designmaster0928/VESC_MotorController/REFER/Basic/bldc-hardware-master/README.md

VESC – Open Source ESC
=============

This the Hardware for my open source custom ESC.

## Schematic top level
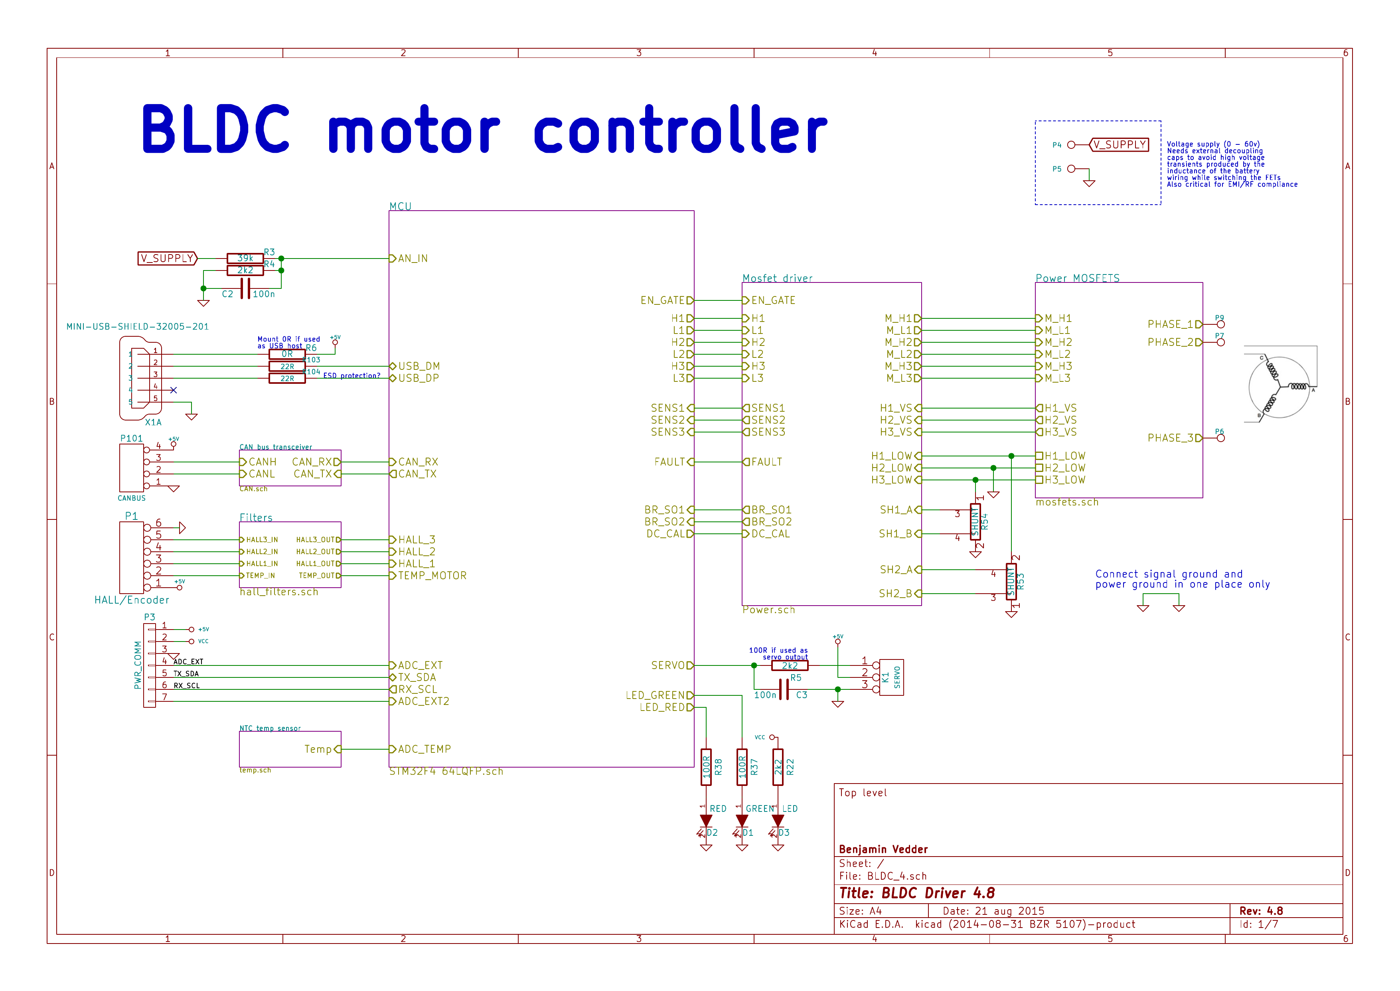
[picture p1: REFER/Basic/bldc-hardware-master/design/PNGs/Schematic-1.png]


## Layout -made with KiCad!-


## 3D views
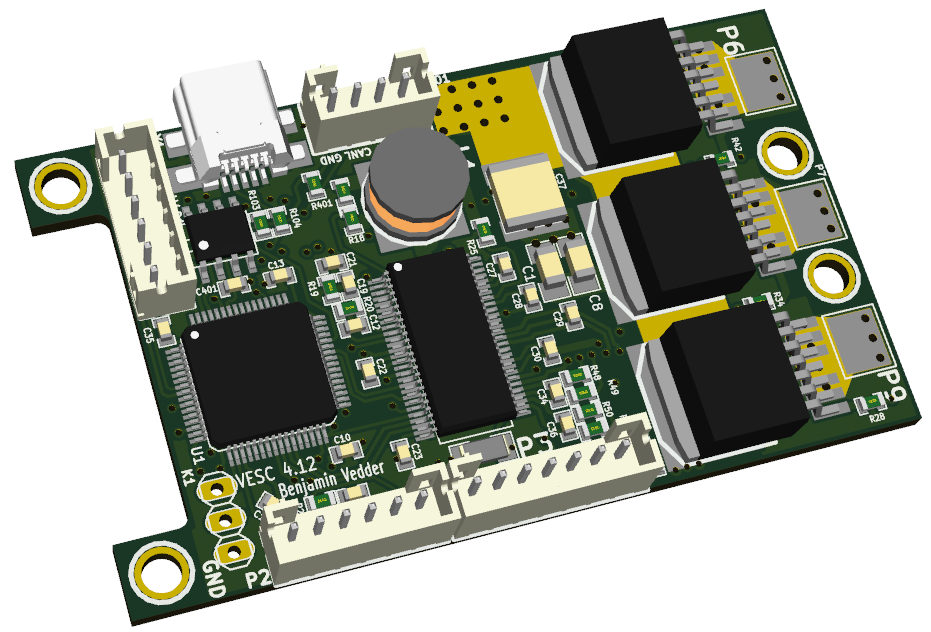
[picture p3: REFER/Basic/bldc-hardware-master/design/PNGs/3D_front.png]

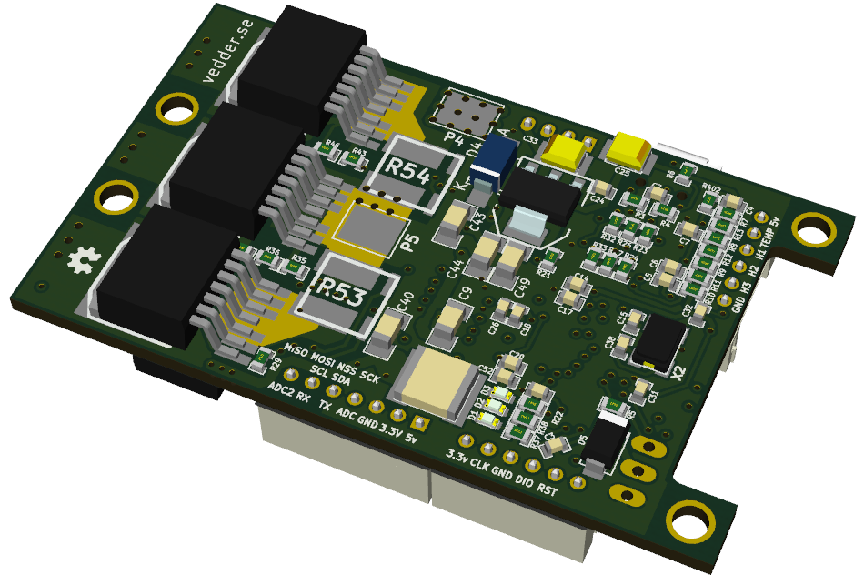
[picture p4: REFER/Basic/bldc-hardware-master/design/PNGs/3D_back.png]


Update: The BOM is no longer available on google docs, it is included in the design folder as an .ods file.

Have a look at this post for a tutorial on how to get started:
http://vedder.se/2015/01/vesc-open-source-esc/

VESC Hardware is licensed under the Creative Commons Attribution-ShareAlike 4.0 International License. To view a copy of this license, visit http://creativecommons.org/licenses/by-sa/4.0/.
