designmaster0928/VESC_MotorController/VESC_MotorController/Project Outputs for VESC_MotorController/VariantReport.html

Altium customize

# Variant Report

Date: | | 8/11/2023
Time: | | 6:37:25 AM
Elapsed Time: | | 00:00:01

## Variations

Physical | Document | Parameter Name | Original Value | External Regulator Board | Onboard Regulators
B1 | PowerBoard.SchDoc | | Fitted | Fitted | Fitted
| | Comment | NTCS0402E3103GL1T | NTCS0402E3103GL1T | NTCS0402E3103GL1T
| | Component Kind | Standard | Standard | Standard
| | Description | NTC Thermistors 10Kohms 2% AEC-Q200 | NTC Thermistors 10Kohms 2% AEC-Q200 | NTC Thermistors 10Kohms 2% AEC-Q200
| | Footprint | THRMC1005X65N | THRMC1005X65N | THRMC1005X65N
| | Ibis Model
| | Library Name | VESC_MotorController.SCHLIB | VESC_MotorController.SCHLIB | VESC_MotorController.SCHLIB
| | Library Reference | NTCS0402E3103GL1T | NTCS0402E3103GL1T | NTCS0402E3103GL1T
| | Manufacturer | Vishay | Vishay | Vishay
| | Manufacturer Part Number | NTCS0402E3103GL1T | NTCS0402E3103GL1T | NTCS0402E3103GL1T
| | PCB3D
| | Pin Info
| | Price | 0.47 | 0.47 | 0.47
| | Signal Integrity
| | Simulation
| | Supplier | Mouser | Mouser | Mouser
| | Supplier Part Number | 594-NTCS402E3103GL1T | 594-NTCS402E3103GL1T | 594-NTCS402E3103GL1T
| | Value | NTCS0402E3103GL1T | NTCS0402E3103GL1T | NTCS0402E3103GL1T
B2 | PowerBoard.SchDoc | | Fitted | Fitted | Fitted
| | Comment | NTCS0402E3103GL1T | NTCS0402E3103GL1T | NTCS0402E3103GL1T
| | Component Kind | Standard | Standard | Standard
| | Description | NTC Thermistors 10Kohms 2% AEC-Q200 | NTC Thermistors 10Kohms 2% AEC-Q200 | NTC Thermistors 10Kohms 2% AEC-Q200
| | Footprint | THRMC1005X65N | THRMC1005X65N | THRMC1005X65N
| | Ibis Model
| | Library Name | VESC_MotorController.SCHLIB | VESC_MotorController.SCHLIB | VESC_MotorController.SCHLIB
| | Library Reference | NTCS0402E3103GL1T | NTCS0402E3103GL1T | NTCS0402E3103GL1T
| | Manufacturer | Vishay | Vishay | Vishay
| | Manufacturer Part Number | NTCS0402E3103GL1T | NTCS0402E3103GL1T | NTCS0402E3103GL1T
| | PCB3D
| | Pin Info
| | Price | 0.47 | 0.47 | 0.47
| | Signal Integrity
| | Simulation
| | Supplier | Mouser | Mouser | Mouser
| | Supplier Part Number | 594-NTCS402E3103GL1T | 594-NTCS402E3103GL1T | 594-NTCS402E3103GL1T
| | Value | NTCS0402E3103GL1T | NTCS0402E3103GL1T | NTCS0402E3103GL1T
B3 | PowerBoard.SchDoc | | Fitted | Fitted | Fitted
| | Comment | NTCS0402E3103GL1T | NTCS0402E3103GL1T | NTCS0402E3103GL1T
| | Component Kind | Standard | Standard | Standard
| | Description | NTC Thermistors 10Kohms 2% AEC-Q200 | NTC Thermistors 10Kohms 2% AEC-Q200 | NTC Thermistors 10Kohms 2% AEC-Q200
| | Footprint | THRMC1005X65N | THRMC1005X65N | THRMC1005X65N
| | Ibis Model
| | Library Name | VESC_MotorController.SCHLIB | VESC_MotorController.SCHLIB | VESC_MotorController.SCHLIB
| | Library Reference | NTCS0402E3103GL1T | NTCS0402E3103GL1T | NTCS0402E3103GL1T
| | Manufacturer | Vishay | Vishay | Vishay
| | Manufacturer Part Number | NTCS0402E3103GL1T | NTCS0402E3103GL1T | NTCS0402E3103GL1T
| | PCB3D
| | Pin Info
| | Price | 0.47 | 0.47 | 0.47
| | Signal Integrity
| | Simulation
| | Supplier | Mouser | Mouser | Mouser
| | Supplier Part Number | 594-NTCS402E3103GL1T | 594-NTCS402E3103GL1T | 594-NTCS402E3103GL1T
| | Value | NTCS0402E3103GL1T | NTCS0402E3103GL1T | NTCS0402E3103GL1T
C1 | PowerBoard.SchDoc | | Fitted | Fitted | Fitted
| | Comment | 100nF | 100nF | 100nF
| | Component Kind | Standard | Standard | Standard
| | Description | 100nF ± 10% 50V | 100nF ± 10% 50V | 100nF ± 10% 50V
| | Footprint | C0402 | C0402 | C0402
| | Ibis Model
| | Library Name | VESC_MotorController.SCHLIB | VESC_MotorController.SCHLIB | VESC_MotorController.SCHLIB
| | Library Reference | 100nF ± 10% 50V | 100nF ± 10% 50V | 100nF ± 10% 50V
| | Manufacturer | Yageo | Yageo | Yageo
| | Manufacturer Part Number | CS0603KRX7R9BB104 | CS0603KRX7R9BB104 | CS0603KRX7R9BB104
| | PCB3D
| | Pin Info
| | Price | 0.1 | 0.1 | 0.1
| | Signal Integrity
| | Simulation
| | Supplier | mouser | mouser | mouser
| | Supplier Part Number | 603-CS0603KRX79BB104 | 603-CS0603KRX79BB104 | 603-CS0603KRX79BB104
| | Value | 100nF | 100nF | 100nF
C2 | PowerBoard.SchDoc | | Fitted | Fitted | Fitted
| | Comment | 4.7uF | 4.7uF | 4.7uF
| | Component Kind | Standard | Standard | Standard
| | Description | 4.7uF ± 10% 50V | 4.7uF ± 10% 50V | 4.7uF ± 10% 50V
| | Footprint | C0603 | C0603 | C0603
| | Ibis Model
| | Library Name | VESC_MotorController.SCHLIB | VESC_MotorController.SCHLIB | VESC_MotorController.SCHLIB
| | Library Reference | 4.7uF ± 10% 50V | 4.7uF ± 10% 50V | 4.7uF ± 10% 50V
| | Manufacturer | Yageo | Yageo | Yageo
| | Manufacturer Part Number | GRM188R61H225ME11J | GRM188R61H225ME11J | GRM188R61H225ME11J
| | PCB3D
| | Pin Info
| | Price | 0.3 | 0.3 | 0.3
| | Signal Integrity
| | Simulation
| | Supplier | mouser | mouser | mouser
| | Supplier Part Number | 81-GRM188R61H225ME1J | 81-GRM188R61H225ME1J | 81-GRM188R61H225ME1J
| | Value | 4.7uF | 4.7uF | 4.7uF
C3 | PowerBoard.SchDoc | | Fitted | Fitted | Fitted
| | Comment | 2.2uF 200V | 2.2uF 200V | 2.2uF 200V
| | Component Kind | Standard | Standard | Standard
| | Description | Multilayer Ceramic Capacitors MLCC - SMD/SMT 200V 2.2uF X7R 2225 10% | Multilayer Ceramic Capacitors MLCC - SMD/SMT 200V 2.2uF X7R 2225 10% | Multilayer Ceramic Capacitors MLCC - SMD/SMT 200V 2.2uF X7R 2225 10%
| | Footprint | CAPC5764X279N | CAPC5764X279N | CAPC5764X279N
| | Ibis Model
| | Library Name | VESC_MotorController.SCHLIB | VESC_MotorController.SCHLIB | VESC_MotorController.SCHLIB
| | Library Reference | 2.2uF ± 10% 200V | 2.2uF ± 10% 200V | 2.2uF ± 10% 200V
| | Manufacturer | Kyocera avx | Kyocera avx | Kyocera avx
| | Manufacturer Part Number | 22252C225KAT2A | 22252C225KAT2A | 22252C225KAT2A
| | PCB3D
| | Pin Info
| | Price | 2.4 | 2.4 | 2.4
| | Signal Integrity
| | Simulation
| | Supplier | mouser | mouser | mouser
| | Supplier Part Number | 581-22252C225KAT2A | 581-22252C225KAT2A | 581-22252C225KAT2A
| | Value | 2.2uF 200V | 2.2uF 200V | 2.2uF 200V
C4 | PowerBoard.SchDoc | | Fitted | Fitted | Fitted
| | Comment | 2.2uF 200V | 2.2uF 200V | 2.2uF 200V
| | Component Kind | Standard | Standard | Standard
| | Description | Multilayer Ceramic Capacitors MLCC - SMD/SMT 200V 2.2uF X7R 2225 10% | Multilayer Ceramic Capacitors MLCC - SMD/SMT 200V 2.2uF X7R 2225 10% | Multilayer Ceramic Capacitors MLCC - SMD/SMT 200V 2.2uF X7R 2225 10%
| | Footprint | CAPC5764X279N | CAPC5764X279N | CAPC5764X279N
| | Ibis Model
| | Library Name | VESC_MotorController.SCHLIB | VESC_MotorController.SCHLIB | VESC_MotorController.SCHLIB
| | Library Reference | 2.2uF ± 10% 200V | 2.2uF ± 10% 200V | 2.2uF ± 10% 200V
| | Manufacturer | Kyocera avx | Kyocera avx | Kyocera avx
| | Manufacturer Part Number | 22252C225KAT2A | 22252C225KAT2A | 22252C225KAT2A
| | PCB3D
| | Pin Info
| | Price | 2.4 | 2.4 | 2.4
| | Signal Integrity
| | Simulation
| | Supplier | mouser | mouser | mouser
| | Supplier Part Number | 581-22252C225KAT2A | 581-22252C225KAT2A | 581-22252C225KAT2A
| | Value | 2.2uF 200V | 2.2uF 200V | 2.2uF 200V
C5 | PowerBoard.SchDoc | | Fitted | Fitted | Fitted
| | Comment | 2.2uF 200V | 2.2uF 200V | 2.2uF 200V
| | Component Kind | Standard | Standard | Standard
| | Description | Multilayer Ceramic Capacitors MLCC - SMD/SMT 200V 2.2uF X7R 2225 10% | Multilayer Ceramic Capacitors MLCC - SMD/SMT 200V 2.2uF X7R 2225 10% | Multilayer Ceramic Capacitors MLCC - SMD/SMT 200V 2.2uF X7R 2225 10%
| | Footprint | CAPC5764X279N | CAPC5764X279N | CAPC5764X279N
| | Ibis Model
| | Library Name | VESC_MotorController.SCHLIB | VESC_MotorController.SCHLIB | VESC_MotorController.SCHLIB
| | Library Reference | 2.2uF ± 10% 200V | 2.2uF ± 10% 200V | 2.2uF ± 10% 200V
| | Manufacturer | Kyocera avx | Kyocera avx | Kyocera avx
| | Manufacturer Part Number | 22252C225KAT2A | 22252C225KAT2A | 22252C225KAT2A
| | PCB3D
| | Pin Info
| | Price | 2.4 | 2.4 | 2.4
| | Signal Integrity
| | Simulation
| | Supplier | mouser | mouser | mouser
| | Supplier Part Number | 581-22252C225KAT2A | 581-22252C225KAT2A | 581-22252C225KAT2A
| | Value | 2.2uF 200V | 2.2uF 200V | 2.2uF 200V
C6 | PowerBoard.SchDoc | | Fitted | Fitted | Fitted
| | Comment | 100nF | 100nF | 100nF
| | Component Kind | Standard | Standard | Standard
| | Description | 100nF ± 10% 50V | 100nF ± 10% 50V | 100nF ± 10% 50V
| | Footprint | C0402 | C0402 | C0402
| | Ibis Model
| | Library Name | VESC_MotorController.SCHLIB | VESC_MotorController.SCHLIB | VESC_MotorController.SCHLIB
| | Library Reference | 100nF ± 10% 50V | 100nF ± 10% 50V | 100nF ± 10% 50V
| | Manufacturer | Yageo | Yageo | Yageo
| | Manufacturer Part Number | CS0603KRX7R9BB104 | CS0603KRX7R9BB104 | CS0603KRX7R9BB104
| | PCB3D
| | Pin Info
| | Price | 0.1 | 0.1 | 0.1
| | Signal Integrity
| | Simulation
| | Supplier | mouser | mouser | mouser
| | Supplier Part Number | 603-CS0603KRX79BB104 | 603-CS0603KRX79BB104 | 603-CS0603KRX79BB104
| | Value | 100nF | 100nF | 100nF
C7 | PowerBoard.SchDoc | | Fitted | Fitted | Fitted
| | Comment | 100nF | 100nF | 100nF
| | Component Kind | Standard | Standard | Standard
| | Description | 100nF ± 10% 50V | 100nF ± 10% 50V | 100nF ± 10% 50V
| | Footprint | C0402 | C0402 | C0402
| | Ibis Model
| | Library Name | VESC_MotorController.SCHLIB | VESC_MotorController.SCHLIB | VESC_MotorController.SCHLIB
| | Library Reference | 100nF ± 10% 50V | 100nF ± 10% 50V | 100nF ± 10% 50V
| | Manufacturer | Yageo | Yageo | Yageo
| | Manufacturer Part Number | CS0603KRX7R9BB104 | CS0603KRX7R9BB104 | CS0603KRX7R9BB104
| | PCB3D
| | Pin Info
| | Price | 0.1 | 0.1 | 0.1
| | Signal Integrity
| | Simulation
| | Supplier | mouser | mouser | mouser
| | Supplier Part Number | 603-CS0603KRX79BB104 | 603-CS0603KRX79BB104 | 603-CS0603KRX79BB104
| | Value | 100nF | 100nF | 100nF
C8 | PowerBoard.SchDoc | | Fitted | Fitted | Fitted
| | Comment | 100nF | 100nF | 100nF
| | Component Kind | Standard | Standard | Standard
| | Description | 100nF ± 10% 50V | 100nF ± 10% 50V | 100nF ± 10% 50V
| | Footprint | C0402 | C0402 | C0402
| | Ibis Model
| | Library Name | VESC_MotorController.SCHLIB | VESC_MotorController.SCHLIB | VESC_MotorController.SCHLIB
| | Library Reference | 100nF ± 10% 50V | 100nF ± 10% 50V | 100nF ± 10% 50V
| | Manufacturer | Yageo | Yageo | Yageo
| | Manufacturer Part Number | CS0603KRX7R9BB104 | CS0603KRX7R9BB104 | CS0603KRX7R9BB104
| | PCB3D
| | Pin Info
| | Price | 0.1 | 0.1 | 0.1
| | Signal Integrity
| | Simulation
| | Supplier | mouser | mouser | mouser
| | Supplier Part Number | 603-CS0603KRX79BB104 | 603-CS0603KRX79BB104 | 603-CS0603KRX79BB104
| | Value | 100nF | 100nF | 100nF
C9 | PowerBoard.SchDoc | | Fitted | Fitted | Fitted
| | Comment | 2.2uF 200V | 2.2uF 200V | 2.2uF 200V
| | Component Kind | Standard | Standard | Standard
| | Description | Multilayer Ceramic Capacitors MLCC - SMD/SMT 200V 2.2uF X7R 2225 10% | Multilayer Ceramic Capacitors MLCC - SMD/SMT 200V 2.2uF X7R 2225 10% | Multilayer Ceramic Capacitors MLCC - SMD/SMT 200V 2.2uF X7R 2225 10%
| | Footprint | CAPC5764X279N | CAPC5764X279N | CAPC5764X279N
| | Ibis Model
| | Library Name | VESC_MotorController.SCHLIB | VESC_MotorController.SCHLIB | VESC_MotorController.SCHLIB
| | Library Reference | 2.2uF ± 10% 200V | 2.2uF ± 10% 200V | 2.2uF ± 10% 200V
| | Manufacturer | Kyocera avx | Kyocera avx | Kyocera avx
| | Manufacturer Part Number | 22252C225KAT2A | 22252C225KAT2A | 22252C225KAT2A
| | PCB3D
| | Pin Info
| | Price | 2.4 | 2.4 | 2.4
| | Signal Integrity
| | Simulation
| | Supplier | mouser | mouser | mouser
| | Supplier Part Number | 581-22252C225KAT2A | 581-22252C225KAT2A | 581-22252C225KAT2A
| | Value | 2.2uF 200V | 2.2uF 200V | 2.2uF 200V
C10 | PowerBoard.SchDoc | | Fitted | Fitted | Fitted
| | Comment | 2.2uF 200V | 2.2uF 200V | 2.2uF 200V
| | Component Kind | Standard | Standard | Standard
| | Description | Multilayer Ceramic Capacitors MLCC - SMD/SMT 200V 2.2uF X7R 2225 10% | Multilayer Ceramic Capacitors MLCC - SMD/SMT 200V 2.2uF X7R 2225 10% | Multilayer Ceramic Capacitors MLCC - SMD/SMT 200V 2.2uF X7R 2225 10%
| | Footprint | CAPC5764X279N | CAPC5764X279N | CAPC5764X279N
| | Ibis Model
| | Library Name | VESC_MotorController.SCHLIB | VESC_MotorController.SCHLIB | VESC_MotorController.SCHLIB
| | Library Reference | 2.2uF ± 10% 200V | 2.2uF ± 10% 200V | 2.2uF ± 10% 200V
| | Manufacturer | Kyocera avx | Kyocera avx | Kyocera avx
| | Manufacturer Part Number | 22252C225KAT2A | 22252C225KAT2A | 22252C225KAT2A
| | PCB3D
| | Pin Info
| | Price | 2.4 | 2.4 | 2.4
| | Signal Integrity
| | Simulation
| | Supplier | mouser | mouser | mouser
| | Supplier Part Number | 581-22252C225KAT2A | 581-22252C225KAT2A | 581-22252C225KAT2A
| | Value | 2.2uF 200V | 2.2uF 200V | 2.2uF 200V
C11 | PowerBoard.SchDoc | | Fitted | Fitted | Fitted
| | Comment | 2.2uF 200V | 2.2uF 200V | 2.2uF 200V
| | Component Kind | Standard | Standard | Standard
| | Description | Multilayer Ceramic Capacitors MLCC - SMD/SMT 200V 2.2uF X7R 2225 10% | Multilayer Ceramic Capacitors MLCC - SMD/SMT 200V 2.2uF X7R 2225 10% | Multilayer Ceramic Capacitors MLCC - SMD/SMT 200V 2.2uF X7R 2225 10%
| | Footprint | CAPC5764X279N | CAPC5764X279N | CAPC5764X279N
| | Ibis Model
| | Library Name | VESC_MotorController.SCHLIB | VESC_MotorController.SCHLIB | VESC_MotorController.SCHLIB
| | Library Reference | 2.2uF ± 10% 200V | 2.2uF ± 10% 200V | 2.2uF ± 10% 200V
| | Manufacturer | Kyocera avx | Kyocera avx | Kyocera avx
| | Manufacturer Part Number | 22252C225KAT2A | 22252C225KAT2A | 22252C225KAT2A
| | PCB3D
| | Pin Info
| | Price | 2.4 | 2.4 | 2.4
| | Signal Integrity
| | Simulation
| | Supplier | mouser | mouser | mouser
| | Supplier Part Number | 581-22252C225KAT2A | 581-22252C225KAT2A | 581-22252C225KAT2A
| | Value | 2.2uF 200V | 2.2uF 200V | 2.2uF 200V
C12 | PowerBoard.SchDoc | | Fitted | Fitted | Fitted
| | Comment | 100nF | 100nF | 100nF
| | Component Kind | Standard | Standard | Standard
| | Description | 100nF ± 10% 50V | 100nF ± 10% 50V | 100nF ± 10% 50V
| | Footprint | C0402 | C0402 | C0402
| | Ibis Model
| | Library Name | VESC_MotorController.SCHLIB | VESC_MotorController.SCHLIB | VESC_MotorController.SCHLIB
| | Library Reference | 100nF ± 10% 50V | 100nF ± 10% 50V | 100nF ± 10% 50V
| | Manufacturer | Yageo | Yageo | Yageo
| | Manufacturer Part Number | CS0603KRX7R9BB104 | CS0603KRX7R9BB104 | CS0603KRX7R9BB104
| | PCB3D
| | Pin Info
| | Price | 0.1 | 0.1 | 0.1
| | Signal Integrity
| | Simulation
| | Supplier | mouser | mouser | mouser
| | Supplier Part Number | 603-CS0603KRX79BB104 | 603-CS0603KRX79BB104 | 603-CS0603KRX79BB104
| | Value | 100nF | 100nF | 100nF
C13 | PowerBoard.SchDoc | | Fitted | Fitted | Fitted
| | Comment | 100nF | 100nF | 100nF
| | Component Kind | Standard | Standard | Standard
| | Description | 100nF ± 10% 50V | 100nF ± 10% 50V | 100nF ± 10% 50V
| | Footprint | C0402 | C0402 | C0402
| | Ibis Model
| | Library Name | VESC_MotorController.SCHLIB | VESC_MotorController.SCHLIB | VESC_MotorController.SCHLIB
| | Library Reference | 100nF ± 10% 50V | 100nF ± 10% 50V | 100nF ± 10% 50V
| | Manufacturer | Yageo | Yageo | Yageo
| | Manufacturer Part Number | CS0603KRX7R9BB104 | CS0603KRX7R9BB104 | CS0603KRX7R9BB104
| | PCB3D
| | Pin Info
| | Price | 0.1 | 0.1 | 0.1
| | Signal Integrity
| | Simulation
| | Supplier | mouser | mouser | mouser
| | Supplier Part Number | 603-CS0603KRX79BB104 | 603-CS0603KRX79BB104 | 603-CS0603KRX79BB104
| | Value | 100nF | 100nF | 100nF
C14 | PowerBoard.SchDoc | | Fitted | Fitted | Fitted
| | Comment | 2.2uF | 2.2uF | 2.2uF
| | Component Kind | Standard | Standard | Standard
| | Description | 2.2uF ± 10% 50V | 2.2uF ± 10% 50V | 2.2uF ± 10% 50V
| | Footprint | C0603 | C0603 | C0603
| | Ibis Model
| | Library Name | VESC_MotorController.SCHLIB | VESC_MotorController.SCHLIB | VESC_MotorController.SCHLIB
| | Library Reference | 2.2uF ± 10% 50V | 2.2uF ± 10% 50V | 2.2uF ± 10% 50V
| | Manufacturer | Yageo | Yageo | Yageo
| | Manufacturer Part Number | GRM188R61H225ME11J | GRM188R61H225ME11J | GRM188R61H225ME11J
| | PCB3D
| | Pin Info
| | Price | 0.3 | 0.3 | 0.3
| | Signal Integrity
| | Simulation
| | Supplier | mouser | mouser | mouser
| | Supplier Part Number | 81-GRM188R61H225ME1J | 81-GRM188R61H225ME1J | 81-GRM188R61H225ME1J
| | Value | 2.2uF | 2.2uF | 2.2uF
C15 | PowerBoard.SchDoc | | Fitted | Fitted | Fitted
| | Comment | 4.7uF | 4.7uF | 4.7uF
| | Component Kind | Standard | Standard | Standard
| | Description | 4.7uF ± 10% 50V | 4.7uF ± 10% 50V | 4.7uF ± 10% 50V
| | Footprint | C0603 | C0603 | C0603
| | Ibis Model
| | Library Name | VESC_MotorController.SCHLIB | VESC_MotorController.SCHLIB | VESC_MotorController.SCHLIB
| | Library Reference | 4.7uF ± 10% 50V | 4.7uF ± 10% 50V | 4.7uF ± 10% 50V
| | Manufacturer | Yageo | Yageo | Yageo
| | Manufacturer Part Number | GRM188R61H225ME11J | GRM188R61H225ME11J | GRM188R61H225ME11J
| | PCB3D
| | Pin Info
| | Price | 0.3 | 0.3 | 0.3
| | Signal Integrity
| | Simulation
| | Supplier | mouser | mouser | mouser
| | Supplier Part Number | 81-GRM188R61H225ME1J | 81-GRM188R61H225ME1J | 81-GRM188R61H225ME1J
| | Value | 4.7uF | 4.7uF | 4.7uF
C16 | PowerBoard.SchDoc | | Fitted | Fitted | Fitted
| | Comment | 100nF | 100nF | 100nF
| | Component Kind | Standard | Standard | Standard
| | Description | 100nF ± 10% 50V | 100nF ± 10% 50V | 100nF ± 10% 50V
| | Footprint | C0402 | C0402 | C0402
| | Ibis Model
| | Library Name | VESC_MotorController.SCHLIB | VESC_MotorController.SCHLIB | VESC_MotorController.SCHLIB
| | Library Reference | 100nF ± 10% 50V | 100nF ± 10% 50V | 100nF ± 10% 50V
| | Manufacturer | Yageo | Yageo | Yageo
| | Manufacturer Part Number | CS0603KRX7R9BB104 | CS0603KRX7R9BB104 | CS0603KRX7R9BB104
| | PCB3D
| | Pin Info
| | Price | 0.1 | 0.1 | 0.1
| | Signal Integrity
| | Simulation
| | Supplier | mouser | mouser | mouser
| | Supplier Part Number | 603-CS0603KRX79BB104 | 603-CS0603KRX79BB104 | 603-CS0603KRX79BB104
| | Value | 100nF | 100nF | 100nF
C17 | PowerBoard.SchDoc | | Fitted | Fitted | Fitted
| | Comment | 2.2uF | 2.2uF | 2.2uF
| | Component Kind | Standard | Standard | Standard
| | Description | 2.2uF ± 10% 50V | 2.2uF ± 10% 50V | 2.2uF ± 10% 50V
| | Footprint | C0603 | C0603 | C0603
| | Ibis Model
| | Library Name | VESC_MotorController.SCHLIB | VESC_MotorController.SCHLIB | VESC_MotorController.SCHLIB
| | Library Reference | 2.2uF ± 10% 50V | 2.2uF ± 10% 50V | 2.2uF ± 10% 50V
| | Manufacturer | Yageo | Yageo | Yageo
| | Manufacturer Part Number | GRM188R61H225ME11J | GRM188R61H225ME11J | GRM188R61H225ME11J
| | PCB3D
| | Pin Info
| | Price | 0.3 | 0.3 | 0.3
| | Signal Integrity
| | Simulation
| | Supplier | mouser | mouser | mouser
| | Supplier Part Number | 81-GRM188R61H225ME1J | 81-GRM188R61H225ME1J | 81-GRM188R61H225ME1J
| | Value | 2.2uF | 2.2uF | 2.2uF
C18 | PowerBoard.SchDoc | | Fitted | Fitted | Fitted
| | Comment | 2.2uF | 2.2uF | 2.2uF
| | Component Kind | Standard | Standard | Standard
| | Description | 2.2uF ± 10% 50V | 2.2uF ± 10% 50V | 2.2uF ± 10% 50V
| | Footprint | C0603 | C0603 | C0603
| | Ibis Model
| | Library Name | VESC_MotorController.SCHLIB | VESC_MotorController.SCHLIB | VESC_MotorController.SCHLIB
| | Library Reference | 2.2uF ± 10% 50V | 2.2uF ± 10% 50V | 2.2uF ± 10% 50V
| | Manufacturer | Yageo | Yageo | Yageo
| | Manufacturer Part Number | GRM188R61H225ME11J | GRM188R61H225ME11J | GRM188R61H225ME11J
| | PCB3D
| | Pin Info
| | Price | 0.3 | 0.3 | 0.3
| | Signal Integrity
| | Simulation
| | Supplier | mouser | mouser | mouser
| | Supplier Part Number | 81-GRM188R61H225ME1J | 81-GRM188R61H225ME1J | 81-GRM188R61H225ME1J
| | Value | 2.2uF | 2.2uF | 2.2uF
C19 | PowerBoard.SchDoc | | Fitted | Fitted | Fitted
| | Comment | 100nF | 100nF | 100nF
| | Component Kind | Standard | Standard | Standard
| | Description | 100nF ± 10% 50V | 100nF ± 10% 50V | 100nF ± 10% 50V
| | Footprint | C0402 | C0402 | C0402
| | Ibis Model
| | Library Name | VESC_MotorController.SCHLIB | VESC_MotorController.SCHLIB | VESC_MotorController.SCHLIB
| | Library Reference | 100nF ± 10% 50V | 100nF ± 10% 50V | 100nF ± 10% 50V
| | Manufacturer | Yageo | Yageo | Yageo
| | Manufacturer Part Number | CS0603KRX7R9BB104 | CS0603KRX7R9BB104 | CS0603KRX7R9BB104
| | PCB3D
| | Pin Info
| | Price | 0.1 | 0.1 | 0.1
| | Signal Integrity
| | Simulation
| | Supplier | mouser | mouser | mouser
| | Supplier Part Number | 603-CS0603KRX79BB104 | 603-CS0603KRX79BB104 | 603-CS0603KRX79BB104
| | Value | 100nF | 100nF | 100nF
C20 | PowerBoard.SchDoc | | Fitted | Fitted | Fitted
| | Comment | 4.7uF | 4.7uF | 4.7uF
| | Component Kind | Standard | Standard | Standard
| | Description | 4.7uF ± 10% 50V | 4.7uF ± 10% 50V | 4.7uF ± 10% 50V
| | Footprint | C0603 | C0603 | C0603
| | Ibis Model
| | Library Name | VESC_MotorController.SCHLIB | VESC_MotorController.SCHLIB | VESC_MotorController.SCHLIB
| | Library Reference | 4.7uF ± 10% 50V | 4.7uF ± 10% 50V | 4.7uF ± 10% 50V
| | Manufacturer | Yageo | Yageo | Yageo
| | Manufacturer Part Number | GRM188R61H225ME11J | GRM188R61H225ME11J | GRM188R61H225ME11J
| | PCB3D
| | Pin Info
| | Price | 0.3 | 0.3 | 0.3
| | Signal Integrity
| | Simulation
| | Supplier | mouser | mouser | mouser
| | Supplier Part Number | 81-GRM188R61H225ME1J | 81-GRM188R61H225ME1J | 81-GRM188R61H225ME1J
| | Value | 4.7uF | 4.7uF | 4.7uF
C21 | PowerBoard.SchDoc | | Fitted | Fitted | Fitted
| | Comment | 2.2uF 200V | 2.2uF 200V | 2.2uF 200V
| | Component Kind | Standard | Standard | Standard
| | Description | Multilayer Ceramic Capacitors MLCC - SMD/SMT 200V 2.2uF X7R 2225 10% | Multilayer Ceramic Capacitors MLCC - SMD/SMT 200V 2.2uF X7R 2225 10% | Multilayer Ceramic Capacitors MLCC - SMD/SMT 200V 2.2uF X7R 2225 10%
| | Footprint | CAPC5764X279N | CAPC5764X279N | CAPC5764X279N
| | Ibis Model
| | Library Name | VESC_MotorController.SCHLIB | VESC_MotorController.SCHLIB | VESC_MotorController.SCHLIB
| | Library Reference | 2.2uF ± 10% 200V | 2.2uF ± 10% 200V | 2.2uF ± 10% 200V
| | Manufacturer | Kyocera avx | Kyocera avx | Kyocera avx
| | Manufacturer Part Number | 22252C225KAT2A | 22252C225KAT2A | 22252C225KAT2A
| | PCB3D
| | Pin Info
| | Price | 2.4 | 2.4 | 2.4
| | Signal Integrity
| | Simulation
| | Supplier | mouser | mouser | mouser
| | Supplier Part Number | 581-22252C225KAT2A | 581-22252C225KAT2A | 581-22252C225KAT2A
| | Value | 2.2uF 200V | 2.2uF 200V | 2.2uF 200V
C22 | PowerBoard.SchDoc | | Fitted | Fitted | Fitted
| | Comment | 2.2uF 200V | 2.2uF 200V | 2.2uF 200V
| | Component Kind | Standard | Standard | Standard
| | Description | Multilayer Ceramic Capacitors MLCC - SMD/SMT 200V 2.2uF X7R 2225 10% | Multilayer Ceramic Capacitors MLCC - SMD/SMT 200V 2.2uF X7R 2225 10% | Multilayer Ceramic Capacitors MLCC - SMD/SMT 200V 2.2uF X7R 2225 10%
| | Footprint | CAPC5764X279N | CAPC5764X279N | CAPC5764X279N
| | Ibis Model
| | Library Name | VESC_MotorController.SCHLIB | VESC_MotorController.SCHLIB | VESC_MotorController.SCHLIB
| | Library Reference | 2.2uF ± 10% 200V | 2.2uF ± 10% 200V | 2.2uF ± 10% 200V
| | Manufacturer | Kyocera avx | Kyocera avx | Kyocera avx
| | Manufacturer Part Number | 22252C225KAT2A | 22252C225KAT2A | 22252C225KAT2A
| | PCB3D
| | Pin Info
| | Price | 2.4 | 2.4 | 2.4
| | Signal Integrity
| | Simulation
| | Supplier | mouser | mouser | mouser
| | Supplier Part Number | 581-22252C225KAT2A | 581-22252C225KAT2A | 581-22252C225KAT2A
| | Value | 2.2uF 200V | 2.2uF 200V | 2.2uF 200V
C23 | PowerBoard.SchDoc | | Fitted | Fitted | Fitted
| | Comment | 2.2uF 200V | 2.2uF 200V | 2.2uF 200V
| | Component Kind | Standard | Standard | Standard
| | Description | Multilayer Ceramic Capacitors MLCC - SMD/SMT 200V 2.2uF X7R 2225 10% | Multilayer Ceramic Capacitors MLCC - SMD/SMT 200V 2.2uF X7R 2225 10% | Multilayer Ceramic Capacitors MLCC - SMD/SMT 200V 2.2uF X7R 2225 10%
| | Footprint | CAPC5764X279N | CAPC5764X279N | CAPC5764X279N
| | Ibis Model
| | Library Name | VESC_MotorController.SCHLIB | VESC_MotorController.SCHLIB | VESC_MotorController.SCHLIB
| | Library Reference | 2.2uF ± 10% 200V | 2.2uF ± 10% 200V | 2.2uF ± 10% 200V
| | Manufacturer | Kyocera avx | Kyocera avx | Kyocera avx
| | Manufacturer Part Number | 22252C225KAT2A | 22252C225KAT2A | 22252C225KAT2A
| | PCB3D
| | Pin Info
| | Price | 2.4 | 2.4 | 2.4
| | Signal Integrity
| | Simulation
| | Supplier | mouser | mouser | mouser
| | Supplier Part Number | 581-22252C225KAT2A | 581-22252C225KAT2A | 581-22252C225KAT2A
| | Value | 2.2uF 200V | 2.2uF 200V | 2.2uF 200V
C24 | PowerBoard.SchDoc | | Fitted | Fitted | Fitted
| | Comment | 100nF | 100nF | 100nF
| | Component Kind | Standard | Standard | Standard
| | Description | 100nF ± 10% 50V | 100nF ± 10% 50V | 100nF ± 10% 50V
| | Footprint | C0402 | C0402 | C0402
| | Ibis Model
| | Library Name | VESC_MotorController.SCHLIB | VESC_MotorController.SCHLIB | VESC_MotorController.SCHLIB
| | Library Reference | 100nF ± 10% 50V | 100nF ± 10% 50V | 100nF ± 10% 50V
| | Manufacturer | Yageo | Yageo | Yageo
| | Manufacturer Part Number | CS0603KRX7R9BB104 | CS0603KRX7R9BB104 | CS0603KRX7R9BB104
| | PCB3D
| | Pin Info
| | Price | 0.1 | 0.1 | 0.1
| | Signal Integrity
| | Simulation
| | Supplier | mouser | mouser | mouser
| | Supplier Part Number | 603-CS0603KRX79BB104 | 603-CS0603KRX79BB104 | 603-CS0603KRX79BB104
| | Value | 100nF | 100nF | 100nF
C25 | PowerBoard.SchDoc | | Fitted | Fitted | Fitted
| | Comment | 100nF | 100nF | 100nF
| | Component Kind | Standard | Standard | Standard
| | Description | 100nF ± 10% 50V | 100nF ± 10% 50V | 100nF ± 10% 50V
| | Footprint | C0402 | C0402 | C0402
| | Ibis Model
| | Library Name | VESC_MotorController.SCHLIB | VESC_MotorController.SCHLIB | VESC_MotorController.SCHLIB
| | Library Reference | 100nF ± 10% 50V | 100nF ± 10% 50V | 100nF ± 10% 50V
| | Manufacturer | Yageo | Yageo | Yageo
| | Manufacturer Part Number | CS0603KRX7R9BB104 | CS0603KRX7R9BB104 | CS0603KRX7R9BB104
| | PCB3D
| | Pin Info
| | Price | 0.1 | 0.1 | 0.1
| | Signal Integrity
| | Simulation
| | Supplier | mouser | mouser | mouser
| | Supplier Part Number | 603-CS0603KRX79BB104 | 603-CS0603KRX79BB104 | 603-CS0603KRX79BB104
| | Value | 100nF | 100nF | 100nF
C26 | PowerBoard.SchDoc | | Fitted | Fitted | Fitted
| | Comment | 100nF | 100nF | 100nF
| | Component Kind | Standard | Standard | Standard
| | Description | 100nF ± 10% 50V | 100nF ± 10% 50V | 100nF ± 10% 50V
| | Footprint | C0402 | C0402 | C0402
| | Ibis Model
| | Library Name | VESC_MotorController.SCHLIB | VESC_MotorController.SCHLIB | VESC_MotorController.SCHLIB
| | Library Reference | 100nF ± 10% 50V | 100nF ± 10% 50V | 100nF ± 10% 50V
| | Manufacturer | Yageo | Yageo | Yageo
| | Manufacturer Part Number | CS0603KRX7R9BB104 | CS0603KRX7R9BB104 | CS0603KRX7R9BB104
| | PCB3D
| | Pin Info
| | Price | 0.1 | 0.1 | 0.1
| | Signal Integrity
| | Simulation
| | Supplier | mouser | mouser | mouser
| | Supplier Part Number | 603-CS0603KRX79BB104 | 603-CS0603KRX79BB104 | 603-CS0603KRX79BB104
| | Value | 100nF | 100nF | 100nF
C27 | PowerBoard.SchDoc | | Fitted | Fitted | Fitted
| | Comment | 2.2uF 200V | 2.2uF 200V | 2.2uF 200V
| | Component Kind | Standard | Standard | Standard
| | Description | Multilayer Ceramic Capacitors MLCC - SMD/SMT 200V 2.2uF X7R 2225 10% | Multilayer Ceramic Capacitors MLCC - SMD/SMT 200V 2.2uF X7R 2225 10% | Multilayer Ceramic Capacitors MLCC - SMD/SMT 200V 2.2uF X7R 2225 10%
| | Footprint | CAPC5764X279N | CAPC5764X279N | CAPC5764X279N
| | Ibis Model
| | Library Name | VESC_MotorController.SCHLIB | VESC_MotorController.SCHLIB | VESC_MotorController.SCHLIB
| | Library Reference | 2.2uF ± 10% 200V | 2.2uF ± 10% 200V | 2.2uF ± 10% 200V
| | Manufacturer | Kyocera avx | Kyocera avx | Kyocera avx
| | Manufacturer Part Number | 22252C225KAT2A | 22252C225KAT2A | 22252C225KAT2A
| | PCB3D
| | Pin Info
| | Price | 2.4 | 2.4 | 2.4
| | Signal Integrity
| | Simulation
| | Supplier | mouser | mouser | mouser
| | Supplier Part Number | 581-22252C225KAT2A | 581-22252C225KAT2A | 581-22252C225KAT2A
| | Value | 2.2uF 200V | 2.2uF 200V | 2.2uF 200V
C28 | PowerBoard.SchDoc | | Fitted | Not Fitted | Fitted
| | Comment | 2.2uF 200V | | 2.2uF 200V
| | Component Kind | Standard | | Standard
| | Description | Multilayer Ceramic Capacitors MLCC - SMD/SMT 200V 2.2uF X7R 2225 10% | | Multilayer Ceramic Capacitors MLCC - SMD/SMT 200V 2.2uF X7R 2225 10%
| | Footprint | CAPC5764X279N | | CAPC5764X279N
| | Ibis Model
| | Library Name | VESC_MotorController.SCHLIB | | VESC_MotorController.SCHLIB
| | Library Reference | 2.2uF ± 10% 200V | | 2.2uF ± 10% 200V
| | Manufacturer | Kyocera avx | | Kyocera avx
| | Manufacturer Part Number | 22252C225KAT2A | | 22252C225KAT2A
| | PCB3D
| | Pin Info
| | Price | 2.4 | | 2.4
| | Signal Integrity
| | Simulation
| | Supplier | mouser | | mouser
| | Supplier Part Number | 581-22252C225KAT2A | | 581-22252C225KAT2A
| | Value | 2.2uF 200V | | 2.2uF 200V
C29 | PowerBoard.SchDoc | | Fitted | Not Fitted | Fitted
| | Comment | 2.2uF 200V | | 2.2uF 200V
| | Component Kind | Standard | | Standard
| | Description | Multilayer Ceramic Capacitors MLCC - SMD/SMT 200V 2.2uF X7R 2225 10% | | Multilayer Ceramic Capacitors MLCC - SMD/SMT 200V 2.2uF X7R 2225 10%
| | Footprint | CAPC5764X279N | | CAPC5764X279N
| | Ibis Model
| | Library Name | VESC_MotorController.SCHLIB | | VESC_MotorController.SCHLIB
| | Library Reference | 2.2uF ± 10% 200V | | 2.2uF ± 10% 200V
| | Manufacturer | Kyocera avx | | Kyocera avx
| | Manufacturer Part Number | 22252C225KAT2A | | 22252C225KAT2A
| | PCB3D
| | Pin Info
| | Price | 2.4 | | 2.4
| | Signal Integrity
| | Simulation
| | Supplier | mouser | | mouser
| | Supplier Part Number | 581-22252C225KAT2A | | 581-22252C225KAT2A
| | Value | 2.2uF 200V | | 2.2uF 200V
C30 | PowerBoard.SchDoc | | Fitted | Not Fitted | Fitted
| | Comment | 100nF | | 100nF
| | Component Kind | Standard | | Standard
| | Description | 100nF ± 10% 50V | | 100nF ± 10% 50V
| | Footprint | C0402 | | C0402
| | Ibis Model
| | Library Name | VESC_MotorController.SCHLIB | | VESC_MotorController.SCHLIB
| | Library Reference | 100nF ± 10% 50V | | 100nF ± 10% 50V
| | Manufacturer | Yageo | | Yageo
| | Manufacturer Part Number | CS0603KRX7R9BB104 | | CS0603KRX7R9BB104
| | PCB3D
| | Pin Info
| | Price | 0.1 | | 0.1
| | Signal Integrity
| | Simulation
| | Supplier | mouser | | mouser
| | Supplier Part Number | 603-CS0603KRX79BB104 | | 603-CS0603KRX79BB104
| | Value | 100nF | | 100nF
C31 | PowerBoard.SchDoc | | Fitted | Not Fitted | Fitted
| | Comment | 2.2uF | | 2.2uF
| | Component Kind | Standard | | Standard
| | Description | 2.2uF ± 10% 50V | | 2.2uF ± 10% 50V
| | Footprint | C0603 | | C0603
| | Ibis Model
| | Library Name | VESC_MotorController.SCHLIB | | VESC_MotorController.SCHLIB
| | Library Reference | 2.2uF ± 10% 50V | | 2.2uF ± 10% 50V
| | Manufacturer | Yageo | | Yageo
| | Manufacturer Part Number | GRM188R61H225ME11J | | GRM188R61H225ME11J
| | PCB3D
| | Pin Info
| | Price | 0.3 | | 0.3
| | Signal Integrity
| | Simulation
| | Supplier | mouser | | mouser
| | Supplier Part Number | 81-GRM188R61H225ME1J | | 81-GRM188R61H225ME1J
| | Value | 2.2uF | | 2.2uF
C32 | PowerBoard.SchDoc | | Fitted | Not Fitted | Fitted
| | Comment | 100nF | | 100nF
| | Component Kind | Standard | | Standard
| | Description | 100nF ± 10% 50V | | 100nF ± 10% 50V
| | Footprint | C0402 | | C0402
| | Ibis Model
| | Library Name | VESC_MotorController.SCHLIB | | VESC_MotorController.SCHLIB
| | Library Reference | 100nF ± 10% 50V | | 100nF ± 10% 50V
| | Manufacturer | Yageo | | Yageo
| | Manufacturer Part Number | CS0603KRX7R9BB104 | | CS0603KRX7R9BB104
| | PCB3D
| | Pin Info
| | Price | 0.1 | | 0.1
| | Signal Integrity
| | Simulation
| | Supplier | mouser | | mouser
| | Supplier Part Number | 603-CS0603KRX79BB104 | | 603-CS0603KRX79BB104
| | Value | 100nF | | 100nF
C33 | PowerBoard.SchDoc | | Fitted | Not Fitted | Fitted
| | Comment | 2.2uF | | 2.2uF
| | Component Kind | Standard | | Standard
| | Description | 2.2uF ± 10% 50V | | 2.2uF ± 10% 50V
| | Footprint | C0603 | | C0603
| | Ibis Model
| | Library Name | VESC_MotorController.SCHLIB | | VESC_MotorController.SCHLIB
| | Library Reference | 2.2uF ± 10% 50V | | 2.2uF ± 10% 50V
| | Manufacturer | Yageo | | Yageo
| | Manufacturer Part Number | GRM188R61H225ME11J | | GRM188R61H225ME11J
| | PCB3D
| | Pin Info
| | Price | 0.3 | | 0.3
| | Signal Integrity
| | Simulation
| | Supplier | mouser | | mouser
| | Supplier Part Number | 81-GRM188R61H225ME1J | | 81-GRM188R61H225ME1J
| | Value | 2.2uF | | 2.2uF
C34 | PowerBoard.SchDoc | | Fitted | Not Fitted | Fitted
| | Comment | 4.7uF | | 4.7uF
| | Component Kind | Standard | | Standard
| | Description | 4.7uF ± 10% 50V | | 4.7uF ± 10% 50V
| | Footprint | C0603 | | C0603
| | Ibis Model
| | Library Name | VESC_MotorController.SCHLIB | | VESC_MotorController.SCHLIB
| | Library Reference | 4.7uF ± 10% 50V | | 4.7uF ± 10% 50V
| | Manufacturer | Yageo | | Yageo
| | Manufacturer Part Number | GRM188R61H225ME11J | | GRM188R61H225ME11J
| | PCB3D
| | Pin Info
| | Price | 0.3 | | 0.3
| | Signal Integrity
| | Simulation
| | Supplier | mouser | | mouser
| | Supplier Part Number | 81-GRM188R61H225ME1J | | 81-GRM188R61H225ME1J
| | Value | 4.7uF | | 4.7uF
C35 | PowerBoard.SchDoc | | Fitted | Not Fitted | Fitted
| | Comment | 100nF | | 100nF
| | Component Kind | Standard | | Standard
| | Description | 100nF ± 10% 50V | | 100nF ± 10% 50V
| | Footprint | C0402 | | C0402
| | Ibis Model
| | Library Name | VESC_MotorController.SCHLIB | | VESC_MotorController.SCHLIB
| | Library Reference | 100nF ± 10% 50V | | 100nF ± 10% 50V
| | Manufacturer | Yageo | | Yageo
| | Manufacturer Part Number | CS0603KRX7R9BB104 | | CS0603KRX7R9BB104
| | PCB3D
| | Pin Info
| | Price | 0.1 | | 0.1
| | Signal Integrity
| | Simulation
| | Supplier | mouser | | mouser
| | Supplier Part Number | 603-CS0603KRX79BB104 | | 603-CS0603KRX79BB104
| | Value | 100nF | | 100nF
C36 | PowerBoard.SchDoc | | Fitted | Not Fitted | Fitted
| | Comment | 2.2uF | | 2.2uF
| | Component Kind | Standard | | Standard
| | Description | 2.2uF ± 10% 50V | | 2.2uF ± 10% 50V
| | Footprint | C0603 | | C0603
| | Ibis Model
| | Library Name | VESC_MotorController.SCHLIB | | VESC_MotorController.SCHLIB
| | Library Reference | 2.2uF ± 10% 50V | | 2.2uF ± 10% 50V
| | Manufacturer | Yageo | | Yageo
| | Manufacturer Part Number | GRM188R61H225ME11J | | GRM188R61H225ME11J
| | PCB3D
| | Pin Info
| | Price | 0.3 | | 0.3
| | Signal Integrity
| | Simulation
| | Supplier | mouser | | mouser
| | Supplier Part Number | 81-GRM188R61H225ME1J | | 81-GRM188R61H225ME1J
| | Value | 2.2uF | | 2.2uF
C37 | PowerBoard.SchDoc | | Fitted | Not Fitted | Fitted
| | Comment | 470uF 160V | | 470uF 160V
| | Component Kind | Standard | | Standard
| | Description | Cornell-Dubilier 470uF 160 V dc Aluminium Electrolytic Capacitor A3, SLP Series 3000h 22 Dia. x 30mm | | Cornell-Dubilier 470uF 160 V dc Aluminium Electrolytic Capacitor A3, SLP Series 3000h 22 Dia. x 30mm
| | Footprint | CAPPRD1000W190D2250H3200 | | CAPPRD1000W190D2250H3200
| | Ibis Model
| | Library Name | VESC_MotorController.SCHLIB | | VESC_MotorController.SCHLIB
| | Library Reference | 470uF 160V | | 470uF 160V
| | Manufacturer | Cornell Dubilier | | Cornell Dubilier
| | Manufacturer Part Number | SLP471M160A3P3 | | SLP471M160A3P3
| | PCB3D
| | Pin Info
| | Price | 3.3 | | 3.3
| | Signal Integrity
| | Simulation
| | Suplier | Mouser | | Mouser
| | Supplier Part Number | 598-SLP471M160A3P3 | | 598-SLP471M160A3P3
| | Value | 470uF 160V | | 470uF 160V
C38 | PowerBoard.SchDoc | | Fitted | Not Fitted | Fitted
| | Comment | 470uF 160V | | 470uF 160V
| | Component Kind | Standard | | Standard
| | Description | Cornell-Dubilier 470uF 160 V dc Aluminium Electrolytic Capacitor A3, SLP Series 3000h 22 Dia. x 30mm | | Cornell-Dubilier 470uF 160 V dc Aluminium Electrolytic Capacitor A3, SLP Series 3000h 22 Dia. x 30mm
| | Footprint | CAPPRD1000W190D2250H3200 | | CAPPRD1000W190D2250H3200
| | Ibis Model
| | Library Name | VESC_MotorController.SCHLIB | | VESC_MotorController.SCHLIB
| | Library Reference | 470uF 160V | | 470uF 160V
| | Manufacturer | Cornell Dubilier | | Cornell Dubilier
| | Manufacturer Part Number | SLP471M160A3P3 | | SLP471M160A3P3
| | PCB3D
| | Pin Info
| | Price | 3.3 | | 3.3
| | Signal Integrity
| | Simulation
| | Suplier | Mouser | | Mouser
| | Supplier Part Number | 598-SLP471M160A3P3 | | 598-SLP471M160A3P3
| | Value | 470uF 160V | | 470uF 160V
C39 | PowerBoard.SchDoc | | Fitted | Not Fitted | Fitted
| | Comment | 100nF | | 100nF
| | Component Kind | Standard | | Standard
| | Description | 100nF ± 10% 50V | | 100nF ± 10% 50V
| | Footprint | C0402 | | C0402
| | Ibis Model
| | Library Name | VESC_MotorController.SCHLIB | | VESC_MotorController.SCHLIB
| | Library Reference | 100nF ± 10% 50V | | 100nF ± 10% 50V
| | Manufacturer | Yageo | | Yageo
| | Manufacturer Part Number | CS0603KRX7R9BB104 | | CS0603KRX7R9BB104
| | PCB3D
| | Pin Info
| | Price | 0.1 | | 0.1
| | Signal Integrity
| | Simulation
| | Supplier | mouser | | mouser
| | Supplier Part Number | 603-CS0603KRX79BB104 | | 603-CS0603KRX79BB104
| | Value | 100nF | | 100nF
C40 | PowerBoard.SchDoc | | Fitted | Not Fitted | Fitted
| | Comment | 4.7uF | | 4.7uF
| | Component Kind | Standard | | Standard
| | Description | 4.7uF ± 10% 50V | | 4.7uF ± 10% 50V
| | Footprint | C0603 | | C0603
| | Ibis Model
| | Library Name | VESC_MotorController.SCHLIB | | VESC_MotorController.SCHLIB
| | Library Reference | 4.7uF ± 10% 50V | | 4.7uF ± 10% 50V
| | Manufacturer | Yageo | | Yageo
| | Manufacturer Part Number | GRM188R61H225ME11J | | GRM188R61H225ME11J
| | PCB3D
| | Pin Info
| | Price | 0.3 | | 0.3
| | Signal Integrity
| | Simulation
| | Supplier | mouser | | mouser
| | Supplier Part Number | 81-GRM188R61H225ME1J | | 81-GRM188R61H225ME1J
| | Value | 4.7uF | | 4.7uF
C41 | PowerBoard.SchDoc | | Fitted | Not Fitted | Fitted
| | Comment | 2.2uF 200V | | 2.2uF 200V
| | Component Kind | Standard | | Standard
| | Description | Multilayer Ceramic Capacitors MLCC - SMD/SMT 200V 2.2uF X7R 2225 10% | | Multilayer Ceramic Capacitors MLCC - SMD/SMT 200V 2.2uF X7R 2225 10%
| | Footprint | CAPC5764X279N | | CAPC5764X279N
| | Ibis Model
| | Library Name | VESC_MotorController.SCHLIB | | VESC_MotorController.SCHLIB
| | Library Reference | 2.2uF ± 10% 200V | | 2.2uF ± 10% 200V
| | Manufacturer | Kyocera avx | | Kyocera avx
| | Manufacturer Part Number | 22252C225KAT2A | | 22252C225KAT2A
| | PCB3D
| | Pin Info
| | Price | 2.4 | | 2.4
| | Signal Integrity
| | Simulation
| | Supplier | mouser | | mouser
| | Supplier Part Number | 581-22252C225KAT2A | | 581-22252C225KAT2A
| | Value | 2.2uF 200V | | 2.2uF 200V
C42 | PowerBoard.SchDoc | | Fitted | Not Fitted | Fitted
| | Comment | 2.2uF 200V | | 2.2uF 200V
| | Component Kind | Standard | | Standard
| | Description | Multilayer Ceramic Capacitors MLCC - SMD/SMT 200V 2.2uF X7R 2225 10% | | Multilayer Ceramic Capacitors MLCC - SMD/SMT 200V 2.2uF X7R 2225 10%
| | Footprint | CAPC5764X279N | | CAPC5764X279N
| | Ibis Model
| | Library Name | VESC_MotorController.SCHLIB | | VESC_MotorController.SCHLIB
| | Library Reference | 2.2uF ± 10% 200V | | 2.2uF ± 10% 200V
| | Manufacturer | Kyocera avx | | Kyocera avx
| | Manufacturer Part Number | 22252C225KAT2A | | 22252C225KAT2A
| | PCB3D
| | Pin Info
| | Price | 2.4 | | 2.4
| | Signal Integrity
| | Simulation
| | Supplier | mouser | | mouser
| | Supplier Part Number | 581-22252C225KAT2A | | 581-22252C225KAT2A
| | Value | 2.2uF 200V | | 2.2uF 200V
C43 | PowerBoard.SchDoc | | Fitted | Not Fitted | Fitted
| | Comment | 2.2uF 200V | | 2.2uF 200V
| | Component Kind | Standard | | Standard
| | Description | Multilayer Ceramic Capacitors MLCC - SMD/SMT 200V 2.2uF X7R 2225 10% | | Multilayer Ceramic Capacitors MLCC - SMD/SMT 200V 2.2uF X7R 2225 10%
| | Footprint | CAPC5764X279N | | CAPC5764X279N
| | Ibis Model
| | Library Name | VESC_MotorController.SCHLIB | | VESC_MotorController.SCHLIB
| | Library Reference | 2.2uF ± 10% 200V | | 2.2uF ± 10% 200V
| | Manufacturer | Kyocera avx | | Kyocera avx
| | Manufacturer Part Number | 22252C225KAT2A | | 22252C225KAT2A
| | PCB3D
| | Pin Info
| | Price | 2.4 | | 2.4
| | Signal Integrity
| | Simulation
| | Supplier | mouser | | mouser
| | Supplier Part Number | 581-22252C225KAT2A | | 581-22252C225KAT2A
| | Value | 2.2uF 200V | | 2.2uF 200V
C44 | PowerBoard.SchDoc | | Fitted | Not Fitted | Fitted
| | Comment | 100nF | | 100nF
| | Component Kind | Standard | | Standard
| | Description | 100nF ± 10% 50V | | 100nF ± 10% 50V
| | Footprint | C0402 | | C0402
| | Ibis Model
| | Library Name | VESC_MotorController.SCHLIB | | VESC_MotorController.SCHLIB
| | Library Reference | 100nF ± 10% 50V | | 100nF ± 10% 50V
| | Manufacturer | Yageo | | Yageo
| | Manufacturer Part Number | CS0603KRX7R9BB104 | | CS0603KRX7R9BB104
| | PCB3D
| | Pin Info
| | Price | 0.1 | | 0.1
| | Signal Integrity
| | Simulation
| | Supplier | mouser | | mouser
| | Supplier Part Number | 603-CS0603KRX79BB104 | | 603-CS0603KRX79BB104
| | Value | 100nF | | 100nF
C45 | PowerBoard.SchDoc | | Fitted | Not Fitted | Fitted
| | Comment | 100nF | | 100nF
| | Component Kind | Standard | | Standard
| | Description | 100nF ± 10% 50V | | 100nF ± 10% 50V
| | Footprint | C0402 | | C0402
| | Ibis Model
| | Library Name | VESC_MotorController.SCHLIB | | VESC_MotorController.SCHLIB
| | Library Reference | 100nF ± 10% 50V | | 100nF ± 10% 50V
| | Manufacturer | Yageo | | Yageo
| | Manufacturer Part Number | CS0603KRX7R9BB104 | | CS0603KRX7R9BB104
| | PCB3D
| | Pin Info
| | Price | 0.1 | | 0.1
| | Signal Integrity
| | Simulation
| | Supplier | mouser | | mouser
| | Supplier Part Number | 603-CS0603KRX79BB104 | | 603-CS0603KRX79BB104
| | Value | 100nF | | 100nF
C46 | PowerBoard.SchDoc | | Fitted | Not Fitted | Fitted
| | Comment | 100nF | | 100nF
| | Component Kind | Standard | | Standard
| | Description | 100nF ± 10% 50V | | 100nF ± 10% 50V
| | Footprint | C0402 | | C0402
| | Ibis Model
| | Library Name | VESC_MotorController.SCHLIB | | VESC_MotorController.SCHLIB
| | Library Reference | 100nF ± 10% 50V | | 100nF ± 10% 50V
| | Manufacturer | Yageo | | Yageo
| | Manufacturer Part Number | CS0603KRX7R9BB104 | | CS0603KRX7R9BB104
| | PCB3D
| | Pin Info
| | Price | 0.1 | | 0.1
| | Signal Integrity
| | Simulation
| | Supplier | mouser | | mouser
| | Supplier Part Number | 603-CS0603KRX79BB104 | | 603-CS0603KRX79BB104
| | Value | 100nF | | 100nF
C47 | PowerBoard.SchDoc | | Fitted | Not Fitted | Fitted
| | Comment | 470uF 160V | | 470uF 160V
| | Component Kind | Standard | | Standard
| | Description | Cornell-Dubilier 470uF 160 V dc Aluminium Electrolytic Capacitor A3, SLP Series 3000h 22 Dia. x 30mm | | Cornell-Dubilier 470uF 160 V dc Aluminium Electrolytic Capacitor A3, SLP Series 3000h 22 Dia. x 30mm
| | Footprint | CAPPRD1000W190D2250H3200 | | CAPPRD1000W190D2250H3200
| | Ibis Model
| | Library Name | VESC_MotorController.SCHLIB | | VESC_MotorController.SCHLIB
| | Library Reference | 470uF 160V | | 470uF 160V
| | Manufacturer | Cornell Dubilier | | Cornell Dubilier
| | Manufacturer Part Number | SLP471M160A3P3 | | SLP471M160A3P3
| | PCB3D
| | Pin Info
| | Price | 3.3 | | 3.3
| | Signal Integrity
| | Simulation
| | Suplier | Mouser | | Mouser
| | Supplier Part Number | 598-SLP471M160A3P3 | | 598-SLP471M160A3P3
| | Value | 470uF 160V | | 470uF 160V
C48 | PowerBoard.SchDoc | | Fitted | Not Fitted | Fitted
| | Comment | 2.2uF 200V | | 2.2uF 200V
| | Component Kind | Standard | | Standard
| | Description | Multilayer Ceramic Capacitors MLCC - SMD/SMT 200V 2.2uF X7R 2225 10% | | Multilayer Ceramic Capacitors MLCC - SMD/SMT 200V 2.2uF X7R 2225 10%
| | Footprint | CAPC5764X279N | | CAPC5764X279N
| | Ibis Model
| | Library Name | VESC_MotorController.SCHLIB | | VESC_MotorController.SCHLIB
| | Library Reference | 2.2uF ± 10% 200V | | 2.2uF ± 10% 200V
| | Manufacturer | Kyocera avx | | Kyocera avx
| | Manufacturer Part Number | 22252C225KAT2A | | 22252C225KAT2A
| | PCB3D
| | Pin Info
| | Price | 2.4 | | 2.4
| | Signal Integrity
| | Simulation
| | Supplier | mouser | | mouser
| | Supplier Part Number | 581-22252C225KAT2A | | 581-22252C225KAT2A
| | Value | 2.2uF 200V | | 2.2uF 200V
C49 | PowerBoard.SchDoc | | Fitted | Not Fitted | Fitted
| | Comment | 2.2uF 200V | | 2.2uF 200V
| | Component Kind | Standard | | Standard
| | Description | Multilayer Ceramic Capacitors MLCC - SMD/SMT 200V 2.2uF X7R 2225 10% | | Multilayer Ceramic Capacitors MLCC - SMD/SMT 200V 2.2uF X7R 2225 10%
| | Footprint | CAPC5764X279N | | CAPC5764X279N
| | Ibis Model
| | Library Name | VESC_MotorController.SCHLIB | | VESC_MotorController.SCHLIB
| | Library Reference | 2.2uF ± 10% 200V | | 2.2uF ± 10% 200V
| | Manufacturer | Kyocera avx | | Kyocera avx
| | Manufacturer Part Number | 22252C225KAT2A | | 22252C225KAT2A
| | PCB3D
| | Pin Info
| | Price | 2.4 | | 2.4
| | Signal Integrity
| | Simulation
| | Supplier | mouser | | mouser
| | Supplier Part Number | 581-22252C225KAT2A | | 581-22252C225KAT2A
| | Value | 2.2uF 200V | | 2.2uF 200V
C50 | PowerBoard.SchDoc | | Fitted | Fitted | Fitted
| | Comment | 2.2uF 200V | 2.2uF 200V | 2.2uF 200V
| | Component Kind | Standard | Standard | Standard
| | Description | Multilayer Ceramic Capacitors MLCC - SMD/SMT 200V 2.2uF X7R 2225 10% | Multilayer Ceramic Capacitors MLCC - SMD/SMT 200V 2.2uF X7R 2225 10% | Multilayer Ceramic Capacitors MLCC - SMD/SMT 200V 2.2uF X7R 2225 10%
| | Footprint | CAPC5764X279N | CAPC5764X279N | CAPC5764X279N
| | Ibis Model
| | Library Name | VESC_MotorController.SCHLIB | VESC_MotorController.SCHLIB | VESC_MotorController.SCHLIB
| | Library Reference | 2.2uF ± 10% 200V | 2.2uF ± 10% 200V | 2.2uF ± 10% 200V
| | Manufacturer | Kyocera avx | Kyocera avx | Kyocera avx
| | Manufacturer Part Number | 22252C225KAT2A | 22252C225KAT2A | 22252C225KAT2A
| | PCB3D
| | Pin Info
| | Price | 2.4 | 2.4 | 2.4
| | Signal Integrity
| | Simulation
| | Supplier | mouser | mouser | mouser
| | Supplier Part Number | 581-22252C225KAT2A | 581-22252C225KAT2A | 581-22252C225KAT2A
| | Value | 2.2uF 200V | 2.2uF 200V | 2.2uF 200V
C51 | PowerBoard.SchDoc | | Fitted | Fitted | Fitted
| | Comment | 470uF 160V | 470uF 160V | 470uF 160V
| | Component Kind | Standard | Standard | Standard
| | Description | Cornell-Dubilier 470uF 160 V dc Aluminium Electrolytic Capacitor A3, SLP Series 3000h 22 Dia. x 30mm | Cornell-Dubilier 470uF 160 V dc Aluminium Electrolytic Capacitor A3, SLP Series 3000h 22 Dia. x 30mm | Cornell-Dubilier 470uF 160 V dc Aluminium Electrolytic Capacitor A3, SLP Series 3000h 22 Dia. x 30mm
| | Footprint | CAPPRD1000W190D2250H3200 | CAPPRD1000W190D2250H3200 | CAPPRD1000W190D2250H3200
| | Ibis Model
| | Library Name | VESC_MotorController.SCHLIB | VESC_MotorController.SCHLIB | VESC_MotorController.SCHLIB
| | Library Reference | 470uF 160V | 470uF 160V | 470uF 160V
| | Manufacturer | Cornell Dubilier | Cornell Dubilier | Cornell Dubilier
| | Manufacturer Part Number | SLP471M160A3P3 | SLP471M160A3P3 | SLP471M160A3P3
| | PCB3D
| | Pin Info
| | Price | 3.3 | 3.3 | 3.3
| | Signal Integrity
| | Simulation
| | Suplier | Mouser | Mouser | Mouser
| | Supplier Part Number | 598-SLP471M160A3P3 | 598-SLP471M160A3P3 | 598-SLP471M160A3P3
| | Value | 470uF 160V | 470uF 160V | 470uF 160V
C52 | PowerBoard.SchDoc | | Fitted | Fitted | Fitted
| | Comment | 470uF 160V | 470uF 160V | 470uF 160V
| | Component Kind | Standard | Standard | Standard
| | Description | Cornell-Dubilier 470uF 160 V dc Aluminium Electrolytic Capacitor A3, SLP Series 3000h 22 Dia. x 30mm | Cornell-Dubilier 470uF 160 V dc Aluminium Electrolytic Capacitor A3, SLP Series 3000h 22 Dia. x 30mm | Cornell-Dubilier 470uF 160 V dc Aluminium Electrolytic Capacitor A3, SLP Series 3000h 22 Dia. x 30mm
| | Footprint | CAPPRD1000W190D2250H3200 | CAPPRD1000W190D2250H3200 | CAPPRD1000W190D2250H3200
| | Ibis Model
| | Library Name | VESC_MotorController.SCHLIB | VESC_MotorController.SCHLIB | VESC_MotorController.SCHLIB
| | Library Reference | 470uF 160V | 470uF 160V | 470uF 160V
| | Manufacturer | Cornell Dubilier | Cornell Dubilier | Cornell Dubilier
| | Manufacturer Part Number | SLP471M160A3P3 | SLP471M160A3P3 | SLP471M160A3P3
| | PCB3D
| | Pin Info
| | Price | 3.3 | 3.3 | 3.3
| | Signal Integrity
| | Simulation
| | Suplier | Mouser | Mouser | Mouser
| | Supplier Part Number | 598-SLP471M160A3P3 | 598-SLP471M160A3P3 | 598-SLP471M160A3P3
| | Value | 470uF 160V | 470uF 160V | 470uF 160V
C53 | PowerBoard.SchDoc | | Fitted | Fitted | Fitted
| | Comment | 100nF | 100nF | 100nF
| | Component Kind | Standard | Standard | Standard
| | Description | 100nF ± 10% 50V | 100nF ± 10% 50V | 100nF ± 10% 50V
| | Footprint | C0402 | C0402 | C0402
| | Ibis Model
| | Library Name | VESC_MotorController.SCHLIB | VESC_MotorController.SCHLIB | VESC_MotorController.SCHLIB
| | Library Reference | 100nF ± 10% 50V | 100nF ± 10% 50V | 100nF ± 10% 50V
| | Manufacturer | Yageo | Yageo | Yageo
| | Manufacturer Part Number | CS0603KRX7R9BB104 | CS0603KRX7R9BB104 | CS0603KRX7R9BB104
| | PCB3D
| | Pin Info
| | Price | 0.1 | 0.1 | 0.1
| | Signal Integrity
| | Simulation
| | Supplier | mouser | mouser | mouser
| | Supplier Part Number | 603-CS0603KRX79BB104 | 603-CS0603KRX79BB104 | 603-CS0603KRX79BB104
| | Value | 100nF | 100nF | 100nF
C54 | PowerBoard.SchDoc | | Fitted | Fitted | Fitted
| | Comment | 470uF 160V | 470uF 160V | 470uF 160V
| | Component Kind | Standard | Standard | Standard
| | Description | Cornell-Dubilier 470uF 160 V dc Aluminium Electrolytic Capacitor A3, SLP Series 3000h 22 Dia. x 30mm | Cornell-Dubilier 470uF 160 V dc Aluminium Electrolytic Capacitor A3, SLP Series 3000h 22 Dia. x 30mm | Cornell-Dubilier 470uF 160 V dc Aluminium Electrolytic Capacitor A3, SLP Series 3000h 22 Dia. x 30mm
| | Footprint | CAPPRD1000W190D2250H3200 | CAPPRD1000W190D2250H3200 | CAPPRD1000W190D2250H3200
| | Ibis Model
| | Library Name | VESC_MotorController.SCHLIB | VESC_MotorController.SCHLIB | VESC_MotorController.SCHLIB
| | Library Reference | 470uF 160V | 470uF 160V | 470uF 160V
| | Manufacturer | Cornell Dubilier | Cornell Dubilier | Cornell Dubilier
| | Manufacturer Part Number | SLP471M160A3P3 | SLP471M160A3P3 | SLP471M160A3P3
| | PCB3D
| | Pin Info
| | Price | 3.3 | 3.3 | 3.3
| | Signal Integrity
| | Simulation
| | Suplier | Mouser | Mouser | Mouser
| | Supplier Part Number | 598-SLP471M160A3P3 | 598-SLP471M160A3P3 | 598-SLP471M160A3P3
| | Value | 470uF 160V | 470uF 160V | 470uF 160V
C55 | PowerBoard.SchDoc | | Fitted | Fitted | Fitted
| | Comment | 2.2uF | 2.2uF | 2.2uF
| | Component Kind | Standard | Standard | Standard
| | Description | 2.2uF ± 10% 50V | 2.2uF ± 10% 50V | 2.2uF ± 10% 50V
| | Footprint | C0603 | C0603 | C0603
| | Ibis Model
| | Library Name | VESC_MotorController.SCHLIB | VESC_MotorController.SCHLIB | VESC_MotorController.SCHLIB
| | Library Reference | 2.2uF ± 10% 50V | 2.2uF ± 10% 50V | 2.2uF ± 10% 50V
| | Manufacturer | Yageo | Yageo | Yageo
| | Manufacturer Part Number | GRM188R61H225ME11J | GRM188R61H225ME11J | GRM188R61H225ME11J
| | PCB3D
| | Pin Info
| | Price | 0.3 | 0.3 | 0.3
| | Signal Integrity
| | Simulation
| | Supplier | mouser | mouser | mouser
| | Supplier Part Number | 81-GRM188R61H225ME1J | 81-GRM188R61H225ME1J | 81-GRM188R61H225ME1J
| | Value | 2.2uF | 2.2uF | 2.2uF
C56 | PowerBoard.SchDoc | | Fitted | Fitted | Fitted
| | Comment | 100nF | 100nF | 100nF
| | Component Kind | Standard | Standard | Standard
| | Description | 100nF ± 10% 50V | 100nF ± 10% 50V | 100nF ± 10% 50V
| | Footprint | C0402 | C0402 | C0402
| | Ibis Model
| | Library Name | VESC_MotorController.SCHLIB | VESC_MotorController.SCHLIB | VESC_MotorController.SCHLIB
| | Library Reference | 100nF ± 10% 50V | 100nF ± 10% 50V | 100nF ± 10% 50V
| | Manufacturer | Yageo | Yageo | Yageo
| | Manufacturer Part Number | CS0603KRX7R9BB104 | CS0603KRX7R9BB104 | CS0603KRX7R9BB104
| | PCB3D
| | Pin Info
| | Price | 0.1 | 0.1 | 0.1
| | Signal Integrity
| | Simulation
| | Supplier | mouser | mouser | mouser
| | Supplier Part Number | 603-CS0603KRX79BB104 | 603-CS0603KRX79BB104 | 603-CS0603KRX79BB104
| | Value | 100nF | 100nF | 100nF
C57 | PowerBoard.SchDoc | | Fitted | Fitted | Fitted
| | Comment | 2.2uF | 2.2uF | 2.2uF
| | Component Kind | Standard | Standard | Standard
| | Description | 2.2uF ± 10% 50V | 2.2uF ± 10% 50V | 2.2uF ± 10% 50V
| | Footprint | C0603 | C0603 | C0603
| | Ibis Model
| | Library Name | VESC_MotorController.SCHLIB | VESC_MotorController.SCHLIB | VESC_MotorController.SCHLIB
| | Library Reference | 2.2uF ± 10% 50V | 2.2uF ± 10% 50V | 2.2uF ± 10% 50V
| | Manufacturer | Yageo | Yageo | Yageo
| | Manufacturer Part Number | GRM188R61H225ME11J | GRM188R61H225ME11J | GRM188R61H225ME11J
| | PCB3D
| | Pin Info
| | Price | 0.3 | 0.3 | 0.3
| | Signal Integrity
| | Simulation
| | Supplier | mouser | mouser | mouser
| | Supplier Part Number | 81-GRM188R61H225ME1J | 81-GRM188R61H225ME1J | 81-GRM188R61H225ME1J
| | Value | 2.2uF | 2.2uF | 2.2uF
C58 | PowerBoard.SchDoc | | Fitted | Fitted | Fitted
| | Comment | 4.7uF | 4.7uF | 4.7uF
| | Component Kind | Standard | Standard | Standard
| | Description | 4.7uF ± 10% 50V | 4.7uF ± 10% 50V | 4.7uF ± 10% 50V
| | Footprint | C0603 | C0603 | C0603
| | Ibis Model
| | Library Name | VESC_MotorController.SCHLIB | VESC_MotorController.SCHLIB | VESC_MotorController.SCHLIB
| | Library Reference | 4.7uF ± 10% 50V | 4.7uF ± 10% 50V | 4.7uF ± 10% 50V
| | Manufacturer | Yageo | Yageo | Yageo
| | Manufacturer Part Number | GRM188R61H225ME11J | GRM188R61H225ME11J | GRM188R61H225ME11J
| | PCB3D
| | Pin Info
| | Price | 0.3 | 0.3 | 0.3
| | Signal Integrity
| | Simulation
| | Supplier | mouser | mouser | mouser
| | Supplier Part Number | 81-GRM188R61H225ME1J | 81-GRM188R61H225ME1J | 81-GRM188R61H225ME1J
| | Value | 4.7uF | 4.7uF | 4.7uF
C59 | PowerBoard.SchDoc | | Fitted | Fitted | Fitted
| | Comment | 100nF | 100nF | 100nF
| | Component Kind | Standard | Standard | Standard
| | Description | 100nF ± 10% 50V | 100nF ± 10% 50V | 100nF ± 10% 50V
| | Footprint | C0402 | C0402 | C0402
| | Ibis Model
| | Library Name | VESC_MotorController.SCHLIB | VESC_MotorController.SCHLIB | VESC_MotorController.SCHLIB
| | Library Reference | 100nF ± 10% 50V | 100nF ± 10% 50V | 100nF ± 10% 50V
| | Manufacturer | Yageo | Yageo | Yageo
| | Manufacturer Part Number | CS0603KRX7R9BB104 | CS0603KRX7R9BB104 | CS0603KRX7R9BB104
| | PCB3D
| | Pin Info
| | Price | 0.1 | 0.1 | 0.1
| | Signal Integrity
| | Simulation
| | Supplier | mouser | mouser | mouser
| | Supplier Part Number | 603-CS0603KRX79BB104 | 603-CS0603KRX79BB104 | 603-CS0603KRX79BB104
| | Value | 100nF | 100nF | 100nF
C60 | PowerBoard.SchDoc | | Fitted | Fitted | Fitted
| | Comment | 2.2uF | 2.2uF | 2.2uF
| | Component Kind | Standard | Standard | Standard
| | Description | 2.2uF ± 10% 50V | 2.2uF ± 10% 50V | 2.2uF ± 10% 50V
| | Footprint | C0603 | C0603 | C0603
| | Ibis Model
| | Library Name | VESC_MotorController.SCHLIB | VESC_MotorController.SCHLIB | VESC_MotorController.SCHLIB
| | Library Reference | 2.2uF ± 10% 50V | 2.2uF ± 10% 50V | 2.2uF ± 10% 50V
| | Manufacturer | Yageo | Yageo | Yageo
| | Manufacturer Part Number | GRM188R61H225ME11J | GRM188R61H225ME11J | GRM188R61H225ME11J
| | PCB3D
| | Pin Info
| | Price | 0.3 | 0.3 | 0.3
| | Signal Integrity
| | Simulation
| | Supplier | mouser | mouser | mouser
| | Supplier Part Number | 81-GRM188R61H225ME1J | 81-GRM188R61H225ME1J | 81-GRM188R61H225ME1J
| | Value | 2.2uF | 2.2uF | 2.2uF
C61 | Controller.SchDoc | | Fitted | Fitted | Fitted
| | Comment | 2.2uF | 2.2uF | 2.2uF
| | Component Kind | Standard | Standard | Standard
| | Description | 2.2uF ± 10% 50V | 2.2uF ± 10% 50V | 2.2uF ± 10% 50V
| | Footprint | C0603 | C0603 | C0603
| | Ibis Model
| | Library Name | VESC_MotorController.SCHLIB | VESC_MotorController.SCHLIB | VESC_MotorController.SCHLIB
| | Library Reference | 2.2uF ± 10% 50V | 2.2uF ± 10% 50V | 2.2uF ± 10% 50V
| | Manufacturer | Yageo | Yageo | Yageo
| | Manufacturer Part Number | GRM188R61H225ME11J | GRM188R61H225ME11J | GRM188R61H225ME11J
| | PCB3D
| | Pin Info
| | Price | 0.3 | 0.3 | 0.3
| | Signal Integrity
| | Simulation
| | Supplier | mouser | mouser | mouser
| | Supplier Part Number | 81-GRM188R61H225ME1J | 81-GRM188R61H225ME1J | 81-GRM188R61H225ME1J
| | Value | 2.2uF | 2.2uF | 2.2uF
C62 | Controller.SchDoc | | Fitted | Fitted | Fitted
| | Comment | 2.2uF | 2.2uF | 2.2uF
| | Component Kind | Standard | Standard | Standard
| | Description | 2.2uF ± 10% 50V | 2.2uF ± 10% 50V | 2.2uF ± 10% 50V
| | Footprint | C0603 | C0603 | C0603
| | Ibis Model
| | Library Name | VESC_MotorController.SCHLIB | VESC_MotorController.SCHLIB | VESC_MotorController.SCHLIB
| | Library Reference | 2.2uF ± 10% 50V | 2.2uF ± 10% 50V | 2.2uF ± 10% 50V
| | Manufacturer | Yageo | Yageo | Yageo
| | Manufacturer Part Number | GRM188R61H225ME11J | GRM188R61H225ME11J | GRM188R61H225ME11J
| | PCB3D
| | Pin Info
| | Price | 0.3 | 0.3 | 0.3
| | Signal Integrity
| | Simulation
| | Supplier | mouser | mouser | mouser
| | Supplier Part Number | 81-GRM188R61H225ME1J | 81-GRM188R61H225ME1J | 81-GRM188R61H225ME1J
| | Value | 2.2uF | 2.2uF | 2.2uF
C63 | Controller.SchDoc | | Fitted | Fitted | Fitted
| | Comment | 100nF | 100nF | 100nF
| | Component Kind | Standard | Standard | Standard
| | Description | 100nF ± 10% 50V | 100nF ± 10% 50V | 100nF ± 10% 50V
| | Footprint | C0402 | C0402 | C0402
| | Ibis Model
| | Library Name | VESC_MotorController.SCHLIB | VESC_MotorController.SCHLIB | VESC_MotorController.SCHLIB
| | Library Reference | 100nF ± 10% 50V | 100nF ± 10% 50V | 100nF ± 10% 50V
| | Manufacturer | Yageo | Yageo | Yageo
| | Manufacturer Part Number | CS0603KRX7R9BB104 | CS0603KRX7R9BB104 | CS0603KRX7R9BB104
| | PCB3D
| | Pin Info
| | Price | 0.1 | 0.1 | 0.1
| | Signal Integrity
| | Simulation
| | Supplier | mouser | mouser | mouser
| | Supplier Part Number | 603-CS0603KRX79BB104 | 603-CS0603KRX79BB104 | 603-CS0603KRX79BB104
| | Value | 100nF | 100nF | 100nF
C64 | Controller.SchDoc | | Fitted | Fitted | Fitted
| | Comment | 100nF | 100nF | 100nF
| | Component Kind | Standard | Standard | Standard
| | Description | 100nF ± 10% 50V | 100nF ± 10% 50V | 100nF ± 10% 50V
| | Footprint | C0402 | C0402 | C0402
| | Ibis Model
| | Library Name | VESC_MotorController.SCHLIB | VESC_MotorController.SCHLIB | VESC_MotorController.SCHLIB
| | Library Reference | 100nF ± 10% 50V | 100nF ± 10% 50V | 100nF ± 10% 50V
| | Manufacturer | Yageo | Yageo | Yageo
| | Manufacturer Part Number | CS0603KRX7R9BB104 | CS0603KRX7R9BB104 | CS0603KRX7R9BB104
| | PCB3D
| | Pin Info
| | Price | 0.1 | 0.1 | 0.1
| | Signal Integrity
| | Simulation
| | Supplier | mouser | mouser | mouser
| | Supplier Part Number | 603-CS0603KRX79BB104 | 603-CS0603KRX79BB104 | 603-CS0603KRX79BB104
| | Value | 100nF | 100nF | 100nF
C65 | Controller.SchDoc | | Fitted | Fitted | Fitted
| | Comment | 100nF | 100nF | 100nF
| | Component Kind | Standard | Standard | Standard
| | Description | 100nF ± 10% 50V | 100nF ± 10% 50V | 100nF ± 10% 50V
| | Footprint | C0402 | C0402 | C0402
| | Ibis Model
| | Library Name | VESC_MotorController.SCHLIB | VESC_MotorController.SCHLIB | VESC_MotorController.SCHLIB
| | Library Reference | 100nF ± 10% 50V | 100nF ± 10% 50V | 100nF ± 10% 50V
| | Manufacturer | Yageo | Yageo | Yageo
| | Manufacturer Part Number | CS0603KRX7R9BB104 | CS0603KRX7R9BB104 | CS0603KRX7R9BB104
| | PCB3D
| | Pin Info
| | Price | 0.1 | 0.1 | 0.1
| | Signal Integrity
| | Simulation
| | Supplier | mouser | mouser | mouser
| | Supplier Part Number | 603-CS0603KRX79BB104 | 603-CS0603KRX79BB104 | 603-CS0603KRX79BB104
| | Value | 100nF | 100nF | 100nF
C66 | Controller.SchDoc | | Fitted | Fitted | Fitted
| | Comment | 100nF | 100nF | 100nF
| | Component Kind | Standard | Standard | Standard
| | Description | 100nF ± 10% 50V | 100nF ± 10% 50V | 100nF ± 10% 50V
| | Footprint | C0402 | C0402 | C0402
| | Ibis Model
| | Library Name | VESC_MotorController.SCHLIB | VESC_MotorController.SCHLIB | VESC_MotorController.SCHLIB
| | Library Reference | 100nF ± 10% 50V | 100nF ± 10% 50V | 100nF ± 10% 50V
| | Manufacturer | Yageo | Yageo | Yageo
| | Manufacturer Part Number | CS0603KRX7R9BB104 | CS0603KRX7R9BB104 | CS0603KRX7R9BB104
| | PCB3D
| | Pin Info
| | Price | 0.1 | 0.1 | 0.1
| | Signal Integrity
| | Simulation
| | Supplier | mouser | mouser | mouser
| | Supplier Part Number | 603-CS0603KRX79BB104 | 603-CS0603KRX79BB104 | 603-CS0603KRX79BB104
| | Value | 100nF | 100nF | 100nF
C67 | Controller.SchDoc | | Fitted | Fitted | Fitted
| | Comment | 10nF | 10nF | 10nF
| | Component Kind | Standard | Standard | Standard
| | Description | 10nF ± 10% 50V | 10nF ± 10% 50V | 10nF ± 10% 50V
| | Footprint | C0402 | C0402 | C0402
| | Ibis Model
| | Library Name | VESC_MotorController.SCHLIB | VESC_MotorController.SCHLIB | VESC_MotorController.SCHLIB
| | Library Reference | 10nF ± 10% 50V | 10nF ± 10% 50V | 10nF ± 10% 50V
| | Manufacturer | Yageo | Yageo | Yageo
| | Manufacturer Part Number | CS0603KRX79BB103 | CS0603KRX79BB103 | CS0603KRX79BB103
| | PCB3D
| | Pin Info
| | Price | 0.1 | 0.1 | 0.1
| | Signal Integrity
| | Simulation
| | Supplier | mouser | mouser | mouser
| | Supplier Part Number | 603-CS0603KRX79BB103 | 603-CS0603KRX79BB103 | 603-CS0603KRX79BB103
| | Value | 10nF | 10nF | 10nF
C68 | Controller.SchDoc | | Fitted | Fitted | Fitted
| | Comment | 10nF | 10nF | 10nF
| | Component Kind | Standard | Standard | Standard
| | Description | 10nF ± 10% 50V | 10nF ± 10% 50V | 10nF ± 10% 50V
| | Footprint | C0402 | C0402 | C0402
| | Ibis Model
| | Library Name | VESC_MotorController.SCHLIB | VESC_MotorController.SCHLIB | VESC_MotorController.SCHLIB
| | Library Reference | 10nF ± 10% 50V | 10nF ± 10% 50V | 10nF ± 10% 50V
| | Manufacturer | Yageo | Yageo | Yageo
| | Manufacturer Part Number | CS0603KRX79BB103 | CS0603KRX79BB103 | CS0603KRX79BB103
| | PCB3D
| | Pin Info
| | Price | 0.1 | 0.1 | 0.1
| | Signal Integrity
| | Simulation
| | Supplier | mouser | mouser | mouser
| | Supplier Part Number | 603-CS0603KRX79BB103 | 603-CS0603KRX79BB103 | 603-CS0603KRX79BB103
| | Value | 10nF | 10nF | 10nF
C69 | Controller.SchDoc | | Fitted | Fitted | Fitted
| | Comment | 10nF | 10nF | 10nF
| | Component Kind | Standard | Standard | Standard
| | Description | 10nF ± 10% 50V | 10nF ± 10% 50V | 10nF ± 10% 50V
| | Footprint | C0402 | C0402 | C0402
| | Ibis Model
| | Library Name | VESC_MotorController.SCHLIB | VESC_MotorController.SCHLIB | VESC_MotorController.SCHLIB
| | Library Reference | 10nF ± 10% 50V | 10nF ± 10% 50V | 10nF ± 10% 50V
| | Manufacturer | Yageo | Yageo | Yageo
| | Manufacturer Part Number | CS0603KRX79BB103 | CS0603KRX79BB103 | CS0603KRX79BB103
| | PCB3D
| | Pin Info
| | Price | 0.1 | 0.1 | 0.1
| | Signal Integrity
| | Simulation
| | Supplier | mouser | mouser | mouser
| | Supplier Part Number | 603-CS0603KRX79BB103 | 603-CS0603KRX79BB103 | 603-CS0603KRX79BB103
| | Value | 10nF | 10nF | 10nF
C70 | Controller.SchDoc | | Fitted | Fitted | Fitted
| | Comment | 10nF | 10nF | 10nF
| | Component Kind | Standard | Standard | Standard
| | Description | 10nF ± 10% 50V | 10nF ± 10% 50V | 10nF ± 10% 50V
| | Footprint | C0402 | C0402 | C0402
| | Ibis Model
| | Library Name | VESC_MotorController.SCHLIB | VESC_MotorController.SCHLIB | VESC_MotorController.SCHLIB
| | Library Reference | 10nF ± 10% 50V | 10nF ± 10% 50V | 10nF ± 10% 50V
| | Manufacturer | Yageo | Yageo | Yageo
| | Manufacturer Part Number | CS0603KRX79BB103 | CS0603KRX79BB103 | CS0603KRX79BB103
| | PCB3D
| | Pin Info
| | Price | 0.1 | 0.1 | 0.1
| | Signal Integrity
| | Simulation
| | Supplier | mouser | mouser | mouser
| | Supplier Part Number | 603-CS0603KRX79BB103 | 603-CS0603KRX79BB103 | 603-CS0603KRX79BB103
| | Value | 10nF | 10nF | 10nF
C71 | Controller.SchDoc | | Fitted | Fitted | Fitted
| | Comment | 2.2uF | 2.2uF | 2.2uF
| | Component Kind | Standard | Standard | Standard
| | Description | 2.2uF ± 10% 50V | 2.2uF ± 10% 50V | 2.2uF ± 10% 50V
| | Footprint | C0603 | C0603 | C0603
| | Ibis Model
| | Library Name | VESC_MotorController.SCHLIB | VESC_MotorController.SCHLIB | VESC_MotorController.SCHLIB
| | Library Reference | 2.2uF ± 10% 50V | 2.2uF ± 10% 50V | 2.2uF ± 10% 50V
| | Manufacturer | Yageo | Yageo | Yageo
| | Manufacturer Part Number | GRM188R61H225ME11J | GRM188R61H225ME11J | GRM188R61H225ME11J
| | PCB3D
| | Pin Info
| | Price | 0.3 | 0.3 | 0.3
| | Signal Integrity
| | Simulation
| | Supplier | mouser | mouser | mouser
| | Supplier Part Number | 81-GRM188R61H225ME1J | 81-GRM188R61H225ME1J | 81-GRM188R61H225ME1J
| | Value | 2.2uF | 2.2uF | 2.2uF
C72 | Controller.SchDoc | | Fitted | Fitted | Fitted
| | Comment | 2.2nF | 2.2nF | 2.2nF
| | Component Kind | Standard | Standard | Standard
| | Description | 2.2nF ± 10% 50V | 2.2nF ± 10% 50V | 2.2nF ± 10% 50V
| | Footprint | C0402 | C0402 | C0402
| | Ibis Model
| | Library Name | VESC_MotorController.SCHLIB | VESC_MotorController.SCHLIB | VESC_MotorController.SCHLIB
| | Library Reference | 2.2nF ± 10% 50V | 2.2nF ± 10% 50V | 2.2nF ± 10% 50V
| | Manufacturer | Yageo | Yageo | Yageo
| | Manufacturer Part Number | CS0603KRX79BB222 | CS0603KRX79BB222 | CS0603KRX79BB222
| | PCB3D
| | Pin Info
| | Price | 0.1 | 0.1 | 0.1
| | Signal Integrity
| | Simulation
| | Supplier | mouser | mouser | mouser
| | Supplier Part Number | 603-CS0603KRX79BB222 | 603-CS0603KRX79BB222 | 603-CS0603KRX79BB222
| | Value | 2.2nF | 2.2nF | 2.2nF
C73 | Controller.SchDoc | | Fitted | Fitted | Fitted
| | Comment | 47uF | 47uF | 47uF
| | Component Kind | Standard | Standard | Standard
| | Description | 47uF ± 10% 25V | 47uF ± 10% 25V | 47uF ± 10% 25V
| | Footprint | CAPPRD200W52D500H1250 | CAPPRD200W52D500H1250 | CAPPRD200W52D500H1250
| | Ibis Model
| | Library Name | VESC_MotorController.SCHLIB | VESC_MotorController.SCHLIB | VESC_MotorController.SCHLIB
| | Library Reference | 47uF ± 10% 25V | 47uF ± 10% 25V | 47uF ± 10% 25V
| | Manufacturer | Wurth Electronic | Wurth Electronic | Wurth Electronic
| | Manufacturer Part Number | 860040472001 | 860040472001 | 860040472001
| | PCB3D
| | Pin Info
| | Price | 0.18 | 0.18 | 0.18
| | Signal Integrity
| | Simulation
| | Supplier | mouser | mouser | mouser
| | Supplier Part Number | 710-860040472001 | 710-860040472001 | 710-860040472001
| | Value | 47uF | 47uF | 47uF
C74 | Controller.SchDoc | | Fitted | Fitted | Fitted
| | Comment | 100nF | 100nF | 100nF
| | Component Kind | Standard | Standard | Standard
| | Description | 100nF ± 10% 50V | 100nF ± 10% 50V | 100nF ± 10% 50V
| | Footprint | C0402 | C0402 | C0402
| | Ibis Model
| | Library Name | VESC_MotorController.SCHLIB | VESC_MotorController.SCHLIB | VESC_MotorController.SCHLIB
| | Library Reference | 100nF ± 10% 50V | 100nF ± 10% 50V | 100nF ± 10% 50V
| | Manufacturer | Yageo | Yageo | Yageo
| | Manufacturer Part Number | CS0603KRX7R9BB104 | CS0603KRX7R9BB104 | CS0603KRX7R9BB104
| | PCB3D
| | Pin Info
| | Price | 0.1 | 0.1 | 0.1
| | Signal Integrity
| | Simulation
| | Supplier | mouser | mouser | mouser
| | Supplier Part Number | 603-CS0603KRX79BB104 | 603-CS0603KRX79BB104 | 603-CS0603KRX79BB104
| | Value | 100nF | 100nF | 100nF
C75 | Controller.SchDoc | | Fitted | Fitted | Fitted
| | Comment | 100nF | 100nF | 100nF
| | Component Kind | Standard | Standard | Standard
| | Description | 100nF ± 10% 50V | 100nF ± 10% 50V | 100nF ± 10% 50V
| | Footprint | C0402 | C0402 | C0402
| | Ibis Model
| | Library Name | VESC_MotorController.SCHLIB | VESC_MotorController.SCHLIB | VESC_MotorController.SCHLIB
| | Library Reference | 100nF ± 10% 50V | 100nF ± 10% 50V | 100nF ± 10% 50V
| | Manufacturer | Yageo | Yageo | Yageo
| | Manufacturer Part Number | CS0603KRX7R9BB104 | CS0603KRX7R9BB104 | CS0603KRX7R9BB104
| | PCB3D
| | Pin Info
| | Price | 0.1 | 0.1 | 0.1
| | Signal Integrity
| | Simulation
| | Supplier | mouser | mouser | mouser
| | Supplier Part Number | 603-CS0603KRX79BB104 | 603-CS0603KRX79BB104 | 603-CS0603KRX79BB104
| | Value | 100nF | 100nF | 100nF
C76 | Controller.SchDoc | | Fitted | Fitted | Fitted
| | Comment | 100nF | 100nF | 100nF
| | Component Kind | Standard | Standard | Standard
| | Description | 100nF ± 10% 50V | 100nF ± 10% 50V | 100nF ± 10% 50V
| | Footprint | C0402 | C0402 | C0402
| | Ibis Model
| | Library Name | VESC_MotorController.SCHLIB | VESC_MotorController.SCHLIB | VESC_MotorController.SCHLIB
| | Library Reference | 100nF ± 10% 50V | 100nF ± 10% 50V | 100nF ± 10% 50V
| | Manufacturer | Yageo | Yageo | Yageo
| | Manufacturer Part Number | CS0603KRX7R9BB104 | CS0603KRX7R9BB104 | CS0603KRX7R9BB104
| | PCB3D
| | Pin Info
| | Price | 0.1 | 0.1 | 0.1
| | Signal Integrity
| | Simulation
| | Supplier | mouser | mouser | mouser
| | Supplier Part Number | 603-CS0603KRX79BB104 | 603-CS0603KRX79BB104 | 603-CS0603KRX79BB104
| | Value | 100nF | 100nF | 100nF
C77 | Controller.SchDoc | | Fitted | Fitted | Fitted
| | Comment | 10nF | 10nF | 10nF
| | Component Kind | Standard | Standard | Standard
| | Description | 10nF ± 10% 50V | 10nF ± 10% 50V | 10nF ± 10% 50V
| | Footprint | C0402 | C0402 | C0402
| | Ibis Model
| | Library Name | VESC_MotorController.SCHLIB | VESC_MotorController.SCHLIB | VESC_MotorController.SCHLIB
| | Library Reference | 10nF ± 10% 50V | 10nF ± 10% 50V | 10nF ± 10% 50V
| | Manufacturer | Yageo | Yageo | Yageo
| | Manufacturer Part Number | CS0603KRX79BB103 | CS0603KRX79BB103 | CS0603KRX79BB103
| | PCB3D
| | Pin Info
| | Price | 0.1 | 0.1 | 0.1
| | Signal Integrity
| | Simulation
| | Supplier | mouser | mouser | mouser
| | Supplier Part Number | 603-CS0603KRX79BB103 | 603-CS0603KRX79BB103 | 603-CS0603KRX79BB103
| | Value | 10nF | 10nF | 10nF
C78 | Controller.SchDoc | | Fitted | Fitted | Fitted
| | Comment | 2.2uF | 2.2uF | 2.2uF
| | Component Kind | Standard | Standard | Standard
| | Description | 2.2uF ± 10% 50V | 2.2uF ± 10% 50V | 2.2uF ± 10% 50V
| | Footprint | C0603 | C0603 | C0603
| | Ibis Model
| | Library Name | VESC_MotorController.SCHLIB | VESC_MotorController.SCHLIB | VESC_MotorController.SCHLIB
| | Library Reference | 2.2uF ± 10% 50V | 2.2uF ± 10% 50V | 2.2uF ± 10% 50V
| | Manufacturer | Yageo | Yageo | Yageo
| | Manufacturer Part Number | GRM188R61H225ME11J | GRM188R61H225ME11J | GRM188R61H225ME11J
| | PCB3D
| | Pin Info
| | Price | 0.3 | 0.3 | 0.3
| | Signal Integrity
| | Simulation
| | Supplier | mouser | mouser | mouser
| | Supplier Part Number | 81-GRM188R61H225ME1J | 81-GRM188R61H225ME1J | 81-GRM188R61H225ME1J
| | Value | 2.2uF | 2.2uF | 2.2uF
C79 | Controller.SchDoc | | Fitted | Fitted | Fitted
| | Comment | 2.2uF | 2.2uF | 2.2uF
| | Component Kind | Standard | Standard | Standard
| | Description | 2.2uF ± 10% 50V | 2.2uF ± 10% 50V | 2.2uF ± 10% 50V
| | Footprint | C0603 | C0603 | C0603
| | Ibis Model
| | Library Name | VESC_MotorController.SCHLIB | VESC_MotorController.SCHLIB | VESC_MotorController.SCHLIB
| | Library Reference | 2.2uF ± 10% 50V | 2.2uF ± 10% 50V | 2.2uF ± 10% 50V
| | Manufacturer | Yageo | Yageo | Yageo
| | Manufacturer Part Number | GRM188R61H225ME11J | GRM188R61H225ME11J | GRM188R61H225ME11J
| | PCB3D
| | Pin Info
| | Price | 0.3 | 0.3 | 0.3
| | Signal Integrity
| | Simulation
| | Supplier | mouser | mouser | mouser
| | Supplier Part Number | 81-GRM188R61H225ME1J | 81-GRM188R61H225ME1J | 81-GRM188R61H225ME1J
| | Value | 2.2uF | 2.2uF | 2.2uF
C80 | Controller.SchDoc | | Fitted | Fitted | Fitted
| | Comment | 100uF | 100uF | 100uF
| | Component Kind | Standard | Standard | Standard
| | Description | 100uF ± 10% 25V | 100uF ± 10% 25V | 100uF ± 10% 25V
| | Footprint | CAPPRD225W50D680H1250 | CAPPRD225W50D680H1250 | CAPPRD225W50D680H1250
| | Ibis Model
| | Library Name | VESC_MotorController.SCHLIB | VESC_MotorController.SCHLIB | VESC_MotorController.SCHLIB
| | Library Reference | 100uF ± 10% 25V | 100uF ± 10% 25V | 100uF ± 10% 25V
| | Manufacturer | Lelon | Lelon | Lelon
| | Manufacturer Part Number | RGA101M1EBK-0611G | RGA101M1EBK-0611G | RGA101M1EBK-0611G
| | PCB3D
| | Pin Info
| | Price | 0.17 | 0.17 | 0.17
| | Signal Integrity
| | Simulation
| | Supplier | mouser | mouser | mouser
| | Supplier Part Number | 140-RGA101M1EBK0611G | 140-RGA101M1EBK0611G | 140-RGA101M1EBK0611G
| | Value | 100uF | 100uF | 100uF
C81 | Controller.SchDoc | | Fitted | Fitted | Fitted
| | Comment | 2.2uF | 2.2uF | 2.2uF
| | Component Kind | Standard | Standard | Standard
| | Description | 2.2uF ± 10% 50V | 2.2uF ± 10% 50V | 2.2uF ± 10% 50V
| | Footprint | C0603 | C0603 | C0603
| | Ibis Model
| | Library Name | VESC_MotorController.SCHLIB | VESC_MotorController.SCHLIB | VESC_MotorController.SCHLIB
| | Library Reference | 2.2uF ± 10% 50V | 2.2uF ± 10% 50V | 2.2uF ± 10% 50V
| | Manufacturer | Yageo | Yageo | Yageo
| | Manufacturer Part Number | GRM188R61H225ME11J | GRM188R61H225ME11J | GRM188R61H225ME11J
| | PCB3D
| | Pin Info
| | Price | 0.3 | 0.3 | 0.3
| | Signal Integrity
| | Simulation
| | Supplier | mouser | mouser | mouser
| | Supplier Part Number | 81-GRM188R61H225ME1J | 81-GRM188R61H225ME1J | 81-GRM188R61H225ME1J
| | Value | 2.2uF | 2.2uF | 2.2uF
C82 | Controller.SchDoc | | Fitted | Fitted | Fitted
| | Comment | 2.2uF | 2.2uF | 2.2uF
| | Component Kind | Standard | Standard | Standard
| | Description | 2.2uF ± 10% 50V | 2.2uF ± 10% 50V | 2.2uF ± 10% 50V
| | Footprint | C0603 | C0603 | C0603
| | Ibis Model
| | Library Name | VESC_MotorController.SCHLIB | VESC_MotorController.SCHLIB | VESC_MotorController.SCHLIB
| | Library Reference | 2.2uF ± 10% 50V | 2.2uF ± 10% 50V | 2.2uF ± 10% 50V
| | Manufacturer | Yageo | Yageo | Yageo
| | Manufacturer Part Number | GRM188R61H225ME11J | GRM188R61H225ME11J | GRM188R61H225ME11J
| | PCB3D
| | Pin Info
| | Price | 0.3 | 0.3 | 0.3
| | Signal Integrity
| | Simulation
| | Supplier | mouser | mouser | mouser
| | Supplier Part Number | 81-GRM188R61H225ME1J | 81-GRM188R61H225ME1J | 81-GRM188R61H225ME1J
| | Value | 2.2uF | 2.2uF | 2.2uF
C83 | Controller.SchDoc | | Fitted | Fitted | Fitted
| | Comment | 100uF | 100uF | 100uF
| | Component Kind | Standard | Standard | Standard
| | Description | 100uF ± 10% 25V | 100uF ± 10% 25V | 100uF ± 10% 25V
| | Footprint | CAPPRD225W50D680H1250 | CAPPRD225W50D680H1250 | CAPPRD225W50D680H1250
| | Ibis Model
| | Library Name | VESC_MotorController.SCHLIB | VESC_MotorController.SCHLIB | VESC_MotorController.SCHLIB
| | Library Reference | 100uF ± 10% 25V | 100uF ± 10% 25V | 100uF ± 10% 25V
| | Manufacturer | Lelon | Lelon | Lelon
| | Manufacturer Part Number | RGA101M1EBK-0611G | RGA101M1EBK-0611G | RGA101M1EBK-0611G
| | PCB3D
| | Pin Info
| | Price | 0.17 | 0.17 | 0.17
| | Signal Integrity
| | Simulation
| | Supplier | mouser | mouser | mouser
| | Supplier Part Number | 140-RGA101M1EBK0611G | 140-RGA101M1EBK0611G | 140-RGA101M1EBK0611G
| | Value | 100uF | 100uF | 100uF
C84 | Controller.SchDoc | | Fitted | Fitted | Fitted
| | Comment | 2.2uF | 2.2uF | 2.2uF
| | Component Kind | Standard | Standard | Standard
| | Description | 2.2uF ± 10% 50V | 2.2uF ± 10% 50V | 2.2uF ± 10% 50V
| | Footprint | C0603 | C0603 | C0603
| | Ibis Model
| | Library Name | VESC_MotorController.SCHLIB | VESC_MotorController.SCHLIB | VESC_MotorController.SCHLIB
| | Library Reference | 2.2uF ± 10% 50V | 2.2uF ± 10% 50V | 2.2uF ± 10% 50V
| | Manufacturer | Yageo | Yageo | Yageo
| | Manufacturer Part Number | GRM188R61H225ME11J | GRM188R61H225ME11J | GRM188R61H225ME11J
| | PCB3D
| | Pin Info
| | Price | 0.3 | 0.3 | 0.3
| | Signal Integrity
| | Simulation
| | Supplier | mouser | mouser | mouser
| | Supplier Part Number | 81-GRM188R61H225ME1J | 81-GRM188R61H225ME1J | 81-GRM188R61H225ME1J
| | Value | 2.2uF | 2.2uF | 2.2uF
C85 | Controller.SchDoc | | Fitted | Fitted | Fitted
| | Comment | 2.2uF | 2.2uF | 2.2uF
| | Component Kind | Standard | Standard | Standard
| | Description | 2.2uF ± 10% 50V | 2.2uF ± 10% 50V | 2.2uF ± 10% 50V
| | Footprint | C0603 | C0603 | C0603
| | Ibis Model
| | Library Name | VESC_MotorController.SCHLIB | VESC_MotorController.SCHLIB | VESC_MotorController.SCHLIB
| | Library Reference | 2.2uF ± 10% 50V | 2.2uF ± 10% 50V | 2.2uF ± 10% 50V
| | Manufacturer | Yageo | Yageo | Yageo
| | Manufacturer Part Number | GRM188R61H225ME11J | GRM188R61H225ME11J | GRM188R61H225ME11J
| | PCB3D
| | Pin Info
| | Price | 0.3 | 0.3 | 0.3
| | Signal Integrity
| | Simulation
| | Supplier | mouser | mouser | mouser
| | Supplier Part Number | 81-GRM188R61H225ME1J | 81-GRM188R61H225ME1J | 81-GRM188R61H225ME1J
| | Value | 2.2uF | 2.2uF | 2.2uF
C86 | Controller.SchDoc | | Fitted | Fitted | Fitted
| | Comment | 2.2uF | 2.2uF | 2.2uF
| | Component Kind | Standard | Standard | Standard
| | Description | 2.2uF ± 10% 50V | 2.2uF ± 10% 50V | 2.2uF ± 10% 50V
| | Footprint | C0603 | C0603 | C0603
| | Ibis Model
| | Library Name | VESC_MotorController.SCHLIB | VESC_MotorController.SCHLIB | VESC_MotorController.SCHLIB
| | Library Reference | 2.2uF ± 10% 50V | 2.2uF ± 10% 50V | 2.2uF ± 10% 50V
| | Manufacturer | Yageo | Yageo | Yageo
| | Manufacturer Part Number | GRM188R61H225ME11J | GRM188R61H225ME11J | GRM188R61H225ME11J
| | PCB3D
| | Pin Info
| | Price | 0.3 | 0.3 | 0.3
| | Signal Integrity
| | Simulation
| | Supplier | mouser | mouser | mouser
| | Supplier Part Number | 81-GRM188R61H225ME1J | 81-GRM188R61H225ME1J | 81-GRM188R61H225ME1J
| | Value | 2.2uF | 2.2uF | 2.2uF
C87 | Controller.SchDoc | | Fitted | Fitted | Fitted
| | Comment | 15pF | 15pF | 15pF
| | Component Kind | Standard | Standard | Standard
| | Description | 15pF ± 10% 50V | 15pF ± 10% 50V | 15pF ± 10% 50V
| | Footprint | C0402 | C0402 | C0402
| | Ibis Model
| | Library Name | VESC_MotorController.SCHLIB | VESC_MotorController.SCHLIB | VESC_MotorController.SCHLIB
| | Library Reference | 15pF ± 10% 50V | 15pF ± 10% 50V | 15pF ± 10% 50V
| | Manufacturer | Yageo | Yageo | Yageo
| | Manufacturer Part Number | CS0603KRX79BB150 | CS0603KRX79BB150 | CS0603KRX79BB150
| | PCB3D
| | Pin Info
| | Price | 0.1 | 0.1 | 0.1
| | Signal Integrity
| | Simulation
| | Supplier | mouser | mouser | mouser
| | Supplier Part Number | 603-CS0603KRX79BB150 | 603-CS0603KRX79BB150 | 603-CS0603KRX79BB150
| | Value | 15pF | 15pF | 15pF
C88 | Controller.SchDoc | | Fitted | Fitted | Fitted
| | Comment | 2.2uF | 2.2uF | 2.2uF
| | Component Kind | Standard | Standard | Standard
| | Description | 2.2uF ± 10% 50V | 2.2uF ± 10% 50V | 2.2uF ± 10% 50V
| | Footprint | C0603 | C0603 | C0603
| | Ibis Model
| | Library Name | VESC_MotorController.SCHLIB | VESC_MotorController.SCHLIB | VESC_MotorController.SCHLIB
| | Library Reference | 2.2uF ± 10% 50V | 2.2uF ± 10% 50V | 2.2uF ± 10% 50V
| | Manufacturer | Yageo | Yageo | Yageo
| | Manufacturer Part Number | GRM188R61H225ME11J | GRM188R61H225ME11J | GRM188R61H225ME11J
| | PCB3D
| | Pin Info
| | Price | 0.3 | 0.3 | 0.3
| | Signal Integrity
| | Simulation
| | Supplier | mouser | mouser | mouser
| | Supplier Part Number | 81-GRM188R61H225ME1J | 81-GRM188R61H225ME1J | 81-GRM188R61H225ME1J
| | Value | 2.2uF | 2.2uF | 2.2uF
C89 | Controller.SchDoc | | Fitted | Fitted | Fitted
| | Comment | 2.2uF | 2.2uF | 2.2uF
| | Component Kind | Standard | Standard | Standard
| | Description | 2.2uF ± 10% 50V | 2.2uF ± 10% 50V | 2.2uF ± 10% 50V
| | Footprint | C0603 | C0603 | C0603
| | Ibis Model
| | Library Name | VESC_MotorController.SCHLIB | VESC_MotorController.SCHLIB | VESC_MotorController.SCHLIB
| | Library Reference | 2.2uF ± 10% 50V | 2.2uF ± 10% 50V | 2.2uF ± 10% 50V
| | Manufacturer | Yageo | Yageo | Yageo
| | Manufacturer Part Number | GRM188R61H225ME11J | GRM188R61H225ME11J | GRM188R61H225ME11J
| | PCB3D
| | Pin Info
| | Price | 0.3 | 0.3 | 0.3
| | Signal Integrity
| | Simulation
| | Supplier | mouser | mouser | mouser
| | Supplier Part Number | 81-GRM188R61H225ME1J | 81-GRM188R61H225ME1J | 81-GRM188R61H225ME1J
| | Value | 2.2uF | 2.2uF | 2.2uF
C90 | Controller.SchDoc | | Fitted | Fitted | Fitted
| | Comment | 2.2uF | 2.2uF | 2.2uF
| | Component Kind | Standard | Standard | Standard
| | Description | 2.2uF ± 10% 50V | 2.2uF ± 10% 50V | 2.2uF ± 10% 50V
| | Footprint | C0603 | C0603 | C0603
| | Ibis Model
| | Library Name | VESC_MotorController.SCHLIB | VESC_MotorController.SCHLIB | VESC_MotorController.SCHLIB
| | Library Reference | 2.2uF ± 10% 50V | 2.2uF ± 10% 50V | 2.2uF ± 10% 50V
| | Manufacturer | Yageo | Yageo | Yageo
| | Manufacturer Part Number | GRM188R61H225ME11J | GRM188R61H225ME11J | GRM188R61H225ME11J
| | PCB3D
| | Pin Info
| | Price | 0.3 | 0.3 | 0.3
| | Signal Integrity
| | Simulation
| | Supplier | mouser | mouser | mouser
| | Supplier Part Number | 81-GRM188R61H225ME1J | 81-GRM188R61H225ME1J | 81-GRM188R61H225ME1J
| | Value | 2.2uF | 2.2uF | 2.2uF
C91 | Controller.SchDoc | | Fitted | Fitted | Fitted
| | Comment | 2.2uF | 2.2uF | 2.2uF
| | Component Kind | Standard | Standard | Standard
| | Description | 2.2uF ± 10% 50V | 2.2uF ± 10% 50V | 2.2uF ± 10% 50V
| | Footprint | C0603 | C0603 | C0603
| | Ibis Model
| | Library Name | VESC_MotorController.SCHLIB | VESC_MotorController.SCHLIB | VESC_MotorController.SCHLIB
| | Library Reference | 2.2uF ± 10% 50V | 2.2uF ± 10% 50V | 2.2uF ± 10% 50V
| | Manufacturer | Yageo | Yageo | Yageo
| | Manufacturer Part Number | GRM188R61H225ME11J | GRM188R61H225ME11J | GRM188R61H225ME11J
| | PCB3D
| | Pin Info
| | Price | 0.3 | 0.3 | 0.3
| | Signal Integrity
| | Simulation
| | Supplier | mouser | mouser | mouser
| | Supplier Part Number | 81-GRM188R61H225ME1J | 81-GRM188R61H225ME1J | 81-GRM188R61H225ME1J
| | Value | 2.2uF | 2.2uF | 2.2uF
C92 | Controller.SchDoc | | Fitted | Fitted | Fitted
| | Comment | 100nF | 100nF | 100nF
| | Component Kind | Standard | Standard | Standard
| | Description | 100nF ± 10% 50V | 100nF ± 10% 50V | 100nF ± 10% 50V
| | Footprint | C0402 | C0402 | C0402
| | Ibis Model
| | Library Name | VESC_MotorController.SCHLIB | VESC_MotorController.SCHLIB | VESC_MotorController.SCHLIB
| | Library Reference | 100nF ± 10% 50V | 100nF ± 10% 50V | 100nF ± 10% 50V
| | Manufacturer | Yageo | Yageo | Yageo
| | Manufacturer Part Number | CS0603KRX7R9BB104 | CS0603KRX7R9BB104 | CS0603KRX7R9BB104
| | PCB3D
| | Pin Info
| | Price | 0.1 | 0.1 | 0.1
| | Signal Integrity
| | Simulation
| | Supplier | mouser | mouser | mouser
| | Supplier Part Number | 603-CS0603KRX79BB104 | 603-CS0603KRX79BB104 | 603-CS0603KRX79BB104
| | Value | 100nF | 100nF | 100nF
C93 | Controller.SchDoc | | Fitted | Fitted | Fitted
| | Comment | 15pF | 15pF | 15pF
| | Component Kind | Standard | Standard | Standard
| | Description | 15pF ± 10% 50V | 15pF ± 10% 50V | 15pF ± 10% 50V
| | Footprint | C0402 | C0402 | C0402
| | Ibis Model
| | Library Name | VESC_MotorController.SCHLIB | VESC_MotorController.SCHLIB | VESC_MotorController.SCHLIB
| | Library Reference | 15pF ± 10% 50V | 15pF ± 10% 50V | 15pF ± 10% 50V
| | Manufacturer | Yageo | Yageo | Yageo
| | Manufacturer Part Number | CS0603KRX79BB150 | CS0603KRX79BB150 | CS0603KRX79BB150
| | PCB3D
| | Pin Info
| | Price | 0.1 | 0.1 | 0.1
| | Signal Integrity
| | Simulation
| | Supplier | mouser | mouser | mouser
| | Supplier Part Number | 603-CS0603KRX79BB150 | 603-CS0603KRX79BB150 | 603-CS0603KRX79BB150
| | Value | 15pF | 15pF | 15pF
C94 | Controller.SchDoc | | Fitted | Fitted | Fitted
| | Comment | 100nF | 100nF | 100nF
| | Component Kind | Standard | Standard | Standard
| | Description | 100nF ± 10% 50V | 100nF ± 10% 50V | 100nF ± 10% 50V
| | Footprint | C0402 | C0402 | C0402
| | Ibis Model
| | Library Name | VESC_MotorController.SCHLIB | VESC_MotorController.SCHLIB | VESC_MotorController.SCHLIB
| | Library Reference | 100nF ± 10% 50V | 100nF ± 10% 50V | 100nF ± 10% 50V
| | Manufacturer | Yageo | Yageo | Yageo
| | Manufacturer Part Number | CS0603KRX7R9BB104 | CS0603KRX7R9BB104 | CS0603KRX7R9BB104
| | PCB3D
| | Pin Info
| | Price | 0.1 | 0.1 | 0.1
| | Signal Integrity
| | Simulation
| | Supplier | mouser | mouser | mouser
| | Supplier Part Number | 603-CS0603KRX79BB104 | 603-CS0603KRX79BB104 | 603-CS0603KRX79BB104
| | Value | 100nF | 100nF | 100nF
D1 | PowerBoard.SchDoc | | Fitted | Fitted | Fitted
| | Comment | SS115 | SS115 | SS115
| | Component Kind | Standard | Standard | Standard
| | Description | Schottky Diodes & Rectifiers 1A, 150V, Schottky Rectifier | Schottky Diodes & Rectifiers 1A, 150V, Schottky Rectifier | Schottky Diodes & Rectifiers 1A, 150V, Schottky Rectifier
| | Footprint | DIOM4325X250N | DIOM4325X250N | DIOM4325X250N
| | Ibis Model
| | Library Name | VESC_MotorController.SCHLIB | VESC_MotorController.SCHLIB | VESC_MotorController.SCHLIB
| | Library Reference | SS115 | SS115 | SS115
| | Manufacturer | Taiwan Semiconductor | Taiwan Semiconductor | Taiwan Semiconductor
| | Manufacturer Part Number | SS115 | SS115 | SS115
| | PCB3D
| | Pin Info
| | Price | 0.34 | 0.34 | 0.34
| | Signal Integrity
| | Simulation
| | Supplier | Mouser | Mouser | Mouser
| | Supplier Part Number | 821-SS115 | 821-SS115 | 821-SS115
| | Value | 1A, 150V | 1A, 150V | 1A, 150V
D2 | PowerBoard.SchDoc | | Fitted | Not Fitted | Fitted
| | Comment | B140HW-7 | | B140HW-7
| | Component Kind | Standard | | Standard
| | Description | Schottky Diodes & Rectifiers 1A, 40V | | Schottky Diodes & Rectifiers 1A, 40V
| | Footprint | SOD123 | | SOD123
| | Ibis Model
| | Library Name | VESC_MotorController.SCHLIB | | VESC_MotorController.SCHLIB
| | Library Reference | B140HW-7 | | B140HW-7
| | Manufacturer | Diodes | | Diodes
| | Manufacturer Part Number | B140HW-7 | | B140HW-7
| | PCB3D
| | Pin Info
| | Price | 0.42 | | 0.42
| | Signal Integrity
| | Simulation
| | Supplier | Mouser | | Mouser
| | Supplier Part Number | 621-B140HW-7 | | 621-B140HW-7
| | Value | B140HW-7 | | B140HW-7
D3 | PowerBoard.SchDoc | | Fitted | Not Fitted | Fitted
| | Comment | B140HW-7 | | B140HW-7
| | Component Kind | Standard | | Standard
| | Description | Schottky Diodes & Rectifiers 1A, 40V | | Schottky Diodes & Rectifiers 1A, 40V
| | Footprint | SOD123 | | SOD123
| | Ibis Model
| | Library Name | VESC_MotorController.SCHLIB | | VESC_MotorController.SCHLIB
| | Library Reference | B140HW-7 | | B140HW-7
| | Manufacturer | Diodes | | Diodes
| | Manufacturer Part Number | B140HW-7 | | B140HW-7
| | PCB3D
| | Pin Info
| | Price | 0.42 | | 0.42
| | Signal Integrity
| | Simulation
| | Supplier | Mouser | | Mouser
| | Supplier Part Number | 621-B140HW-7 | | 621-B140HW-7
| | Value | B140HW-7 | | B140HW-7
D4 | PowerBoard.SchDoc | | Fitted | Not Fitted | Fitted
| | Comment | SS115 | | SS115
| | Component Kind | Standard | | Standard
| | Description | Schottky Diodes & Rectifiers 1A, 150V, Schottky Rectifier | | Schottky Diodes & Rectifiers 1A, 150V, Schottky Rectifier
| | Footprint | DIOM4325X250N | | DIOM4325X250N
| | Ibis Model
| | Library Name | VESC_MotorController.SCHLIB | | VESC_MotorController.SCHLIB
| | Library Reference | SS115 | | SS115
| | Manufacturer | Taiwan Semiconductor | | Taiwan Semiconductor
| | Manufacturer Part Number | SS115 | | SS115
| | PCB3D
| | Pin Info
| | Price | 0.34 | | 0.34
| | Signal Integrity
| | Simulation
| | Supplier | Mouser | | Mouser
| | Supplier Part Number | 821-SS115 | | 821-SS115
| | Value | 1A, 150V | | 1A, 150V
D5 | PowerBoard.SchDoc | | Fitted | Not Fitted | Fitted
| | Comment | B140HW-7 | | B140HW-7
| | Component Kind | Standard | | Standard
| | Description | Schottky Diodes & Rectifiers 1A, 40V | | Schottky Diodes & Rectifiers 1A, 40V
| | Footprint | SOD123 | | SOD123
| | Ibis Model
| | Library Name | VESC_MotorController.SCHLIB | | VESC_MotorController.SCHLIB
| | Library Reference | B140HW-7 | | B140HW-7
| | Manufacturer | Diodes | | Diodes
| | Manufacturer Part Number | B140HW-7 | | B140HW-7
| | PCB3D
| | Pin Info
| | Price | 0.42 | | 0.42
| | Signal Integrity
| | Simulation
| | Supplier | Mouser | | Mouser
| | Supplier Part Number | 621-B140HW-7 | | 621-B140HW-7
| | Value | B140HW-7 | | B140HW-7
D6 | PowerBoard.SchDoc | | Fitted | Fitted | Fitted
| | Comment | B140HW-7 | B140HW-7 | B140HW-7
| | Component Kind | Standard | Standard | Standard
| | Description | Schottky Diodes & Rectifiers 1A, 40V | Schottky Diodes & Rectifiers 1A, 40V | Schottky Diodes & Rectifiers 1A, 40V
| | Footprint | SOD123 | SOD123 | SOD123
| | Ibis Model
| | Library Name | VESC_MotorController.SCHLIB | VESC_MotorController.SCHLIB | VESC_MotorController.SCHLIB
| | Library Reference | B140HW-7 | B140HW-7 | B140HW-7
| | Manufacturer | Diodes | Diodes | Diodes
| | Manufacturer Part Number | B140HW-7 | B140HW-7 | B140HW-7
| | PCB3D
| | Pin Info
| | Price | 0.42 | 0.42 | 0.42
| | Signal Integrity
| | Simulation
| | Supplier | Mouser | Mouser | Mouser
| | Supplier Part Number | 621-B140HW-7 | 621-B140HW-7 | 621-B140HW-7
| | Value | B140HW-7 | B140HW-7 | B140HW-7
D7 | PowerBoard.SchDoc | | Fitted | Fitted | Fitted
| | Comment | SS115 | SS115 | SS115
| | Component Kind | Standard | Standard | Standard
| | Description | Schottky Diodes & Rectifiers 1A, 150V, Schottky Rectifier | Schottky Diodes & Rectifiers 1A, 150V, Schottky Rectifier | Schottky Diodes & Rectifiers 1A, 150V, Schottky Rectifier
| | Footprint | DIOM4325X250N | DIOM4325X250N | DIOM4325X250N
| | Ibis Model
| | Library Name | VESC_MotorController.SCHLIB | VESC_MotorController.SCHLIB | VESC_MotorController.SCHLIB
| | Library Reference | SS115 | SS115 | SS115
| | Manufacturer | Taiwan Semiconductor | Taiwan Semiconductor | Taiwan Semiconductor
| | Manufacturer Part Number | SS115 | SS115 | SS115
| | PCB3D
| | Pin Info
| | Price | 0.34 | 0.34 | 0.34
| | Signal Integrity
| | Simulation
| | Supplier | Mouser | Mouser | Mouser
| | Supplier Part Number | 821-SS115 | 821-SS115 | 821-SS115
| | Value | 1A, 150V | 1A, 150V | 1A, 150V
D8 | PowerBoard.SchDoc | | Fitted | Fitted | Fitted
| | Comment | B140HW-7 | B140HW-7 | B140HW-7
| | Component Kind | Standard | Standard | Standard
| | Description | Schottky Diodes & Rectifiers 1A, 40V | Schottky Diodes & Rectifiers 1A, 40V | Schottky Diodes & Rectifiers 1A, 40V
| | Footprint | SOD123 | SOD123 | SOD123
| | Ibis Model
| | Library Name | VESC_MotorController.SCHLIB | VESC_MotorController.SCHLIB | VESC_MotorController.SCHLIB
| | Library Reference | B140HW-7 | B140HW-7 | B140HW-7
| | Manufacturer | Diodes | Diodes | Diodes
| | Manufacturer Part Number | B140HW-7 | B140HW-7 | B140HW-7
| | PCB3D
| | Pin Info
| | Price | 0.42 | 0.42 | 0.42
| | Signal Integrity
| | Simulation
| | Supplier | Mouser | Mouser | Mouser
| | Supplier Part Number | 621-B140HW-7 | 621-B140HW-7 | 621-B140HW-7
| | Value | B140HW-7 | B140HW-7 | B140HW-7
D9 | PowerBoard.SchDoc | | Fitted | Fitted | Fitted
| | Comment | B140HW-7 | B140HW-7 | B140HW-7
| | Component Kind | Standard | Standard | Standard
| | Description | Schottky Diodes & Rectifiers 1A, 40V | Schottky Diodes & Rectifiers 1A, 40V | Schottky Diodes & Rectifiers 1A, 40V
| | Footprint | SOD123 | SOD123 | SOD123
| | Ibis Model
| | Library Name | VESC_MotorController.SCHLIB | VESC_MotorController.SCHLIB | VESC_MotorController.SCHLIB
| | Library Reference | B140HW-7 | B140HW-7 | B140HW-7
| | Manufacturer | Diodes | Diodes | Diodes
| | Manufacturer Part Number | B140HW-7 | B140HW-7 | B140HW-7
| | PCB3D
| | Pin Info
| | Price | 0.42 | 0.42 | 0.42
| | Signal Integrity
| | Simulation
| | Supplier | Mouser | Mouser | Mouser
| | Supplier Part Number | 621-B140HW-7 | 621-B140HW-7 | 621-B140HW-7
| | Value | B140HW-7 | B140HW-7 | B140HW-7
D10 | Controller.SchDoc | | Fitted | Fitted | Fitted
| | Comment | FKR1113F-TR | FKR1113F-TR | FKR1113F-TR
| | Component Kind | Standard | Standard | Standard
| | Description | R/A LED | R/A LED | R/A LED
| | Footprint | VCDG1113F4BY3CTR | VCDG1113F4BY3CTR | VCDG1113F4BY3CTR
| | Ibis Model
| | Library Name | VESC_MotorController.SCHLIB | VESC_MotorController.SCHLIB | VESC_MotorController.SCHLIB
| | Library Reference | LED_RED | LED_RED | LED_RED
| | Manufacturer | Stanley Electric | Stanley Electric | Stanley Electric
| | Manufacturer Part Number | FKR1113F-TR | FKR1113F-TR | FKR1113F-TR
| | PCB3D
| | Pin Info
| | Price | 0.78 | 0.78 | 0.78
| | Signal Integrity
| | Simulation
| | Supplier | Mouser | Mouser | Mouser
| | Supplier Part Number | 327-FKR1113FTR | 327-FKR1113FTR | 327-FKR1113FTR
| | Value | Red | Red | Red
D11 | Controller.SchDoc | | Fitted | Fitted | Fitted
| | Comment | VCDG1113F-4BY3C-TR | VCDG1113F-4BY3C-TR | VCDG1113F-4BY3C-TR
| | Component Kind | Standard | Standard | Standard
| | Description | R/A LED | R/A LED | R/A LED
| | Footprint | VCDG1113F4BY3CTR | VCDG1113F4BY3CTR | VCDG1113F4BY3CTR
| | Ibis Model
| | Library Name | VESC_MotorController.SCHLIB | VESC_MotorController.SCHLIB | VESC_MotorController.SCHLIB
| | Library Reference | LED_GREEN | LED_GREEN | LED_GREEN
| | Manufacturer | Stanley Electric | Stanley Electric | Stanley Electric
| | Manufacturer Part Number | VCDG1113F-4BY3C-TR | VCDG1113F-4BY3C-TR | VCDG1113F-4BY3C-TR
| | PCB3D
| | Pin Info
| | Price | 0.78 | 0.78 | 0.78
| | Signal Integrity
| | Simulation
| | Supplier | Mouser | Mouser | Mouser
| | Supplier Part Number | 327-VCDG1113F4BY3CTR | 327-VCDG1113F4BY3CTR | 327-VCDG1113F4BY3CTR
| | Value | Green | Green | Green
D12 | Controller.SchDoc | | Fitted | Fitted | Fitted
| | Comment | FKR1113F-TR | FKR1113F-TR | FKR1113F-TR
| | Component Kind | Standard | Standard | Standard
| | Description | R/A LED | R/A LED | R/A LED
| | Footprint | VCDG1113F4BY3CTR | VCDG1113F4BY3CTR | VCDG1113F4BY3CTR
| | Ibis Model
| | Library Name | VESC_MotorController.SCHLIB | VESC_MotorController.SCHLIB | VESC_MotorController.SCHLIB
| | Library Reference | LED_YELLOW | LED_YELLOW | LED_YELLOW
| | Manufacturer | Stanley Electric | Stanley Electric | Stanley Electric
| | Manufacturer Part Number | FKY1113F-TR | FKY1113F-TR | FKY1113F-TR
| | PCB3D
| | Pin Info
| | Price | 0.78 | 0.78 | 0.78
| | Signal Integrity
| | Simulation
| | Supplier | Mouser | Mouser | Mouser
| | Supplier Part Number | 327-FKY1113FTR | 327-FKY1113FTR | 327-FKY1113FTR
| | Value | Yellow | Yellow | Yellow
FL | Controller.SchDoc | | Fitted | Fitted | Fitted
| | Comment | BLM18AG102SN1D | BLM18AG102SN1D | BLM18AG102SN1D
| | Component Kind | Standard | Standard | Standard
| | Description | Ferrite Beads 1000 OHM 25% Alternate Sizing Guide Below | Ferrite Beads 1000 OHM 25% Alternate Sizing Guide Below | Ferrite Beads 1000 OHM 25% Alternate Sizing Guide Below
| | Footprint | BLM18EG121SH1D | BLM18EG121SH1D | BLM18EG121SH1D
| | Ibis Model
| | Library Name | VESC_MotorController.SCHLIB | VESC_MotorController.SCHLIB | VESC_MotorController.SCHLIB
| | Library Reference | BLM18AG102SN1D | BLM18AG102SN1D | BLM18AG102SN1D
| | Manufacturer | Murata | Murata | Murata
| | Manufacturer Part Number | BLM18AG102SN1D | BLM18AG102SN1D | BLM18AG102SN1D
| | PCB3D
| | Pin Info
| | Price | 0.15 | 0.15 | 0.15
| | Signal Integrity
| | Simulation
| | Supplier | Mouser | Mouser | Mouser
| | Supplier Part Number | 81-BLM11A102S | 81-BLM11A102S | 81-BLM11A102S
| | Value | BLM18AG102SN1D | BLM18AG102SN1D | BLM18AG102SN1D
J1 | PowerBoard.SchDoc | | Fitted | Fitted | Fitted
| | Comment | PHASE_U | PHASE_U | PHASE_U
| | Component Kind | Standard | Standard | Standard
| | Description | WR-PHD 2.54mm Dual Pin Header THT 06p Wurth Elektronik WR-PHD Series, Series Number 6130, 2.54mm Pitch 6 Way 2 Row Straight PCB Header, Solder Termination | WR-PHD 2.54mm Dual Pin Header THT 06p Wurth Elektronik WR-PHD Series, Series Number 6130, 2.54mm Pitch 6 Way 2 Row Straight PCB Header, Solder Termination | WR-PHD 2.54mm Dual Pin Header THT 06p Wurth Elektronik WR-PHD Series, Series Number 6130, 2.54mm Pitch 6 Way 2 Row Straight PCB Header, Solder Termination
| | Footprint | 61300621121 | 61300621121 | 61300621121
| | Ibis Model
| | Library Name | VESC_MotorController.SCHLIB | VESC_MotorController.SCHLIB | VESC_MotorController.SCHLIB
| | Library Reference | Header 6 Pin_2 | Header 6 Pin_2 | Header 6 Pin_2
| | Manufacturer | Wurth Elektronik | Wurth Elektronik | Wurth Elektronik
| | Manufacturer Part Number | 61300621121 | 61300621121 | 61300621121
| | PCB3D
| | Pin Info
| | Price | 0.57 | 0.57 | 0.57
| | Signal Integrity
| | Simulation
| | Supplier | Mouser | Mouser | Mouser
| | Supplier Part Number | 710-61300621121 | 710-61300621121 | 710-61300621121
| | Value | 61300621121 | 61300621121 | 61300621121
J2 | PowerBoard.SchDoc | | Fitted | Fitted | Fitted
| | Category | REDCUBE THR | REDCUBE THR | REDCUBE THR
| | Comment | 74651194R | 74651194R | 74651194R
| | Component Kind | Standard | Standard | Standard
| | ComponentLink1Description | Website Link | Website Link | Website Link
| | ComponentLink1URL | https://www.we-online.com/redexpert/article/74651194R?ad | https://www.we-online.com/redexpert/article/74651194R?ad | https://www.we-online.com/redexpert/article/74651194R?ad
| | ComponentLink2Description | Datasheet Link | Datasheet Link | Datasheet Link
| | ComponentLink2URL | https://www.we-online.com/redexpert/spec/74651194R?ad | https://www.we-online.com/redexpert/spec/74651194R?ad | https://www.we-online.com/redexpert/spec/74651194R?ad
| | Description | WP-THRSH REDCUBE THR with external thread, M4 x 5mm, 85A | WP-THRSH REDCUBE THR with external thread, M4 x 5mm, 85A | WP-THRSH REDCUBE THR with external thread, M4 x 5mm, 85A
| | Footprint | 74651194 | 74651194 | 74651194
| | Height | 8.5mm | 8.5mm | 8.5mm
| | Ibis Model
| | Length | 10mm | 10mm | 10mm
| | Library Name | WP-THRSH.SchLib | WP-THRSH.SchLib | WP-THRSH.SchLib
| | Library Reference | 74651194R | 74651194R | 74651194R
| | Manufacturer | Wurth Elektronik | Wurth Elektronik | Wurth Elektronik
| | Manufacturer Part Number | 74651194R | 74651194R | 74651194R
| | Match Code | WP-THRSH | WP-THRSH | WP-THRSH
| | Material | Brass | Brass | Brass
| | Mount | Through Hole Reflow | Through Hole Reflow | Through Hole Reflow
| | Number of Pins | 9 | 9 | 9
| | Operating Temperature Max | 150°C | 150°C | 150°C
| | Operating Temperature Min | -55°C | -55°C | -55°C
| | Packaging | Tape and Reel | Tape and Reel | Tape and Reel
| | PCB3D
| | Pin Info
| | Price | 3.5 | 3.5 | 3.5
| | Rated Current | 85A | 85A | 85A
| | Signal Integrity
| | Simulation
| | Supplier | Mouser | Mouser | Mouser
| | Supplier Part Number | 710-74651195R | 710-74651195R | 710-74651195R
| | Surface | Tin | Tin | Tin
| | Thread Length | 5mm | 5mm | 5mm
| | Thread Size | M4 | M4 | M4
| | Value | 74651194R | 74651194R | 74651194R
| | Width | 10mm | 10mm | 10mm
J3 | PowerBoard.SchDoc | | Fitted | Fitted | Fitted
| | Category | REDCUBE THR | REDCUBE THR | REDCUBE THR
| | Comment | 74651194R | 74651194R | 74651194R
| | Component Kind | Standard | Standard | Standard
| | ComponentLink1Description | Website Link | Website Link | Website Link
| | ComponentLink1URL | https://www.we-online.com/redexpert/article/74651194R?ad | https://www.we-online.com/redexpert/article/74651194R?ad | https://www.we-online.com/redexpert/article/74651194R?ad
| | ComponentLink2Description | Datasheet Link | Datasheet Link | Datasheet Link
| | ComponentLink2URL | https://www.we-online.com/redexpert/spec/74651194R?ad | https://www.we-online.com/redexpert/spec/74651194R?ad | https://www.we-online.com/redexpert/spec/74651194R?ad
| | Description | WP-THRSH REDCUBE THR with external thread, M4 x 5mm, 85A | WP-THRSH REDCUBE THR with external thread, M4 x 5mm, 85A | WP-THRSH REDCUBE THR with external thread, M4 x 5mm, 85A
| | Footprint | 74651194 | 74651194 | 74651194
| | Height | 8.5mm | 8.5mm | 8.5mm
| | Ibis Model
| | Length | 10mm | 10mm | 10mm
| | Library Name | WP-THRSH.SchLib | WP-THRSH.SchLib | WP-THRSH.SchLib
| | Library Reference | 74651194R | 74651194R | 74651194R
| | Manufacturer | Wurth Elektronik | Wurth Elektronik | Wurth Elektronik
| | Manufacturer Part Number | 74651194R | 74651194R | 74651194R
| | Match Code | WP-THRSH | WP-THRSH | WP-THRSH
| | Material | Brass | Brass | Brass
| | Mount | Through Hole Reflow | Through Hole Reflow | Through Hole Reflow
| | Number of Pins | 9 | 9 | 9
| | Operating Temperature Max | 150°C | 150°C | 150°C
| | Operating Temperature Min | -55°C | -55°C | -55°C
| | Packaging | Tape and Reel | Tape and Reel | Tape and Reel
| | PCB3D
| | Pin Info
| | Price | 3.5 | 3.5 | 3.5
| | Rated Current | 85A | 85A | 85A
| | Signal Integrity
| | Simulation
| | Supplier | Mouser | Mouser | Mouser
| | Supplier Part Number | 710-74651195R | 710-74651195R | 710-74651195R
| | Surface | Tin | Tin | Tin
| | Thread Length | 5mm | 5mm | 5mm
| | Thread Size | M4 | M4 | M4
| | Value | 74651194R | 74651194R | 74651194R
| | Width | 10mm | 10mm | 10mm
J4 | PowerBoard.SchDoc | | Fitted | Fitted | Fitted
| | Comment | PHASE_V | PHASE_V | PHASE_V
| | Component Kind | Standard | Standard | Standard
| | Description | WR-PHD 2.54mm Dual Pin Header THT 06p Wurth Elektronik WR-PHD Series, Series Number 6130, 2.54mm Pitch 6 Way 2 Row Straight PCB Header, Solder Termination | WR-PHD 2.54mm Dual Pin Header THT 06p Wurth Elektronik WR-PHD Series, Series Number 6130, 2.54mm Pitch 6 Way 2 Row Straight PCB Header, Solder Termination | WR-PHD 2.54mm Dual Pin Header THT 06p Wurth Elektronik WR-PHD Series, Series Number 6130, 2.54mm Pitch 6 Way 2 Row Straight PCB Header, Solder Termination
| | Footprint | 61300621121 | 61300621121 | 61300621121
| | Ibis Model
| | Library Name | VESC_MotorController.SCHLIB | VESC_MotorController.SCHLIB | VESC_MotorController.SCHLIB
| | Library Reference | Header 6 Pin_2 | Header 6 Pin_2 | Header 6 Pin_2
| | Manufacturer | Wurth Elektronik | Wurth Elektronik | Wurth Elektronik
| | Manufacturer Part Number | 61300621121 | 61300621121 | 61300621121
| | PCB3D
| | Pin Info
| | Price | 0.57 | 0.57 | 0.57
| | Signal Integrity
| | Simulation
| | Supplier | Mouser | Mouser | Mouser
| | Supplier Part Number | 710-61300621121 | 710-61300621121 | 710-61300621121
| | Value | 61300621121 | 61300621121 | 61300621121
J5 | PowerBoard.SchDoc | | Fitted | Fitted | Fitted
| | Category | REDCUBE THR | REDCUBE THR | REDCUBE THR
| | Comment | 74651194R | 74651194R | 74651194R
| | Component Kind | Standard | Standard | Standard
| | ComponentLink1Description | Website Link | Website Link | Website Link
| | ComponentLink1URL | https://www.we-online.com/redexpert/article/74651194R?ad | https://www.we-online.com/redexpert/article/74651194R?ad | https://www.we-online.com/redexpert/article/74651194R?ad
| | ComponentLink2Description | Datasheet Link | Datasheet Link | Datasheet Link
| | ComponentLink2URL | https://www.we-online.com/redexpert/spec/74651194R?ad | https://www.we-online.com/redexpert/spec/74651194R?ad | https://www.we-online.com/redexpert/spec/74651194R?ad
| | Description | WP-THRSH REDCUBE THR with external thread, M4 x 5mm, 85A | WP-THRSH REDCUBE THR with external thread, M4 x 5mm, 85A | WP-THRSH REDCUBE THR with external thread, M4 x 5mm, 85A
| | Footprint | 74651194 | 74651194 | 74651194
| | Height | 8.5mm | 8.5mm | 8.5mm
| | Ibis Model
| | Length | 10mm | 10mm | 10mm
| | Library Name | WP-THRSH.SchLib | WP-THRSH.SchLib | WP-THRSH.SchLib
| | Library Reference | 74651194R | 74651194R | 74651194R
| | Manufacturer | Wurth Elektronik | Wurth Elektronik | Wurth Elektronik
| | Manufacturer Part Number | 74651194R | 74651194R | 74651194R
| | Match Code | WP-THRSH | WP-THRSH | WP-THRSH
| | Material | Brass | Brass | Brass
| | Mount | Through Hole Reflow | Through Hole Reflow | Through Hole Reflow
| | Number of Pins | 9 | 9 | 9
| | Operating Temperature Max | 150°C | 150°C | 150°C
| | Operating Temperature Min | -55°C | -55°C | -55°C
| | Packaging | Tape and Reel | Tape and Reel | Tape and Reel
| | PCB3D
| | Pin Info
| | Price | 3.5 | 3.5 | 3.5
| | Rated Current | 85A | 85A | 85A
| | Signal Integrity
| | Simulation
| | Supplier | Mouser | Mouser | Mouser
| | Supplier Part Number | 710-74651195R | 710-74651195R | 710-74651195R
| | Surface | Tin | Tin | Tin
| | Thread Length | 5mm | 5mm | 5mm
| | Thread Size | M4 | M4 | M4
| | Value | 74651194R | 74651194R | 74651194R
| | Width | 10mm | 10mm | 10mm
J6 | PowerBoard.SchDoc | | Fitted | Fitted | Fitted
| | Category | REDCUBE THR | REDCUBE THR | REDCUBE THR
| | Comment | 74651194R | 74651194R | 74651194R
| | Component Kind | Standard | Standard | Standard
| | ComponentLink1Description | Website Link | Website Link | Website Link
| | ComponentLink1URL | https://www.we-online.com/redexpert/article/74651194R?ad | https://www.we-online.com/redexpert/article/74651194R?ad | https://www.we-online.com/redexpert/article/74651194R?ad
| | ComponentLink2Description | Datasheet Link | Datasheet Link | Datasheet Link
| | ComponentLink2URL | https://www.we-online.com/redexpert/spec/74651194R?ad | https://www.we-online.com/redexpert/spec/74651194R?ad | https://www.we-online.com/redexpert/spec/74651194R?ad
| | Description | WP-THRSH REDCUBE THR with external thread, M4 x 5mm, 85A | WP-THRSH REDCUBE THR with external thread, M4 x 5mm, 85A | WP-THRSH REDCUBE THR with external thread, M4 x 5mm, 85A
| | Footprint | 74651194 | 74651194 | 74651194
| | Height | 8.5mm | 8.5mm | 8.5mm
| | Ibis Model
| | Length | 10mm | 10mm | 10mm
| | Library Name | WP-THRSH.SchLib | WP-THRSH.SchLib | WP-THRSH.SchLib
| | Library Reference | 74651194R | 74651194R | 74651194R
| | Manufacturer | Wurth Elektronik | Wurth Elektronik | Wurth Elektronik
| | Manufacturer Part Number | 74651194R | 74651194R | 74651194R
| | Match Code | WP-THRSH | WP-THRSH | WP-THRSH
| | Material | Brass | Brass | Brass
| | Mount | Through Hole Reflow | Through Hole Reflow | Through Hole Reflow
| | Number of Pins | 9 | 9 | 9
| | Operating Temperature Max | 150°C | 150°C | 150°C
| | Operating Temperature Min | -55°C | -55°C | -55°C
| | Packaging | Tape and Reel | Tape and Reel | Tape and Reel
| | PCB3D
| | Pin Info
| | Price | 3.5 | 3.5 | 3.5
| | Rated Current | 85A | 85A | 85A
| | Signal Integrity
| | Simulation
| | Supplier | Mouser | Mouser | Mouser
| | Supplier Part Number | 710-74651195R | 710-74651195R | 710-74651195R
| | Surface | Tin | Tin | Tin
| | Thread Length | 5mm | 5mm | 5mm
| | Thread Size | M4 | M4 | M4
| | Value | 74651194R | 74651194R | 74651194R
| | Width | 10mm | 10mm | 10mm
J7 | PowerBoard.SchDoc | | Fitted | Fitted | Fitted
| | Category | REDCUBE THR | REDCUBE THR | REDCUBE THR
| | Comment | 74651194R | 74651194R | 74651194R
| | Component Kind | Standard | Standard | Standard
| | ComponentLink1Description | Website Link | Website Link | Website Link
| | ComponentLink1URL | https://www.we-online.com/redexpert/article/74651194R?ad | https://www.we-online.com/redexpert/article/74651194R?ad | https://www.we-online.com/redexpert/article/74651194R?ad
| | ComponentLink2Description | Datasheet Link | Datasheet Link | Datasheet Link
| | ComponentLink2URL | https://www.we-online.com/redexpert/spec/74651194R?ad | https://www.we-online.com/redexpert/spec/74651194R?ad | https://www.we-online.com/redexpert/spec/74651194R?ad
| | Description | WP-THRSH REDCUBE THR with external thread, M4 x 5mm, 85A | WP-THRSH REDCUBE THR with external thread, M4 x 5mm, 85A | WP-THRSH REDCUBE THR with external thread, M4 x 5mm, 85A
| | Footprint | 74651194 | 74651194 | 74651194
| | Height | 8.5mm | 8.5mm | 8.5mm
| | Ibis Model
| | Length | 10mm | 10mm | 10mm
| | Library Name | WP-THRSH.SchLib | WP-THRSH.SchLib | WP-THRSH.SchLib
| | Library Reference | 74651194R | 74651194R | 74651194R
| | Manufacturer | Wurth Elektronik | Wurth Elektronik | Wurth Elektronik
| | Manufacturer Part Number | 74651194R | 74651194R | 74651194R
| | Match Code | WP-THRSH | WP-THRSH | WP-THRSH
| | Material | Brass | Brass | Brass
| | Mount | Through Hole Reflow | Through Hole Reflow | Through Hole Reflow
| | Number of Pins | 9 | 9 | 9
| | Operating Temperature Max | 150°C | 150°C | 150°C
| | Operating Temperature Min | -55°C | -55°C | -55°C
| | Packaging | Tape and Reel | Tape and Reel | Tape and Reel
| | PCB3D
| | Pin Info
| | Price | 3.5 | 3.5 | 3.5
| | Rated Current | 85A | 85A | 85A
| | Signal Integrity
| | Simulation
| | Supplier | Mouser | Mouser | Mouser
| | Supplier Part Number | 710-74651195R | 710-74651195R | 710-74651195R
| | Surface | Tin | Tin | Tin
| | Thread Length | 5mm | 5mm | 5mm
| | Thread Size | M4 | M4 | M4
| | Value | 74651194R | 74651194R | 74651194R
| | Width | 10mm | 10mm | 10mm
J8 | PowerBoard.SchDoc | | Fitted | Fitted | Fitted
| | Comment | Header 8 Pin_2 | Header 8 Pin_2 | Header 8 Pin_2
| | Component Kind | Standard | Standard | Standard
| | Description | Headers & Wire Housings WR-PHD 2.54mm Hdr 8P Dual Str Gold | Headers & Wire Housings WR-PHD 2.54mm Hdr 8P Dual Str Gold | Headers & Wire Housings WR-PHD 2.54mm Hdr 8P Dual Str Gold
| | Footprint | 61300821121 | 61300821121 | 61300821121
| | Ibis Model
| | Library Name | VESC_MotorController.SCHLIB | VESC_MotorController.SCHLIB | VESC_MotorController.SCHLIB
| | Library Reference | Header 8 Pin_2 | Header 8 Pin_2 | Header 8 Pin_2
| | Manufacturer | Wurth Elektronik | Wurth Elektronik | Wurth Elektronik
| | Manufacturer Part Number | 61300821121 | 61300821121 | 61300821121
| | PCB3D
| | Pin Info
| | Price | 0.7 | 0.7 | 0.7
| | Signal Integrity
| | Simulation
| | Supplier | Mouser | Mouser | Mouser
| | Supplier Part Number | 710-61300621121 | 710-61300621121 | 710-61300621121
| | Value | 61300821121 | 61300821121 | 61300821121
J9 | PowerBoard.SchDoc | | Fitted | Fitted | Fitted
| | Comment | PHASE_W | PHASE_W | PHASE_W
| | Component Kind | Standard | Standard | Standard
| | Description | WR-PHD 2.54mm Dual Pin Header THT 06p Wurth Elektronik WR-PHD Series, Series Number 6130, 2.54mm Pitch 6 Way 2 Row Straight PCB Header, Solder Termination | WR-PHD 2.54mm Dual Pin Header THT 06p Wurth Elektronik WR-PHD Series, Series Number 6130, 2.54mm Pitch 6 Way 2 Row Straight PCB Header, Solder Termination | WR-PHD 2.54mm Dual Pin Header THT 06p Wurth Elektronik WR-PHD Series, Series Number 6130, 2.54mm Pitch 6 Way 2 Row Straight PCB Header, Solder Termination
| | Footprint | 61300621121 | 61300621121 | 61300621121
| | Ibis Model
| | Library Name | VESC_MotorController.SCHLIB | VESC_MotorController.SCHLIB | VESC_MotorController.SCHLIB
| | Library Reference | Header 6 Pin_2 | Header 6 Pin_2 | Header 6 Pin_2
| | Manufacturer | Wurth Elektronik | Wurth Elektronik | Wurth Elektronik
| | Manufacturer Part Number | 61300621121 | 61300621121 | 61300621121
| | PCB3D
| | Pin Info
| | Price | 0.57 | 0.57 | 0.57
| | Signal Integrity
| | Simulation
| | Supplier | Mouser | Mouser | Mouser
| | Supplier Part Number | 710-61300621121 | 710-61300621121 | 710-61300621121
| | Value | 61300621121 | 61300621121 | 61300621121
J10 | Controller.SchDoc | | Fitted | Fitted | Fitted
| | Comment | SWD | SWD | SWD
| | Component Kind | Standard | Standard | Standard
| | Description | Headers & Wire Housings WR-PHD 2.54mm Hdr 5P Single Str Gold | Headers & Wire Housings WR-PHD 2.54mm Hdr 5P Single Str Gold | Headers & Wire Housings WR-PHD 2.54mm Hdr 5P Single Str Gold
| | Footprint | 61300511121 | 61300511121 | 61300511121
| | Ibis Model
| | Library Name | VESC_MotorController.SCHLIB | VESC_MotorController.SCHLIB | VESC_MotorController.SCHLIB
| | Library Reference | Header 5 Pin | Header 5 Pin | Header 5 Pin
| | Manufacturer | Wurth Electronic | Wurth Electronic | Wurth Electronic
| | Manufacturer Part Number | 61300511121 | 61300511121 | 61300511121
| | PCB3D
| | Pin Info
| | Price | 0.37 | 0.37 | 0.37
| | Signal Integrity
| | Simulation
| | Supplier | Mouser | Mouser | Mouser
| | Supplier Part Number | 710-61300511121 | 710-61300511121 | 710-61300511121
| | Value | 61300511121 | 61300511121 | 61300511121
J11 | Controller.SchDoc | | Fitted | Fitted | Fitted
| | Comment | PWR_COMM | PWR_COMM | PWR_COMM
| | Component Kind | Standard | Standard | Standard
| | Description | Headers & Wire Housings WR-PHD 2.54mm Hdr 8P Single Str Gold | Headers & Wire Housings WR-PHD 2.54mm Hdr 8P Single Str Gold | Headers & Wire Housings WR-PHD 2.54mm Hdr 8P Single Str Gold
| | Footprint | 61301821121 | 61301821121 | 61301821121
| | Ibis Model
| | Library Name | VESC_MotorController.SCHLIB | VESC_MotorController.SCHLIB | VESC_MotorController.SCHLIB
| | Library Reference | Header 8 Pin | Header 8 Pin | Header 8 Pin
| | Manufacturer | Wurth Electronic | Wurth Electronic | Wurth Electronic
| | Manufacturer Part Number | 61300811121 | 61300811121 | 61300811121
| | PCB3D
| | Pin Info
| | Price | 0.4 | 0.4 | 0.4
| | Signal Integrity
| | Simulation
| | Supplier | Mouser | Mouser | Mouser
| | Supplier Part Number | 710-61300811121 | 710-61300811121 | 710-61300811121
| | Value | 61300811121 | 61300811121 | 61300811121
J12 | Controller.SchDoc | | Fitted | Fitted | Fitted
| | Comment | CAN | CAN | CAN
| | Component Kind | Standard | Standard | Standard
| | Description | Headers & Wire Housings WR-PHD 2.54mm Hdr 4P Single Str Gold | Headers & Wire Housings WR-PHD 2.54mm Hdr 4P Single Str Gold | Headers & Wire Housings WR-PHD 2.54mm Hdr 4P Single Str Gold
| | Footprint | 61300411121 | 61300411121 | 61300411121
| | Ibis Model
| | Library Name | VESC_MotorController.SCHLIB | VESC_MotorController.SCHLIB | VESC_MotorController.SCHLIB
| | Library Reference | Header 4 Pin | Header 4 Pin | Header 4 Pin
| | Manufacturer | Wurth Electronic | Wurth Electronic | Wurth Electronic
| | Manufacturer Part Number | 61300411121 | 61300411121 | 61300411121
| | PCB3D
| | Pin Info
| | Price | 0.27 | 0.27 | 0.27
| | Signal Integrity
| | Simulation
| | Supplier | Mouser | Mouser | Mouser
| | Supplier Part Number | 710-61300411121 | 710-61300411121 | 710-61300411121
| | Value | 61300411121 | 61300411121 | 61300411121
J13 | Controller.SchDoc | | Fitted | Fitted | Fitted
| | Comment | Header 8 Pin_2 | Header 8 Pin_2 | Header 8 Pin_2
| | Component Kind | Standard | Standard | Standard
| | Description | Headers & Wire Housings WR-PHD 2.54mm Hdr 8P Dual Str Gold | Headers & Wire Housings WR-PHD 2.54mm Hdr 8P Dual Str Gold | Headers & Wire Housings WR-PHD 2.54mm Hdr 8P Dual Str Gold
| | Footprint | 61300821121 | 61300821121 | 61300821121
| | Ibis Model
| | Library Name | VESC_MotorController.SCHLIB | VESC_MotorController.SCHLIB | VESC_MotorController.SCHLIB
| | Library Reference | Header 8 Pin_2 | Header 8 Pin_2 | Header 8 Pin_2
| | Manufacturer | Wurth Elektronik | Wurth Elektronik | Wurth Elektronik
| | Manufacturer Part Number | 61300821121 | 61300821121 | 61300821121
| | PCB3D
| | Pin Info
| | Price | 0.7 | 0.7 | 0.7
| | Signal Integrity
| | Simulation
| | Supplier | Mouser | Mouser | Mouser
| | Supplier Part Number | 710-61300621121 | 710-61300621121 | 710-61300621121
| | Value | 61300821121 | 61300821121 | 61300821121
J14 | Controller.SchDoc | | Fitted | Fitted | Fitted
| | Comment | SERVO | SERVO | SERVO
| | Component Kind | Standard | Standard | Standard
| | Description | Headers & Wire Housings WR-PHD 2.54mm Hdr 3P Single Str Gold | Headers & Wire Housings WR-PHD 2.54mm Hdr 3P Single Str Gold | Headers & Wire Housings WR-PHD 2.54mm Hdr 3P Single Str Gold
| | Footprint | 61300311121 | 61300311121 | 61300311121
| | Ibis Model
| | Library Name | VESC_MotorController.SCHLIB | VESC_MotorController.SCHLIB | VESC_MotorController.SCHLIB
| | Library Reference | Header 3 Pin | Header 3 Pin | Header 3 Pin
| | Manufacturer | Wurth Electronic | Wurth Electronic | Wurth Electronic
| | Manufacturer Part Number | 61300311121 | 61300311121 | 61300311121
| | PCB3D
| | Pin Info
| | Price | 0.13 | 0.13 | 0.13
| | Signal Integrity
| | Simulation
| | Supplier | Mouser | Mouser | Mouser
| | Supplier Part Number | 710-61300311121 | 710-61300311121 | 710-61300311121
| | Value | 61300311121 | 61300311121 | 61300311121
J15 | Controller.SchDoc | | Fitted | Fitted | Fitted
| | Comment | PHASE_U | PHASE_U | PHASE_U
| | Component Kind | Standard | Standard | Standard
| | Description | WR-PHD 2.54mm Dual Pin Header THT 06p Wurth Elektronik WR-PHD Series, Series Number 6130, 2.54mm Pitch 6 Way 2 Row Straight PCB Header, Solder Termination | WR-PHD 2.54mm Dual Pin Header THT 06p Wurth Elektronik WR-PHD Series, Series Number 6130, 2.54mm Pitch 6 Way 2 Row Straight PCB Header, Solder Termination | WR-PHD 2.54mm Dual Pin Header THT 06p Wurth Elektronik WR-PHD Series, Series Number 6130, 2.54mm Pitch 6 Way 2 Row Straight PCB Header, Solder Termination
| | Footprint | 61300621121 | 61300621121 | 61300621121
| | Ibis Model
| | Library Name | VESC_MotorController.SCHLIB | VESC_MotorController.SCHLIB | VESC_MotorController.SCHLIB
| | Library Reference | Header 6 Pin_2 | Header 6 Pin_2 | Header 6 Pin_2
| | Manufacturer | Wurth Elektronik | Wurth Elektronik | Wurth Elektronik
| | Manufacturer Part Number | 61300621121 | 61300621121 | 61300621121
| | PCB3D
| | Pin Info
| | Price | 0.57 | 0.57 | 0.57
| | Signal Integrity
| | Simulation
| | Supplier | Mouser | Mouser | Mouser
| | Supplier Part Number | 710-61300621121 | 710-61300621121 | 710-61300621121
| | Value | 61300621121 | 61300621121 | 61300621121
J16 | Controller.SchDoc | | Fitted | Fitted | Fitted
| | Comment | PHASE_V | PHASE_V | PHASE_V
| | Component Kind | Standard | Standard | Standard
| | Description | WR-PHD 2.54mm Dual Pin Header THT 06p Wurth Elektronik WR-PHD Series, Series Number 6130, 2.54mm Pitch 6 Way 2 Row Straight PCB Header, Solder Termination | WR-PHD 2.54mm Dual Pin Header THT 06p Wurth Elektronik WR-PHD Series, Series Number 6130, 2.54mm Pitch 6 Way 2 Row Straight PCB Header, Solder Termination | WR-PHD 2.54mm Dual Pin Header THT 06p Wurth Elektronik WR-PHD Series, Series Number 6130, 2.54mm Pitch 6 Way 2 Row Straight PCB Header, Solder Termination
| | Footprint | 61300621121 | 61300621121 | 61300621121
| | Ibis Model
| | Library Name | VESC_MotorController.SCHLIB | VESC_MotorController.SCHLIB | VESC_MotorController.SCHLIB
| | Library Reference | Header 6 Pin_2 | Header 6 Pin_2 | Header 6 Pin_2
| | Manufacturer | Wurth Elektronik | Wurth Elektronik | Wurth Elektronik
| | Manufacturer Part Number | 61300621121 | 61300621121 | 61300621121
| | PCB3D
| | Pin Info
| | Price | 0.57 | 0.57 | 0.57
| | Signal Integrity
| | Simulation
| | Supplier | Mouser | Mouser | Mouser
| | Supplier Part Number | 710-61300621121 | 710-61300621121 | 710-61300621121
| | Value | 61300621121 | 61300621121 | 61300621121
J17 | Controller.SchDoc | | Fitted | Fitted | Fitted
| | Comment | PHASE_U | PHASE_U | PHASE_U
| | Component Kind | Standard | Standard | Standard
| | Description | WR-PHD 2.54mm Dual Pin Header THT 06p Wurth Elektronik WR-PHD Series, Series Number 6130, 2.54mm Pitch 6 Way 2 Row Straight PCB Header, Solder Termination | WR-PHD 2.54mm Dual Pin Header THT 06p Wurth Elektronik WR-PHD Series, Series Number 6130, 2.54mm Pitch 6 Way 2 Row Straight PCB Header, Solder Termination | WR-PHD 2.54mm Dual Pin Header THT 06p Wurth Elektronik WR-PHD Series, Series Number 6130, 2.54mm Pitch 6 Way 2 Row Straight PCB Header, Solder Termination
| | Footprint | 61300621121 | 61300621121 | 61300621121
| | Ibis Model
| | Library Name | VESC_MotorController.SCHLIB | VESC_MotorController.SCHLIB | VESC_MotorController.SCHLIB
| | Library Reference | Header 6 Pin_2 | Header 6 Pin_2 | Header 6 Pin_2
| | Manufacturer | Wurth Elektronik | Wurth Elektronik | Wurth Elektronik
| | Manufacturer Part Number | 61300621121 | 61300621121 | 61300621121
| | PCB3D
| | Pin Info
| | Price | 0.57 | 0.57 | 0.57
| | Signal Integrity
| | Simulation
| | Supplier | Mouser | Mouser | Mouser
| | Supplier Part Number | 710-61300621121 | 710-61300621121 | 710-61300621121
| | Value | 61300621121 | 61300621121 | 61300621121
J18 | Controller.SchDoc | | Fitted | Fitted | Fitted
| | Comment | HALL_ENCODER | HALL_ENCODER | HALL_ENCODER
| | Component Kind | Standard | Standard | Standard
| | Description | Headers & Wire Housings WR-PHD 2.54mm Hdr 5P Single Str Gold | Headers & Wire Housings WR-PHD 2.54mm Hdr 5P Single Str Gold | Headers & Wire Housings WR-PHD 2.54mm Hdr 5P Single Str Gold
| | Footprint | 61300611121 | 61300611121 | 61300611121
| | Ibis Model
| | Library Name | VESC_MotorController.SCHLIB | VESC_MotorController.SCHLIB | VESC_MotorController.SCHLIB
| | Library Reference | Header 6 Pin | Header 6 Pin | Header 6 Pin
| | Manufacturer | Wurth Electronic | Wurth Electronic | Wurth Electronic
| | Manufacturer Part Number | 61300611121 | 61300611121 | 61300611121
| | PCB3D
| | Pin Info
| | Price | 0.35 | 0.35 | 0.35
| | Signal Integrity
| | Simulation
| | Supplier | Mouser | Mouser | Mouser
| | Supplier Part Number | 710-61300611121 | 710-61300611121 | 710-61300611121
| | Value | 61300611121 | 61300611121 | 61300611121
J_USB | Controller.SchDoc | | Fitted | Fitted | Fitted
| | Comment | USB_Con | USB_Con | USB_Con
| | Component Kind | Standard | Standard | Standard
| | Description | USB - micro B USB 2.0 Receptacle Connector 5 Position Through Hole | USB - micro B USB 2.0 Receptacle Connector 5 Position Through Hole | USB - micro B USB 2.0 Receptacle Connector 5 Position Through Hole
| | Footprint | 10118194-0001LF | 10118194-0001LF | 10118194-0001LF
| | Ibis Model
| | Library Name | VESC_MotorController.SCHLIB | VESC_MotorController.SCHLIB | VESC_MotorController.SCHLIB
| | Library Reference | USB_Con | USB_Con | USB_Con
| | Manufacturer | Wurth Electronics | Wurth Electronics | Wurth Electronics
| | Manufacturer Part Number | 614105150721 | 614105150721 | 614105150721
| | PCB3D
| | Pin Info
| | Price | 3 | 3 | 3
| | Signal Integrity
| | Simulation
| | Supplier | Mouser | Mouser | Mouser
| | Supplier Part Number | 710-614105150721 | 710-614105150721 | 710-614105150721
| | Value | 614105150721 | 614105150721 | 614105150721
L1 | Controller.SchDoc | | Fitted | Not Fitted | Fitted
| | Comment | 68uH | | 68uH
| | Component Kind | Standard | | Standard
| | Description | Ind,7.9x7.3x5.2mm,68uH+/-20%,2.7A,shd | | Ind,7.9x7.3x5.2mm,68uH+/-20%,2.7A,shd
| | Footprint | INDPM7973X540N | | INDPM7973X540N
| | Geometry.Height | 5.4mm | | 5.4mm
| | Ibis Model
| | Library Name | VESC_MotorController.SCHLIB | | VESC_MotorController.SCHLIB
| | Library Reference | SRP7050WA-680M | | SRP7050WA-680M
| | Manufacturer | Bourns | | Bourns
| | Manufacturer Part Number | SRP7050WA-680M | | SRP7050WA-680M
| | PCB3D
| | Pin Info
| | Price | 1.46 | | 1.46
| | Signal Integrity
| | Simulation
| | Supplier | Mouser | | Mouser
| | Supplier Part Number | 652-SRP7050WA-680M | | 652-SRP7050WA-680M
| | Value | 68uH | | 68uH
L2 | Controller.SchDoc | | Fitted | Not Fitted | Fitted
| | Comment | 22uH | | 22uH
| | Component Kind | Standard | | Standard
| | Description | Ind,7.9x7.3x5.2mm,22uH+/-20%,5A,shd | | Ind,7.9x7.3x5.2mm,22uH+/-20%,5A,shd
| | Footprint | INDPM7973X540N | | INDPM7973X540N
| | Ibis Model
| | Library Name | VESC_MotorController.SCHLIB | | VESC_MotorController.SCHLIB
| | Library Reference | SRP7050WA-220M | | SRP7050WA-220M
| | Manufacturer | Bourns | | Bourns
| | Manufacturer Part Number | SRP7050WA-220M | | SRP7050WA-220M
| | PCB3D
| | Pin Info
| | Price | 1.46 | | 1.46
| | Signal Integrity
| | Simulation
| | Supplier | Mouser | | Mouser
| | Supplier Part Number | 652-SRP7050WA-220M | | 652-SRP7050WA-220M
| | Value | 22uH | | 22uH
L3 | Controller.SchDoc | | Fitted | Fitted | Fitted
| | Comment | 22uH | 22uH | 22uH
| | Component Kind | Standard | Standard | Standard
| | Description | Ind,7.9x7.3x5.2mm,22uH+/-20%,5A,shd | Ind,7.9x7.3x5.2mm,22uH+/-20%,5A,shd | Ind,7.9x7.3x5.2mm,22uH+/-20%,5A,shd
| | Footprint | INDPM7973X540N | INDPM7973X540N | INDPM7973X540N
| | Ibis Model
| | Library Name | VESC_MotorController.SCHLIB | VESC_MotorController.SCHLIB | VESC_MotorController.SCHLIB
| | Library Reference | SRP7050WA-220M | SRP7050WA-220M | SRP7050WA-220M
| | Manufacturer | Bourns | Bourns | Bourns
| | Manufacturer Part Number | SRP7050WA-220M | SRP7050WA-220M | SRP7050WA-220M
| | PCB3D
| | Pin Info
| | Price | 1.46 | 1.46 | 1.46
| | Signal Integrity
| | Simulation
| | Supplier | Mouser | Mouser | Mouser
| | Supplier Part Number | 652-SRP7050WA-220M | 652-SRP7050WA-220M | 652-SRP7050WA-220M
| | Value | 22uH | 22uH | 22uH
Q1 | PowerBoard.SchDoc | | Fitted | Not Fitted | Fitted
| | Comment | IPB044N15N5ATMA1 | | IPB044N15N5ATMA1
| | Component Kind | Standard | | Standard
| | Description | INFINEON - IPB044N15N5ATMA1 - Power MOSFET, N Channel, 150 V, 174 A, 0.0034 ohm, TO-263 (D2PAK), Surface Mount | | INFINEON - IPB044N15N5ATMA1 - Power MOSFET, N Channel, 150 V, 174 A, 0.0034 ohm, TO-263 (D2PAK), Surface Mount
| | Footprint | IPB044N15N5ATMA1 | | IPB044N15N5ATMA1
| | Ibis Model
| | Library Name | VESC_MotorController.SCHLIB | | VESC_MotorController.SCHLIB
| | Library Reference | IPB044N15N5ATMA1 | | IPB044N15N5ATMA1
| | Manufacturer | Infineon | | Infineon
| | Manufacturer Part Number | IPB044N15N5ATMA1 | | IPB044N15N5ATMA1
| | PCB3D
| | Pin Info
| | Price | 12.76 | | 12.76
| | Signal Integrity
| | Simulation
| | Supplier | Mouser | | Mouser
| | Supplier Part Number | 726-IPB044N15N5ATMA1 | | 726-IPB044N15N5ATMA1
| | Value | IPB044N15N5ATMA1 | | IPB044N15N5ATMA1
Q2 | PowerBoard.SchDoc | | Fitted | Not Fitted | Fitted
| | Comment | IPB044N15N5ATMA1 | | IPB044N15N5ATMA1
| | Component Kind | Standard | | Standard
| | Description | INFINEON - IPB044N15N5ATMA1 - Power MOSFET, N Channel, 150 V, 174 A, 0.0034 ohm, TO-263 (D2PAK), Surface Mount | | INFINEON - IPB044N15N5ATMA1 - Power MOSFET, N Channel, 150 V, 174 A, 0.0034 ohm, TO-263 (D2PAK), Surface Mount
| | Footprint | IPB044N15N5ATMA1 | | IPB044N15N5ATMA1
| | Ibis Model
| | Library Name | VESC_MotorController.SCHLIB | | VESC_MotorController.SCHLIB
| | Library Reference | IPB044N15N5ATMA1 | | IPB044N15N5ATMA1
| | Manufacturer | Infineon | | Infineon
| | Manufacturer Part Number | IPB044N15N5ATMA1 | | IPB044N15N5ATMA1
| | PCB3D
| | Pin Info
| | Price | 12.76 | | 12.76
| | Signal Integrity
| | Simulation
| | Supplier | Mouser | | Mouser
| | Supplier Part Number | 726-IPB044N15N5ATMA1 | | 726-IPB044N15N5ATMA1
| | Value | IPB044N15N5ATMA1 | | IPB044N15N5ATMA1
Q3 | PowerBoard.SchDoc | | Fitted | Not Fitted | Fitted
| | Comment | IPB044N15N5ATMA1 | | IPB044N15N5ATMA1
| | Component Kind | Standard | | Standard
| | Description | INFINEON - IPB044N15N5ATMA1 - Power MOSFET, N Channel, 150 V, 174 A, 0.0034 ohm, TO-263 (D2PAK), Surface Mount | | INFINEON - IPB044N15N5ATMA1 - Power MOSFET, N Channel, 150 V, 174 A, 0.0034 ohm, TO-263 (D2PAK), Surface Mount
| | Footprint | IPB044N15N5ATMA1 | | IPB044N15N5ATMA1
| | Ibis Model
| | Library Name | VESC_MotorController.SCHLIB | | VESC_MotorController.SCHLIB
| | Library Reference | IPB044N15N5ATMA1 | | IPB044N15N5ATMA1
| | Manufacturer | Infineon | | Infineon
| | Manufacturer Part Number | IPB044N15N5ATMA1 | | IPB044N15N5ATMA1
| | PCB3D
| | Pin Info
| | Price | 12.76 | | 12.76
| | Signal Integrity
| | Simulation
| | Supplier | Mouser | | Mouser
| | Supplier Part Number | 726-IPB044N15N5ATMA1 | | 726-IPB044N15N5ATMA1
| | Value | IPB044N15N5ATMA1 | | IPB044N15N5ATMA1
Q4 | PowerBoard.SchDoc | | Fitted | Fitted | Fitted
| | Comment | IPB044N15N5ATMA1 | IPB044N15N5ATMA1 | IPB044N15N5ATMA1
| | Component Kind | Standard | Standard | Standard
| | Description | INFINEON - IPB044N15N5ATMA1 - Power MOSFET, N Channel, 150 V, 174 A, 0.0034 ohm, TO-263 (D2PAK), Surface Mount | INFINEON - IPB044N15N5ATMA1 - Power MOSFET, N Channel, 150 V, 174 A, 0.0034 ohm, TO-263 (D2PAK), Surface Mount | INFINEON - IPB044N15N5ATMA1 - Power MOSFET, N Channel, 150 V, 174 A, 0.0034 ohm, TO-263 (D2PAK), Surface Mount
| | Footprint | IPB044N15N5ATMA1 | IPB044N15N5ATMA1 | IPB044N15N5ATMA1
| | Ibis Model
| | Library Name | VESC_MotorController.SCHLIB | VESC_MotorController.SCHLIB | VESC_MotorController.SCHLIB
| | Library Reference | IPB044N15N5ATMA1 | IPB044N15N5ATMA1 | IPB044N15N5ATMA1
| | Manufacturer | Infineon | Infineon | Infineon
| | Manufacturer Part Number | IPB044N15N5ATMA1 | IPB044N15N5ATMA1 | IPB044N15N5ATMA1
| | PCB3D
| | Pin Info
| | Price | 12.76 | 12.76 | 12.76
| | Signal Integrity
| | Simulation
| | Supplier | Mouser | Mouser | Mouser
| | Supplier Part Number | 726-IPB044N15N5ATMA1 | 726-IPB044N15N5ATMA1 | 726-IPB044N15N5ATMA1
| | Value | IPB044N15N5ATMA1 | IPB044N15N5ATMA1 | IPB044N15N5ATMA1
Q5 | PowerBoard.SchDoc | | Fitted | Fitted | Fitted
| | Comment | IPB044N15N5ATMA1 | IPB044N15N5ATMA1 | IPB044N15N5ATMA1
| | Component Kind | Standard | Standard | Standard
| | Description | INFINEON - IPB044N15N5ATMA1 - Power MOSFET, N Channel, 150 V, 174 A, 0.0034 ohm, TO-263 (D2PAK), Surface Mount | INFINEON - IPB044N15N5ATMA1 - Power MOSFET, N Channel, 150 V, 174 A, 0.0034 ohm, TO-263 (D2PAK), Surface Mount | INFINEON - IPB044N15N5ATMA1 - Power MOSFET, N Channel, 150 V, 174 A, 0.0034 ohm, TO-263 (D2PAK), Surface Mount
| | Footprint | IPB044N15N5ATMA1 | IPB044N15N5ATMA1 | IPB044N15N5ATMA1
| | Ibis Model
| | Library Name | VESC_MotorController.SCHLIB | VESC_MotorController.SCHLIB | VESC_MotorController.SCHLIB
| | Library Reference | IPB044N15N5ATMA1 | IPB044N15N5ATMA1 | IPB044N15N5ATMA1
| | Manufacturer | Infineon | Infineon | Infineon
| | Manufacturer Part Number | IPB044N15N5ATMA1 | IPB044N15N5ATMA1 | IPB044N15N5ATMA1
| | PCB3D
| | Pin Info
| | Price | 12.76 | 12.76 | 12.76
| | Signal Integrity
| | Simulation
| | Supplier | Mouser | Mouser | Mouser
| | Supplier Part Number | 726-IPB044N15N5ATMA1 | 726-IPB044N15N5ATMA1 | 726-IPB044N15N5ATMA1
| | Value | IPB044N15N5ATMA1 | IPB044N15N5ATMA1 | IPB044N15N5ATMA1
Q6 | PowerBoard.SchDoc | | Fitted | Not Fitted | Fitted
| | Comment | IPB044N15N5ATMA1 | | IPB044N15N5ATMA1
| | Component Kind | Standard | | Standard
| | Description | INFINEON - IPB044N15N5ATMA1 - Power MOSFET, N Channel, 150 V, 174 A, 0.0034 ohm, TO-263 (D2PAK), Surface Mount | | INFINEON - IPB044N15N5ATMA1 - Power MOSFET, N Channel, 150 V, 174 A, 0.0034 ohm, TO-263 (D2PAK), Surface Mount
| | Footprint | IPB044N15N5ATMA1 | | IPB044N15N5ATMA1
| | Ibis Model
| | Library Name | VESC_MotorController.SCHLIB | | VESC_MotorController.SCHLIB
| | Library Reference | IPB044N15N5ATMA1 | | IPB044N15N5ATMA1
| | Manufacturer | Infineon | | Infineon
| | Manufacturer Part Number | IPB044N15N5ATMA1 | | IPB044N15N5ATMA1
| | PCB3D
| | Pin Info
| | Price | 12.76 | | 12.76
| | Signal Integrity
| | Simulation
| | Supplier | Mouser | | Mouser
| | Supplier Part Number | 726-IPB044N15N5ATMA1 | | 726-IPB044N15N5ATMA1
| | Value | IPB044N15N5ATMA1 | | IPB044N15N5ATMA1
Q7 | PowerBoard.SchDoc | | Fitted | Not Fitted | Fitted
| | Comment | IPB044N15N5ATMA1 | | IPB044N15N5ATMA1
| | Component Kind | Standard | | Standard
| | Description | INFINEON - IPB044N15N5ATMA1 - Power MOSFET, N Channel, 150 V, 174 A, 0.0034 ohm, TO-263 (D2PAK), Surface Mount | | INFINEON - IPB044N15N5ATMA1 - Power MOSFET, N Channel, 150 V, 174 A, 0.0034 ohm, TO-263 (D2PAK), Surface Mount
| | Footprint | IPB044N15N5ATMA1 | | IPB044N15N5ATMA1
| | Ibis Model
| | Library Name | VESC_MotorController.SCHLIB | | VESC_MotorController.SCHLIB
| | Library Reference | IPB044N15N5ATMA1 | | IPB044N15N5ATMA1
| | Manufacturer | Infineon | | Infineon
| | Manufacturer Part Number | IPB044N15N5ATMA1 | | IPB044N15N5ATMA1
| | PCB3D
| | Pin Info
| | Price | 12.76 | | 12.76
| | Signal Integrity
| | Simulation
| | Supplier | Mouser | | Mouser
| | Supplier Part Number | 726-IPB044N15N5ATMA1 | | 726-IPB044N15N5ATMA1
| | Value | IPB044N15N5ATMA1 | | IPB044N15N5ATMA1
Q8 | PowerBoard.SchDoc | | Fitted | Fitted | Fitted
| | Comment | IPB044N15N5ATMA1 | IPB044N15N5ATMA1 | IPB044N15N5ATMA1
| | Component Kind | Standard | Standard | Standard
| | Description | INFINEON - IPB044N15N5ATMA1 - Power MOSFET, N Channel, 150 V, 174 A, 0.0034 ohm, TO-263 (D2PAK), Surface Mount | INFINEON - IPB044N15N5ATMA1 - Power MOSFET, N Channel, 150 V, 174 A, 0.0034 ohm, TO-263 (D2PAK), Surface Mount | INFINEON - IPB044N15N5ATMA1 - Power MOSFET, N Channel, 150 V, 174 A, 0.0034 ohm, TO-263 (D2PAK), Surface Mount
| | Footprint | IPB044N15N5ATMA1 | IPB044N15N5ATMA1 | IPB044N15N5ATMA1
| | Ibis Model
| | Library Name | VESC_MotorController.SCHLIB | VESC_MotorController.SCHLIB | VESC_MotorController.SCHLIB
| | Library Reference | IPB044N15N5ATMA1 | IPB044N15N5ATMA1 | IPB044N15N5ATMA1
| | Manufacturer | Infineon | Infineon | Infineon
| | Manufacturer Part Number | IPB044N15N5ATMA1 | IPB044N15N5ATMA1 | IPB044N15N5ATMA1
| | PCB3D
| | Pin Info
| | Price | 12.76 | 12.76 | 12.76
| | Signal Integrity
| | Simulation
| | Supplier | Mouser | Mouser | Mouser
| | Supplier Part Number | 726-IPB044N15N5ATMA1 | 726-IPB044N15N5ATMA1 | 726-IPB044N15N5ATMA1
| | Value | IPB044N15N5ATMA1 | IPB044N15N5ATMA1 | IPB044N15N5ATMA1
Q9 | PowerBoard.SchDoc | | Fitted | Not Fitted | Fitted
| | Comment | IPB044N15N5ATMA1 | | IPB044N15N5ATMA1
| | Component Kind | Standard | | Standard
| | Description | INFINEON - IPB044N15N5ATMA1 - Power MOSFET, N Channel, 150 V, 174 A, 0.0034 ohm, TO-263 (D2PAK), Surface Mount | | INFINEON - IPB044N15N5ATMA1 - Power MOSFET, N Channel, 150 V, 174 A, 0.0034 ohm, TO-263 (D2PAK), Surface Mount
| | Footprint | IPB044N15N5ATMA1 | | IPB044N15N5ATMA1
| | Ibis Model
| | Library Name | VESC_MotorController.SCHLIB | | VESC_MotorController.SCHLIB
| | Library Reference | IPB044N15N5ATMA1 | | IPB044N15N5ATMA1
| | Manufacturer | Infineon | | Infineon
| | Manufacturer Part Number | IPB044N15N5ATMA1 | | IPB044N15N5ATMA1
| | PCB3D
| | Pin Info
| | Price | 12.76 | | 12.76
| | Signal Integrity
| | Simulation
| | Supplier | Mouser | | Mouser
| | Supplier Part Number | 726-IPB044N15N5ATMA1 | | 726-IPB044N15N5ATMA1
| | Value | IPB044N15N5ATMA1 | | IPB044N15N5ATMA1
Q10 | PowerBoard.SchDoc | | Fitted | Fitted | Fitted
| | Comment | IPB044N15N5ATMA1 | IPB044N15N5ATMA1 | IPB044N15N5ATMA1
| | Component Kind | Standard | Standard | Standard
| | Description | INFINEON - IPB044N15N5ATMA1 - Power MOSFET, N Channel, 150 V, 174 A, 0.0034 ohm, TO-263 (D2PAK), Surface Mount | INFINEON - IPB044N15N5ATMA1 - Power MOSFET, N Channel, 150 V, 174 A, 0.0034 ohm, TO-263 (D2PAK), Surface Mount | INFINEON - IPB044N15N5ATMA1 - Power MOSFET, N Channel, 150 V, 174 A, 0.0034 ohm, TO-263 (D2PAK), Surface Mount
| | Footprint | IPB044N15N5ATMA1 | IPB044N15N5ATMA1 | IPB044N15N5ATMA1
| | Ibis Model
| | Library Name | VESC_MotorController.SCHLIB | VESC_MotorController.SCHLIB | VESC_MotorController.SCHLIB
| | Library Reference | IPB044N15N5ATMA1 | IPB044N15N5ATMA1 | IPB044N15N5ATMA1
| | Manufacturer | Infineon | Infineon | Infineon
| | Manufacturer Part Number | IPB044N15N5ATMA1 | IPB044N15N5ATMA1 | IPB044N15N5ATMA1
| | PCB3D
| | Pin Info
| | Price | 12.76 | 12.76 | 12.76
| | Signal Integrity
| | Simulation
| | Supplier | Mouser | Mouser | Mouser
| | Supplier Part Number | 726-IPB044N15N5ATMA1 | 726-IPB044N15N5ATMA1 | 726-IPB044N15N5ATMA1
| | Value | IPB044N15N5ATMA1 | IPB044N15N5ATMA1 | IPB044N15N5ATMA1
Q11 | PowerBoard.SchDoc | | Fitted | Fitted | Fitted
| | Comment | IPB044N15N5ATMA1 | IPB044N15N5ATMA1 | IPB044N15N5ATMA1
| | Component Kind | Standard | Standard | Standard
| | Description | INFINEON - IPB044N15N5ATMA1 - Power MOSFET, N Channel, 150 V, 174 A, 0.0034 ohm, TO-263 (D2PAK), Surface Mount | INFINEON - IPB044N15N5ATMA1 - Power MOSFET, N Channel, 150 V, 174 A, 0.0034 ohm, TO-263 (D2PAK), Surface Mount | INFINEON - IPB044N15N5ATMA1 - Power MOSFET, N Channel, 150 V, 174 A, 0.0034 ohm, TO-263 (D2PAK), Surface Mount
| | Footprint | IPB044N15N5ATMA1 | IPB044N15N5ATMA1 | IPB044N15N5ATMA1
| | Ibis Model
| | Library Name | VESC_MotorController.SCHLIB | VESC_MotorController.SCHLIB | VESC_MotorController.SCHLIB
| | Library Reference | IPB044N15N5ATMA1 | IPB044N15N5ATMA1 | IPB044N15N5ATMA1
| | Manufacturer | Infineon | Infineon | Infineon
| | Manufacturer Part Number | IPB044N15N5ATMA1 | IPB044N15N5ATMA1 | IPB044N15N5ATMA1
| | PCB3D
| | Pin Info
| | Price | 12.76 | 12.76 | 12.76
| | Signal Integrity
| | Simulation
| | Supplier | Mouser | Mouser | Mouser
| | Supplier Part Number | 726-IPB044N15N5ATMA1 | 726-IPB044N15N5ATMA1 | 726-IPB044N15N5ATMA1
| | Value | IPB044N15N5ATMA1 | IPB044N15N5ATMA1 | IPB044N15N5ATMA1
Q12 | PowerBoard.SchDoc | | Fitted | Fitted | Fitted
| | Comment | IPB044N15N5ATMA1 | IPB044N15N5ATMA1 | IPB044N15N5ATMA1
| | Component Kind | Standard | Standard | Standard
| | Description | INFINEON - IPB044N15N5ATMA1 - Power MOSFET, N Channel, 150 V, 174 A, 0.0034 ohm, TO-263 (D2PAK), Surface Mount | INFINEON - IPB044N15N5ATMA1 - Power MOSFET, N Channel, 150 V, 174 A, 0.0034 ohm, TO-263 (D2PAK), Surface Mount | INFINEON - IPB044N15N5ATMA1 - Power MOSFET, N Channel, 150 V, 174 A, 0.0034 ohm, TO-263 (D2PAK), Surface Mount
| | Footprint | IPB044N15N5ATMA1 | IPB044N15N5ATMA1 | IPB044N15N5ATMA1
| | Ibis Model
| | Library Name | VESC_MotorController.SCHLIB | VESC_MotorController.SCHLIB | VESC_MotorController.SCHLIB
| | Library Reference | IPB044N15N5ATMA1 | IPB044N15N5ATMA1 | IPB044N15N5ATMA1
| | Manufacturer | Infineon | Infineon | Infineon
| | Manufacturer Part Number | IPB044N15N5ATMA1 | IPB044N15N5ATMA1 | IPB044N15N5ATMA1
| | PCB3D
| | Pin Info
| | Price | 12.76 | 12.76 | 12.76
| | Signal Integrity
| | Simulation
| | Supplier | Mouser | Mouser | Mouser
| | Supplier Part Number | 726-IPB044N15N5ATMA1 | 726-IPB044N15N5ATMA1 | 726-IPB044N15N5ATMA1
| | Value | IPB044N15N5ATMA1 | IPB044N15N5ATMA1 | IPB044N15N5ATMA1
Q13 | PowerBoard.SchDoc | | Fitted | Fitted | Fitted
| | Comment | IPB044N15N5ATMA1 | IPB044N15N5ATMA1 | IPB044N15N5ATMA1
| | Component Kind | Standard | Standard | Standard
| | Description | INFINEON - IPB044N15N5ATMA1 - Power MOSFET, N Channel, 150 V, 174 A, 0.0034 ohm, TO-263 (D2PAK), Surface Mount | INFINEON - IPB044N15N5ATMA1 - Power MOSFET, N Channel, 150 V, 174 A, 0.0034 ohm, TO-263 (D2PAK), Surface Mount | INFINEON - IPB044N15N5ATMA1 - Power MOSFET, N Channel, 150 V, 174 A, 0.0034 ohm, TO-263 (D2PAK), Surface Mount
| | Footprint | IPB044N15N5ATMA1 | IPB044N15N5ATMA1 | IPB044N15N5ATMA1
| | Ibis Model
| | Library Name | VESC_MotorController.SCHLIB | VESC_MotorController.SCHLIB | VESC_MotorController.SCHLIB
| | Library Reference | IPB044N15N5ATMA1 | IPB044N15N5ATMA1 | IPB044N15N5ATMA1
| | Manufacturer | Infineon | Infineon | Infineon
| | Manufacturer Part Number | IPB044N15N5ATMA1 | IPB044N15N5ATMA1 | IPB044N15N5ATMA1
| | PCB3D
| | Pin Info
| | Price | 12.76 | 12.76 | 12.76
| | Signal Integrity
| | Simulation
| | Supplier | Mouser | Mouser | Mouser
| | Supplier Part Number | 726-IPB044N15N5ATMA1 | 726-IPB044N15N5ATMA1 | 726-IPB044N15N5ATMA1
| | Value | IPB044N15N5ATMA1 | IPB044N15N5ATMA1 | IPB044N15N5ATMA1
Q14 | PowerBoard.SchDoc | | Fitted | Fitted | Fitted
| | Comment | IPB044N15N5ATMA1 | IPB044N15N5ATMA1 | IPB044N15N5ATMA1
| | Component Kind | Standard | Standard | Standard
| | Description | INFINEON - IPB044N15N5ATMA1 - Power MOSFET, N Channel, 150 V, 174 A, 0.0034 ohm, TO-263 (D2PAK), Surface Mount | INFINEON - IPB044N15N5ATMA1 - Power MOSFET, N Channel, 150 V, 174 A, 0.0034 ohm, TO-263 (D2PAK), Surface Mount | INFINEON - IPB044N15N5ATMA1 - Power MOSFET, N Channel, 150 V, 174 A, 0.0034 ohm, TO-263 (D2PAK), Surface Mount
| | Footprint | IPB044N15N5ATMA1 | IPB044N15N5ATMA1 | IPB044N15N5ATMA1
| | Ibis Model
| | Library Name | VESC_MotorController.SCHLIB | VESC_MotorController.SCHLIB | VESC_MotorController.SCHLIB
| | Library Reference | IPB044N15N5ATMA1 | IPB044N15N5ATMA1 | IPB044N15N5ATMA1
| | Manufacturer | Infineon | Infineon | Infineon
| | Manufacturer Part Number | IPB044N15N5ATMA1 | IPB044N15N5ATMA1 | IPB044N15N5ATMA1
| | PCB3D
| | Pin Info
| | Price | 12.76 | 12.76 | 12.76
| | Signal Integrity
| | Simulation
| | Supplier | Mouser | Mouser | Mouser
| | Supplier Part Number | 726-IPB044N15N5ATMA1 | 726-IPB044N15N5ATMA1 | 726-IPB044N15N5ATMA1
| | Value | IPB044N15N5ATMA1 | IPB044N15N5ATMA1 | IPB044N15N5ATMA1
Q15 | PowerBoard.SchDoc | | Fitted | Fitted | Fitted
| | Comment | IPB044N15N5ATMA1 | IPB044N15N5ATMA1 | IPB044N15N5ATMA1
| | Component Kind | Standard | Standard | Standard
| | Description | INFINEON - IPB044N15N5ATMA1 - Power MOSFET, N Channel, 150 V, 174 A, 0.0034 ohm, TO-263 (D2PAK), Surface Mount | INFINEON - IPB044N15N5ATMA1 - Power MOSFET, N Channel, 150 V, 174 A, 0.0034 ohm, TO-263 (D2PAK), Surface Mount | INFINEON - IPB044N15N5ATMA1 - Power MOSFET, N Channel, 150 V, 174 A, 0.0034 ohm, TO-263 (D2PAK), Surface Mount
| | Footprint | IPB044N15N5ATMA1 | IPB044N15N5ATMA1 | IPB044N15N5ATMA1
| | Ibis Model
| | Library Name | VESC_MotorController.SCHLIB | VESC_MotorController.SCHLIB | VESC_MotorController.SCHLIB
| | Library Reference | IPB044N15N5ATMA1 | IPB044N15N5ATMA1 | IPB044N15N5ATMA1
| | Manufacturer | Infineon | Infineon | Infineon
| | Manufacturer Part Number | IPB044N15N5ATMA1 | IPB044N15N5ATMA1 | IPB044N15N5ATMA1
| | PCB3D
| | Pin Info
| | Price | 12.76 | 12.76 | 12.76
| | Signal Integrity
| | Simulation
| | Supplier | Mouser | Mouser | Mouser
| | Supplier Part Number | 726-IPB044N15N5ATMA1 | 726-IPB044N15N5ATMA1 | 726-IPB044N15N5ATMA1
| | Value | IPB044N15N5ATMA1 | IPB044N15N5ATMA1 | IPB044N15N5ATMA1
Q16 | PowerBoard.SchDoc | | Fitted | Fitted | Fitted
| | Comment | IPB044N15N5ATMA1 | IPB044N15N5ATMA1 | IPB044N15N5ATMA1
| | Component Kind | Standard | Standard | Standard
| | Description | INFINEON - IPB044N15N5ATMA1 - Power MOSFET, N Channel, 150 V, 174 A, 0.0034 ohm, TO-263 (D2PAK), Surface Mount | INFINEON - IPB044N15N5ATMA1 - Power MOSFET, N Channel, 150 V, 174 A, 0.0034 ohm, TO-263 (D2PAK), Surface Mount | INFINEON - IPB044N15N5ATMA1 - Power MOSFET, N Channel, 150 V, 174 A, 0.0034 ohm, TO-263 (D2PAK), Surface Mount
| | Footprint | IPB044N15N5ATMA1 | IPB044N15N5ATMA1 | IPB044N15N5ATMA1
| | Ibis Model
| | Library Name | VESC_MotorController.SCHLIB | VESC_MotorController.SCHLIB | VESC_MotorController.SCHLIB
| | Library Reference | IPB044N15N5ATMA1 | IPB044N15N5ATMA1 | IPB044N15N5ATMA1
| | Manufacturer | Infineon | Infineon | Infineon
| | Manufacturer Part Number | IPB044N15N5ATMA1 | IPB044N15N5ATMA1 | IPB044N15N5ATMA1
| | PCB3D
| | Pin Info
| | Price | 12.76 | 12.76 | 12.76
| | Signal Integrity
| | Simulation
| | Supplier | Mouser | Mouser | Mouser
| | Supplier Part Number | 726-IPB044N15N5ATMA1 | 726-IPB044N15N5ATMA1 | 726-IPB044N15N5ATMA1
| | Value | IPB044N15N5ATMA1 | IPB044N15N5ATMA1 | IPB044N15N5ATMA1
Q17 | PowerBoard.SchDoc | | Fitted | Fitted | Fitted
| | Comment | IPB044N15N5ATMA1 | IPB044N15N5ATMA1 | IPB044N15N5ATMA1
| | Component Kind | Standard | Standard | Standard
| | Description | INFINEON - IPB044N15N5ATMA1 - Power MOSFET, N Channel, 150 V, 174 A, 0.0034 ohm, TO-263 (D2PAK), Surface Mount | INFINEON - IPB044N15N5ATMA1 - Power MOSFET, N Channel, 150 V, 174 A, 0.0034 ohm, TO-263 (D2PAK), Surface Mount | INFINEON - IPB044N15N5ATMA1 - Power MOSFET, N Channel, 150 V, 174 A, 0.0034 ohm, TO-263 (D2PAK), Surface Mount
| | Footprint | IPB044N15N5ATMA1 | IPB044N15N5ATMA1 | IPB044N15N5ATMA1
| | Ibis Model
| | Library Name | VESC_MotorController.SCHLIB | VESC_MotorController.SCHLIB | VESC_MotorController.SCHLIB
| | Library Reference | IPB044N15N5ATMA1 | IPB044N15N5ATMA1 | IPB044N15N5ATMA1
| | Manufacturer | Infineon | Infineon | Infineon
| | Manufacturer Part Number | IPB044N15N5ATMA1 | IPB044N15N5ATMA1 | IPB044N15N5ATMA1
| | PCB3D
| | Pin Info
| | Price | 12.76 | 12.76 | 12.76
| | Signal Integrity
| | Simulation
| | Supplier | Mouser | Mouser | Mouser
| | Supplier Part Number | 726-IPB044N15N5ATMA1 | 726-IPB044N15N5ATMA1 | 726-IPB044N15N5ATMA1
| | Value | IPB044N15N5ATMA1 | IPB044N15N5ATMA1 | IPB044N15N5ATMA1
Q18 | PowerBoard.SchDoc | | Fitted | Fitted | Fitted
| | Comment | IPB044N15N5ATMA1 | IPB044N15N5ATMA1 | IPB044N15N5ATMA1
| | Component Kind | Standard | Standard | Standard
| | Description | INFINEON - IPB044N15N5ATMA1 - Power MOSFET, N Channel, 150 V, 174 A, 0.0034 ohm, TO-263 (D2PAK), Surface Mount | INFINEON - IPB044N15N5ATMA1 - Power MOSFET, N Channel, 150 V, 174 A, 0.0034 ohm, TO-263 (D2PAK), Surface Mount | INFINEON - IPB044N15N5ATMA1 - Power MOSFET, N Channel, 150 V, 174 A, 0.0034 ohm, TO-263 (D2PAK), Surface Mount
| | Footprint | IPB044N15N5ATMA1 | IPB044N15N5ATMA1 | IPB044N15N5ATMA1
| | Ibis Model
| | Library Name | VESC_MotorController.SCHLIB | VESC_MotorController.SCHLIB | VESC_MotorController.SCHLIB
| | Library Reference | IPB044N15N5ATMA1 | IPB044N15N5ATMA1 | IPB044N15N5ATMA1
| | Manufacturer | Infineon | Infineon | Infineon
| | Manufacturer Part Number | IPB044N15N5ATMA1 | IPB044N15N5ATMA1 | IPB044N15N5ATMA1
| | PCB3D
| | Pin Info
| | Price | 12.76 | 12.76 | 12.76
| | Signal Integrity
| | Simulation
| | Supplier | Mouser | Mouser | Mouser
| | Supplier Part Number | 726-IPB044N15N5ATMA1 | 726-IPB044N15N5ATMA1 | 726-IPB044N15N5ATMA1
| | Value | IPB044N15N5ATMA1 | IPB044N15N5ATMA1 | IPB044N15N5ATMA1
Q19 | PowerBoard.SchDoc | | Fitted | Fitted | Fitted
| | Comment | IPB044N15N5ATMA1 | IPB044N15N5ATMA1 | IPB044N15N5ATMA1
| | Component Kind | Standard | Standard | Standard
| | Description | INFINEON - IPB044N15N5ATMA1 - Power MOSFET, N Channel, 150 V, 174 A, 0.0034 ohm, TO-263 (D2PAK), Surface Mount | INFINEON - IPB044N15N5ATMA1 - Power MOSFET, N Channel, 150 V, 174 A, 0.0034 ohm, TO-263 (D2PAK), Surface Mount | INFINEON - IPB044N15N5ATMA1 - Power MOSFET, N Channel, 150 V, 174 A, 0.0034 ohm, TO-263 (D2PAK), Surface Mount
| | Footprint | IPB044N15N5ATMA1 | IPB044N15N5ATMA1 | IPB044N15N5ATMA1
| | Ibis Model
| | Library Name | VESC_MotorController.SCHLIB | VESC_MotorController.SCHLIB | VESC_MotorController.SCHLIB
| | Library Reference | IPB044N15N5ATMA1 | IPB044N15N5ATMA1 | IPB044N15N5ATMA1
| | Manufacturer | Infineon | Infineon | Infineon
| | Manufacturer Part Number | IPB044N15N5ATMA1 | IPB044N15N5ATMA1 | IPB044N15N5ATMA1
| | PCB3D
| | Pin Info
| | Price | 12.76 | 12.76 | 12.76
| | Signal Integrity
| | Simulation
| | Supplier | Mouser | Mouser | Mouser
| | Supplier Part Number | 726-IPB044N15N5ATMA1 | 726-IPB044N15N5ATMA1 | 726-IPB044N15N5ATMA1
| | Value | IPB044N15N5ATMA1 | IPB044N15N5ATMA1 | IPB044N15N5ATMA1
Q20 | PowerBoard.SchDoc | | Fitted | Fitted | Fitted
| | Comment | IPB044N15N5ATMA1 | IPB044N15N5ATMA1 | IPB044N15N5ATMA1
| | Component Kind | Standard | Standard | Standard
| | Description | INFINEON - IPB044N15N5ATMA1 - Power MOSFET, N Channel, 150 V, 174 A, 0.0034 ohm, TO-263 (D2PAK), Surface Mount | INFINEON - IPB044N15N5ATMA1 - Power MOSFET, N Channel, 150 V, 174 A, 0.0034 ohm, TO-263 (D2PAK), Surface Mount | INFINEON - IPB044N15N5ATMA1 - Power MOSFET, N Channel, 150 V, 174 A, 0.0034 ohm, TO-263 (D2PAK), Surface Mount
| | Footprint | IPB044N15N5ATMA1 | IPB044N15N5ATMA1 | IPB044N15N5ATMA1
| | Ibis Model
| | Library Name | VESC_MotorController.SCHLIB | VESC_MotorController.SCHLIB | VESC_MotorController.SCHLIB
| | Library Reference | IPB044N15N5ATMA1 | IPB044N15N5ATMA1 | IPB044N15N5ATMA1
| | Manufacturer | Infineon | Infineon | Infineon
| | Manufacturer Part Number | IPB044N15N5ATMA1 | IPB044N15N5ATMA1 | IPB044N15N5ATMA1
| | PCB3D
| | Pin Info
| | Price | 12.76 | 12.76 | 12.76
| | Signal Integrity
| | Simulation
| | Supplier | Mouser | Mouser | Mouser
| | Supplier Part Number | 726-IPB044N15N5ATMA1 | 726-IPB044N15N5ATMA1 | 726-IPB044N15N5ATMA1
| | Value | IPB044N15N5ATMA1 | IPB044N15N5ATMA1 | IPB044N15N5ATMA1
Q21 | PowerBoard.SchDoc | | Fitted | Fitted | Fitted
| | Comment | IPB044N15N5ATMA1 | IPB044N15N5ATMA1 | IPB044N15N5ATMA1
| | Component Kind | Standard | Standard | Standard
| | Description | INFINEON - IPB044N15N5ATMA1 - Power MOSFET, N Channel, 150 V, 174 A, 0.0034 ohm, TO-263 (D2PAK), Surface Mount | INFINEON - IPB044N15N5ATMA1 - Power MOSFET, N Channel, 150 V, 174 A, 0.0034 ohm, TO-263 (D2PAK), Surface Mount | INFINEON - IPB044N15N5ATMA1 - Power MOSFET, N Channel, 150 V, 174 A, 0.0034 ohm, TO-263 (D2PAK), Surface Mount
| | Footprint | IPB044N15N5ATMA1 | IPB044N15N5ATMA1 | IPB044N15N5ATMA1
| | Ibis Model
| | Library Name | VESC_MotorController.SCHLIB | VESC_MotorController.SCHLIB | VESC_MotorController.SCHLIB
| | Library Reference | IPB044N15N5ATMA1 | IPB044N15N5ATMA1 | IPB044N15N5ATMA1
| | Manufacturer | Infineon | Infineon | Infineon
| | Manufacturer Part Number | IPB044N15N5ATMA1 | IPB044N15N5ATMA1 | IPB044N15N5ATMA1
| | PCB3D
| | Pin Info
| | Price | 12.76 | 12.76 | 12.76
| | Signal Integrity
| | Simulation
| | Supplier | Mouser | Mouser | Mouser
| | Supplier Part Number | 726-IPB044N15N5ATMA1 | 726-IPB044N15N5ATMA1 | 726-IPB044N15N5ATMA1
| | Value | IPB044N15N5ATMA1 | IPB044N15N5ATMA1 | IPB044N15N5ATMA1
Q22 | PowerBoard.SchDoc | | Fitted | Fitted | Fitted
| | Comment | IPB044N15N5ATMA1 | IPB044N15N5ATMA1 | IPB044N15N5ATMA1
| | Component Kind | Standard | Standard | Standard
| | Description | INFINEON - IPB044N15N5ATMA1 - Power MOSFET, N Channel, 150 V, 174 A, 0.0034 ohm, TO-263 (D2PAK), Surface Mount | INFINEON - IPB044N15N5ATMA1 - Power MOSFET, N Channel, 150 V, 174 A, 0.0034 ohm, TO-263 (D2PAK), Surface Mount | INFINEON - IPB044N15N5ATMA1 - Power MOSFET, N Channel, 150 V, 174 A, 0.0034 ohm, TO-263 (D2PAK), Surface Mount
| | Footprint | IPB044N15N5ATMA1 | IPB044N15N5ATMA1 | IPB044N15N5ATMA1
| | Ibis Model
| | Library Name | VESC_MotorController.SCHLIB | VESC_MotorController.SCHLIB | VESC_MotorController.SCHLIB
| | Library Reference | IPB044N15N5ATMA1 | IPB044N15N5ATMA1 | IPB044N15N5ATMA1
| | Manufacturer | Infineon | Infineon | Infineon
| | Manufacturer Part Number | IPB044N15N5ATMA1 | IPB044N15N5ATMA1 | IPB044N15N5ATMA1
| | PCB3D
| | Pin Info
| | Price | 12.76 | 12.76 | 12.76
| | Signal Integrity
| | Simulation
| | Supplier | Mouser | Mouser | Mouser
| | Supplier Part Number | 726-IPB044N15N5ATMA1 | 726-IPB044N15N5ATMA1 | 726-IPB044N15N5ATMA1
| | Value | IPB044N15N5ATMA1 | IPB044N15N5ATMA1 | IPB044N15N5ATMA1
Q23 | PowerBoard.SchDoc | | Fitted | Fitted | Fitted
| | Comment | IPB044N15N5ATMA1 | IPB044N15N5ATMA1 | IPB044N15N5ATMA1
| | Component Kind | Standard | Standard | Standard
| | Description | INFINEON - IPB044N15N5ATMA1 - Power MOSFET, N Channel, 150 V, 174 A, 0.0034 ohm, TO-263 (D2PAK), Surface Mount | INFINEON - IPB044N15N5ATMA1 - Power MOSFET, N Channel, 150 V, 174 A, 0.0034 ohm, TO-263 (D2PAK), Surface Mount | INFINEON - IPB044N15N5ATMA1 - Power MOSFET, N Channel, 150 V, 174 A, 0.0034 ohm, TO-263 (D2PAK), Surface Mount
| | Footprint | IPB044N15N5ATMA1 | IPB044N15N5ATMA1 | IPB044N15N5ATMA1
| | Ibis Model
| | Library Name | VESC_MotorController.SCHLIB | VESC_MotorController.SCHLIB | VESC_MotorController.SCHLIB
| | Library Reference | IPB044N15N5ATMA1 | IPB044N15N5ATMA1 | IPB044N15N5ATMA1
| | Manufacturer | Infineon | Infineon | Infineon
| | Manufacturer Part Number | IPB044N15N5ATMA1 | IPB044N15N5ATMA1 | IPB044N15N5ATMA1
| | PCB3D
| | Pin Info
| | Price | 12.76 | 12.76 | 12.76
| | Signal Integrity
| | Simulation
| | Supplier | Mouser | Mouser | Mouser
| | Supplier Part Number | 726-IPB044N15N5ATMA1 | 726-IPB044N15N5ATMA1 | 726-IPB044N15N5ATMA1
| | Value | IPB044N15N5ATMA1 | IPB044N15N5ATMA1 | IPB044N15N5ATMA1
Q24 | PowerBoard.SchDoc | | Fitted | Fitted | Fitted
| | Comment | IPB044N15N5ATMA1 | IPB044N15N5ATMA1 | IPB044N15N5ATMA1
| | Component Kind | Standard | Standard | Standard
| | Description | INFINEON - IPB044N15N5ATMA1 - Power MOSFET, N Channel, 150 V, 174 A, 0.0034 ohm, TO-263 (D2PAK), Surface Mount | INFINEON - IPB044N15N5ATMA1 - Power MOSFET, N Channel, 150 V, 174 A, 0.0034 ohm, TO-263 (D2PAK), Surface Mount | INFINEON - IPB044N15N5ATMA1 - Power MOSFET, N Channel, 150 V, 174 A, 0.0034 ohm, TO-263 (D2PAK), Surface Mount
| | Footprint | IPB044N15N5ATMA1 | IPB044N15N5ATMA1 | IPB044N15N5ATMA1
| | Ibis Model
| | Library Name | VESC_MotorController.SCHLIB | VESC_MotorController.SCHLIB | VESC_MotorController.SCHLIB
| | Library Reference | IPB044N15N5ATMA1 | IPB044N15N5ATMA1 | IPB044N15N5ATMA1
| | Manufacturer | Infineon | Infineon | Infineon
| | Manufacturer Part Number | IPB044N15N5ATMA1 | IPB044N15N5ATMA1 | IPB044N15N5ATMA1
| | PCB3D
| | Pin Info
| | Price | 12.76 | 12.76 | 12.76
| | Signal Integrity
| | Simulation
| | Supplier | Mouser | Mouser | Mouser
| | Supplier Part Number | 726-IPB044N15N5ATMA1 | 726-IPB044N15N5ATMA1 | 726-IPB044N15N5ATMA1
| | Value | IPB044N15N5ATMA1 | IPB044N15N5ATMA1 | IPB044N15N5ATMA1
R1 | PowerBoard.SchDoc | | Fitted | Fitted | Fitted
| | Comment | 2.2R | 2.2R | 2.2R
| | Component Kind | Standard | Standard | Standard
| | Description | 2.2 ohm 0.25W ±1% | 2.2 ohm 0.25W ±1% | 2.2 ohm 0.25W ±1%
| | Footprint | R1206 | R1206 | R1206
| | Ibis Model
| | Library Name | VESC_MotorController.SCHLIB | VESC_MotorController.SCHLIB | VESC_MotorController.SCHLIB
| | Library Reference | 2.2ohm 0.25W ±1% | 2.2ohm 0.25W ±1% | 2.2ohm 0.25W ±1%
| | Manufacturer | Yageo | Yageo | Yageo
| | Manufacturer Part Number | RC1206FR-072R2L | RC1206FR-072R2L | RC1206FR-072R2L
| | PCB3D
| | Pin Info
| | Price | 0.12 | 0.12 | 0.12
| | Signal Integrity
| | Simulation
| | Supplier | Mouser | Mouser | Mouser
| | Supplier Part Number | 603-RC1206FR-072R2L | 603-RC1206FR-072R2L | 603-RC1206FR-072R2L
| | Value | 2.2R | 2.2R | 2.2R
R2 | PowerBoard.SchDoc | | Fitted | Fitted | Fitted
| | Comment | 0.5mR/9W | 0.5mR/9W | 0.5mR/9W
| | Component Kind | Standard | Standard | Standard
| | Description | Current Sense Resistors - SMD 0.5mOHMS 9W 1% AEC-Q200 | Current Sense Resistors - SMD 0.5mOHMS 9W 1% AEC-Q200 | Current Sense Resistors - SMD 0.5mOHMS 9W 1% AEC-Q200
| | Footprint | RESC10052X137N | RESC10052X137N | RESC10052X137N
| | Ibis Model
| | Library Name | VESC_MotorController.SCHLIB | VESC_MotorController.SCHLIB | VESC_MotorController.SCHLIB
| | Library Reference | CSS2H-3920R-L500FE | CSS2H-3920R-L500FE | CSS2H-3920R-L500FE
| | Manufacturer | Bourns | Bourns | Bourns
| | Manufacturer Part Number | CSS2H-3920R-L500FE | CSS2H-3920R-L500FE | CSS2H-3920R-L500FE
| | PCB3D
| | Pin Info
| | Price | 2 | 2 | 2
| | Signal Integrity
| | Simulation
| | Supplier | Mouser | Mouser | Mouser
| | Supplier Part Number | 652-CSS2H3920RL500FE | 652-CSS2H3920RL500FE | 652-CSS2H3920RL500FE
| | Value | 0.5ohm 9W | 0.5ohm 9W | 0.5ohm 9W
R3 | PowerBoard.SchDoc | | Fitted | Fitted | Fitted
| | Comment | 0.5mR/9W | 0.5mR/9W | 0.5mR/9W
| | Component Kind | Standard | Standard | Standard
| | Description | Current Sense Resistors - SMD 0.5mOHMS 9W 1% AEC-Q200 | Current Sense Resistors - SMD 0.5mOHMS 9W 1% AEC-Q200 | Current Sense Resistors - SMD 0.5mOHMS 9W 1% AEC-Q200
| | Footprint | RESC10052X137N | RESC10052X137N | RESC10052X137N
| | Ibis Model
| | Library Name | VESC_MotorController.SCHLIB | VESC_MotorController.SCHLIB | VESC_MotorController.SCHLIB
| | Library Reference | CSS2H-3920R-L500FE | CSS2H-3920R-L500FE | CSS2H-3920R-L500FE
| | Manufacturer | Bourns | Bourns | Bourns
| | Manufacturer Part Number | CSS2H-3920R-L500FE | CSS2H-3920R-L500FE | CSS2H-3920R-L500FE
| | PCB3D
| | Pin Info
| | Price | 2 | 2 | 2
| | Signal Integrity
| | Simulation
| | Supplier | Mouser | Mouser | Mouser
| | Supplier Part Number | 652-CSS2H3920RL500FE | 652-CSS2H3920RL500FE | 652-CSS2H3920RL500FE
| | Value | 0.5ohm 9W | 0.5ohm 9W | 0.5ohm 9W
R4 | PowerBoard.SchDoc | | Fitted | Fitted | Fitted
| | Comment | 39k | 39k | 39k
| | Component Kind | Standard | Standard | Standard
| | Description | 39 kOhms ±1% 0.8W | 39 kOhms ±1% 0.8W | 39 kOhms ±1% 0.8W
| | Footprint | R0805 | R0805 | R0805
| | Ibis Model
| | Library Name | VESC_MotorController.SCHLIB | VESC_MotorController.SCHLIB | VESC_MotorController.SCHLIB
| | Library Reference | 39 kOhms ±1% 0.8W | 39 kOhms ±1% 0.8W | 39 kOhms ±1% 0.8W
| | Manufacturer | Yageo | Yageo | Yageo
| | Manufacturer Part Number | RT0805FRE0739KL | RT0805FRE0739KL | RT0805FRE0739KL
| | PCB3D
| | Pin Info
| | Price | 0.1 | 0.1 | 0.1
| | Signal Integrity
| | Simulation
| | Supplier | mouser | mouser | mouser
| | Supplier Part Number | 603-RT0805FRE0739KL | 603-RT0805FRE0739KL | 603-RT0805FRE0739KL
| | Value | 39k | 39k | 39k
R5 | PowerBoard.SchDoc | | Fitted | Fitted | Fitted
| | Comment | 4.7R | 4.7R | 4.7R
| | Component Kind | Standard | Standard | Standard
| | Description | 4.7 ohm 0.25W ±1% | 4.7 ohm 0.25W ±1% | 4.7 ohm 0.25W ±1%
| | Footprint | R1206 | R1206 | R1206
| | Ibis Model
| | Library Name | VESC_MotorController.SCHLIB | VESC_MotorController.SCHLIB | VESC_MotorController.SCHLIB
| | Library Reference | 4.7 ohm 0.25W ±1% | 4.7 ohm 0.25W ±1% | 4.7 ohm 0.25W ±1%
| | Manufacturer | Yageo | Yageo | Yageo
| | Manufacturer Part Number | RC1206FR-074R7L | RC1206FR-074R7L | RC1206FR-074R7L
| | PCB3D
| | Pin Info
| | Price | 0.12 | 0.12 | 0.12
| | Signal Integrity
| | Simulation
| | Supplier | Mouser | Mouser | Mouser
| | Supplier Part Number | 603-RC1206FR-074R7L | 603-RC1206FR-074R7L | 603-RC1206FR-074R7L
| | Value | 4.7R | 4.7R | 4.7R
R6 | PowerBoard.SchDoc | | Fitted | Fitted | Fitted
| | Comment | 0.5mR/9W | 0.5mR/9W | 0.5mR/9W
| | Component Kind | Standard | Standard | Standard
| | Description | Current Sense Resistors - SMD 0.5mOHMS 9W 1% AEC-Q200 | Current Sense Resistors - SMD 0.5mOHMS 9W 1% AEC-Q200 | Current Sense Resistors - SMD 0.5mOHMS 9W 1% AEC-Q200
| | Footprint | RESC10052X137N | RESC10052X137N | RESC10052X137N
| | Ibis Model
| | Library Name | VESC_MotorController.SCHLIB | VESC_MotorController.SCHLIB | VESC_MotorController.SCHLIB
| | Library Reference | CSS2H-3920R-L500FE | CSS2H-3920R-L500FE | CSS2H-3920R-L500FE
| | Manufacturer | Bourns | Bourns | Bourns
| | Manufacturer Part Number | CSS2H-3920R-L500FE | CSS2H-3920R-L500FE | CSS2H-3920R-L500FE
| | PCB3D
| | Pin Info
| | Price | 2 | 2 | 2
| | Signal Integrity
| | Simulation
| | Supplier | Mouser | Mouser | Mouser
| | Supplier Part Number | 652-CSS2H3920RL500FE | 652-CSS2H3920RL500FE | 652-CSS2H3920RL500FE
| | Value | 0.5ohm 9W | 0.5ohm 9W | 0.5ohm 9W
R7 | PowerBoard.SchDoc | | Fitted | Fitted | Fitted
| | Comment | 20R | 20R | 20R
| | Component Kind | Standard | Standard | Standard
| | Description | 20 ohm 0.25W ±1% | 20 ohm 0.25W ±1% | 20 ohm 0.25W ±1%
| | Footprint | R1206 | R1206 | R1206
| | Ibis Model
| | Library Name | VESC_MotorController.SCHLIB | VESC_MotorController.SCHLIB | VESC_MotorController.SCHLIB
| | Library Reference | 20 ohm 0.25W ±1% | 20 ohm 0.25W ±1% | 20 ohm 0.25W ±1%
| | Manufacturer | Yageo | Yageo | Yageo
| | Manufacturer Part Number | RC1206FR-0720RL | RC1206FR-0720RL | RC1206FR-0720RL
| | PCB3D
| | Pin Info
| | Price | 0.12 | 0.12 | 0.12
| | Signal Integrity
| | Simulation
| | Supplier | Mouser | Mouser | Mouser
| | Supplier Part Number | 603-RC1206FR-0720RL | 603-RC1206FR-0720RL | 603-RC1206FR-0720RL
| | Value | 20R | 20R | 20R
R8 | PowerBoard.SchDoc | | Fitted | Fitted | Fitted
| | Comment | 2.2k | 2.2k | 2.2k
| | Component Kind | Standard | Standard | Standard
| | Description | 2.2 kOhms ±1% 0.1W | 2.2 kOhms ±1% 0.1W | 2.2 kOhms ±1% 0.1W
| | Footprint | R0603 | R0603 | R0603
| | Ibis Model
| | Library Name | VESC_MotorController.SCHLIB | VESC_MotorController.SCHLIB | VESC_MotorController.SCHLIB
| | Library Reference | 2.2 kOhms ±1% 0.1W | 2.2 kOhms ±1% 0.1W | 2.2 kOhms ±1% 0.1W
| | Manufacturer | Yageo | Yageo | Yageo
| | Manufacturer Part Number | RC0603FR-072K2L | RC0603FR-072K2L | RC0603FR-072K2L
| | PCB3D
| | Pin Info
| | Price | 0.1 | 0.1 | 0.1
| | Signal Integrity
| | Simulation
| | Supplier | Mouser | Mouser | Mouser
| | Supplier Part Number | 603-RC0603FR-072K2L | 603-RC0603FR-072K2L | 603-RC0603FR-072K2L
| | Value | 2.2k | 2.2k | 2.2k
R9 | PowerBoard.SchDoc | | Fitted | Fitted | Fitted
| | Comment | 2.2k | 2.2k | 2.2k
| | Component Kind | Standard | Standard | Standard
| | Description | 2.2 kOhms ±1% 0.1W | 2.2 kOhms ±1% 0.1W | 2.2 kOhms ±1% 0.1W
| | Footprint | R0603 | R0603 | R0603
| | Ibis Model
| | Library Name | VESC_MotorController.SCHLIB | VESC_MotorController.SCHLIB | VESC_MotorController.SCHLIB
| | Library Reference | 2.2 kOhms ±1% 0.1W | 2.2 kOhms ±1% 0.1W | 2.2 kOhms ±1% 0.1W
| | Manufacturer | Yageo | Yageo | Yageo
| | Manufacturer Part Number | RC0603FR-072K2L | RC0603FR-072K2L | RC0603FR-072K2L
| | PCB3D
| | Pin Info
| | Price | 0.1 | 0.1 | 0.1
| | Signal Integrity
| | Simulation
| | Supplier | Mouser | Mouser | Mouser
| | Supplier Part Number | 603-RC0603FR-072K2L | 603-RC0603FR-072K2L | 603-RC0603FR-072K2L
| | Value | 2.2k | 2.2k | 2.2k
R10 | PowerBoard.SchDoc | | Fitted | Fitted | Fitted
| | Comment | 2.2k | 2.2k | 2.2k
| | Component Kind | Standard | Standard | Standard
| | Description | 2.2 kOhms ±1% 0.1W | 2.2 kOhms ±1% 0.1W | 2.2 kOhms ±1% 0.1W
| | Footprint | R0603 | R0603 | R0603
| | Ibis Model
| | Library Name | VESC_MotorController.SCHLIB | VESC_MotorController.SCHLIB | VESC_MotorController.SCHLIB
| | Library Reference | 2.2 kOhms ±1% 0.1W | 2.2 kOhms ±1% 0.1W | 2.2 kOhms ±1% 0.1W
| | Manufacturer | Yageo | Yageo | Yageo
| | Manufacturer Part Number | RC0603FR-072K2L | RC0603FR-072K2L | RC0603FR-072K2L
| | PCB3D
| | Pin Info
| | Price | 0.1 | 0.1 | 0.1
| | Signal Integrity
| | Simulation
| | Supplier | Mouser | Mouser | Mouser
| | Supplier Part Number | 603-RC0603FR-072K2L | 603-RC0603FR-072K2L | 603-RC0603FR-072K2L
| | Value | 2.2k | 2.2k | 2.2k
R11 | PowerBoard.SchDoc | | Fitted | Fitted | Fitted
| | Comment | 0.5mR/9W | 0.5mR/9W | 0.5mR/9W
| | Component Kind | Standard | Standard | Standard
| | Description | Current Sense Resistors - SMD 0.5mOHMS 9W 1% AEC-Q200 | Current Sense Resistors - SMD 0.5mOHMS 9W 1% AEC-Q200 | Current Sense Resistors - SMD 0.5mOHMS 9W 1% AEC-Q200
| | Footprint | RESC10052X137N | RESC10052X137N | RESC10052X137N
| | Ibis Model
| | Library Name | VESC_MotorController.SCHLIB | VESC_MotorController.SCHLIB | VESC_MotorController.SCHLIB
| | Library Reference | CSS2H-3920R-L500FE | CSS2H-3920R-L500FE | CSS2H-3920R-L500FE
| | Manufacturer | Bourns | Bourns | Bourns
| | Manufacturer Part Number | CSS2H-3920R-L500FE | CSS2H-3920R-L500FE | CSS2H-3920R-L500FE
| | PCB3D
| | Pin Info
| | Price | 2 | 2 | 2
| | Signal Integrity
| | Simulation
| | Supplier | Mouser | Mouser | Mouser
| | Supplier Part Number | 652-CSS2H3920RL500FE | 652-CSS2H3920RL500FE | 652-CSS2H3920RL500FE
| | Value | 0.5ohm 9W | 0.5ohm 9W | 0.5ohm 9W
R12 | PowerBoard.SchDoc | | Fitted | Fitted | Fitted
| | Comment | 2.2k | 2.2k | 2.2k
| | Component Kind | Standard | Standard | Standard
| | Description | 2.2 kOhms ±1% 0.8W | 2.2 kOhms ±1% 0.8W | 2.2 kOhms ±1% 0.8W
| | Footprint | R0805 | R0805 | R0805
| | Ibis Model
| | Library Name | VESC_MotorController.SCHLIB | VESC_MotorController.SCHLIB | VESC_MotorController.SCHLIB
| | Library Reference | 2.2 kOhms ±1% 0.8W | 2.2 kOhms ±1% 0.8W | 2.2 kOhms ±1% 0.8W
| | Manufacturer | Yageo | Yageo | Yageo
| | Manufacturer Part Number | RT0805FRE072K2L | RT0805FRE072K2L | RT0805FRE072K2L
| | PCB3D
| | Pin Info
| | Price | 0.1 | 0.1 | 0.1
| | Signal Integrity
| | Simulation
| | Supplier | mouser | mouser | mouser
| | Supplier Part Number | 603-RT0805FRE072K2L | 603-RT0805FRE072K2L | 603-RT0805FRE072K2L
| | Value | 2.2k | 2.2k | 2.2k
R13 | PowerBoard.SchDoc | | Fitted | Fitted | Fitted
| | Comment | 20R | 20R | 20R
| | Component Kind | Standard | Standard | Standard
| | Description | 20 ohm 0.25W ±1% | 20 ohm 0.25W ±1% | 20 ohm 0.25W ±1%
| | Footprint | R1206 | R1206 | R1206
| | Ibis Model
| | Library Name | VESC_MotorController.SCHLIB | VESC_MotorController.SCHLIB | VESC_MotorController.SCHLIB
| | Library Reference | 20ohm 0.25W ±1% | 20ohm 0.25W ±1% | 20ohm 0.25W ±1%
| | Manufacturer | Yageo | Yageo | Yageo
| | Manufacturer Part Number | RC1206FR-0720RL | RC1206FR-0720RL | RC1206FR-0720RL
| | PCB3D
| | Pin Info
| | Price | 0.12 | 0.12 | 0.12
| | Signal Integrity
| | Simulation
| | Supplier | Mouser | Mouser | Mouser
| | Supplier Part Number | 603-RC1206FR-0720RL | 603-RC1206FR-0720RL | 603-RC1206FR-0720RL
| | Value | 20R | 20R | 20R
R14 | PowerBoard.SchDoc | | Fitted | Fitted | Fitted
| | Comment | 0.5mR/9W | 0.5mR/9W | 0.5mR/9W
| | Component Kind | Standard | Standard | Standard
| | Description | Current Sense Resistors - SMD 0.5mOHMS 9W 1% AEC-Q200 | Current Sense Resistors - SMD 0.5mOHMS 9W 1% AEC-Q200 | Current Sense Resistors - SMD 0.5mOHMS 9W 1% AEC-Q200
| | Footprint | RESC10052X137N | RESC10052X137N | RESC10052X137N
| | Ibis Model
| | Library Name | VESC_MotorController.SCHLIB | VESC_MotorController.SCHLIB | VESC_MotorController.SCHLIB
| | Library Reference | CSS2H-3920R-L500FE | CSS2H-3920R-L500FE | CSS2H-3920R-L500FE
| | Manufacturer | Bourns | Bourns | Bourns
| | Manufacturer Part Number | CSS2H-3920R-L500FE | CSS2H-3920R-L500FE | CSS2H-3920R-L500FE
| | PCB3D
| | Pin Info
| | Price | 2 | 2 | 2
| | Signal Integrity
| | Simulation
| | Supplier | Mouser | Mouser | Mouser
| | Supplier Part Number | 652-CSS2H3920RL500FE | 652-CSS2H3920RL500FE | 652-CSS2H3920RL500FE
| | Value | 0.5ohm 9W | 0.5ohm 9W | 0.5ohm 9W
R15 | PowerBoard.SchDoc | | Fitted | Fitted | Fitted
| | Comment | 20R | 20R | 20R
| | Component Kind | Standard | Standard | Standard
| | Description | 20 ohm 0.25W ±1% | 20 ohm 0.25W ±1% | 20 ohm 0.25W ±1%
| | Footprint | R1206 | R1206 | R1206
| | Ibis Model
| | Library Name | VESC_MotorController.SCHLIB | VESC_MotorController.SCHLIB | VESC_MotorController.SCHLIB
| | Library Reference | 20ohm 0.25W ±1% | 20ohm 0.25W ±1% | 20ohm 0.25W ±1%
| | Manufacturer | Yageo | Yageo | Yageo
| | Manufacturer Part Number | RC1206FR-0720RL | RC1206FR-0720RL | RC1206FR-0720RL
| | PCB3D
| | Pin Info
| | Price | 0.12 | 0.12 | 0.12
| | Signal Integrity
| | Simulation
| | Supplier | Mouser | Mouser | Mouser
| | Supplier Part Number | 603-RC1206FR-0720RL | 603-RC1206FR-0720RL | 603-RC1206FR-0720RL
| | Value | 20R | 20R | 20R
R16 | PowerBoard.SchDoc | | Fitted | Fitted | Fitted
| | Comment | 20R | 20R | 20R
| | Component Kind | Standard | Standard | Standard
| | Description | 20 ohm 0.25W ±1% | 20 ohm 0.25W ±1% | 20 ohm 0.25W ±1%
| | Footprint | R1206 | R1206 | R1206
| | Ibis Model
| | Library Name | VESC_MotorController.SCHLIB | VESC_MotorController.SCHLIB | VESC_MotorController.SCHLIB
| | Library Reference | 20ohm 0.25W ±1% | 20ohm 0.25W ±1% | 20ohm 0.25W ±1%
| | Manufacturer | Yageo | Yageo | Yageo
| | Manufacturer Part Number | RC1206FR-0720RL | RC1206FR-0720RL | RC1206FR-0720RL
| | PCB3D
| | Pin Info
| | Price | 0.12 | 0.12 | 0.12
| | Signal Integrity
| | Simulation
| | Supplier | Mouser | Mouser | Mouser
| | Supplier Part Number | 603-RC1206FR-0720RL | 603-RC1206FR-0720RL | 603-RC1206FR-0720RL
| | Value | 20R | 20R | 20R
R17 | PowerBoard.SchDoc | | Fitted | Fitted | Fitted
| | Comment | 1k | 1k | 1k
| | Component Kind | Standard | Standard | Standard
| | Description | 1 kOhms ±1% 0.1W | 1 kOhms ±1% 0.1W | 1 kOhms ±1% 0.1W
| | Footprint | R0603 | R0603 | R0603
| | Ibis Model
| | Library Name | VESC_MotorController.SCHLIB | VESC_MotorController.SCHLIB | VESC_MotorController.SCHLIB
| | Library Reference | 1 kOhms ±1% 0.1W | 1 kOhms ±1% 0.1W | 1 kOhms ±1% 0.1W
| | Manufacturer | Yageo | Yageo | Yageo
| | Manufacturer Part Number | RC0603FR-071KL | RC0603FR-071KL | RC0603FR-071KL
| | PCB3D
| | Pin Info
| | Price | 0.1 | 0.1 | 0.1
| | Signal Integrity
| | Simulation
| | Supplier | Mouser | Mouser | Mouser
| | Supplier Part Number | 603-RC0603FR-071KL | 603-RC0603FR-071KL | 603-RC0603FR-071KL
| | Value | 1k | 1k | 1k
R18 | PowerBoard.SchDoc | | Fitted | Fitted | Fitted
| | Comment | 39k | 39k | 39k
| | Component Kind | Standard | Standard | Standard
| | Description | 39 kOhms ±1% 0.8W | 39 kOhms ±1% 0.8W | 39 kOhms ±1% 0.8W
| | Footprint | R0805 | R0805 | R0805
| | Ibis Model
| | Library Name | VESC_MotorController.SCHLIB | VESC_MotorController.SCHLIB | VESC_MotorController.SCHLIB
| | Library Reference | 39 kOhms ±1% 0.8W | 39 kOhms ±1% 0.8W | 39 kOhms ±1% 0.8W
| | Manufacturer | Yageo | Yageo | Yageo
| | Manufacturer Part Number | RT0805FRE0739KL | RT0805FRE0739KL | RT0805FRE0739KL
| | PCB3D
| | Pin Info
| | Price | 0.1 | 0.1 | 0.1
| | Signal Integrity
| | Simulation
| | Supplier | mouser | mouser | mouser
| | Supplier Part Number | 603-RT0805FRE0739KL | 603-RT0805FRE0739KL | 603-RT0805FRE0739KL
| | Value | 39k | 39k | 39k
R19 | PowerBoard.SchDoc | | Fitted | Fitted | Fitted
| | Comment | 10k | 10k | 10k
| | Component Kind | Standard | Standard | Standard
| | Description | 10 kOhms ±1% 0.1W | 10 kOhms ±1% 0.1W | 10 kOhms ±1% 0.1W
| | Footprint | R0603 | R0603 | R0603
| | Ibis Model
| | Library Name | VESC_MotorController.SCHLIB | VESC_MotorController.SCHLIB | VESC_MotorController.SCHLIB
| | Library Reference | 10 kOhms ±1% 0.1W | 10 kOhms ±1% 0.1W | 10 kOhms ±1% 0.1W
| | Manufacturer | Yageo | Yageo | Yageo
| | Manufacturer Part Number | RC0603FR-0710KL | RC0603FR-0710KL | RC0603FR-0710KL
| | PCB3D
| | Pin Info
| | Price | 0.1 | 0.1 | 0.1
| | Signal Integrity
| | Simulation
| | Supplier | mouser | mouser | mouser
| | Supplier Part Number | 603-RC0603FR-0710KL | 603-RC0603FR-0710KL | 603-RC0603FR-0710KL
| | Value | 10k | 10k | 10k
R20 | PowerBoard.SchDoc | | Fitted | Fitted | Fitted
| | Comment | 2.2k | 2.2k | 2.2k
| | Component Kind | Standard | Standard | Standard
| | Description | 2.2 kOhms ±1% 0.8W | 2.2 kOhms ±1% 0.8W | 2.2 kOhms ±1% 0.8W
| | Footprint | R0805 | R0805 | R0805
| | Ibis Model
| | Library Name | VESC_MotorController.SCHLIB | VESC_MotorController.SCHLIB | VESC_MotorController.SCHLIB
| | Library Reference | 2.2 kOhms ±1% 0.8W | 2.2 kOhms ±1% 0.8W | 2.2 kOhms ±1% 0.8W
| | Manufacturer | Yageo | Yageo | Yageo
| | Manufacturer Part Number | RT0805FRE072K2L | RT0805FRE072K2L | RT0805FRE072K2L
| | PCB3D
| | Pin Info
| | Price | 0.1 | 0.1 | 0.1
| | Signal Integrity
| | Simulation
| | Supplier | mouser | mouser | mouser
| | Supplier Part Number | 603-RT0805FRE072K2L | 603-RT0805FRE072K2L | 603-RT0805FRE072K2L
| | Value | 2.2k | 2.2k | 2.2k
R21 | PowerBoard.SchDoc | | Fitted | Fitted | Fitted
| | Comment | 20R | 20R | 20R
| | Component Kind | Standard | Standard | Standard
| | Description | 20 ohm 0.25W ±1% | 20 ohm 0.25W ±1% | 20 ohm 0.25W ±1%
| | Footprint | R1206 | R1206 | R1206
| | Ibis Model
| | Library Name | VESC_MotorController.SCHLIB | VESC_MotorController.SCHLIB | VESC_MotorController.SCHLIB
| | Library Reference | 20 ohm 0.25W ±1% | 20 ohm 0.25W ±1% | 20 ohm 0.25W ±1%
| | Manufacturer | Yageo | Yageo | Yageo
| | Manufacturer Part Number | RC1206FR-0720RL | RC1206FR-0720RL | RC1206FR-0720RL
| | PCB3D
| | Pin Info
| | Price | 0.12 | 0.12 | 0.12
| | Signal Integrity
| | Simulation
| | Supplier | Mouser | Mouser | Mouser
| | Supplier Part Number | 603-RC1206FR-0720RL | 603-RC1206FR-0720RL | 603-RC1206FR-0720RL
| | Value | 20R | 20R | 20R
R22 | PowerBoard.SchDoc | | Fitted | Fitted | Fitted
| | Comment | 4.7R | 4.7R | 4.7R
| | Component Kind | Standard | Standard | Standard
| | Description | 4.7 ohm 0.25W ±1% | 4.7 ohm 0.25W ±1% | 4.7 ohm 0.25W ±1%
| | Footprint | R1206 | R1206 | R1206
| | Ibis Model
| | Library Name | VESC_MotorController.SCHLIB | VESC_MotorController.SCHLIB | VESC_MotorController.SCHLIB
| | Library Reference | 4.7 ohm 0.25W ±1% | 4.7 ohm 0.25W ±1% | 4.7 ohm 0.25W ±1%
| | Manufacturer | Yageo | Yageo | Yageo
| | Manufacturer Part Number | RC1206FR-074R7L | RC1206FR-074R7L | RC1206FR-074R7L
| | PCB3D
| | Pin Info
| | Price | 0.12 | 0.12 | 0.12
| | Signal Integrity
| | Simulation
| | Supplier | Mouser | Mouser | Mouser
| | Supplier Part Number | 603-RC1206FR-074R7L | 603-RC1206FR-074R7L | 603-RC1206FR-074R7L
| | Value | 4.7R | 4.7R | 4.7R
R23 | PowerBoard.SchDoc | | Fitted | Fitted | Fitted
| | Comment | 10k | 10k | 10k
| | Component Kind | Standard | Standard | Standard
| | Description | 10 kOhms ±1% 0.1W | 10 kOhms ±1% 0.1W | 10 kOhms ±1% 0.1W
| | Footprint | R0603 | R0603 | R0603
| | Ibis Model
| | Library Name | VESC_MotorController.SCHLIB | VESC_MotorController.SCHLIB | VESC_MotorController.SCHLIB
| | Library Reference | 10 kOhms ±1% 0.1W | 10 kOhms ±1% 0.1W | 10 kOhms ±1% 0.1W
| | Manufacturer | Yageo | Yageo | Yageo
| | Manufacturer Part Number | RC0603FR-0710KL | RC0603FR-0710KL | RC0603FR-0710KL
| | PCB3D
| | Pin Info
| | Price | 0.1 | 0.1 | 0.1
| | Signal Integrity
| | Simulation
| | Supplier | mouser | mouser | mouser
| | Supplier Part Number | 603-RC0603FR-0710KL | 603-RC0603FR-0710KL | 603-RC0603FR-0710KL
| | Value | 10k | 10k | 10k
R24 | PowerBoard.SchDoc | | Fitted | Fitted | Fitted
| | Comment | 2.2R | 2.2R | 2.2R
| | Component Kind | Standard | Standard | Standard
| | Description | 2.2 ohm 0.25W ±1% | 2.2 ohm 0.25W ±1% | 2.2 ohm 0.25W ±1%
| | Footprint | R1206 | R1206 | R1206
| | Ibis Model
| | Library Name | VESC_MotorController.SCHLIB | VESC_MotorController.SCHLIB | VESC_MotorController.SCHLIB
| | Library Reference | 2.2ohm 0.25W ±1% | 2.2ohm 0.25W ±1% | 2.2ohm 0.25W ±1%
| | Manufacturer | Yageo | Yageo | Yageo
| | Manufacturer Part Number | RC1206FR-072R2L | RC1206FR-072R2L | RC1206FR-072R2L
| | PCB3D
| | Pin Info
| | Price | 0.12 | 0.12 | 0.12
| | Signal Integrity
| | Simulation
| | Supplier | Mouser | Mouser | Mouser
| | Supplier Part Number | 603-RC1206FR-072R2L | 603-RC1206FR-072R2L | 603-RC1206FR-072R2L
| | Value | 2.2R | 2.2R | 2.2R
R25 | PowerBoard.SchDoc | | Fitted | Fitted | Fitted
| | Comment | 0.5mR/9W | 0.5mR/9W | 0.5mR/9W
| | Component Kind | Standard | Standard | Standard
| | Description | Current Sense Resistors - SMD 0.5mOHMS 9W 1% AEC-Q200 | Current Sense Resistors - SMD 0.5mOHMS 9W 1% AEC-Q200 | Current Sense Resistors - SMD 0.5mOHMS 9W 1% AEC-Q200
| | Footprint | RESC10052X137N | RESC10052X137N | RESC10052X137N
| | Ibis Model
| | Library Name | VESC_MotorController.SCHLIB | VESC_MotorController.SCHLIB | VESC_MotorController.SCHLIB
| | Library Reference | CSS2H-3920R-L500FE | CSS2H-3920R-L500FE | CSS2H-3920R-L500FE
| | Manufacturer | Bourns | Bourns | Bourns
| | Manufacturer Part Number | CSS2H-3920R-L500FE | CSS2H-3920R-L500FE | CSS2H-3920R-L500FE
| | PCB3D
| | Pin Info
| | Price | 2 | 2 | 2
| | Signal Integrity
| | Simulation
| | Supplier | Mouser | Mouser | Mouser
| | Supplier Part Number | 652-CSS2H3920RL500FE | 652-CSS2H3920RL500FE | 652-CSS2H3920RL500FE
| | Value | 0.5ohm 9W | 0.5ohm 9W | 0.5ohm 9W
R26 | PowerBoard.SchDoc | | Fitted | Fitted | Fitted
| | Comment | 0.5mR/9W | 0.5mR/9W | 0.5mR/9W
| | Component Kind | Standard | Standard | Standard
| | Description | Current Sense Resistors - SMD 0.5mOHMS 9W 1% AEC-Q200 | Current Sense Resistors - SMD 0.5mOHMS 9W 1% AEC-Q200 | Current Sense Resistors - SMD 0.5mOHMS 9W 1% AEC-Q200
| | Footprint | RESC10052X137N | RESC10052X137N | RESC10052X137N
| | Ibis Model
| | Library Name | VESC_MotorController.SCHLIB | VESC_MotorController.SCHLIB | VESC_MotorController.SCHLIB
| | Library Reference | CSS2H-3920R-L500FE | CSS2H-3920R-L500FE | CSS2H-3920R-L500FE
| | Manufacturer | Bourns | Bourns | Bourns
| | Manufacturer Part Number | CSS2H-3920R-L500FE | CSS2H-3920R-L500FE | CSS2H-3920R-L500FE
| | PCB3D
| | Pin Info
| | Price | 2 | 2 | 2
| | Signal Integrity
| | Simulation
| | Supplier | Mouser | Mouser | Mouser
| | Supplier Part Number | 652-CSS2H3920RL500FE | 652-CSS2H3920RL500FE | 652-CSS2H3920RL500FE
| | Value | 0.5ohm 9W | 0.5ohm 9W | 0.5ohm 9W
R27 | PowerBoard.SchDoc | | Fitted | Fitted | Fitted
| | Comment | 4.7R | 4.7R | 4.7R
| | Component Kind | Standard | Standard | Standard
| | Description | 4.7 ohm 0.25W ±1% | 4.7 ohm 0.25W ±1% | 4.7 ohm 0.25W ±1%
| | Footprint | R1206 | R1206 | R1206
| | Ibis Model
| | Library Name | VESC_MotorController.SCHLIB | VESC_MotorController.SCHLIB | VESC_MotorController.SCHLIB
| | Library Reference | 4.7 ohm 0.25W ±1% | 4.7 ohm 0.25W ±1% | 4.7 ohm 0.25W ±1%
| | Manufacturer | Yageo | Yageo | Yageo
| | Manufacturer Part Number | RC1206FR-074R7L | RC1206FR-074R7L | RC1206FR-074R7L
| | PCB3D
| | Pin Info
| | Price | 0.12 | 0.12 | 0.12
| | Signal Integrity
| | Simulation
| | Supplier | Mouser | Mouser | Mouser
| | Supplier Part Number | 603-RC1206FR-074R7L | 603-RC1206FR-074R7L | 603-RC1206FR-074R7L
| | Value | 4.7R | 4.7R | 4.7R
R28 | PowerBoard.SchDoc | | Fitted | Fitted | Fitted
| | Comment | 0.5mR/9W | 0.5mR/9W | 0.5mR/9W
| | Component Kind | Standard | Standard | Standard
| | Description | Current Sense Resistors - SMD 0.5mOHMS 9W 1% AEC-Q200 | Current Sense Resistors - SMD 0.5mOHMS 9W 1% AEC-Q200 | Current Sense Resistors - SMD 0.5mOHMS 9W 1% AEC-Q200
| | Footprint | RESC10052X137N | RESC10052X137N | RESC10052X137N
| | Ibis Model
| | Library Name | VESC_MotorController.SCHLIB | VESC_MotorController.SCHLIB | VESC_MotorController.SCHLIB
| | Library Reference | CSS2H-3920R-L500FE | CSS2H-3920R-L500FE | CSS2H-3920R-L500FE
| | Manufacturer | Bourns | Bourns | Bourns
| | Manufacturer Part Number | CSS2H-3920R-L500FE | CSS2H-3920R-L500FE | CSS2H-3920R-L500FE
| | PCB3D
| | Pin Info
| | Price | 2 | 2 | 2
| | Signal Integrity
| | Simulation
| | Supplier | Mouser | Mouser | Mouser
| | Supplier Part Number | 652-CSS2H3920RL500FE | 652-CSS2H3920RL500FE | 652-CSS2H3920RL500FE
| | Value | 0.5ohm 9W | 0.5ohm 9W | 0.5ohm 9W
R29 | PowerBoard.SchDoc | | Fitted | Fitted | Fitted
| | Comment | 20R | 20R | 20R
| | Component Kind | Standard | Standard | Standard
| | Description | 20 ohm 0.25W ±1% | 20 ohm 0.25W ±1% | 20 ohm 0.25W ±1%
| | Footprint | R1206 | R1206 | R1206
| | Ibis Model
| | Library Name | VESC_MotorController.SCHLIB | VESC_MotorController.SCHLIB | VESC_MotorController.SCHLIB
| | Library Reference | 20 ohm 0.25W ±1% | 20 ohm 0.25W ±1% | 20 ohm 0.25W ±1%
| | Manufacturer | Yageo | Yageo | Yageo
| | Manufacturer Part Number | RC1206FR-0720RL | RC1206FR-0720RL | RC1206FR-0720RL
| | PCB3D
| | Pin Info
| | Price | 0.12 | 0.12 | 0.12
| | Signal Integrity
| | Simulation
| | Supplier | Mouser | Mouser | Mouser
| | Supplier Part Number | 603-RC1206FR-0720RL | 603-RC1206FR-0720RL | 603-RC1206FR-0720RL
| | Value | 20R | 20R | 20R
R30 | PowerBoard.SchDoc | | Fitted | Fitted | Fitted
| | Comment | 2.2k | 2.2k | 2.2k
| | Component Kind | Standard | Standard | Standard
| | Description | 2.2 kOhms ±1% 0.1W | 2.2 kOhms ±1% 0.1W | 2.2 kOhms ±1% 0.1W
| | Footprint | R0603 | R0603 | R0603
| | Ibis Model
| | Library Name | VESC_MotorController.SCHLIB | VESC_MotorController.SCHLIB | VESC_MotorController.SCHLIB
| | Library Reference | 2.2 kOhms ±1% 0.1W | 2.2 kOhms ±1% 0.1W | 2.2 kOhms ±1% 0.1W
| | Manufacturer | Yageo | Yageo | Yageo
| | Manufacturer Part Number | RC0603FR-072K2L | RC0603FR-072K2L | RC0603FR-072K2L
| | PCB3D
| | Pin Info
| | Price | 0.1 | 0.1 | 0.1
| | Signal Integrity
| | Simulation
| | Supplier | Mouser | Mouser | Mouser
| | Supplier Part Number | 603-RC0603FR-072K2L | 603-RC0603FR-072K2L | 603-RC0603FR-072K2L
| | Value | 2.2k | 2.2k | 2.2k
R31 | PowerBoard.SchDoc | | Fitted | Fitted | Fitted
| | Comment | 2.2k | 2.2k | 2.2k
| | Component Kind | Standard | Standard | Standard
| | Description | 2.2 kOhms ±1% 0.1W | 2.2 kOhms ±1% 0.1W | 2.2 kOhms ±1% 0.1W
| | Footprint | R0603 | R0603 | R0603
| | Ibis Model
| | Library Name | VESC_MotorController.SCHLIB | VESC_MotorController.SCHLIB | VESC_MotorController.SCHLIB
| | Library Reference | 2.2 kOhms ±1% 0.1W | 2.2 kOhms ±1% 0.1W | 2.2 kOhms ±1% 0.1W
| | Manufacturer | Yageo | Yageo | Yageo
| | Manufacturer Part Number | RC0603FR-072K2L | RC0603FR-072K2L | RC0603FR-072K2L
| | PCB3D
| | Pin Info
| | Price | 0.1 | 0.1 | 0.1
| | Signal Integrity
| | Simulation
| | Supplier | Mouser | Mouser | Mouser
| | Supplier Part Number | 603-RC0603FR-072K2L | 603-RC0603FR-072K2L | 603-RC0603FR-072K2L
| | Value | 2.2k | 2.2k | 2.2k
R32 | PowerBoard.SchDoc | | Fitted | Fitted | Fitted
| | Comment | 2.2k | 2.2k | 2.2k
| | Component Kind | Standard | Standard | Standard
| | Description | 2.2 kOhms ±1% 0.1W | 2.2 kOhms ±1% 0.1W | 2.2 kOhms ±1% 0.1W
| | Footprint | R0603 | R0603 | R0603
| | Ibis Model
| | Library Name | VESC_MotorController.SCHLIB | VESC_MotorController.SCHLIB | VESC_MotorController.SCHLIB
| | Library Reference | 2.2 kOhms ±1% 0.1W | 2.2 kOhms ±1% 0.1W | 2.2 kOhms ±1% 0.1W
| | Manufacturer | Yageo | Yageo | Yageo
| | Manufacturer Part Number | RC0603FR-072K2L | RC0603FR-072K2L | RC0603FR-072K2L
| | PCB3D
| | Pin Info
| | Price | 0.1 | 0.1 | 0.1
| | Signal Integrity
| | Simulation
| | Supplier | Mouser | Mouser | Mouser
| | Supplier Part Number | 603-RC0603FR-072K2L | 603-RC0603FR-072K2L | 603-RC0603FR-072K2L
| | Value | 2.2k | 2.2k | 2.2k
R33 | PowerBoard.SchDoc | | Fitted | Fitted | Fitted
| | Comment | 0.5mR/9W | 0.5mR/9W | 0.5mR/9W
| | Component Kind | Standard | Standard | Standard
| | Description | Current Sense Resistors - SMD 0.5mOHMS 9W 1% AEC-Q200 | Current Sense Resistors - SMD 0.5mOHMS 9W 1% AEC-Q200 | Current Sense Resistors - SMD 0.5mOHMS 9W 1% AEC-Q200
| | Footprint | RESC10052X137N | RESC10052X137N | RESC10052X137N
| | Ibis Model
| | Library Name | VESC_MotorController.SCHLIB | VESC_MotorController.SCHLIB | VESC_MotorController.SCHLIB
| | Library Reference | CSS2H-3920R-L500FE | CSS2H-3920R-L500FE | CSS2H-3920R-L500FE
| | Manufacturer | Bourns | Bourns | Bourns
| | Manufacturer Part Number | CSS2H-3920R-L500FE | CSS2H-3920R-L500FE | CSS2H-3920R-L500FE
| | PCB3D
| | Pin Info
| | Price | 2 | 2 | 2
| | Signal Integrity
| | Simulation
| | Supplier | Mouser | Mouser | Mouser
| | Supplier Part Number | 652-CSS2H3920RL500FE | 652-CSS2H3920RL500FE | 652-CSS2H3920RL500FE
| | Value | 0.5ohm 9W | 0.5ohm 9W | 0.5ohm 9W
R34 | PowerBoard.SchDoc | | Fitted | Fitted | Fitted
| | Comment | 20R | 20R | 20R
| | Component Kind | Standard | Standard | Standard
| | Description | 20 ohm 0.25W ±1% | 20 ohm 0.25W ±1% | 20 ohm 0.25W ±1%
| | Footprint | R1206 | R1206 | R1206
| | Ibis Model
| | Library Name | VESC_MotorController.SCHLIB | VESC_MotorController.SCHLIB | VESC_MotorController.SCHLIB
| | Library Reference | 20ohm 0.25W ±1% | 20ohm 0.25W ±1% | 20ohm 0.25W ±1%
| | Manufacturer | Yageo | Yageo | Yageo
| | Manufacturer Part Number | RC1206FR-0720RL | RC1206FR-0720RL | RC1206FR-0720RL
| | PCB3D
| | Pin Info
| | Price | 0.12 | 0.12 | 0.12
| | Signal Integrity
| | Simulation
| | Supplier | Mouser | Mouser | Mouser
| | Supplier Part Number | 603-RC1206FR-0720RL | 603-RC1206FR-0720RL | 603-RC1206FR-0720RL
| | Value | 20R | 20R | 20R
R35 | PowerBoard.SchDoc | | Fitted | Fitted | Fitted
| | Comment | 0.5mR/9W | 0.5mR/9W | 0.5mR/9W
| | Component Kind | Standard | Standard | Standard
| | Description | Current Sense Resistors - SMD 0.5mOHMS 9W 1% AEC-Q200 | Current Sense Resistors - SMD 0.5mOHMS 9W 1% AEC-Q200 | Current Sense Resistors - SMD 0.5mOHMS 9W 1% AEC-Q200
| | Footprint | RESC10052X137N | RESC10052X137N | RESC10052X137N
| | Ibis Model
| | Library Name | VESC_MotorController.SCHLIB | VESC_MotorController.SCHLIB | VESC_MotorController.SCHLIB
| | Library Reference | CSS2H-3920R-L500FE | CSS2H-3920R-L500FE | CSS2H-3920R-L500FE
| | Manufacturer | Bourns | Bourns | Bourns
| | Manufacturer Part Number | CSS2H-3920R-L500FE | CSS2H-3920R-L500FE | CSS2H-3920R-L500FE
| | PCB3D
| | Pin Info
| | Price | 2 | 2 | 2
| | Signal Integrity
| | Simulation
| | Supplier | Mouser | Mouser | Mouser
| | Supplier Part Number | 652-CSS2H3920RL500FE | 652-CSS2H3920RL500FE | 652-CSS2H3920RL500FE
| | Value | 0.5ohm 9W | 0.5ohm 9W | 0.5ohm 9W
R36 | PowerBoard.SchDoc | | Fitted | Fitted | Fitted
| | Comment | 20R | 20R | 20R
| | Component Kind | Standard | Standard | Standard
| | Description | 20 ohm 0.25W ±1% | 20 ohm 0.25W ±1% | 20 ohm 0.25W ±1%
| | Footprint | R1206 | R1206 | R1206
| | Ibis Model
| | Library Name | VESC_MotorController.SCHLIB | VESC_MotorController.SCHLIB | VESC_MotorController.SCHLIB
| | Library Reference | 20ohm 0.25W ±1% | 20ohm 0.25W ±1% | 20ohm 0.25W ±1%
| | Manufacturer | Yageo | Yageo | Yageo
| | Manufacturer Part Number | RC1206FR-0720RL | RC1206FR-0720RL | RC1206FR-0720RL
| | PCB3D
| | Pin Info
| | Price | 0.12 | 0.12 | 0.12
| | Signal Integrity
| | Simulation
| | Supplier | Mouser | Mouser | Mouser
| | Supplier Part Number | 603-RC1206FR-0720RL | 603-RC1206FR-0720RL | 603-RC1206FR-0720RL
| | Value | 20R | 20R | 20R
R37 | PowerBoard.SchDoc | | Fitted | Fitted | Fitted
| | Comment | 20R | 20R | 20R
| | Component Kind | Standard | Standard | Standard
| | Description | 20 ohm 0.25W ±1% | 20 ohm 0.25W ±1% | 20 ohm 0.25W ±1%
| | Footprint | R1206 | R1206 | R1206
| | Ibis Model
| | Library Name | VESC_MotorController.SCHLIB | VESC_MotorController.SCHLIB | VESC_MotorController.SCHLIB
| | Library Reference | 20ohm 0.25W ±1% | 20ohm 0.25W ±1% | 20ohm 0.25W ±1%
| | Manufacturer | Yageo | Yageo | Yageo
| | Manufacturer Part Number | RC1206FR-0720RL | RC1206FR-0720RL | RC1206FR-0720RL
| | PCB3D
| | Pin Info
| | Price | 0.12 | 0.12 | 0.12
| | Signal Integrity
| | Simulation
| | Supplier | Mouser | Mouser | Mouser
| | Supplier Part Number | 603-RC1206FR-0720RL | 603-RC1206FR-0720RL | 603-RC1206FR-0720RL
| | Value | 20R | 20R | 20R
R38 | PowerBoard.SchDoc | | Fitted | Fitted | Fitted
| | Comment | 1k | 1k | 1k
| | Component Kind | Standard | Standard | Standard
| | Description | 1 kOhms ±1% 0.1W | 1 kOhms ±1% 0.1W | 1 kOhms ±1% 0.1W
| | Footprint | R0603 | R0603 | R0603
| | Ibis Model
| | Library Name | VESC_MotorController.SCHLIB | VESC_MotorController.SCHLIB | VESC_MotorController.SCHLIB
| | Library Reference | 1 kOhms ±1% 0.1W | 1 kOhms ±1% 0.1W | 1 kOhms ±1% 0.1W
| | Manufacturer | Yageo | Yageo | Yageo
| | Manufacturer Part Number | RC0603FR-071KL | RC0603FR-071KL | RC0603FR-071KL
| | PCB3D
| | Pin Info
| | Price | 0.1 | 0.1 | 0.1
| | Signal Integrity
| | Simulation
| | Supplier | Mouser | Mouser | Mouser
| | Supplier Part Number | 603-RC0603FR-071KL | 603-RC0603FR-071KL | 603-RC0603FR-071KL
| | Value | 1k | 1k | 1k
R39 | PowerBoard.SchDoc | | Fitted | Fitted | Fitted
| | Comment | 39k | 39k | 39k
| | Component Kind | Standard | Standard | Standard
| | Description | 39 kOhms ±1% 0.8W | 39 kOhms ±1% 0.8W | 39 kOhms ±1% 0.8W
| | Footprint | R0805 | R0805 | R0805
| | Ibis Model
| | Library Name | VESC_MotorController.SCHLIB | VESC_MotorController.SCHLIB | VESC_MotorController.SCHLIB
| | Library Reference | 39 kOhms ±1% 0.8W | 39 kOhms ±1% 0.8W | 39 kOhms ±1% 0.8W
| | Manufacturer | Yageo | Yageo | Yageo
| | Manufacturer Part Number | RT0805FRE0739KL | RT0805FRE0739KL | RT0805FRE0739KL
| | PCB3D
| | Pin Info
| | Price | 0.1 | 0.1 | 0.1
| | Signal Integrity
| | Simulation
| | Supplier | mouser | mouser | mouser
| | Supplier Part Number | 603-RT0805FRE0739KL | 603-RT0805FRE0739KL | 603-RT0805FRE0739KL
| | Value | 39k | 39k | 39k
R40 | PowerBoard.SchDoc | | Fitted | Not Fitted | Fitted
| | Comment | 10k | | 10k
| | Component Kind | Standard | | Standard
| | Description | 10 kOhms ±1% 0.1W | | 10 kOhms ±1% 0.1W
| | Footprint | R0603 | | R0603
| | Ibis Model
| | Library Name | VESC_MotorController.SCHLIB | | VESC_MotorController.SCHLIB
| | Library Reference | 10 kOhms ±1% 0.1W | | 10 kOhms ±1% 0.1W
| | Manufacturer | Yageo | | Yageo
| | Manufacturer Part Number | RC0603FR-0710KL | | RC0603FR-0710KL
| | PCB3D
| | Pin Info
| | Price | 0.1 | | 0.1
| | Signal Integrity
| | Simulation
| | Supplier | mouser | | mouser
| | Supplier Part Number | 603-RC0603FR-0710KL | | 603-RC0603FR-0710KL
| | Value | 10k | | 10k
R41 | PowerBoard.SchDoc | | Fitted | Fitted | Fitted
| | Comment | 2.2k | 2.2k | 2.2k
| | Component Kind | Standard | Standard | Standard
| | Description | 2.2 kOhms ±1% 0.8W | 2.2 kOhms ±1% 0.8W | 2.2 kOhms ±1% 0.8W
| | Footprint | R0805 | R0805 | R0805
| | Ibis Model
| | Library Name | VESC_MotorController.SCHLIB | VESC_MotorController.SCHLIB | VESC_MotorController.SCHLIB
| | Library Reference | 2.2 kOhms ±1% 0.8W | 2.2 kOhms ±1% 0.8W | 2.2 kOhms ±1% 0.8W
| | Manufacturer | Yageo | Yageo | Yageo
| | Manufacturer Part Number | RT0805FRE072K2L | RT0805FRE072K2L | RT0805FRE072K2L
| | PCB3D
| | Pin Info
| | Price | 0.1 | 0.1 | 0.1
| | Signal Integrity
| | Simulation
| | Supplier | mouser | mouser | mouser
| | Supplier Part Number | 603-RT0805FRE072K2L | 603-RT0805FRE072K2L | 603-RT0805FRE072K2L
| | Value | 2.2k | 2.2k | 2.2k
R42 | PowerBoard.SchDoc | | Fitted | Fitted | Fitted
| | Comment | 20R | 20R | 20R
| | Component Kind | Standard | Standard | Standard
| | Description | 20 ohm 0.25W ±1% | 20 ohm 0.25W ±1% | 20 ohm 0.25W ±1%
| | Footprint | R1206 | R1206 | R1206
| | Ibis Model
| | Library Name | VESC_MotorController.SCHLIB | VESC_MotorController.SCHLIB | VESC_MotorController.SCHLIB
| | Library Reference | 20 ohm 0.25W ±1% | 20 ohm 0.25W ±1% | 20 ohm 0.25W ±1%
| | Manufacturer | Yageo | Yageo | Yageo
| | Manufacturer Part Number | RC1206FR-0720RL | RC1206FR-0720RL | RC1206FR-0720RL
| | PCB3D
| | Pin Info
| | Price | 0.12 | 0.12 | 0.12
| | Signal Integrity
| | Simulation
| | Supplier | Mouser | Mouser | Mouser
| | Supplier Part Number | 603-RC1206FR-0720RL | 603-RC1206FR-0720RL | 603-RC1206FR-0720RL
| | Value | 20R | 20R | 20R
R43 | PowerBoard.SchDoc | | Fitted | Not Fitted | Fitted
| | Comment | 10k | | 10k
| | Component Kind | Standard | | Standard
| | Description | 10 kOhms ±1% 0.1W | | 10 kOhms ±1% 0.1W
| | Footprint | R0603 | | R0603
| | Ibis Model
| | Library Name | VESC_MotorController.SCHLIB | | VESC_MotorController.SCHLIB
| | Library Reference | 10 kOhms ±1% 0.1W | | 10 kOhms ±1% 0.1W
| | Manufacturer | Yageo | | Yageo
| | Manufacturer Part Number | RC0603FR-0710KL | | RC0603FR-0710KL
| | PCB3D
| | Pin Info
| | Price | 0.1 | | 0.1
| | Signal Integrity
| | Simulation
| | Supplier | mouser | | mouser
| | Supplier Part Number | 603-RC0603FR-0710KL | | 603-RC0603FR-0710KL
| | Value | 10k | | 10k
R44 | PowerBoard.SchDoc | | Fitted | Not Fitted | Fitted
| | Comment | 4.7R | | 4.7R
| | Component Kind | Standard | | Standard
| | Description | 4.7 ohm 0.25W ±1% | | 4.7 ohm 0.25W ±1%
| | Footprint | R1206 | | R1206
| | Ibis Model
| | Library Name | VESC_MotorController.SCHLIB | | VESC_MotorController.SCHLIB
| | Library Reference | 4.7 ohm 0.25W ±1% | | 4.7 ohm 0.25W ±1%
| | Manufacturer | Yageo | | Yageo
| | Manufacturer Part Number | RC1206FR-074R7L | | RC1206FR-074R7L
| | PCB3D
| | Pin Info
| | Price | 0.12 | | 0.12
| | Signal Integrity
| | Simulation
| | Supplier | Mouser | | Mouser
| | Supplier Part Number | 603-RC1206FR-074R7L | | 603-RC1206FR-074R7L
| | Value | 4.7R | | 4.7R
R45 | PowerBoard.SchDoc | | Fitted | Not Fitted | Fitted
| | Comment | 2.2R | | 2.2R
| | Component Kind | Standard | | Standard
| | Description | 2.2 ohm 0.25W ±1% | | 2.2 ohm 0.25W ±1%
| | Footprint | R1206 | | R1206
| | Ibis Model
| | Library Name | VESC_MotorController.SCHLIB | | VESC_MotorController.SCHLIB
| | Library Reference | 2.2ohm 0.25W ±1% | | 2.2ohm 0.25W ±1%
| | Manufacturer | Yageo | | Yageo
| | Manufacturer Part Number | RC1206FR-072R2L | | RC1206FR-072R2L
| | PCB3D
| | Pin Info
| | Price | 0.12 | | 0.12
| | Signal Integrity
| | Simulation
| | Supplier | Mouser | | Mouser
| | Supplier Part Number | 603-RC1206FR-072R2L | | 603-RC1206FR-072R2L
| | Value | 2.2R | | 2.2R
R46 | PowerBoard.SchDoc | | Fitted | Not Fitted | Fitted
| | Comment | 0.5mR/9W | | 0.5mR/9W
| | Component Kind | Standard | | Standard
| | Description | Current Sense Resistors - SMD 0.5mOHMS 9W 1% AEC-Q200 | | Current Sense Resistors - SMD 0.5mOHMS 9W 1% AEC-Q200
| | Footprint | RESC10052X137N | | RESC10052X137N
| | Ibis Model
| | Library Name | VESC_MotorController.SCHLIB | | VESC_MotorController.SCHLIB
| | Library Reference | CSS2H-3920R-L500FE | | CSS2H-3920R-L500FE
| | Manufacturer | Bourns | | Bourns
| | Manufacturer Part Number | CSS2H-3920R-L500FE | | CSS2H-3920R-L500FE
| | PCB3D
| | Pin Info
| | Price | 2 | | 2
| | Signal Integrity
| | Simulation
| | Supplier | Mouser | | Mouser
| | Supplier Part Number | 652-CSS2H3920RL500FE | | 652-CSS2H3920RL500FE
| | Value | 0.5ohm 9W | | 0.5ohm 9W
R47 | PowerBoard.SchDoc | | Fitted | Fitted | Fitted
| | Comment | 0.5mR/9W | 0.5mR/9W | 0.5mR/9W
| | Component Kind | Standard | Standard | Standard
| | Description | Current Sense Resistors - SMD 0.5mOHMS 9W 1% AEC-Q200 | Current Sense Resistors - SMD 0.5mOHMS 9W 1% AEC-Q200 | Current Sense Resistors - SMD 0.5mOHMS 9W 1% AEC-Q200
| | Footprint | RESC10052X137N | RESC10052X137N | RESC10052X137N
| | Ibis Model
| | Library Name | VESC_MotorController.SCHLIB | VESC_MotorController.SCHLIB | VESC_MotorController.SCHLIB
| | Library Reference | CSS2H-3920R-L500FE | CSS2H-3920R-L500FE | CSS2H-3920R-L500FE
| | Manufacturer | Bourns | Bourns | Bourns
| | Manufacturer Part Number | CSS2H-3920R-L500FE | CSS2H-3920R-L500FE | CSS2H-3920R-L500FE
| | PCB3D
| | Pin Info
| | Price | 2 | 2 | 2
| | Signal Integrity
| | Simulation
| | Supplier | Mouser | Mouser | Mouser
| | Supplier Part Number | 652-CSS2H3920RL500FE | 652-CSS2H3920RL500FE | 652-CSS2H3920RL500FE
| | Value | 0.5ohm 9W | 0.5ohm 9W | 0.5ohm 9W
R48 | PowerBoard.SchDoc | | Fitted | Fitted | Fitted
| | Comment | 4.7R | 4.7R | 4.7R
| | Component Kind | Standard | Standard | Standard
| | Description | 4.7 ohm 0.25W ±1% | 4.7 ohm 0.25W ±1% | 4.7 ohm 0.25W ±1%
| | Footprint | R1206 | R1206 | R1206
| | Ibis Model
| | Library Name | VESC_MotorController.SCHLIB | VESC_MotorController.SCHLIB | VESC_MotorController.SCHLIB
| | Library Reference | 4.7 ohm 0.25W ±1% | 4.7 ohm 0.25W ±1% | 4.7 ohm 0.25W ±1%
| | Manufacturer | Yageo | Yageo | Yageo
| | Manufacturer Part Number | RC1206FR-074R7L | RC1206FR-074R7L | RC1206FR-074R7L
| | PCB3D
| | Pin Info
| | Price | 0.12 | 0.12 | 0.12
| | Signal Integrity
| | Simulation
| | Supplier | Mouser | Mouser | Mouser
| | Supplier Part Number | 603-RC1206FR-074R7L | 603-RC1206FR-074R7L | 603-RC1206FR-074R7L
| | Value | 4.7R | 4.7R | 4.7R
R49 | PowerBoard.SchDoc | | Fitted | Fitted | Fitted
| | Comment | 0.5mR/9W | 0.5mR/9W | 0.5mR/9W
| | Component Kind | Standard | Standard | Standard
| | Description | Current Sense Resistors - SMD 0.5mOHMS 9W 1% AEC-Q200 | Current Sense Resistors - SMD 0.5mOHMS 9W 1% AEC-Q200 | Current Sense Resistors - SMD 0.5mOHMS 9W 1% AEC-Q200
| | Footprint | RESC10052X137N | RESC10052X137N | RESC10052X137N
| | Ibis Model
| | Library Name | VESC_MotorController.SCHLIB | VESC_MotorController.SCHLIB | VESC_MotorController.SCHLIB
| | Library Reference | CSS2H-3920R-L500FE | CSS2H-3920R-L500FE | CSS2H-3920R-L500FE
| | Manufacturer | Bourns | Bourns | Bourns
| | Manufacturer Part Number | CSS2H-3920R-L500FE | CSS2H-3920R-L500FE | CSS2H-3920R-L500FE
| | PCB3D
| | Pin Info
| | Price | 2 | 2 | 2
| | Signal Integrity
| | Simulation
| | Supplier | Mouser | Mouser | Mouser
| | Supplier Part Number | 652-CSS2H3920RL500FE | 652-CSS2H3920RL500FE | 652-CSS2H3920RL500FE
| | Value | 0.5ohm 9W | 0.5ohm 9W | 0.5ohm 9W
R50 | PowerBoard.SchDoc | | Fitted | Fitted | Fitted
| | Comment | 20R | 20R | 20R
| | Component Kind | Standard | Standard | Standard
| | Description | 20 ohm 0.25W ±1% | 20 ohm 0.25W ±1% | 20 ohm 0.25W ±1%
| | Footprint | R1206 | R1206 | R1206
| | Ibis Model
| | Library Name | VESC_MotorController.SCHLIB | VESC_MotorController.SCHLIB | VESC_MotorController.SCHLIB
| | Library Reference | 20 ohm 0.25W ±1% | 20 ohm 0.25W ±1% | 20 ohm 0.25W ±1%
| | Manufacturer | Yageo | Yageo | Yageo
| | Manufacturer Part Number | RC1206FR-0720RL | RC1206FR-0720RL | RC1206FR-0720RL
| | PCB3D
| | Pin Info
| | Price | 0.12 | 0.12 | 0.12
| | Signal Integrity
| | Simulation
| | Supplier | Mouser | Mouser | Mouser
| | Supplier Part Number | 603-RC1206FR-0720RL | 603-RC1206FR-0720RL | 603-RC1206FR-0720RL
| | Value | 20R | 20R | 20R
R51 | PowerBoard.SchDoc | | Fitted | Not Fitted | Fitted
| | Comment | 2.2k | | 2.2k
| | Component Kind | Standard | | Standard
| | Description | 2.2 kOhms ±1% 0.1W | | 2.2 kOhms ±1% 0.1W
| | Footprint | R0603 | | R0603
| | Ibis Model
| | Library Name | VESC_MotorController.SCHLIB | | VESC_MotorController.SCHLIB
| | Library Reference | 2.2 kOhms ±1% 0.1W | | 2.2 kOhms ±1% 0.1W
| | Manufacturer | Yageo | | Yageo
| | Manufacturer Part Number | RC0603FR-072K2L | | RC0603FR-072K2L
| | PCB3D
| | Pin Info
| | Price | 0.1 | | 0.1
| | Signal Integrity
| | Simulation
| | Supplier | Mouser | | Mouser
| | Supplier Part Number | 603-RC0603FR-072K2L | | 603-RC0603FR-072K2L
| | Value | 2.2k | | 2.2k
R52 | PowerBoard.SchDoc | | Fitted | Not Fitted | Fitted
| | Comment | 2.2k | | 2.2k
| | Component Kind | Standard | | Standard
| | Description | 2.2 kOhms ±1% 0.1W | | 2.2 kOhms ±1% 0.1W
| | Footprint | R0603 | | R0603
| | Ibis Model
| | Library Name | VESC_MotorController.SCHLIB | | VESC_MotorController.SCHLIB
| | Library Reference | 2.2 kOhms ±1% 0.1W | | 2.2 kOhms ±1% 0.1W
| | Manufacturer | Yageo | | Yageo
| | Manufacturer Part Number | RC0603FR-072K2L | | RC0603FR-072K2L
| | PCB3D
| | Pin Info
| | Price | 0.1 | | 0.1
| | Signal Integrity
| | Simulation
| | Supplier | Mouser | | Mouser
| | Supplier Part Number | 603-RC0603FR-072K2L | | 603-RC0603FR-072K2L
| | Value | 2.2k | | 2.2k
R53 | PowerBoard.SchDoc | | Fitted | Not Fitted | Fitted
| | Comment | 2.2k | | 2.2k
| | Component Kind | Standard | | Standard
| | Description | 2.2 kOhms ±1% 0.1W | | 2.2 kOhms ±1% 0.1W
| | Footprint | R0603 | | R0603
| | Ibis Model
| | Library Name | VESC_MotorController.SCHLIB | | VESC_MotorController.SCHLIB
| | Library Reference | 2.2 kOhms ±1% 0.1W | | 2.2 kOhms ±1% 0.1W
| | Manufacturer | Yageo | | Yageo
| | Manufacturer Part Number | RC0603FR-072K2L | | RC0603FR-072K2L
| | PCB3D
| | Pin Info
| | Price | 0.1 | | 0.1
| | Signal Integrity
| | Simulation
| | Supplier | Mouser | | Mouser
| | Supplier Part Number | 603-RC0603FR-072K2L | | 603-RC0603FR-072K2L
| | Value | 2.2k | | 2.2k
R54 | PowerBoard.SchDoc | | Fitted | Not Fitted | Fitted
| | Comment | 0.5mR/9W | | 0.5mR/9W
| | Component Kind | Standard | | Standard
| | Description | Current Sense Resistors - SMD 0.5mOHMS 9W 1% AEC-Q200 | | Current Sense Resistors - SMD 0.5mOHMS 9W 1% AEC-Q200
| | Footprint | RESC10052X137N | | RESC10052X137N
| | Ibis Model
| | Library Name | VESC_MotorController.SCHLIB | | VESC_MotorController.SCHLIB
| | Library Reference | CSS2H-3920R-L500FE | | CSS2H-3920R-L500FE
| | Manufacturer | Bourns | | Bourns
| | Manufacturer Part Number | CSS2H-3920R-L500FE | | CSS2H-3920R-L500FE
| | PCB3D
| | Pin Info
| | Price | 2 | | 2
| | Signal Integrity
| | Simulation
| | Supplier | Mouser | | Mouser
| | Supplier Part Number | 652-CSS2H3920RL500FE | | 652-CSS2H3920RL500FE
| | Value | 0.5ohm 9W | | 0.5ohm 9W
R55 | PowerBoard.SchDoc | | Fitted | Not Fitted | Fitted
| | Comment | 20R | | 20R
| | Component Kind | Standard | | Standard
| | Description | 20 ohm 0.25W ±1% | | 20 ohm 0.25W ±1%
| | Footprint | R1206 | | R1206
| | Ibis Model
| | Library Name | VESC_MotorController.SCHLIB | | VESC_MotorController.SCHLIB
| | Library Reference | 20ohm 0.25W ±1% | | 20ohm 0.25W ±1%
| | Manufacturer | Yageo | | Yageo
| | Manufacturer Part Number | RC1206FR-0720RL | | RC1206FR-0720RL
| | PCB3D
| | Pin Info
| | Price | 0.12 | | 0.12
| | Signal Integrity
| | Simulation
| | Supplier | Mouser | | Mouser
| | Supplier Part Number | 603-RC1206FR-0720RL | | 603-RC1206FR-0720RL
| | Value | 20R | | 20R
R56 | PowerBoard.SchDoc | | Fitted | Not Fitted | Fitted
| | Comment | 0.5mR/9W | | 0.5mR/9W
| | Component Kind | Standard | | Standard
| | Description | Current Sense Resistors - SMD 0.5mOHMS 9W 1% AEC-Q200 | | Current Sense Resistors - SMD 0.5mOHMS 9W 1% AEC-Q200
| | Footprint | RESC10052X137N | | RESC10052X137N
| | Ibis Model
| | Library Name | VESC_MotorController.SCHLIB | | VESC_MotorController.SCHLIB
| | Library Reference | CSS2H-3920R-L500FE | | CSS2H-3920R-L500FE
| | Manufacturer | Bourns | | Bourns
| | Manufacturer Part Number | CSS2H-3920R-L500FE | | CSS2H-3920R-L500FE
| | PCB3D
| | Pin Info
| | Price | 2 | | 2
| | Signal Integrity
| | Simulation
| | Supplier | Mouser | | Mouser
| | Supplier Part Number | 652-CSS2H3920RL500FE | | 652-CSS2H3920RL500FE
| | Value | 0.5ohm 9W | | 0.5ohm 9W
R57 | PowerBoard.SchDoc | | Fitted | Not Fitted | Fitted
| | Comment | 20R | | 20R
| | Component Kind | Standard | | Standard
| | Description | 20 ohm 0.25W ±1% | | 20 ohm 0.25W ±1%
| | Footprint | R1206 | | R1206
| | Ibis Model
| | Library Name | VESC_MotorController.SCHLIB | | VESC_MotorController.SCHLIB
| | Library Reference | 20ohm 0.25W ±1% | | 20ohm 0.25W ±1%
| | Manufacturer | Yageo | | Yageo
| | Manufacturer Part Number | RC1206FR-0720RL | | RC1206FR-0720RL
| | PCB3D
| | Pin Info
| | Price | 0.12 | | 0.12
| | Signal Integrity
| | Simulation
| | Supplier | Mouser | | Mouser
| | Supplier Part Number | 603-RC1206FR-0720RL | | 603-RC1206FR-0720RL
| | Value | 20R | | 20R
R58 | PowerBoard.SchDoc | | Fitted | Fitted | Fitted
| | Comment | 20R | 20R | 20R
| | Component Kind | Standard | Standard | Standard
| | Description | 20 ohm 0.25W ±1% | 20 ohm 0.25W ±1% | 20 ohm 0.25W ±1%
| | Footprint | R1206 | R1206 | R1206
| | Ibis Model
| | Library Name | VESC_MotorController.SCHLIB | VESC_MotorController.SCHLIB | VESC_MotorController.SCHLIB
| | Library Reference | 20ohm 0.25W ±1% | 20ohm 0.25W ±1% | 20ohm 0.25W ±1%
| | Manufacturer | Yageo | Yageo | Yageo
| | Manufacturer Part Number | RC1206FR-0720RL | RC1206FR-0720RL | RC1206FR-0720RL
| | PCB3D
| | Pin Info
| | Price | 0.12 | 0.12 | 0.12
| | Signal Integrity
| | Simulation
| | Supplier | Mouser | Mouser | Mouser
| | Supplier Part Number | 603-RC1206FR-0720RL | 603-RC1206FR-0720RL | 603-RC1206FR-0720RL
| | Value | 20R | 20R | 20R
R59 | PowerBoard.SchDoc | | Fitted | Not Fitted | Fitted
| | Comment | 1k | | 1k
| | Component Kind | Standard | | Standard
| | Description | 1 kOhms ±1% 0.1W | | 1 kOhms ±1% 0.1W
| | Footprint | R0603 | | R0603
| | Ibis Model
| | Library Name | VESC_MotorController.SCHLIB | | VESC_MotorController.SCHLIB
| | Library Reference | 1 kOhms ±1% 0.1W | | 1 kOhms ±1% 0.1W
| | Manufacturer | Yageo | | Yageo
| | Manufacturer Part Number | RC0603FR-071KL | | RC0603FR-071KL
| | PCB3D
| | Pin Info
| | Price | 0.1 | | 0.1
| | Signal Integrity
| | Simulation
| | Supplier | Mouser | | Mouser
| | Supplier Part Number | 603-RC0603FR-071KL | | 603-RC0603FR-071KL
| | Value | 1k | | 1k
R60 | PowerBoard.SchDoc | | Fitted | Not Fitted | Fitted
| | Comment | 39k | | 39k
| | Component Kind | Standard | | Standard
| | Description | 39 kOhms ±1% 0.8W | | 39 kOhms ±1% 0.8W
| | Footprint | R0805 | | R0805
| | Ibis Model
| | Library Name | VESC_MotorController.SCHLIB | | VESC_MotorController.SCHLIB
| | Library Reference | 39 kOhms ±1% 0.8W | | 39 kOhms ±1% 0.8W
| | Manufacturer | Yageo | | Yageo
| | Manufacturer Part Number | RT0805FRE0739KL | | RT0805FRE0739KL
| | PCB3D
| | Pin Info
| | Price | 0.1 | | 0.1
| | Signal Integrity
| | Simulation
| | Supplier | mouser | | mouser
| | Supplier Part Number | 603-RT0805FRE0739KL | | 603-RT0805FRE0739KL
| | Value | 39k | | 39k
R61 | PowerBoard.SchDoc | | Fitted | Fitted | Fitted
| | Comment | 10k | 10k | 10k
| | Component Kind | Standard | Standard | Standard
| | Description | 10 kOhms ±1% 0.1W | 10 kOhms ±1% 0.1W | 10 kOhms ±1% 0.1W
| | Footprint | R0603 | R0603 | R0603
| | Ibis Model
| | Library Name | VESC_MotorController.SCHLIB | VESC_MotorController.SCHLIB | VESC_MotorController.SCHLIB
| | Library Reference | 10 kOhms ±1% 0.1W | 10 kOhms ±1% 0.1W | 10 kOhms ±1% 0.1W
| | Manufacturer | Yageo | Yageo | Yageo
| | Manufacturer Part Number | RC0603FR-0710KL | RC0603FR-0710KL | RC0603FR-0710KL
| | PCB3D
| | Pin Info
| | Price | 0.1 | 0.1 | 0.1
| | Signal Integrity
| | Simulation
| | Supplier | mouser | mouser | mouser
| | Supplier Part Number | 603-RC0603FR-0710KL | 603-RC0603FR-0710KL | 603-RC0603FR-0710KL
| | Value | 10k | 10k | 10k
R62 | PowerBoard.SchDoc | | Fitted | Fitted | Fitted
| | Comment | 2.2k | 2.2k | 2.2k
| | Component Kind | Standard | Standard | Standard
| | Description | 2.2 kOhms ±1% 0.8W | 2.2 kOhms ±1% 0.8W | 2.2 kOhms ±1% 0.8W
| | Footprint | R0805 | R0805 | R0805
| | Ibis Model
| | Library Name | VESC_MotorController.SCHLIB | VESC_MotorController.SCHLIB | VESC_MotorController.SCHLIB
| | Library Reference | 2.2 kOhms ±1% 0.8W | 2.2 kOhms ±1% 0.8W | 2.2 kOhms ±1% 0.8W
| | Manufacturer | Yageo | Yageo | Yageo
| | Manufacturer Part Number | RT0805FRE072K2L | RT0805FRE072K2L | RT0805FRE072K2L
| | PCB3D
| | Pin Info
| | Price | 0.1 | 0.1 | 0.1
| | Signal Integrity
| | Simulation
| | Supplier | mouser | mouser | mouser
| | Supplier Part Number | 603-RT0805FRE072K2L | 603-RT0805FRE072K2L | 603-RT0805FRE072K2L
| | Value | 2.2k | 2.2k | 2.2k
R63 | PowerBoard.SchDoc | | Fitted | Not Fitted | Fitted
| | Comment | 20R | | 20R
| | Component Kind | Standard | | Standard
| | Description | 20 ohm 0.25W ±1% | | 20 ohm 0.25W ±1%
| | Footprint | R1206 | | R1206
| | Ibis Model
| | Library Name | VESC_MotorController.SCHLIB | | VESC_MotorController.SCHLIB
| | Library Reference | 20 ohm 0.25W ±1% | | 20 ohm 0.25W ±1%
| | Manufacturer | Yageo | | Yageo
| | Manufacturer Part Number | RC1206FR-0720RL | | RC1206FR-0720RL
| | PCB3D
| | Pin Info
| | Price | 0.12 | | 0.12
| | Signal Integrity
| | Simulation
| | Supplier | Mouser | | Mouser
| | Supplier Part Number | 603-RC1206FR-0720RL | | 603-RC1206FR-0720RL
| | Value | 20R | | 20R
R64 | PowerBoard.SchDoc | | Fitted | Not Fitted | Fitted
| | Comment | 10k | | 10k
| | Component Kind | Standard | | Standard
| | Description | 10 kOhms ±1% 0.1W | | 10 kOhms ±1% 0.1W
| | Footprint | R0603 | | R0603
| | Ibis Model
| | Library Name | VESC_MotorController.SCHLIB | | VESC_MotorController.SCHLIB
| | Library Reference | 10 kOhms ±1% 0.1W | | 10 kOhms ±1% 0.1W
| | Manufacturer | Yageo | | Yageo
| | Manufacturer Part Number | RC0603FR-0710KL | | RC0603FR-0710KL
| | PCB3D
| | Pin Info
| | Price | 0.1 | | 0.1
| | Signal Integrity
| | Simulation
| | Supplier | mouser | | mouser
| | Supplier Part Number | 603-RC0603FR-0710KL | | 603-RC0603FR-0710KL
| | Value | 10k | | 10k
R65 | PowerBoard.SchDoc | | Fitted | Not Fitted | Fitted
| | Comment | 4.7R | | 4.7R
| | Component Kind | Standard | | Standard
| | Description | 4.7 ohm 0.25W ±1% | | 4.7 ohm 0.25W ±1%
| | Footprint | R1206 | | R1206
| | Ibis Model
| | Library Name | VESC_MotorController.SCHLIB | | VESC_MotorController.SCHLIB
| | Library Reference | 4.7 ohm 0.25W ±1% | | 4.7 ohm 0.25W ±1%
| | Manufacturer | Yageo | | Yageo
| | Manufacturer Part Number | RC1206FR-074R7L | | RC1206FR-074R7L
| | PCB3D
| | Pin Info
| | Price | 0.12 | | 0.12
| | Signal Integrity
| | Simulation
| | Supplier | Mouser | | Mouser
| | Supplier Part Number | 603-RC1206FR-074R7L | | 603-RC1206FR-074R7L
| | Value | 4.7R | | 4.7R
R66 | Controller.SchDoc | | Fitted | Not Fitted | Fitted
| | Comment | 52.3k | | 52.3k
| | Component Kind | Standard | | Standard
| | Description | 52.3 kOhms ±1% 0.1W | | 52.3 kOhms ±1% 0.1W
| | Footprint | R0603 | | R0603
| | Ibis Model
| | Library Name | VESC_MotorController.SCHLIB | | VESC_MotorController.SCHLIB
| | Library Reference | 52.3 kOhms ±1% 0.1W | | 52.3 kOhms ±1% 0.1W
| | Manufacturer | Yageo | | Yageo
| | Manufacturer Part Number | RC0603FR-0752K3L | | RC0603FR-0752K3L
| | PCB3D
| | Pin Info
| | Price | 0.1 | | 0.1
| | Signal Integrity
| | Simulation
| | Supplier | mouser | | mouser
| | Supplier Part Number | 603-RC0603FR-0752K3L | | 603-RC0603FR-0752K3L
| | Value | 52.3k | | 52.3k
R67 | Controller.SchDoc | | Fitted | Not Fitted | Fitted
| | Comment | 10k | | 10k
| | Component Kind | Standard | | Standard
| | Description | 10 kOhms ±1% 0.1W | | 10 kOhms ±1% 0.1W
| | Footprint | R0603 | | R0603
| | Ibis Model
| | Library Name | VESC_MotorController.SCHLIB | | VESC_MotorController.SCHLIB
| | Library Reference | 10 kOhms ±1% 0.1W | | 10 kOhms ±1% 0.1W
| | Manufacturer | Yageo | | Yageo
| | Manufacturer Part Number | RC0603FR-0710KL | | RC0603FR-0710KL
| | PCB3D
| | Pin Info
| | Price | 0.1 | | 0.1
| | Signal Integrity
| | Simulation
| | Supplier | mouser | | mouser
| | Supplier Part Number | 603-RC0603FR-0710KL | | 603-RC0603FR-0710KL
| | Value | 10k | | 10k
R68 | Controller.SchDoc | | Fitted | Not Fitted | Fitted
| | Comment | 33k | | 33k
| | Component Kind | Standard | | Standard
| | Description | 33 kOhms ±1% 0.1W | | 33 kOhms ±1% 0.1W
| | Footprint | R0603 | | R0603
| | Ibis Model
| | Library Name | VESC_MotorController.SCHLIB | | VESC_MotorController.SCHLIB
| | Library Reference | 33 kOhms ±1% 0.1W | | 33 kOhms ±1% 0.1W
| | Manufacturer | Yageo | | Yageo
| | Manufacturer Part Number | RC0603FR-0733KL | | RC0603FR-0733KL
| | PCB3D
| | Pin Info
| | Price | 0.1 | | 0.1
| | Signal Integrity
| | Simulation
| | Supplier | mouser | | mouser
| | Supplier Part Number | 603-RC0603FR-0733KL | | 603-RC0603FR-0733KL
| | Value | 33k | | 33k
R69 | Controller.SchDoc | | Fitted | Not Fitted | Fitted
| | Comment | 10k | | 10k
| | Component Kind | Standard | | Standard
| | Description | 10 kOhms ±1% 0.1W | | 10 kOhms ±1% 0.1W
| | Footprint | R0603 | | R0603
| | Ibis Model
| | Library Name | VESC_MotorController.SCHLIB | | VESC_MotorController.SCHLIB
| | Library Reference | 10 kOhms ±1% 0.1W | | 10 kOhms ±1% 0.1W
| | Manufacturer | Yageo | | Yageo
| | Manufacturer Part Number | RC0603FR-0710KL | | RC0603FR-0710KL
| | PCB3D
| | Pin Info
| | Price | 0.1 | | 0.1
| | Signal Integrity
| | Simulation
| | Supplier | mouser | | mouser
| | Supplier Part Number | 603-RC0603FR-0710KL | | 603-RC0603FR-0710KL
| | Value | 10k | | 10k
R70 | Controller.SchDoc | | Fitted | Not Fitted | Fitted
| | Comment | 448k | | 448k
| | Component Kind | Standard | | Standard
| | Description | 448 kOhms ±1% 0.1W | | 448 kOhms ±1% 0.1W
| | Footprint | R0603 | | R0603
| | Ibis Model
| | Library Name | VESC_MotorController.SCHLIB | | VESC_MotorController.SCHLIB
| | Library Reference | 448 kOhms ±1% 0.1W | | 448 kOhms ±1% 0.1W
| | Manufacturer | Yageo | | Yageo
| | Manufacturer Part Number | RC0603FR-07448KL | | RC0603FR-07448KL
| | PCB3D
| | Pin Info
| | Price | 0.1 | | 0.1
| | Signal Integrity
| | Simulation
| | Supplier | mouser | | mouser
| | Supplier Part Number | 603-RC0603FR-07448KL | | 603-RC0603FR-07448KL
| | Value | 448k | | 448k
R71 | Controller.SchDoc | | Fitted | Fitted | Fitted
| | Comment | 100k | 100k | 100k
| | Component Kind | Standard | Standard | Standard
| | Description | 100 kOhms ±1% 0.1W | 100 kOhms ±1% 0.1W | 100 kOhms ±1% 0.1W
| | Footprint | R0603 | R0603 | R0603
| | Ibis Model
| | Library Name | VESC_MotorController.SCHLIB | VESC_MotorController.SCHLIB | VESC_MotorController.SCHLIB
| | Library Reference | 100 kOhms ±1% 0.1W | 100 kOhms ±1% 0.1W | 100 kOhms ±1% 0.1W
| | Manufacturer | Yageo | Yageo | Yageo
| | Manufacturer Part Number | RC0603FR-07100KL | RC0603FR-07100KL | RC0603FR-07100KL
| | PCB3D
| | Pin Info
| | Price | 0.1 | 0.1 | 0.1
| | Signal Integrity
| | Simulation
| | Supplier | mouser | mouser | mouser
| | Supplier Part Number | 603-RC0603FR-07100KL | 603-RC0603FR-07100KL | 603-RC0603FR-07100KL
| | Value | 100k | 100k | 100k
R72 | Controller.SchDoc | | Fitted | Fitted | Fitted
| | Comment | 49.9k | 49.9k | 49.9k
| | Component Kind | Standard | Standard | Standard
| | Description | 49.9 kOhms ±1% 0.1W | 49.9 kOhms ±1% 0.1W | 49.9 kOhms ±1% 0.1W
| | Footprint | R0603 | R0603 | R0603
| | Ibis Model
| | Library Name | VESC_MotorController.SCHLIB | VESC_MotorController.SCHLIB | VESC_MotorController.SCHLIB
| | Library Reference | 49.9 kOhms ±1% 0.1W | 49.9 kOhms ±1% 0.1W | 49.9 kOhms ±1% 0.1W
| | Manufacturer | Yageo | Yageo | Yageo
| | Manufacturer Part Number | RC0603FR-0749K9L | RC0603FR-0749K9L | RC0603FR-0749K9L
| | PCB3D
| | Pin Info
| | Price | 0.1 | 0.1 | 0.1
| | Signal Integrity
| | Simulation
| | Supplier | mouser | mouser | mouser
| | Supplier Part Number | 603-RC0603FR-0749K9L | 603-RC0603FR-0749K9L | 603-RC0603FR-0749K9L
| | Value | 49.9k | 49.9k | 49.9k
R73 | Controller.SchDoc | | Fitted | Fitted | Fitted
| | Comment | 2.2k | 2.2k | 2.2k
| | Component Kind | Standard | Standard | Standard
| | Description | 2.2 kOhms ±1% 0.1W | 2.2 kOhms ±1% 0.1W | 2.2 kOhms ±1% 0.1W
| | Footprint | R0603 | R0603 | R0603
| | Ibis Model
| | Library Name | VESC_MotorController.SCHLIB | VESC_MotorController.SCHLIB | VESC_MotorController.SCHLIB
| | Library Reference | 2.2 kOhms ±1% 0.1W | 2.2 kOhms ±1% 0.1W | 2.2 kOhms ±1% 0.1W
| | Manufacturer | Yageo | Yageo | Yageo
| | Manufacturer Part Number | RC0603FR-072K2L | RC0603FR-072K2L | RC0603FR-072K2L
| | PCB3D
| | Pin Info
| | Price | 0.1 | 0.1 | 0.1
| | Signal Integrity
| | Simulation
| | Supplier | Mouser | Mouser | Mouser
| | Supplier Part Number | 603-RC0603FR-072K2L | 603-RC0603FR-072K2L | 603-RC0603FR-072K2L
| | Value | 2.2k | 2.2k | 2.2k
R74 | Controller.SchDoc | | Fitted | Fitted | Fitted
| | Comment | 2.2k | 2.2k | 2.2k
| | Component Kind | Standard | Standard | Standard
| | Description | 2.2 kOhms ±1% 0.1W | 2.2 kOhms ±1% 0.1W | 2.2 kOhms ±1% 0.1W
| | Footprint | R0603 | R0603 | R0603
| | Ibis Model
| | Library Name | VESC_MotorController.SCHLIB | VESC_MotorController.SCHLIB | VESC_MotorController.SCHLIB
| | Library Reference | 2.2 kOhms ±1% 0.1W | 2.2 kOhms ±1% 0.1W | 2.2 kOhms ±1% 0.1W
| | Manufacturer | Yageo | Yageo | Yageo
| | Manufacturer Part Number | RC0603FR-072K2L | RC0603FR-072K2L | RC0603FR-072K2L
| | PCB3D
| | Pin Info
| | Price | 0.1 | 0.1 | 0.1
| | Signal Integrity
| | Simulation
| | Supplier | Mouser | Mouser | Mouser
| | Supplier Part Number | 603-RC0603FR-072K2L | 603-RC0603FR-072K2L | 603-RC0603FR-072K2L
| | Value | 2.2k | 2.2k | 2.2k
R75 | Controller.SchDoc | | Fitted | Fitted | Fitted
| | Comment | 2.2k | 2.2k | 2.2k
| | Component Kind | Standard | Standard | Standard
| | Description | 2.2 kOhms ±1% 0.1W | 2.2 kOhms ±1% 0.1W | 2.2 kOhms ±1% 0.1W
| | Footprint | R0603 | R0603 | R0603
| | Ibis Model
| | Library Name | VESC_MotorController.SCHLIB | VESC_MotorController.SCHLIB | VESC_MotorController.SCHLIB
| | Library Reference | 2.2 kOhms ±1% 0.1W | 2.2 kOhms ±1% 0.1W | 2.2 kOhms ±1% 0.1W
| | Manufacturer | Yageo | Yageo | Yageo
| | Manufacturer Part Number | RC0603FR-072K2L | RC0603FR-072K2L | RC0603FR-072K2L
| | PCB3D
| | Pin Info
| | Price | 0.1 | 0.1 | 0.1
| | Signal Integrity
| | Simulation
| | Supplier | Mouser | Mouser | Mouser
| | Supplier Part Number | 603-RC0603FR-072K2L | 603-RC0603FR-072K2L | 603-RC0603FR-072K2L
| | Value | 2.2k | 2.2k | 2.2k
R76 | Controller.SchDoc | | Fitted | Fitted | Fitted
| | Comment | 0R | 0R | 0R
| | Component Kind | Standard | Standard | Standard
| | Description | 0 ohm 0.25W ±1% | 0 ohm 0.25W ±1% | 0 ohm 0.25W ±1%
| | Footprint | R1206 | R1206 | R1206
| | Ibis Model
| | Library Name | VESC_MotorController.SCHLIB | VESC_MotorController.SCHLIB | VESC_MotorController.SCHLIB
| | Library Reference | 0ohm 0.25W ±1% | 0ohm 0.25W ±1% | 0ohm 0.25W ±1%
| | Manufacturer | Yageo | Yageo | Yageo
| | Manufacturer Part Number | RC1206FR-070RL | RC1206FR-070RL | RC1206FR-070RL
| | PCB3D
| | Pin Info
| | Price
| | Signal Integrity
| | Simulation
| | Supplier
| | Supplier Part Number | 603-RC1206FR-070RL | 603-RC1206FR-070RL | 603-RC1206FR-070RL
| | Value | 0R | 0R | 0R
R77 | Controller.SchDoc | | Fitted | Fitted | Fitted
| | Comment | 2.2k | 2.2k | 2.2k
| | Component Kind | Standard | Standard | Standard
| | Description | 2.2 kOhms ±1% 0.1W | 2.2 kOhms ±1% 0.1W | 2.2 kOhms ±1% 0.1W
| | Footprint | R0603 | R0603 | R0603
| | Ibis Model
| | Library Name | VESC_MotorController.SCHLIB | VESC_MotorController.SCHLIB | VESC_MotorController.SCHLIB
| | Library Reference | 2.2 kOhms ±1% 0.1W | 2.2 kOhms ±1% 0.1W | 2.2 kOhms ±1% 0.1W
| | Manufacturer | Yageo | Yageo | Yageo
| | Manufacturer Part Number | RC0603FR-072K2L | RC0603FR-072K2L | RC0603FR-072K2L
| | PCB3D
| | Pin Info
| | Price | 0.1 | 0.1 | 0.1
| | Signal Integrity
| | Simulation
| | Supplier | Mouser | Mouser | Mouser
| | Supplier Part Number | 603-RC0603FR-072K2L | 603-RC0603FR-072K2L | 603-RC0603FR-072K2L
| | Value | 2.2k | 2.2k | 2.2k
R78 | Controller.SchDoc | | Fitted | Fitted | Fitted
| | Comment | 22R | 22R | 22R
| | Component Kind | Standard | Standard | Standard
| | Description | 22 ohm 0.1W ±1% | 22 ohm 0.1W ±1% | 22 ohm 0.1W ±1%
| | Footprint | R0603 | R0603 | R0603
| | Ibis Model
| | Library Name | VESC_MotorController.SCHLIB | VESC_MotorController.SCHLIB | VESC_MotorController.SCHLIB
| | Library Reference | 22ohm 0.1W ±1% | 22ohm 0.1W ±1% | 22ohm 0.1W ±1%
| | Manufacturer | Yageo | Yageo | Yageo
| | Manufacturer Part Number | RC0603FR-0722RL | RC0603FR-0722RL | RC0603FR-0722RL
| | PCB3D
| | Pin Info
| | Price | 0.1 | 0.1 | 0.1
| | Signal Integrity
| | Simulation
| | Supplier | Mouser | Mouser | Mouser
| | Supplier Part Number | 603-RC0603FR-0722RL | 603-RC0603FR-0722RL | 603-RC0603FR-0722RL
| | Value | 22R | 22R | 22R
R79 | Controller.SchDoc | | Fitted | Fitted | Fitted
| | Comment | 22R | 22R | 22R
| | Component Kind | Standard | Standard | Standard
| | Description | 22 ohm 0.1W ±1% | 22 ohm 0.1W ±1% | 22 ohm 0.1W ±1%
| | Footprint | R0603 | R0603 | R0603
| | Ibis Model
| | Library Name | VESC_MotorController.SCHLIB | VESC_MotorController.SCHLIB | VESC_MotorController.SCHLIB
| | Library Reference | 22ohm 0.1W ±1% | 22ohm 0.1W ±1% | 22ohm 0.1W ±1%
| | Manufacturer | Yageo | Yageo | Yageo
| | Manufacturer Part Number | RC0603FR-0722RL | RC0603FR-0722RL | RC0603FR-0722RL
| | PCB3D
| | Pin Info
| | Price | 0.1 | 0.1 | 0.1
| | Signal Integrity
| | Simulation
| | Supplier | Mouser | Mouser | Mouser
| | Supplier Part Number | 603-RC0603FR-0722RL | 603-RC0603FR-0722RL | 603-RC0603FR-0722RL
| | Value | 22R | 22R | 22R
R80 | Controller.SchDoc | | Fitted | Fitted | Fitted
| | Comment | 2.2k | 2.2k | 2.2k
| | Component Kind | Standard | Standard | Standard
| | Description | 2.2 kOhms ±1% 0.1W | 2.2 kOhms ±1% 0.1W | 2.2 kOhms ±1% 0.1W
| | Footprint | R0603 | R0603 | R0603
| | Ibis Model
| | Library Name | VESC_MotorController.SCHLIB | VESC_MotorController.SCHLIB | VESC_MotorController.SCHLIB
| | Library Reference | 2.2 kOhms ±1% 0.1W | 2.2 kOhms ±1% 0.1W | 2.2 kOhms ±1% 0.1W
| | Manufacturer | Yageo | Yageo | Yageo
| | Manufacturer Part Number | RC0603FR-072K2L | RC0603FR-072K2L | RC0603FR-072K2L
| | PCB3D
| | Pin Info
| | Price | 0.1 | 0.1 | 0.1
| | Signal Integrity
| | Simulation
| | Supplier | Mouser | Mouser | Mouser
| | Supplier Part Number | 603-RC0603FR-072K2L | 603-RC0603FR-072K2L | 603-RC0603FR-072K2L
| | Value | 2.2k | 2.2k | 2.2k
R81 | Controller.SchDoc | | Fitted | Fitted | Fitted
| | Comment | 2.2k | 2.2k | 2.2k
| | Component Kind | Standard | Standard | Standard
| | Description | 2.2 kOhms ±1% 0.1W | 2.2 kOhms ±1% 0.1W | 2.2 kOhms ±1% 0.1W
| | Footprint | R0603 | R0603 | R0603
| | Ibis Model
| | Library Name | VESC_MotorController.SCHLIB | VESC_MotorController.SCHLIB | VESC_MotorController.SCHLIB
| | Library Reference | 2.2 kOhms ±1% 0.1W | 2.2 kOhms ±1% 0.1W | 2.2 kOhms ±1% 0.1W
| | Manufacturer | Yageo | Yageo | Yageo
| | Manufacturer Part Number | RC0603FR-072K2L | RC0603FR-072K2L | RC0603FR-072K2L
| | PCB3D
| | Pin Info
| | Price | 0.1 | 0.1 | 0.1
| | Signal Integrity
| | Simulation
| | Supplier | Mouser | Mouser | Mouser
| | Supplier Part Number | 603-RC0603FR-072K2L | 603-RC0603FR-072K2L | 603-RC0603FR-072K2L
| | Value | 2.2k | 2.2k | 2.2k
R82 | Controller.SchDoc | | Fitted | Fitted | Fitted
| | Comment | 2.2k | 2.2k | 2.2k
| | Component Kind | Standard | Standard | Standard
| | Description | 2.2 kOhms ±1% 0.1W | 2.2 kOhms ±1% 0.1W | 2.2 kOhms ±1% 0.1W
| | Footprint | R0603 | R0603 | R0603
| | Ibis Model
| | Library Name | VESC_MotorController.SCHLIB | VESC_MotorController.SCHLIB | VESC_MotorController.SCHLIB
| | Library Reference | 2.2 kOhms ±1% 0.1W | 2.2 kOhms ±1% 0.1W | 2.2 kOhms ±1% 0.1W
| | Manufacturer | Yageo | Yageo | Yageo
| | Manufacturer Part Number | RC0603FR-072K2L | RC0603FR-072K2L | RC0603FR-072K2L
| | PCB3D
| | Pin Info
| | Price | 0.1 | 0.1 | 0.1
| | Signal Integrity
| | Simulation
| | Supplier | Mouser | Mouser | Mouser
| | Supplier Part Number | 603-RC0603FR-072K2L | 603-RC0603FR-072K2L | 603-RC0603FR-072K2L
| | Value | 2.2k | 2.2k | 2.2k
R83 | Controller.SchDoc | | Fitted | Fitted | Fitted
| | Comment | 100 | 100 | 100
| | Component Kind | Standard | Standard | Standard
| | Description | 100 Ohms ±1% 0.1W | 100 Ohms ±1% 0.1W | 100 Ohms ±1% 0.1W
| | Footprint | R0603 | R0603 | R0603
| | Ibis Model
| | Library Name | VESC_MotorController.SCHLIB | VESC_MotorController.SCHLIB | VESC_MotorController.SCHLIB
| | Library Reference | 100 Ohms ±1% 0.1W | 100 Ohms ±1% 0.1W | 100 Ohms ±1% 0.1W
| | Manufacturer | Yageo | Yageo | Yageo
| | Manufacturer Part Number | RC0603FR-0710KL | RC0603FR-0710KL | RC0603FR-0710KL
| | PCB3D
| | Pin Info
| | Price | 0.1 | 0.1 | 0.1
| | Signal Integrity
| | Simulation
| | Supplier | mouser | mouser | mouser
| | Supplier Part Number | 603-RC0603FR-0710KL | 603-RC0603FR-0710KL | 603-RC0603FR-0710KL
| | Value | 100 | 100 | 100
U1 | PowerBoard.SchDoc | | Fitted | Fitted | Fitted
| | Comment | UCC21520ADW | UCC21520ADW | UCC21520ADW
| | Component Kind | Standard | Standard | Standard
| | Description | 4A/6A, 5.7 kVrms Isolated Dual Channel Gate Driver | 4A/6A, 5.7 kVrms Isolated Dual Channel Gate Driver | 4A/6A, 5.7 kVrms Isolated Dual Channel Gate Driver
| | Footprint | SOIC127P1030X265-16N | SOIC127P1030X265-16N | SOIC127P1030X265-16N
| | Ibis Model
| | Library Name | VESC_MotorController.SCHLIB | VESC_MotorController.SCHLIB | VESC_MotorController.SCHLIB
| | Library Reference | UCC21520ADW | UCC21520ADW | UCC21520ADW
| | Manufacturer | Texas Instruments | Texas Instruments | Texas Instruments
| | Manufacturer Part Number | UCC21520ADW | UCC21520ADW | UCC21520ADW
| | PCB3D
| | Pin Info
| | Price | 7.6 | 7.6 | 7.6
| | Signal Integrity
| | Simulation
| | Supplier | Mouser | Mouser | Mouser
| | Supplier Part Number | 595-UCC21520ADW | 595-UCC21520ADW | 595-UCC21520ADW
| | Value | UCC21520ADW | UCC21520ADW | UCC21520ADW
U2 | PowerBoard.SchDoc | | Fitted | Fitted | Fitted
| | Comment | INA240A2QDRQ1 | INA240A2QDRQ1 | INA240A2QDRQ1
| | Component Kind | Standard | Standard | Standard
| | Description | Automotive, High/Low Side, Bi-Directional Zer-Drift Current Sense Amp w/ Enhanced PWM Rejection | Automotive, High/Low Side, Bi-Directional Zer-Drift Current Sense Amp w/ Enhanced PWM Rejection | Automotive, High/Low Side, Bi-Directional Zer-Drift Current Sense Amp w/ Enhanced PWM Rejection
| | Footprint | SOIC127P600X175-8N | SOIC127P600X175-8N | SOIC127P600X175-8N
| | Ibis Model
| | Library Name | VESC_MotorController.SCHLIB | VESC_MotorController.SCHLIB | VESC_MotorController.SCHLIB
| | Library Reference | INA240A2QDRQ1 | INA240A2QDRQ1 | INA240A2QDRQ1
| | Manufacturer | Texas Instruments | Texas Instruments | Texas Instruments
| | Manufacturer Part Number | INA240A2QDRQ1 | INA240A2QDRQ1 | INA240A2QDRQ1
| | PCB3D
| | Pin Info
| | Price | 3.8 | 3.8 | 3.8
| | Signal Integrity
| | Simulation
| | Supplier | Mouser | Mouser | Mouser
| | Supplier Part Number | 595-INA240A2QDRQ1 | 595-INA240A2QDRQ1 | 595-INA240A2QDRQ1
| | Value | INA240A2QDRQ1 | INA240A2QDRQ1 | INA240A2QDRQ1
U3 | PowerBoard.SchDoc | | Fitted | Fitted | Fitted
| | Comment | UCC21520ADW | UCC21520ADW | UCC21520ADW
| | Component Kind | Standard | Standard | Standard
| | Description | 4A/6A, 5.7 kVrms Isolated Dual Channel Gate Driver | 4A/6A, 5.7 kVrms Isolated Dual Channel Gate Driver | 4A/6A, 5.7 kVrms Isolated Dual Channel Gate Driver
| | Footprint | SOIC127P1030X265-16N | SOIC127P1030X265-16N | SOIC127P1030X265-16N
| | Ibis Model
| | Library Name | VESC_MotorController.SCHLIB | VESC_MotorController.SCHLIB | VESC_MotorController.SCHLIB
| | Library Reference | UCC21520ADW | UCC21520ADW | UCC21520ADW
| | Manufacturer | Texas Instruments | Texas Instruments | Texas Instruments
| | Manufacturer Part Number | UCC21520ADW | UCC21520ADW | UCC21520ADW
| | PCB3D
| | Pin Info
| | Price | 7.6 | 7.6 | 7.6
| | Signal Integrity
| | Simulation
| | Supplier | Mouser | Mouser | Mouser
| | Supplier Part Number | 595-UCC21520ADW | 595-UCC21520ADW | 595-UCC21520ADW
| | Value | UCC21520ADW | UCC21520ADW | UCC21520ADW
U4 | PowerBoard.SchDoc | | Fitted | Fitted | Fitted
| | Comment | INA240A2QDRQ1 | INA240A2QDRQ1 | INA240A2QDRQ1
| | Component Kind | Standard | Standard | Standard
| | Description | Automotive, High/Low Side, Bi-Directional Zer-Drift Current Sense Amp w/ Enhanced PWM Rejection | Automotive, High/Low Side, Bi-Directional Zer-Drift Current Sense Amp w/ Enhanced PWM Rejection | Automotive, High/Low Side, Bi-Directional Zer-Drift Current Sense Amp w/ Enhanced PWM Rejection
| | Footprint | SOIC127P600X175-8N | SOIC127P600X175-8N | SOIC127P600X175-8N
| | Ibis Model
| | Library Name | VESC_MotorController.SCHLIB | VESC_MotorController.SCHLIB | VESC_MotorController.SCHLIB
| | Library Reference | INA240A2QDRQ1 | INA240A2QDRQ1 | INA240A2QDRQ1
| | Manufacturer | Texas Instruments | Texas Instruments | Texas Instruments
| | Manufacturer Part Number | INA240A2QDRQ1 | INA240A2QDRQ1 | INA240A2QDRQ1
| | PCB3D
| | Pin Info
| | Price | 3.8 | 3.8 | 3.8
| | Signal Integrity
| | Simulation
| | Supplier | Mouser | Mouser | Mouser
| | Supplier Part Number | 595-INA240A2QDRQ1 | 595-INA240A2QDRQ1 | 595-INA240A2QDRQ1
| | Value | INA240A2QDRQ1 | INA240A2QDRQ1 | INA240A2QDRQ1
U5 | PowerBoard.SchDoc | | Fitted | Fitted | Fitted
| | Comment | UCC21520ADW | UCC21520ADW | UCC21520ADW
| | Component Kind | Standard | Standard | Standard
| | Description | 4A/6A, 5.7 kVrms Isolated Dual Channel Gate Driver | 4A/6A, 5.7 kVrms Isolated Dual Channel Gate Driver | 4A/6A, 5.7 kVrms Isolated Dual Channel Gate Driver
| | Footprint | SOIC127P1030X265-16N | SOIC127P1030X265-16N | SOIC127P1030X265-16N
| | Ibis Model
| | Library Name | VESC_MotorController.SCHLIB | VESC_MotorController.SCHLIB | VESC_MotorController.SCHLIB
| | Library Reference | UCC21520ADW | UCC21520ADW | UCC21520ADW
| | Manufacturer | Texas Instruments | Texas Instruments | Texas Instruments
| | Manufacturer Part Number | UCC21520ADW | UCC21520ADW | UCC21520ADW
| | PCB3D
| | Pin Info
| | Price | 7.6 | 7.6 | 7.6
| | Signal Integrity
| | Simulation
| | Supplier | Mouser | Mouser | Mouser
| | Supplier Part Number | 595-UCC21520ADW | 595-UCC21520ADW | 595-UCC21520ADW
| | Value | UCC21520ADW | UCC21520ADW | UCC21520ADW
U6 | PowerBoard.SchDoc | | Fitted | Fitted | Fitted
| | Comment | INA240A2QDRQ1 | INA240A2QDRQ1 | INA240A2QDRQ1
| | Component Kind | Standard | Standard | Standard
| | Description | Automotive, High/Low Side, Bi-Directional Zer-Drift Current Sense Amp w/ Enhanced PWM Rejection | Automotive, High/Low Side, Bi-Directional Zer-Drift Current Sense Amp w/ Enhanced PWM Rejection | Automotive, High/Low Side, Bi-Directional Zer-Drift Current Sense Amp w/ Enhanced PWM Rejection
| | Footprint | SOIC127P600X175-8N | SOIC127P600X175-8N | SOIC127P600X175-8N
| | Ibis Model
| | Library Name | VESC_MotorController.SCHLIB | VESC_MotorController.SCHLIB | VESC_MotorController.SCHLIB
| | Library Reference | INA240A2QDRQ1 | INA240A2QDRQ1 | INA240A2QDRQ1
| | Manufacturer | Texas Instruments | Texas Instruments | Texas Instruments
| | Manufacturer Part Number | INA240A2QDRQ1 | INA240A2QDRQ1 | INA240A2QDRQ1
| | PCB3D
| | Pin Info
| | Price | 3.8 | 3.8 | 3.8
| | Signal Integrity
| | Simulation
| | Supplier | Mouser | Mouser | Mouser
| | Supplier Part Number | 595-INA240A2QDRQ1 | 595-INA240A2QDRQ1 | 595-INA240A2QDRQ1
| | Value | INA240A2QDRQ1 | INA240A2QDRQ1 | INA240A2QDRQ1
U7 | Controller.SchDoc | | Fitted | Not Fitted | Fitted
| | Comment | LM5164DDAR | | LM5164DDAR
| | Component Kind | Standard | | Standard
| | Description | Texas Instruments 6-V to 100-V Input, 1-A Synchronous Buck DC-DC Converter With Ultra-Low IQ 8-SO PowerPAD -40 to 150 | | Texas Instruments 6-V to 100-V Input, 1-A Synchronous Buck DC-DC Converter With Ultra-Low IQ 8-SO PowerPAD -40 to 150
| | Footprint | SOIC-8(EPAD) | | SOIC-8(EPAD)
| | Ibis Model
| | Library Name | VESC_MotorController.SCHLIB | | VESC_MotorController.SCHLIB
| | Library Reference | LM5164DDAR | | LM5164DDAR
| | Manufacturer | Texas Instruments | | Texas Instruments
| | Manufacturer Part Number | LM5164DDAR | | LM5164DDAR
| | PCB3D
| | Pin Info
| | Price | 3.5 | | 3.5
| | Signal Integrity
| | Simulation
| | Supplier | Mouser | | Mouser
| | Supplier Part Number | 595-LM5164DDAR | | 595-LM5164DDAR
| | Value | 1.7mm | | 1.7mm
U8 | Controller.SchDoc | | Fitted | Fitted | Fitted
| | Comment | MCP16311T-E_MNY | MCP16311T-E_MNY | MCP16311T-E_MNY
| | Component Kind | Standard | Standard | Standard
| | Description | Microchip, MCP16311T-E/MNY Step Down DC-DC Converter 1A Adjustable, 2 24 V 8-Pin, TDFN | Microchip, MCP16311T-E/MNY Step Down DC-DC Converter 1A Adjustable, 2 24 V 8-Pin, TDFN | Microchip, MCP16311T-E/MNY Step Down DC-DC Converter 1A Adjustable, 2 24 V 8-Pin, TDFN
| | Footprint | MSOP-8 | MSOP-8 | MSOP-8
| | Ibis Model
| | Library Name | VESC_MotorController.SCHLIB | VESC_MotorController.SCHLIB | VESC_MotorController.SCHLIB
| | Library Reference | MCP16311T-E_MNY | MCP16311T-E_MNY | MCP16311T-E_MNY
| | Manufacturer | Microchip | Microchip | Microchip
| | Manufacturer Part Number | MCP16311T-E/MNY | MCP16311T-E/MNY | MCP16311T-E/MNY
| | PCB3D
| | Pin Info
| | Price | 1.8 | 1.8 | 1.8
| | Signal Integrity
| | Simulation
| | Supplier | Mouser | Mouser | Mouser
| | Supplier Part Number | 579-MCP16311T-E/MNY | 579-MCP16311T-E/MNY | 579-MCP16311T-E/MNY
| | Value | MCP16311T-E/MNY | MCP16311T-E/MNY | MCP16311T-E/MNY
U9 | Controller.SchDoc | | Fitted | Not Fitted | Fitted
| | Comment | MCP16311T-E_MNY | | MCP16311T-E_MNY
| | Component Kind | Standard | | Standard
| | Description | Microchip, MCP16311T-E/MNY Step Down DC-DC Converter 1A Adjustable, 2 24 V 8-Pin, TDFN | | Microchip, MCP16311T-E/MNY Step Down DC-DC Converter 1A Adjustable, 2 24 V 8-Pin, TDFN
| | Footprint | MSOP-8 | | MSOP-8
| | Ibis Model
| | Library Name | VESC_MotorController.SCHLIB | | VESC_MotorController.SCHLIB
| | Library Reference | MCP16311T-E_MNY | | MCP16311T-E_MNY
| | Manufacturer | Microchip | | Microchip
| | Manufacturer Part Number | MCP16311T-E/MNY | | MCP16311T-E/MNY
| | PCB3D
| | Pin Info
| | Price | 1.8 | | 1.8
| | Signal Integrity
| | Simulation
| | Supplier | Mouser | | Mouser
| | Supplier Part Number | 579-MCP16311T-E/MNY | | 579-MCP16311T-E/MNY
| | Value | MCP16311T-E/MNY | | MCP16311T-E/MNY
U10 | Controller.SchDoc | | Fitted | Fitted | Fitted
| | Comment | STM32F405RGT6TR | STM32F405RGT6TR | STM32F405RGT6TR
| | Component Kind | Standard | Standard | Standard
| | Datasheet Link | http://www.st.com/web/en/resource/technical/document/datasheet/DM00037051.pdf | http://www.st.com/web/en/resource/technical/document/datasheet/DM00037051.pdf | http://www.st.com/web/en/resource/technical/document/datasheet/DM00037051.pdf
| | Description | STM32F405RGT6TR, 32 bit ARM Cortex M4 MCU 168MHz 1024 kB Flash, 192 kB RAM, 2xUSB CAN I2C 64-Pin LQFP | STM32F405RGT6TR, 32 bit ARM Cortex M4 MCU 168MHz 1024 kB Flash, 192 kB RAM, 2xUSB CAN I2C 64-Pin LQFP | STM32F405RGT6TR, 32 bit ARM Cortex M4 MCU 168MHz 1024 kB Flash, 192 kB RAM, 2xUSB CAN I2C 64-Pin LQFP
| | Footprint | QFP50P1200X1200X160-64N | QFP50P1200X1200X160-64N | QFP50P1200X1200X160-64N
| | Geometry.Height | 1.6mm | 1.6mm | 1.6mm
| | Ibis Model
| | Library Name | STM32F405RGT6TR.SchLib | STM32F405RGT6TR.SchLib | STM32F405RGT6TR.SchLib
| | Library Reference | STM32F405RGT6TR | STM32F405RGT6TR | STM32F405RGT6TR
| | Manufacturer_Name | STMicroelectronics | STMicroelectronics | STMicroelectronics
| | Manufacturer_Part_Number | STM32F405RGT6TR | STM32F405RGT6TR | STM32F405RGT6TR
| | Mouser Part Number | 511-STM32F405RGT6TR | 511-STM32F405RGT6TR | 511-STM32F405RGT6TR
| | Mouser Price/Stock | https://www.mouser.co.uk/ProductDetail/STMicroelectronics/STM32F405RGT6TR?qs=MavH1QghrkHshpR6GkvPIg%3D%3D | https://www.mouser.co.uk/ProductDetail/STMicroelectronics/STM32F405RGT6TR?qs=MavH1QghrkHshpR6GkvPIg%3D%3D | https://www.mouser.co.uk/ProductDetail/STMicroelectronics/STM32F405RGT6TR?qs=MavH1QghrkHshpR6GkvPIg%3D%3D
| | PCB3D
| | Pin Info
| | Signal Integrity
| | Simulation
U11 | Controller.SchDoc | | Fitted | Fitted | Fitted
| | Comment | USBLC6-2SC6Y | USBLC6-2SC6Y | USBLC6-2SC6Y
| | Component Kind | Standard | Standard | Standard
| | Description | Low Cap. ESD Protection Auto SOT-23-6 STMicroelectronics USBLC6-2SC6Y, Dual Uni-Directional TVS Diode Array, 6-Pin SOT-23 | Low Cap. ESD Protection Auto SOT-23-6 STMicroelectronics USBLC6-2SC6Y, Dual Uni-Directional TVS Diode Array, 6-Pin SOT-23 | Low Cap. ESD Protection Auto SOT-23-6 STMicroelectronics USBLC6-2SC6Y, Dual Uni-Directional TVS Diode Array, 6-Pin SOT-23
| | Footprint | SOT95P280X145-6N | SOT95P280X145-6N | SOT95P280X145-6N
| | Ibis Model
| | Library Name | VESC_MotorController.SCHLIB | VESC_MotorController.SCHLIB | VESC_MotorController.SCHLIB
| | Library Reference | USBLC6-2SC6Y | USBLC6-2SC6Y | USBLC6-2SC6Y
| | Manufacturer | STMicroelectronics | STMicroelectronics | STMicroelectronics
| | Manufacturer Part Number | USBLC6-2SC6Y | USBLC6-2SC6Y | USBLC6-2SC6Y
| | PCB3D
| | Pin Info
| | Price | 1.45 | 1.45 | 1.45
| | Signal Integrity
| | Simulation
| | Supplier | Mouser | Mouser | Mouser
| | Supplier Part Number | 511-USBLC6-2SC6Y | 511-USBLC6-2SC6Y | 511-USBLC6-2SC6Y
| | Value | USBLC6-2SC6Y | USBLC6-2SC6Y | USBLC6-2SC6Y
U12 | Controller.SchDoc | | Fitted | Fitted | Fitted
| | Comment | TJA1051T_3_CM_118 | TJA1051T_3_CM_118 | TJA1051T_3_CM_118
| | Component Kind | Standard | Standard | Standard
| | Description | CAN Interface IC BL Advanced Automotive Analog | CAN Interface IC BL Advanced Automotive Analog | CAN Interface IC BL Advanced Automotive Analog
| | Footprint | SOIC127P600X175-8N | SOIC127P600X175-8N | SOIC127P600X175-8N
| | Ibis Model
| | Library Name | VESC_MotorController.SCHLIB | VESC_MotorController.SCHLIB | VESC_MotorController.SCHLIB
| | Library Reference | TJA1051T_3_CM_118 | TJA1051T_3_CM_118 | TJA1051T_3_CM_118
| | Manufacturer | NXP Semiconductors | NXP Semiconductors | NXP Semiconductors
| | Manufacturer Part Number | TJA1051T/3/CM,118 | TJA1051T/3/CM,118 | TJA1051T/3/CM,118
| | PCB3D
| | Pin Info
| | Price | 1.6 | 1.6 | 1.6
| | Signal Integrity
| | Simulation
| | Supplier | Mouser | Mouser | Mouser
| | Supplier Part Number | 771-TJA1051T/3CM118 | 771-TJA1051T/3CM118 | 771-TJA1051T/3CM118
| | Value | TJA1051T/3/CM,118 | TJA1051T/3/CM,118 | TJA1051T/3/CM,118
Y1 | Controller.SchDoc | | Fitted | Fitted | Fitted
| | Comment | FL0800026Q | FL0800026Q | FL0800026Q
| | Component Kind | Standard | Standard | Standard
| | Description | 8 MHz A±30ppm Crystals Crystal Ceramic SEAM3225 T&R 3K | 8 MHz A±30ppm Crystals Crystal Ceramic SEAM3225 T&R 3K | 8 MHz A±30ppm Crystals Crystal Ceramic SEAM3225 T&R 3K
| | Footprint | XTAL_FL0800026Q | XTAL_FL0800026Q | XTAL_FL0800026Q
| | Ibis Model
| | Library Name | VESC_MotorController.SCHLIB | VESC_MotorController.SCHLIB | VESC_MotorController.SCHLIB
| | Library Reference | FL0800026Q | FL0800026Q | FL0800026Q
| | Manufacturer | Diodes Incorporated | Diodes Incorporated | Diodes Incorporated
| | Manufacturer Part Number | FL0800026Q | FL0800026Q | FL0800026Q
| | PCB3D
| | Pin Info
| | Price | 0.5 | 0.5 | 0.5
| | Signal Integrity
| | Simulation
| | Supplier | Mouser | Mouser | Mouser
| | Supplier Part Number | 621-FL0800026Q | 621-FL0800026Q | 621-FL0800026Q
| | Value | 8MHz | 8MHz | 8MHz

Back to top
