designmaster0928/VESC_MotorController/REFER/Basic/bldc-hardware-master/bldc-hardware-master/design/PNGs/B_Modules-1.png

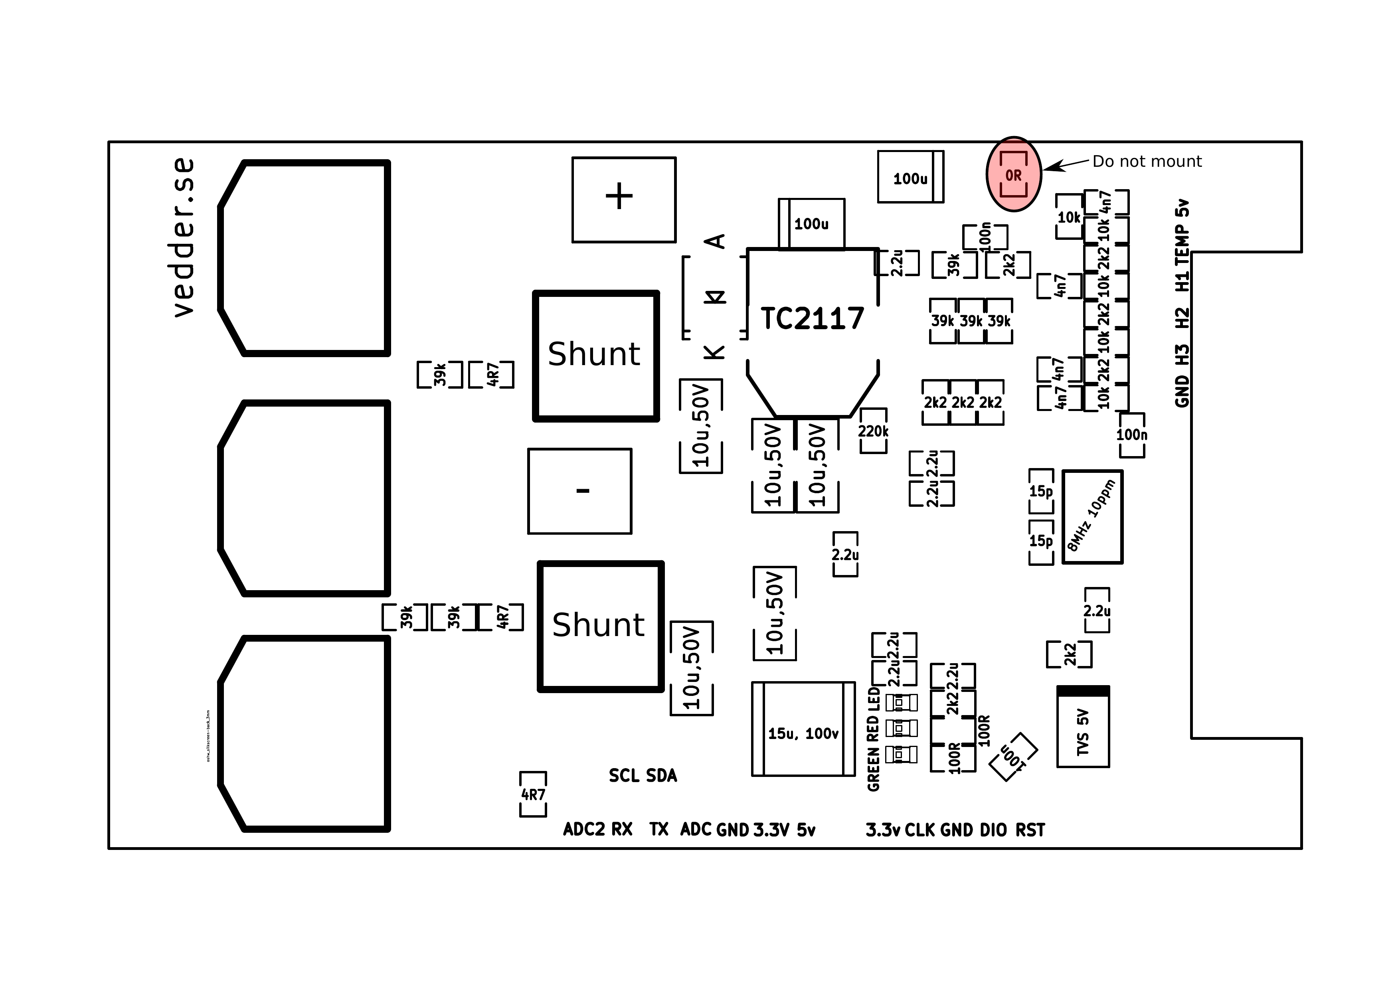
REFER/Basic/bldc-hardware-master/bldc-hardware-master/design/PNGs/B_Modules-1.png
