designmaster0928/VESC_MotorController/REFER/Basic/bldc-hardware-master/bldc-hardware-master/design/PNGs/Schematic-6.png

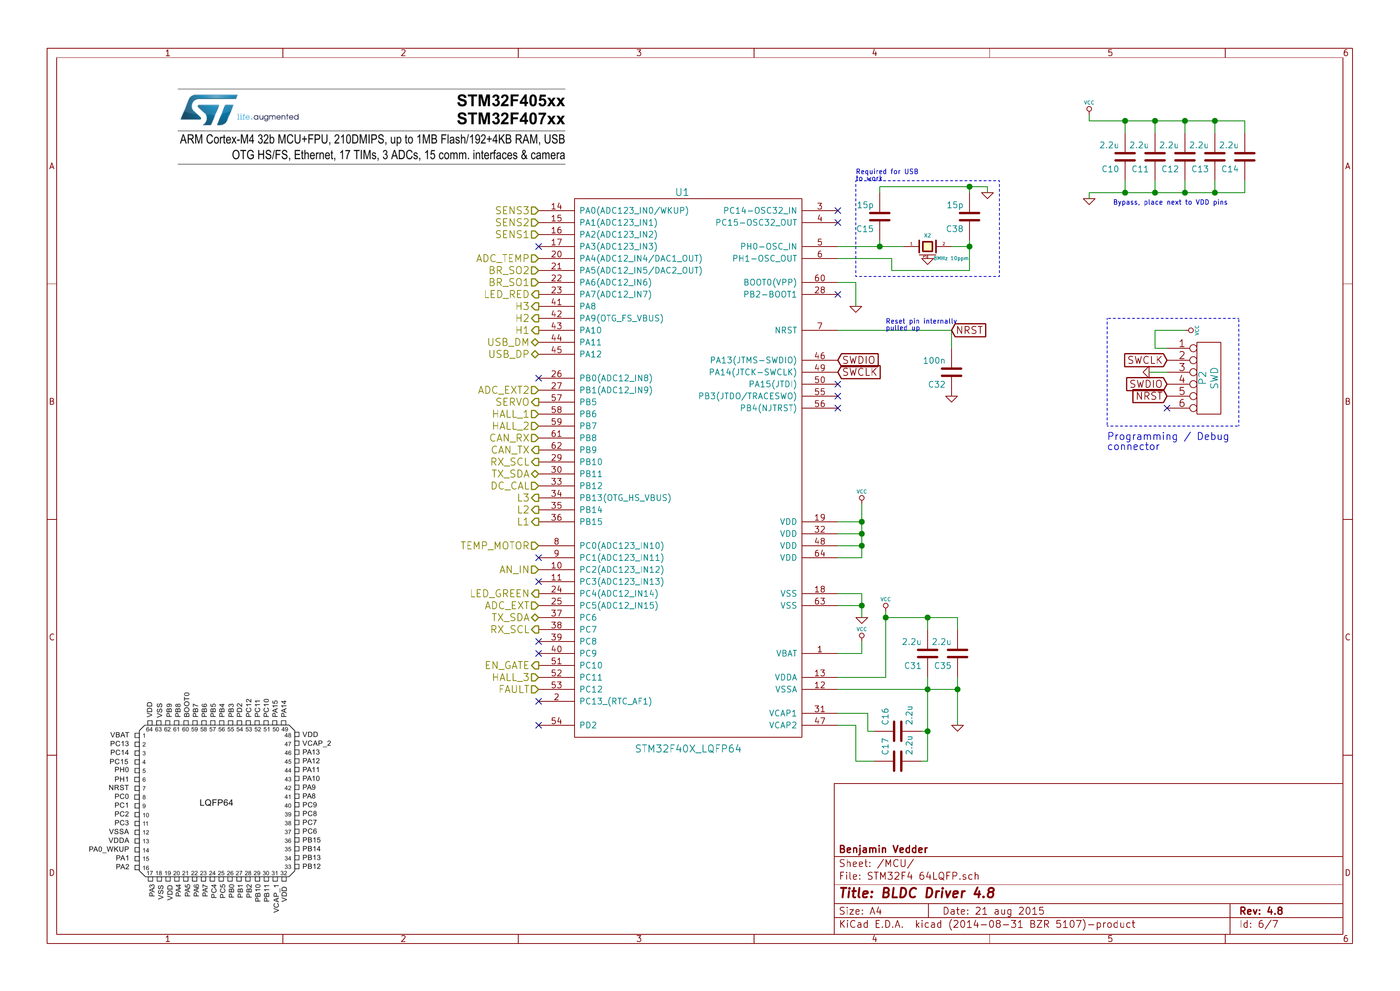
REFER/Basic/bldc-hardware-master/bldc-hardware-master/design/PNGs/Schematic-6.png
