designmaster0928/VESC_MotorController/REFER/Basic/bldc-hardware-master/bldc-hardware-master/design/PNGs/vesc_back_silk_neg.png

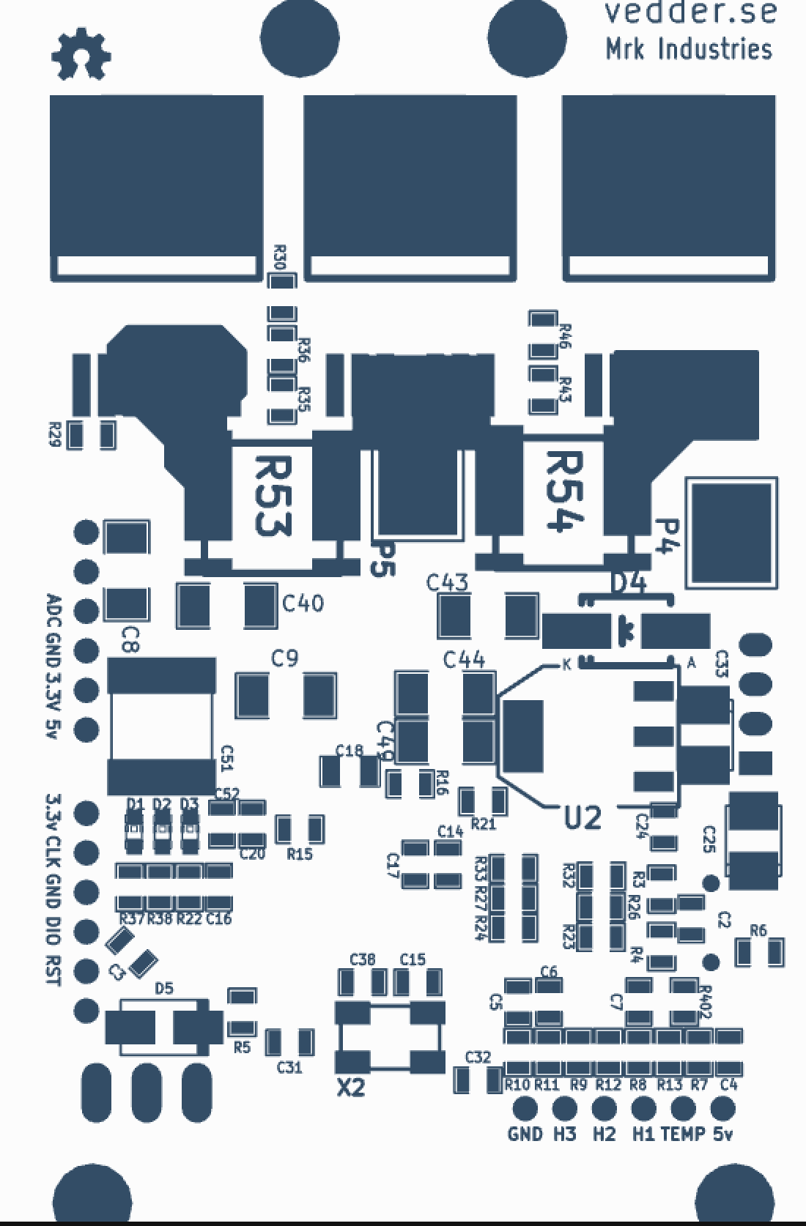
REFER/Basic/bldc-hardware-master/bldc-hardware-master/design/PNGs/vesc_back_silk_neg.png
