designmaster0928/VESC_MotorController/REFER/Basic/bldc-master/bldc-master/lispBM/lispBM/doc/images/list.png

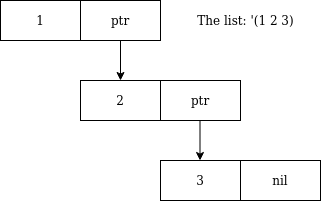
REFER/Basic/bldc-master/bldc-master/lispBM/lispBM/doc/images/list.png
