designmaster0928/VESC_MotorController/REFER/Basic/bldc-master/bldc-master/lispBM/lispBM/mascot/lispbm_llama.png

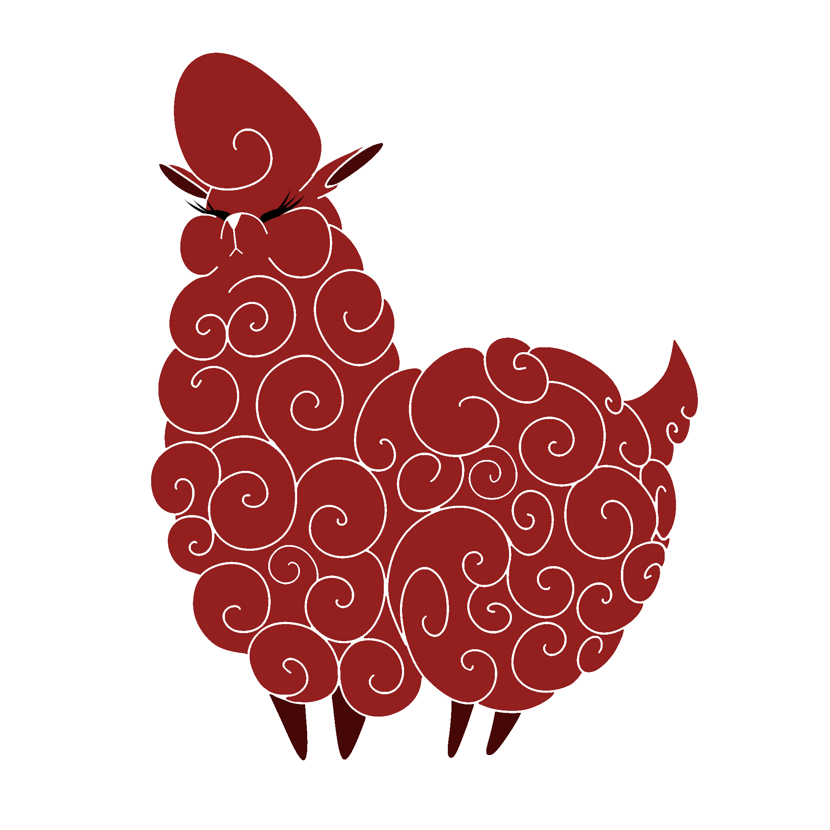
REFER/Basic/bldc-master/bldc-master/lispBM/lispBM/mascot/lispbm_llama.png
