designmaster0928/VESC_MotorController/REFER/Basic/bldc-master/bldc-master/lispBM/lispBM/sdlrepl/tex1.png

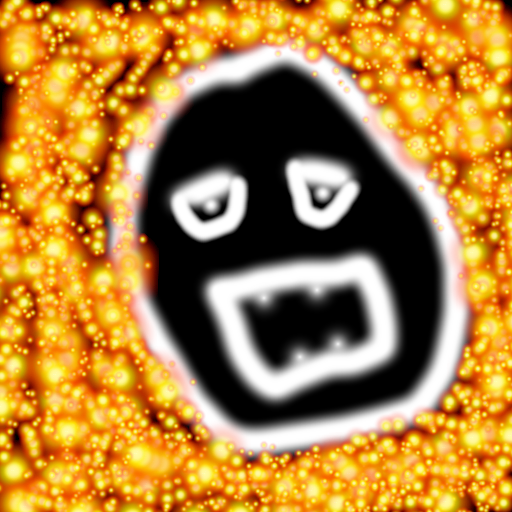
REFER/Basic/bldc-master/bldc-master/lispBM/lispBM/sdlrepl/tex1.png
