designmaster0928/VESC_MotorController/REFER/Basic/Forum/Capture.PNG

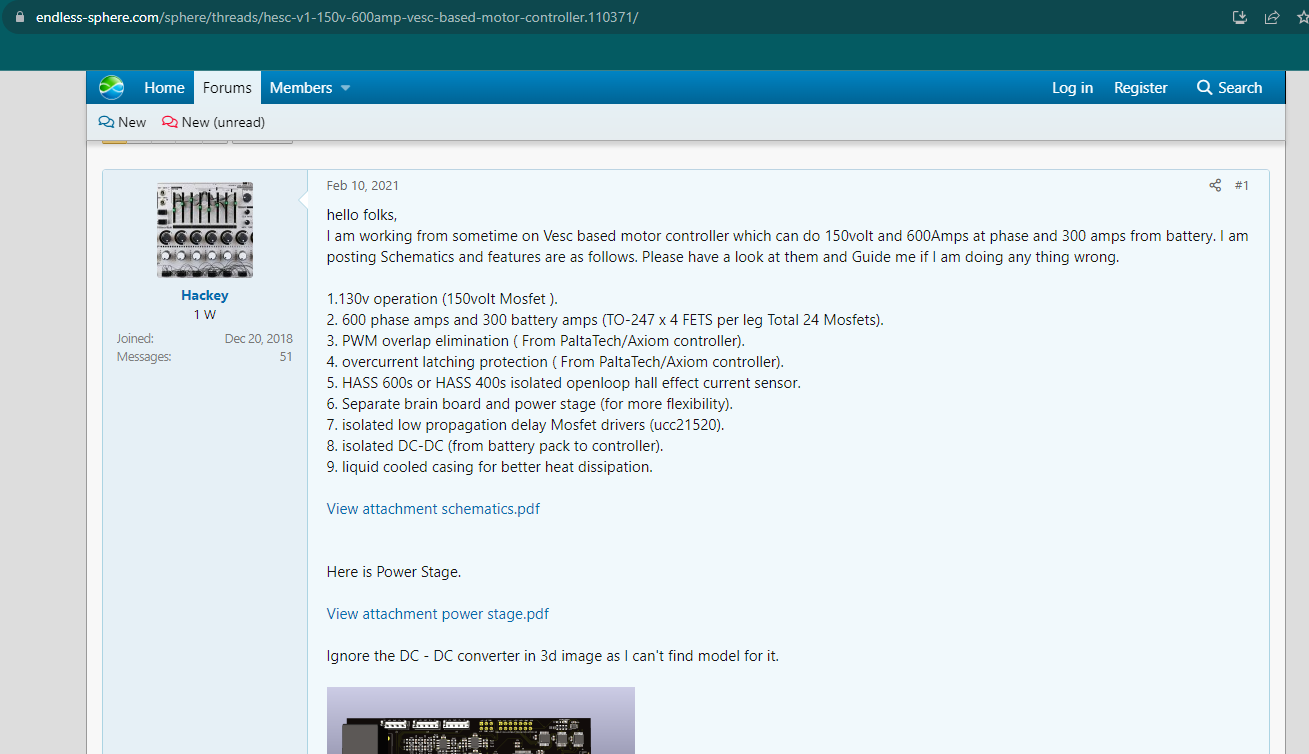
REFER/Basic/Forum/Capture.PNG
