designmaster0928/VESC_MotorController/REFER/Other/MOSFET4568.png

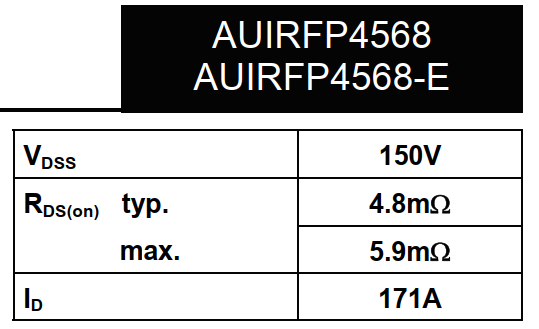
REFER/Other/MOSFET4568.png
