designmaster0928/VESC_MotorController/REFER/Other/Screenshot_1.png

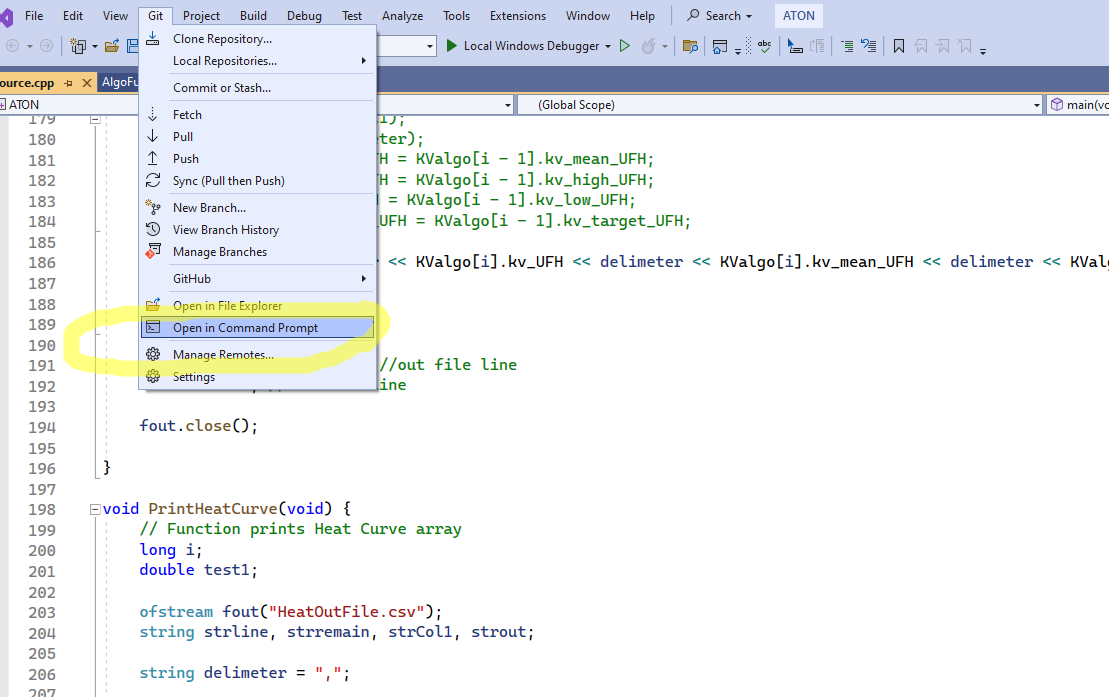
REFER/Other/Screenshot_1.png
