designmaster0928/VESC_MotorController/REFER/Basic/vesc_75_300.pdf

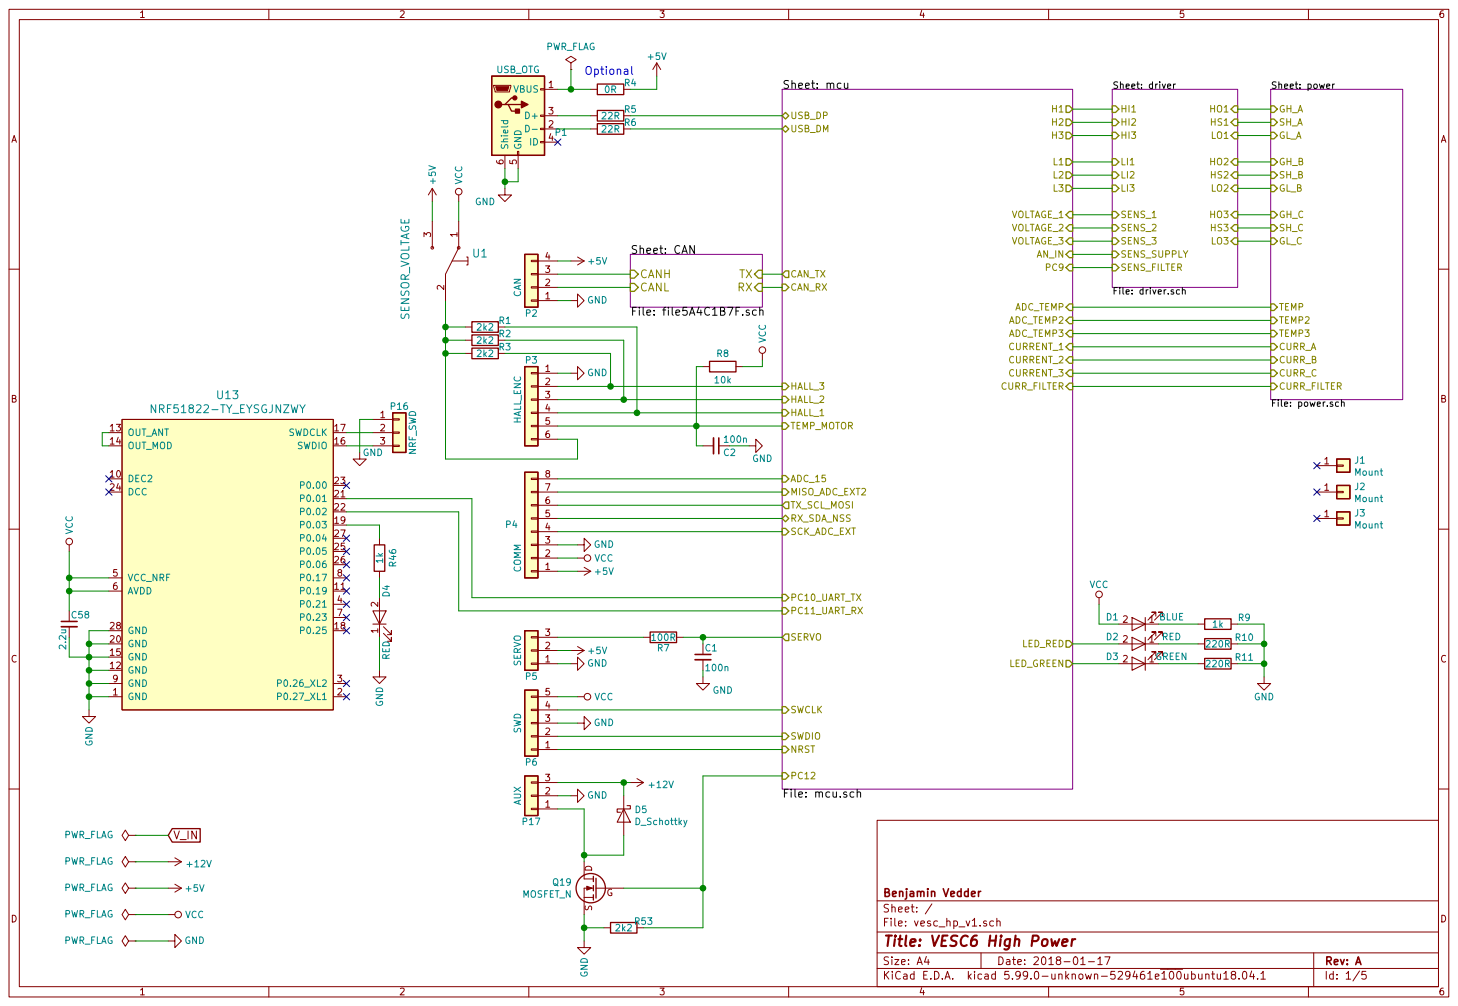
[picture p38: page 1]

Sheet: driver File: driver.sch HI1

File: vesc_hp_v1.sch Sheet: / Benjamin Vedder

Id: 1/5 Title: VESC6 High Power

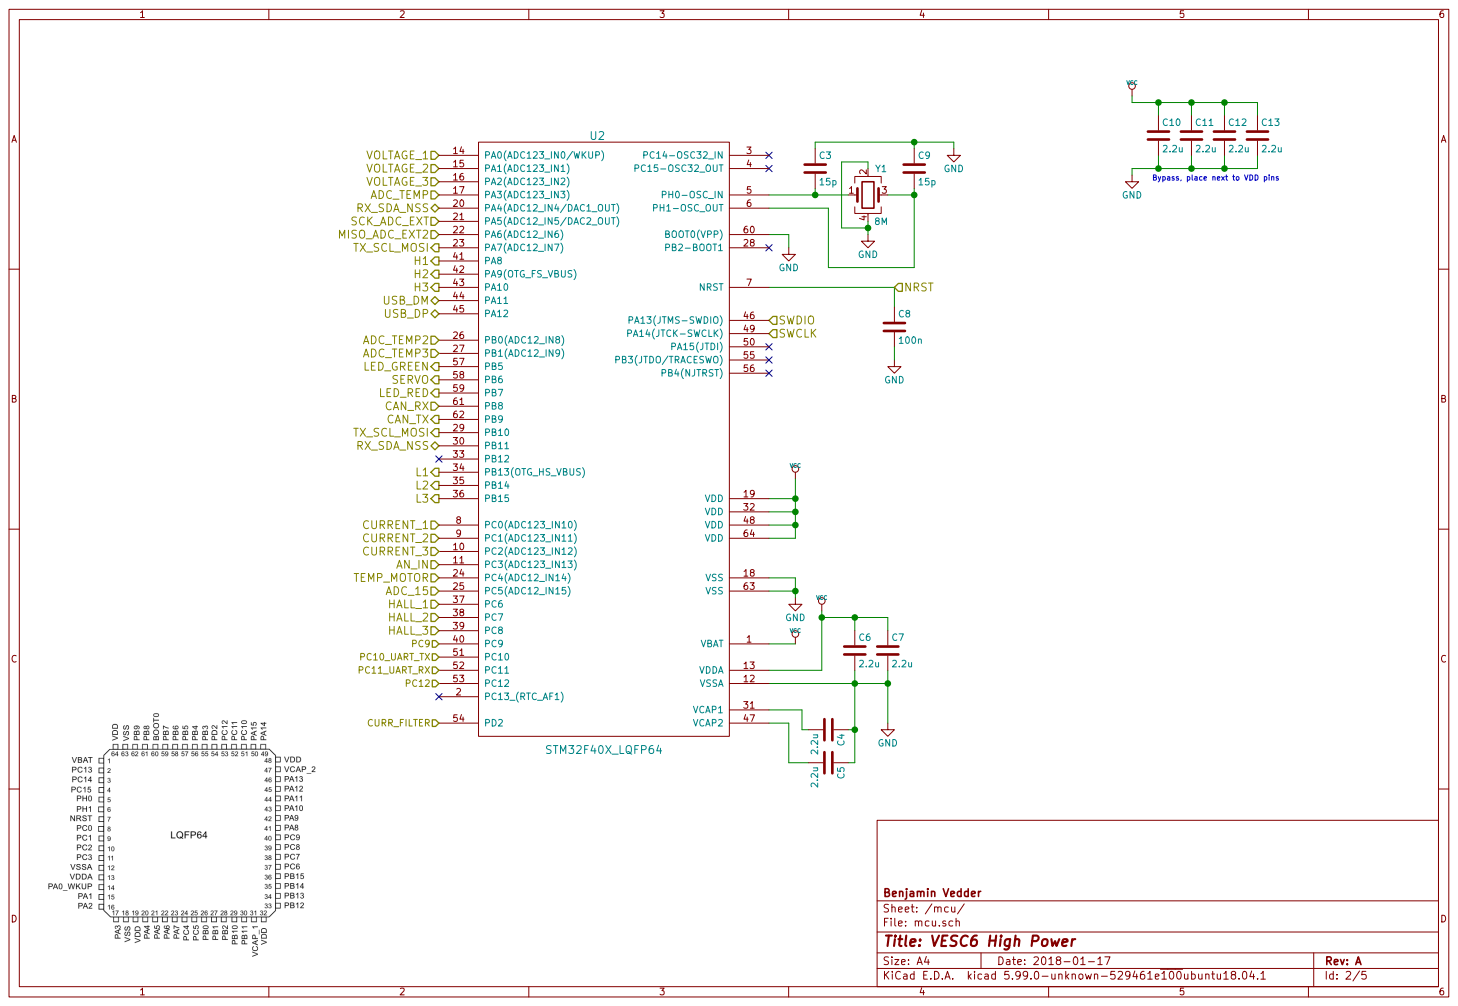
[picture p39: page 2]

Id: 2/5 Title: VESC6 High Power File: mcu.sch Sheet: /mcu/ Benjamin Vedder

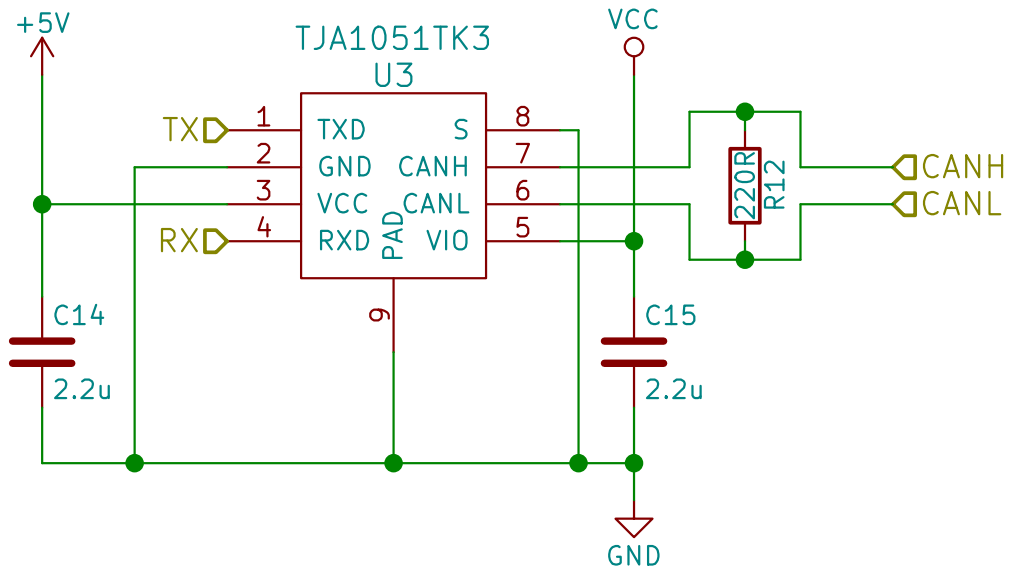
[picture p40: page 3]

Id: 3/5 Title: VESC6 High Power File: file5A4C1B7F.sch Sheet: /CAN/

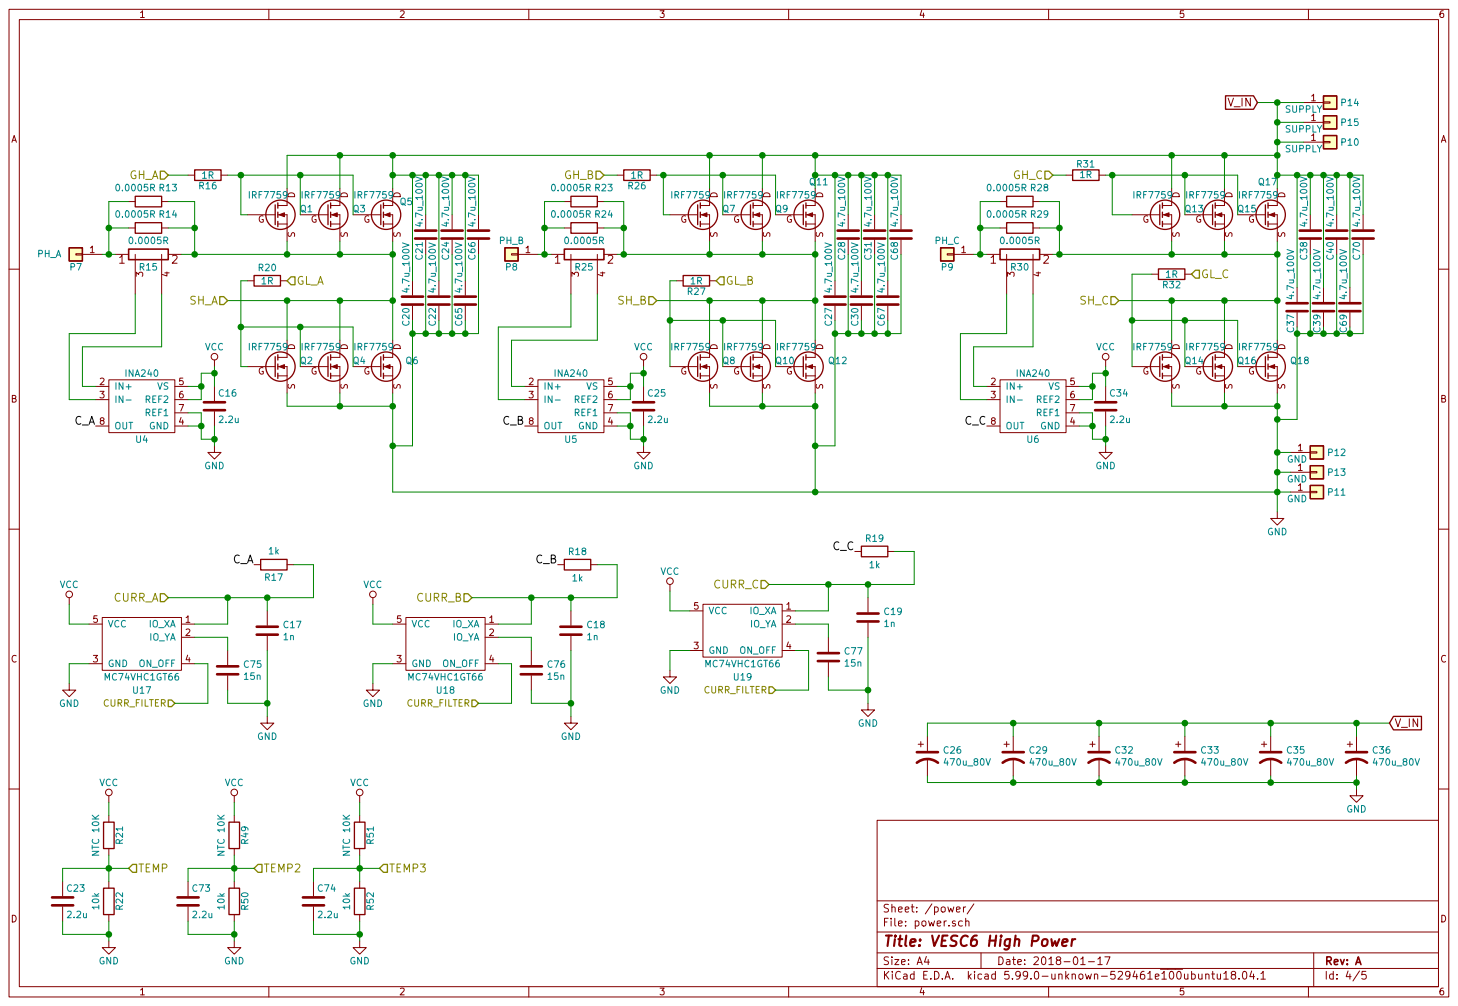
[picture p41: page 4]

Sheet: /power/
File: power.sch
Id: 4/5 Title: VESC6 High Power

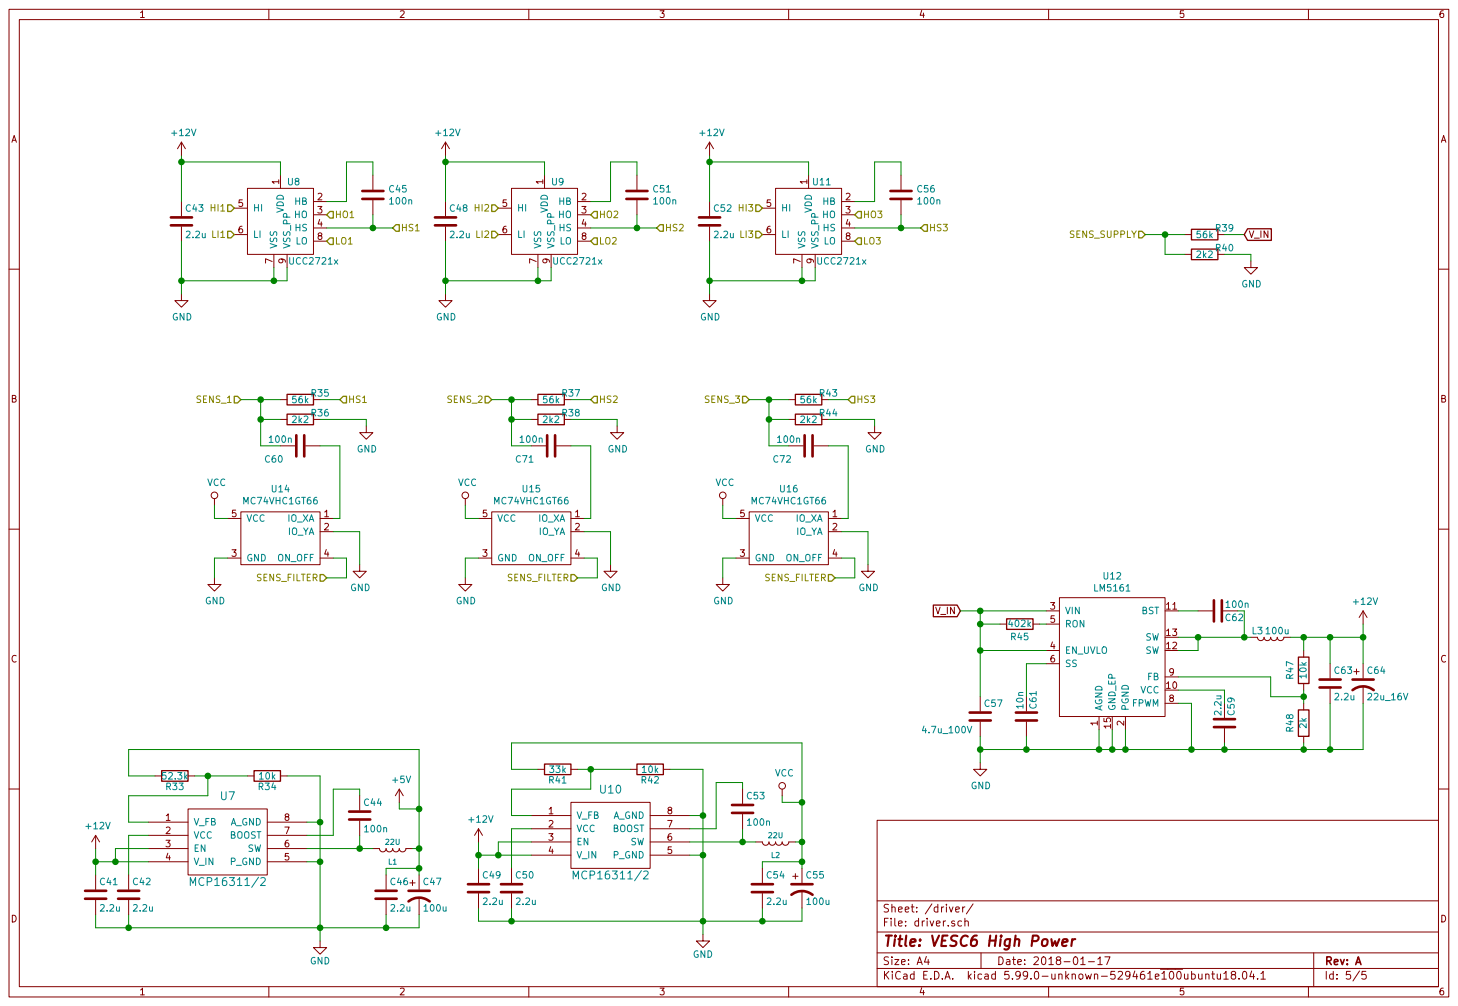
[picture p42: page 5]

9 U8UCC2721x V_FB 1 VCC 2 EN 3 V_IN 4 P_GND 5 SW 6 BOOST 7 A_GND 8 U7 MCP16311/2
2.2u GND

Id: 5/5 Title: VESC6 High Power File: driver.sch Sheet: /driver/ VDD

2 VIN 3 EN_UVLO 4 RON 5 SS 6 FPWM 8 FB 9 U12

1 VCC 10 BST 11 SW 12 SW 13 GND_EP 15 PGND
