designmaster0928/VESC_MotorController/REFER/Basic/manual-vesc75_300CsoxkG1zn5XZb.pdf

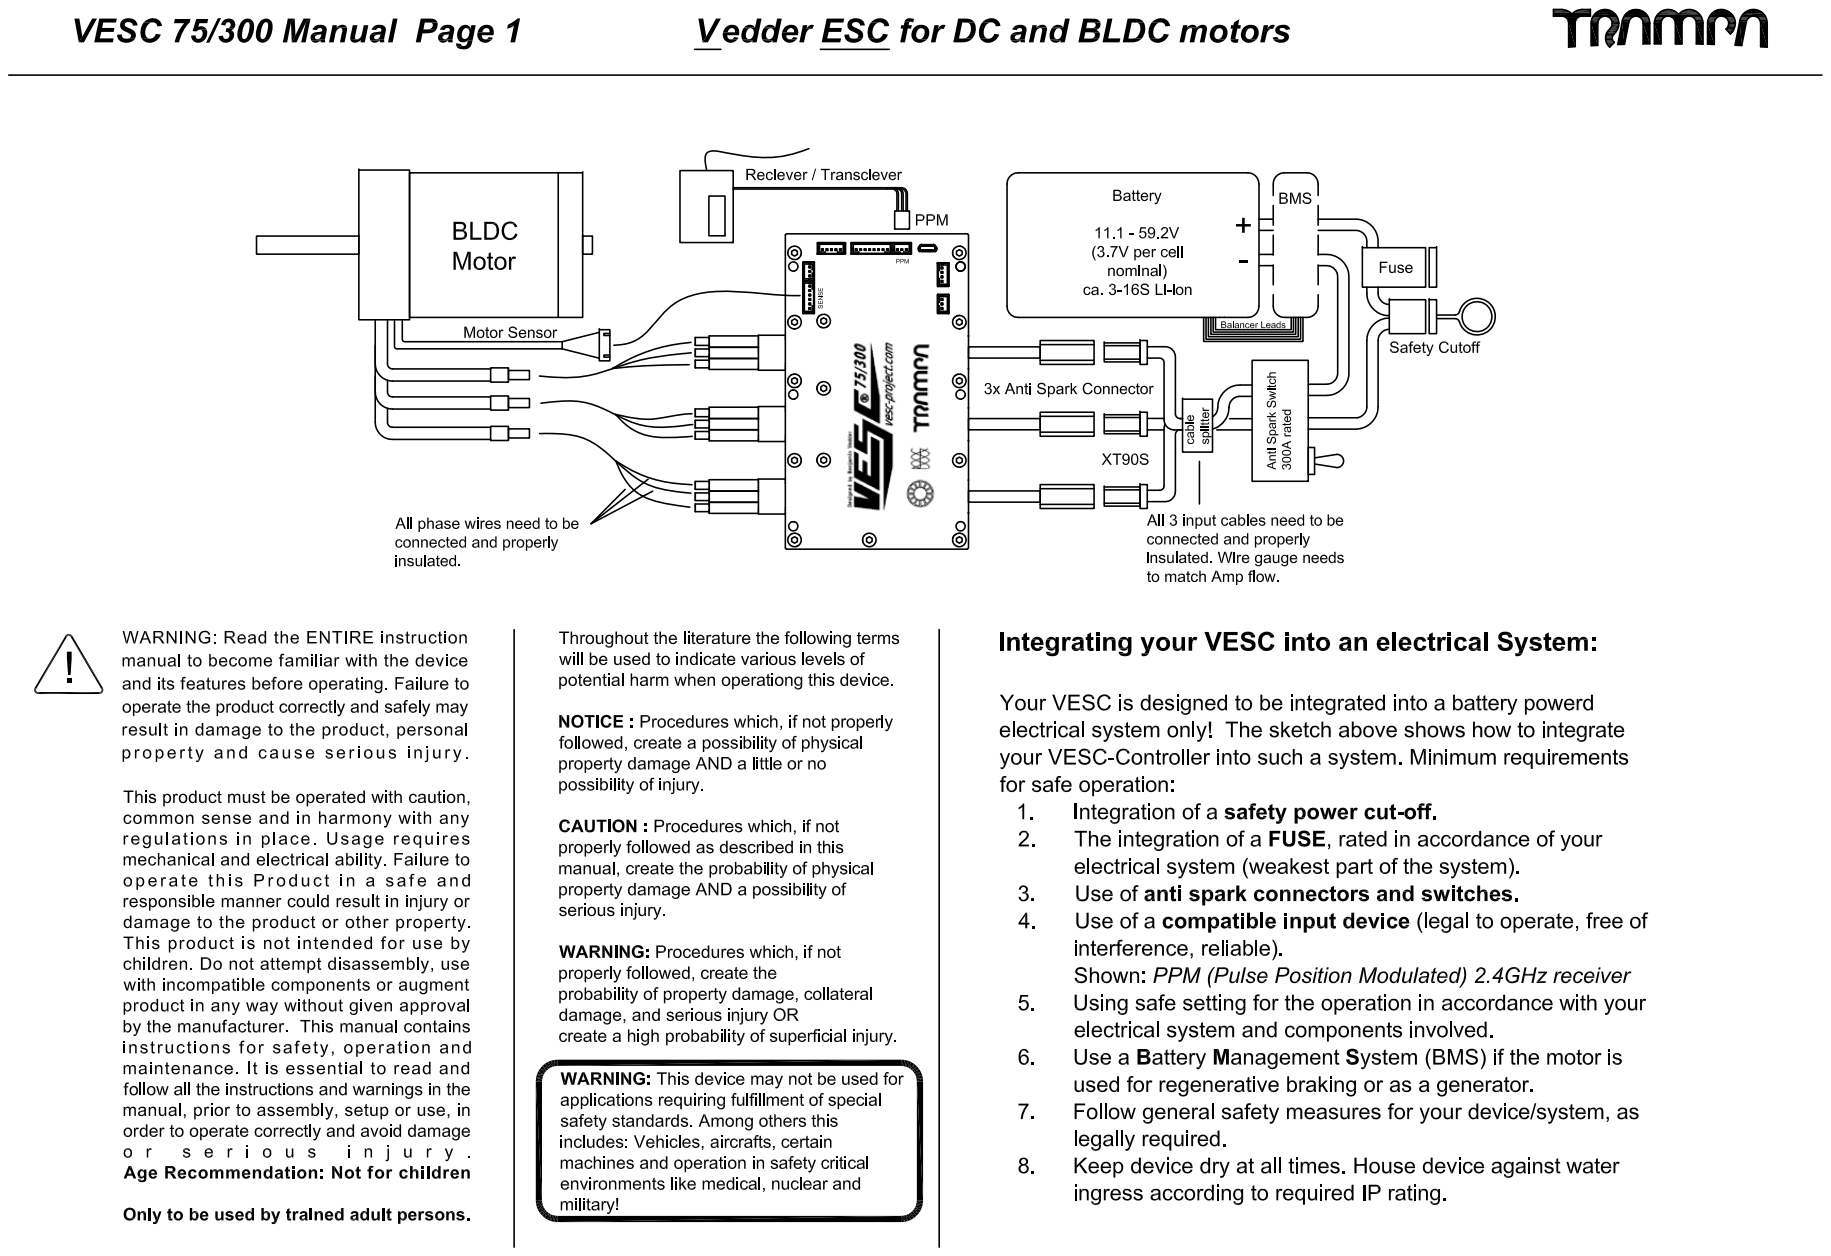
[picture p43: page 1]

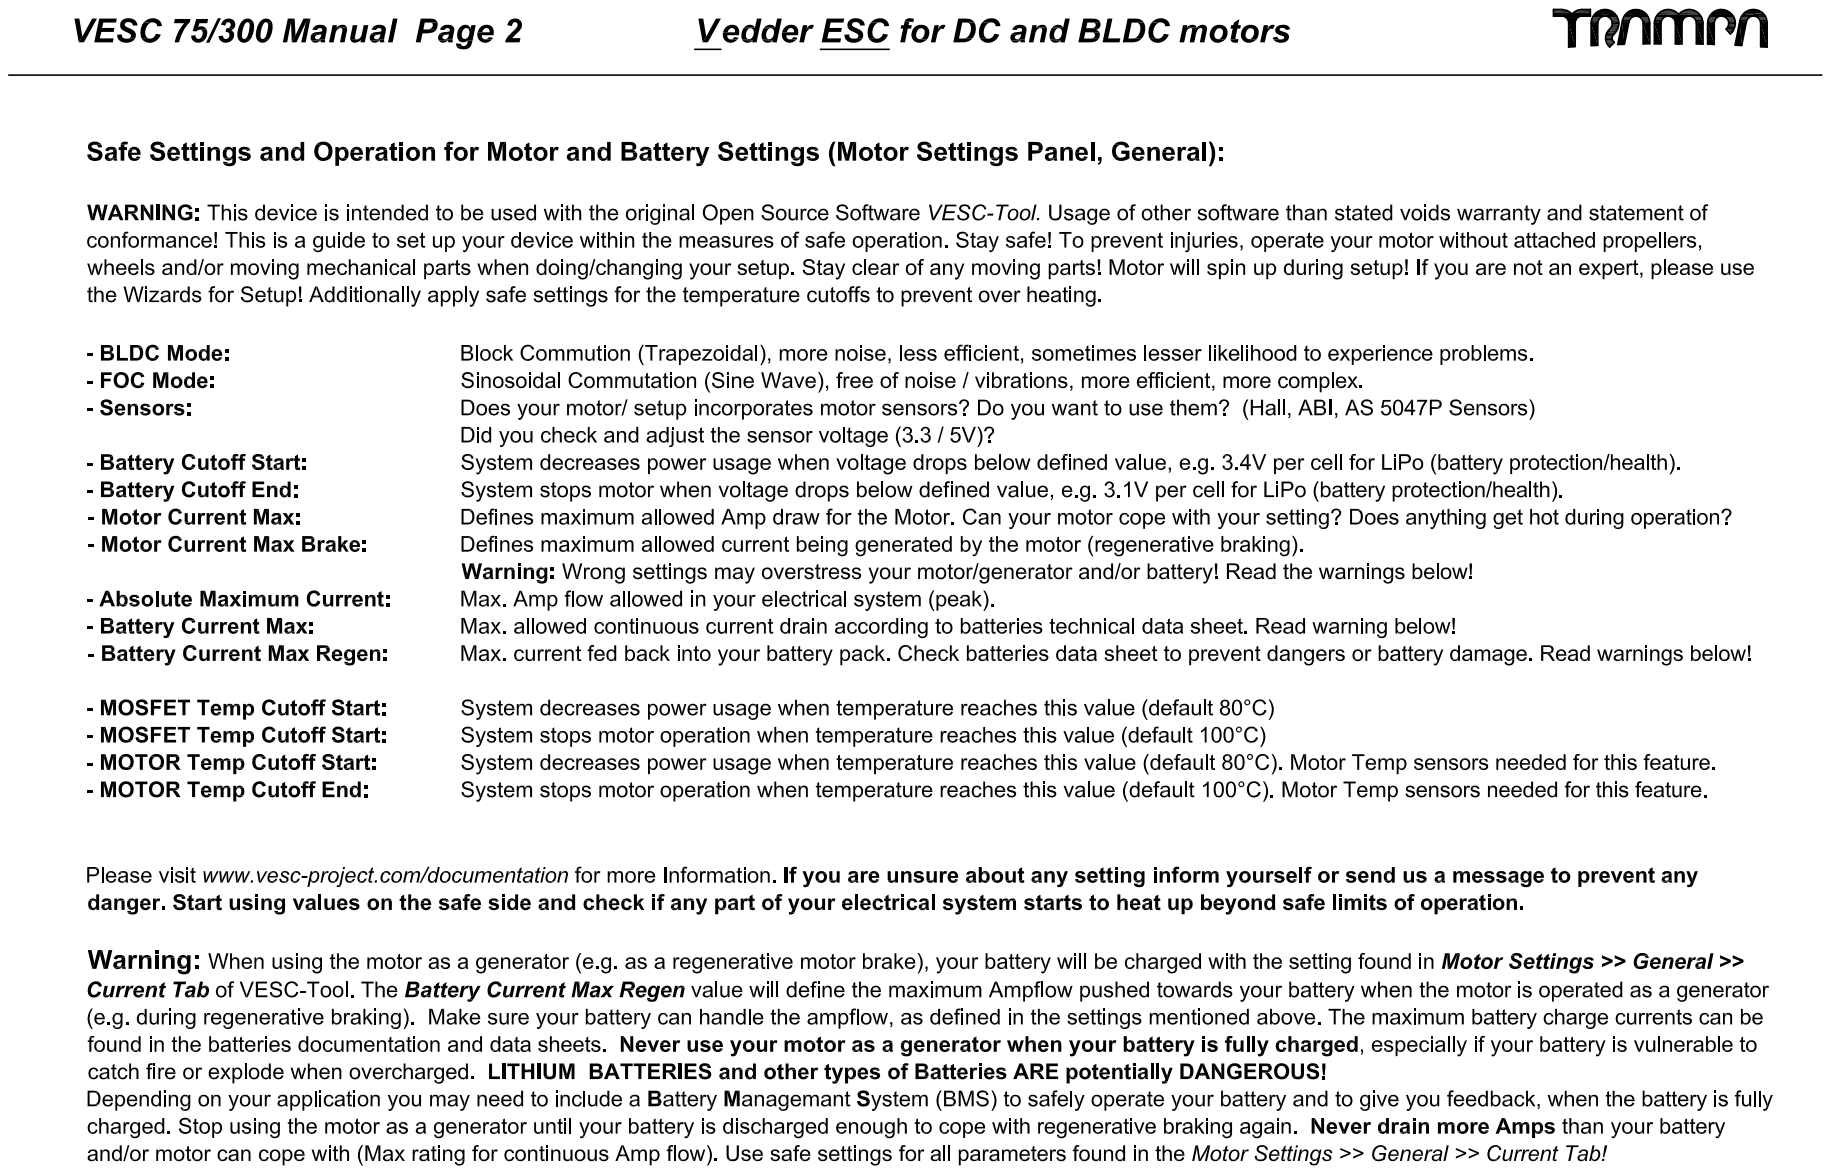
[picture p44: page 2]

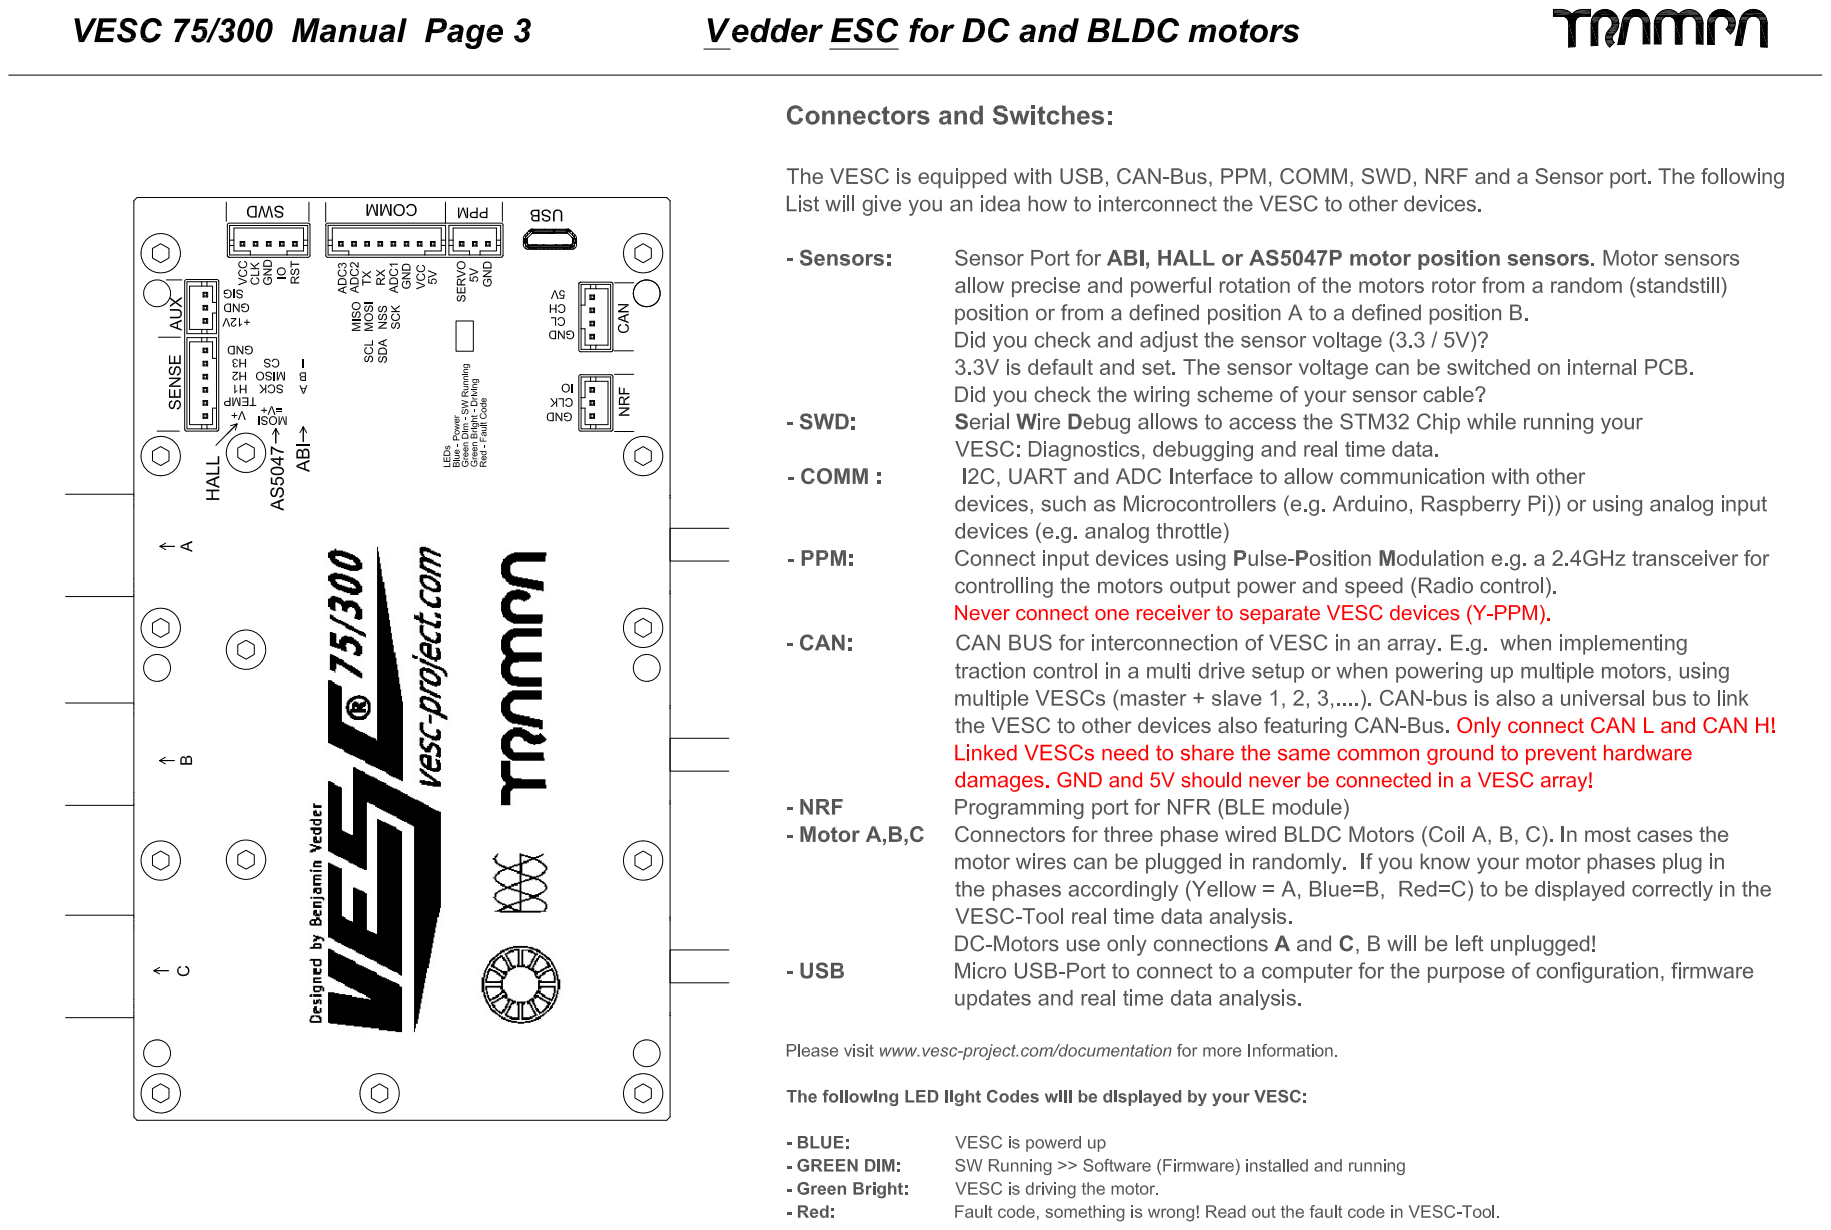
[picture p45: page 3]

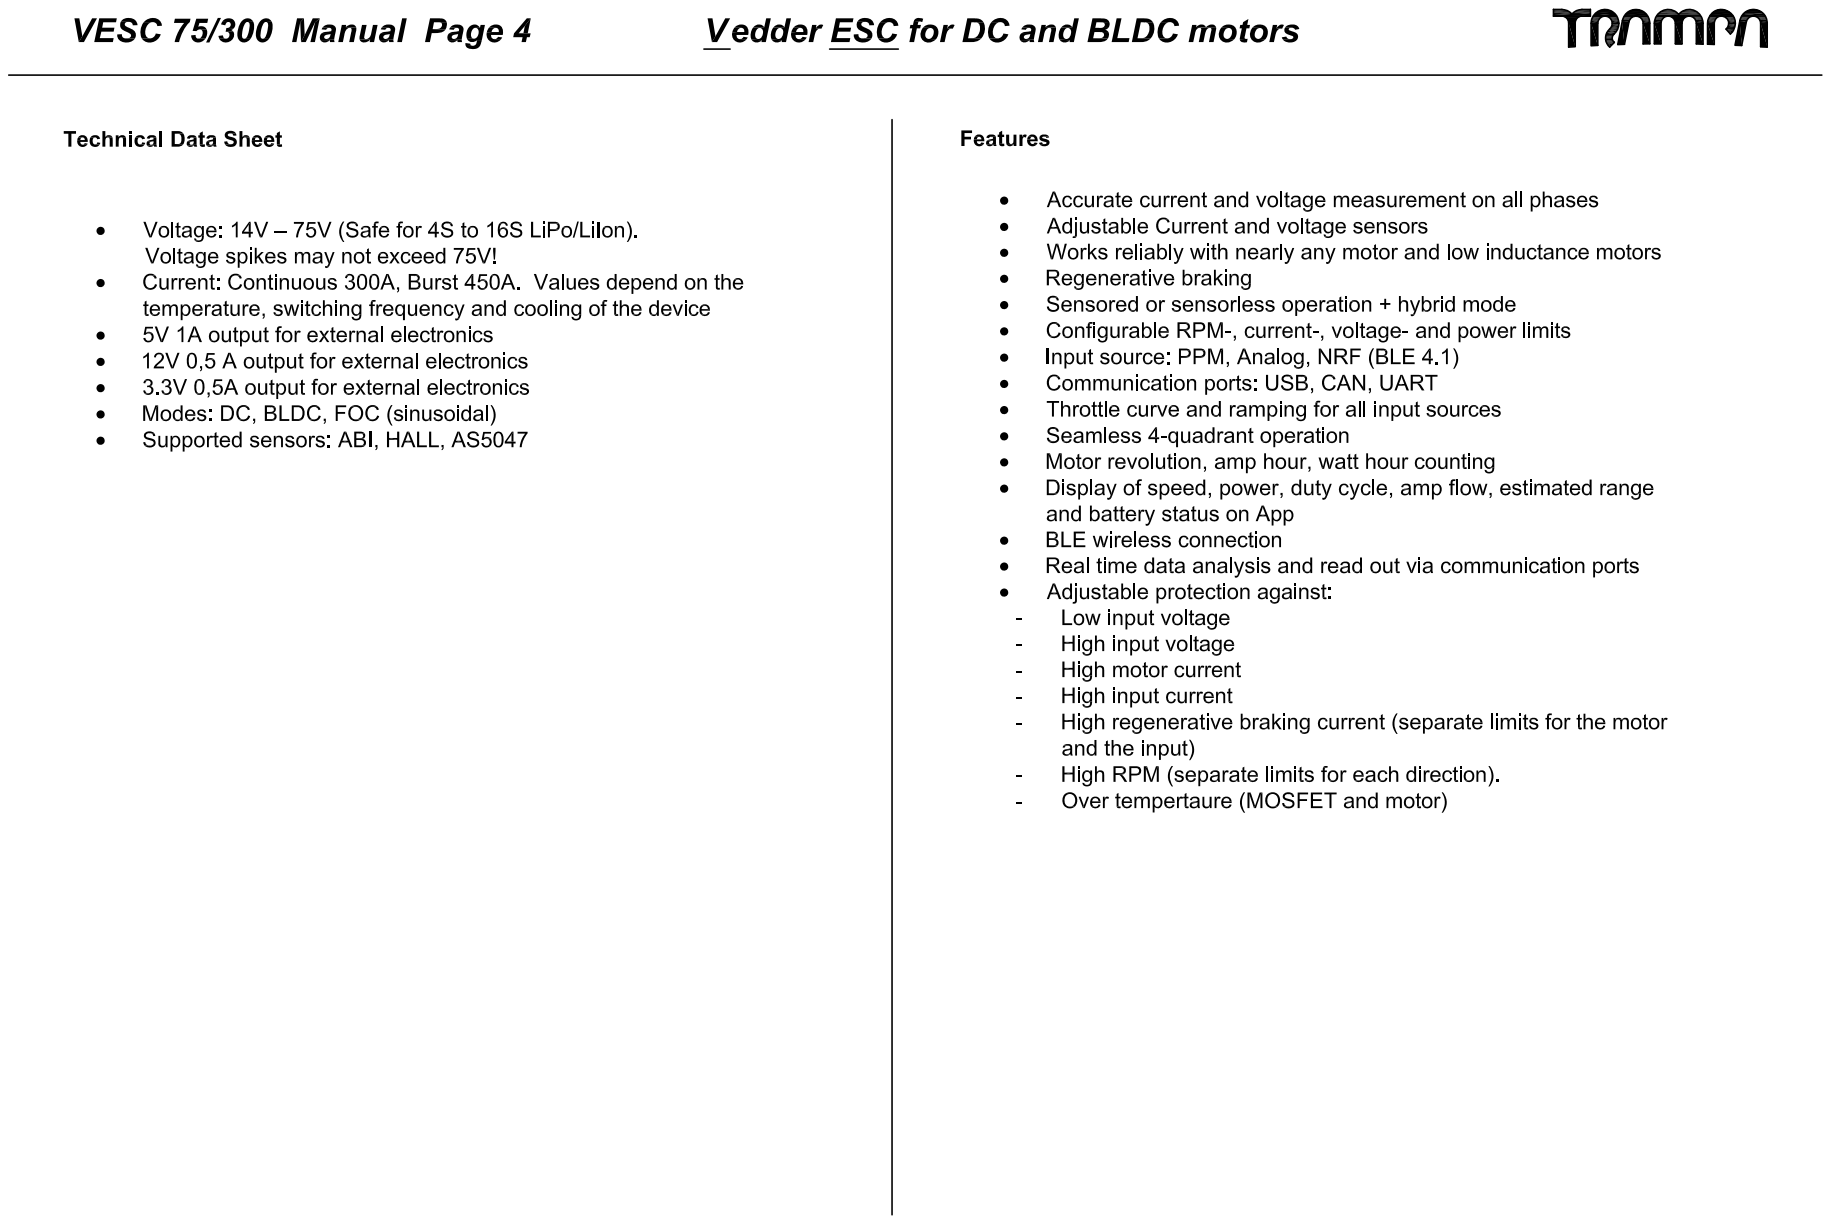
[picture p46: page 4]

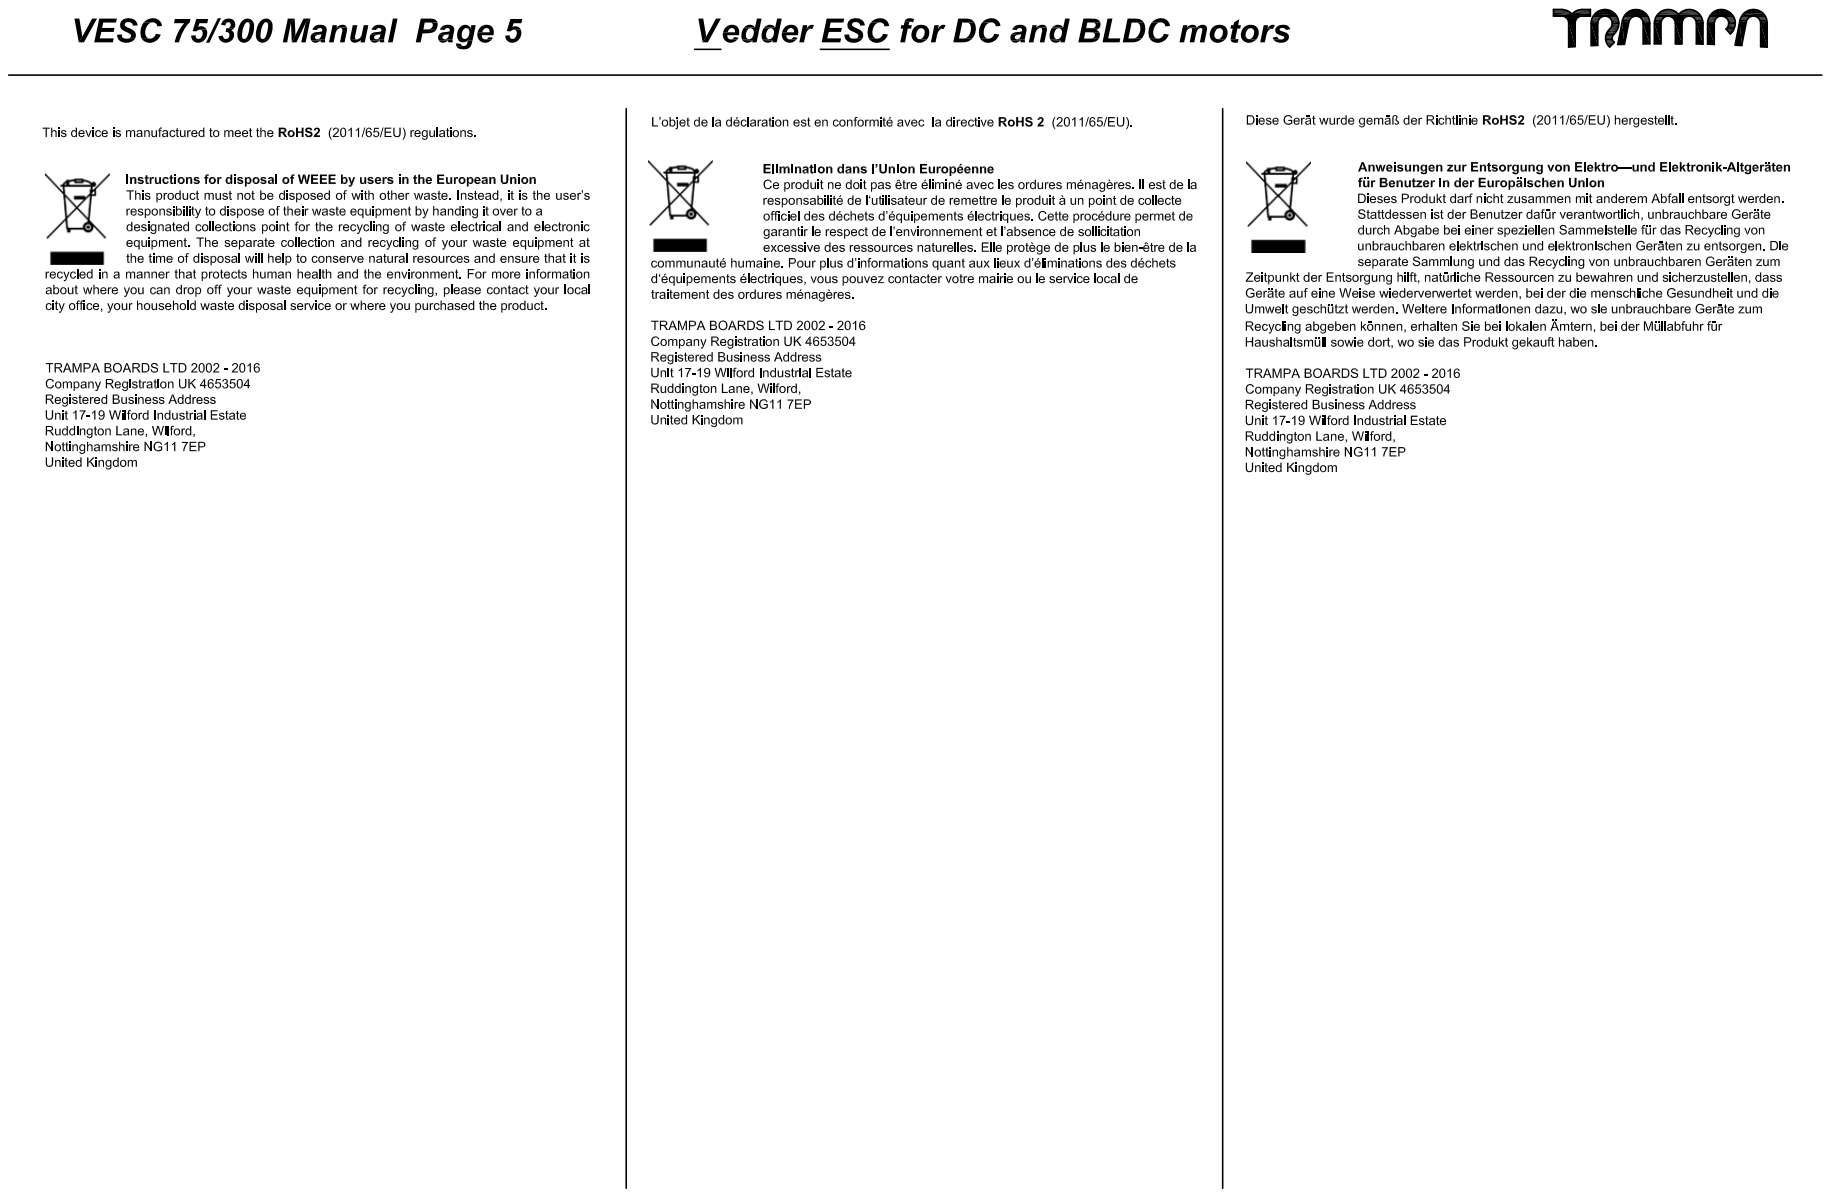
[picture p47: page 5]

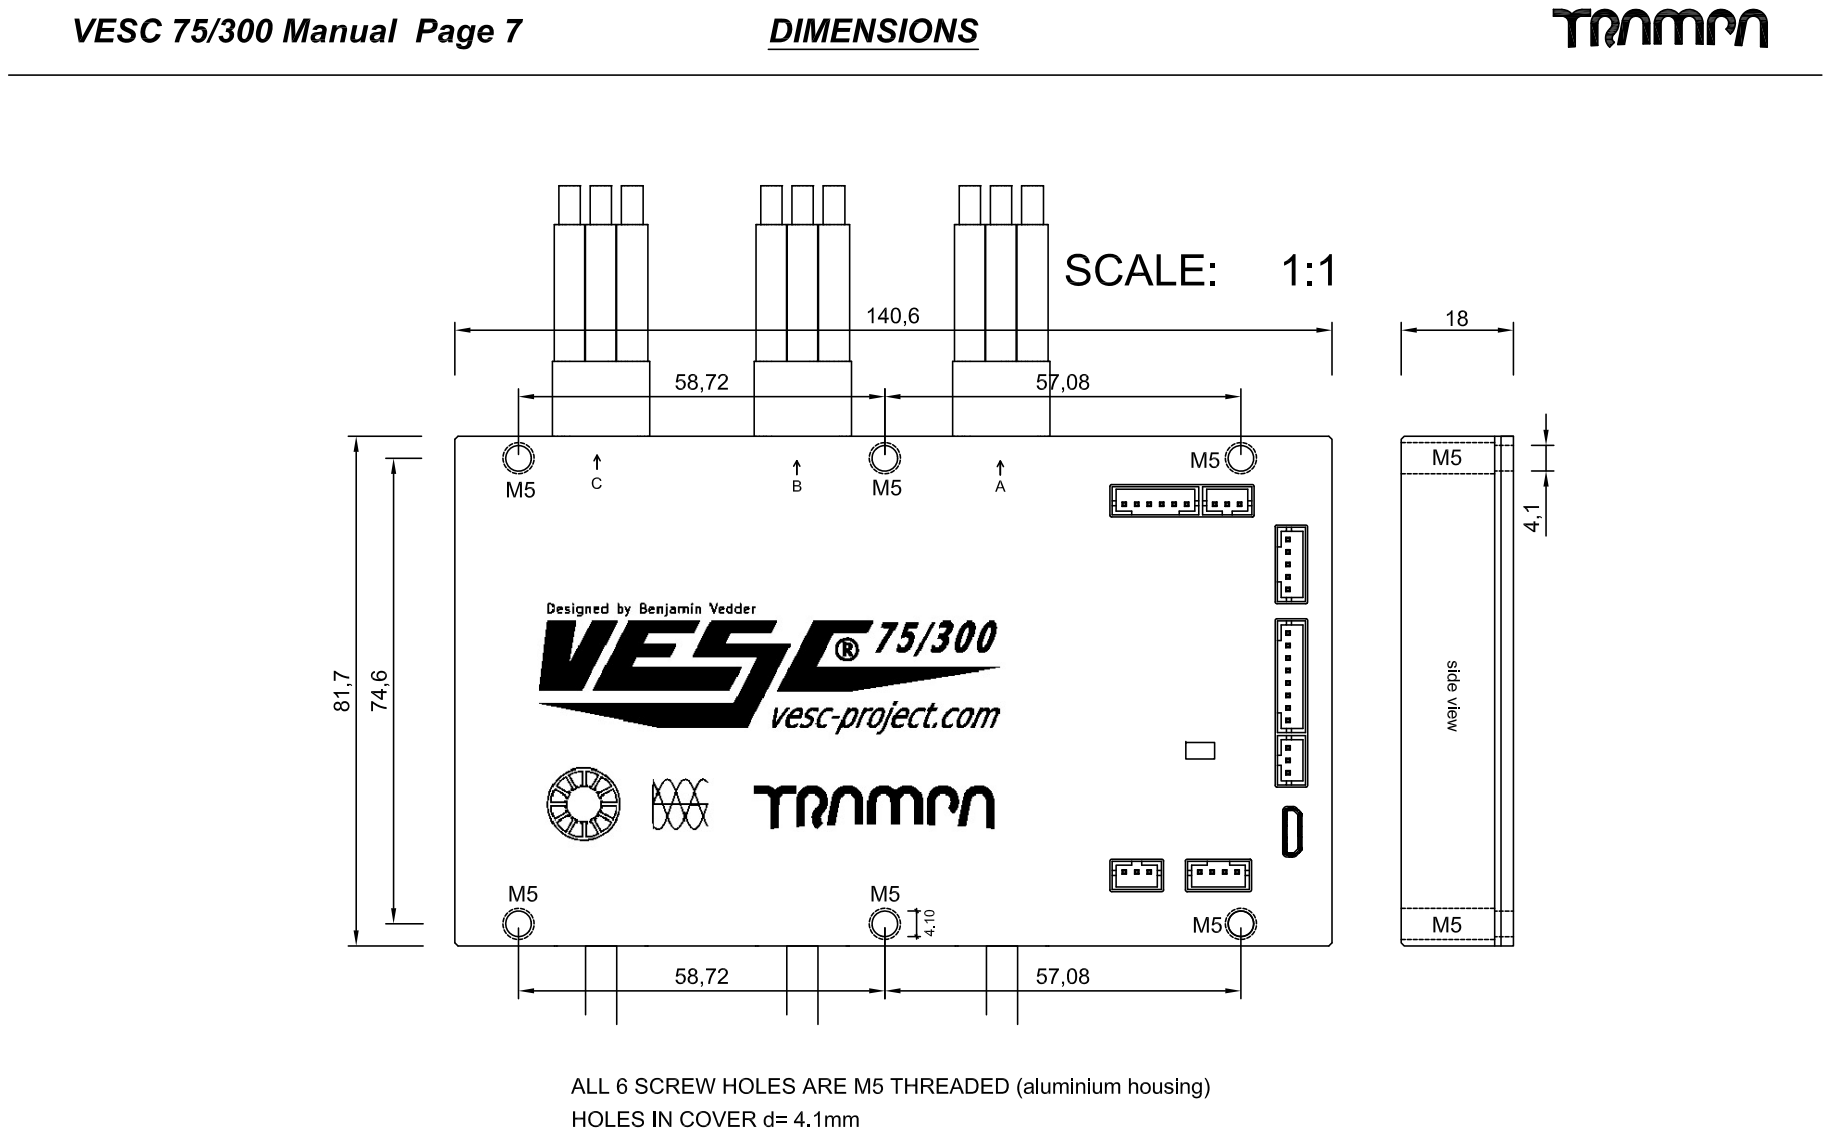
[picture p48: page 6]
