designmaster0928/VESC_MotorController/REFER/Basic/Forum/schematics.pdf

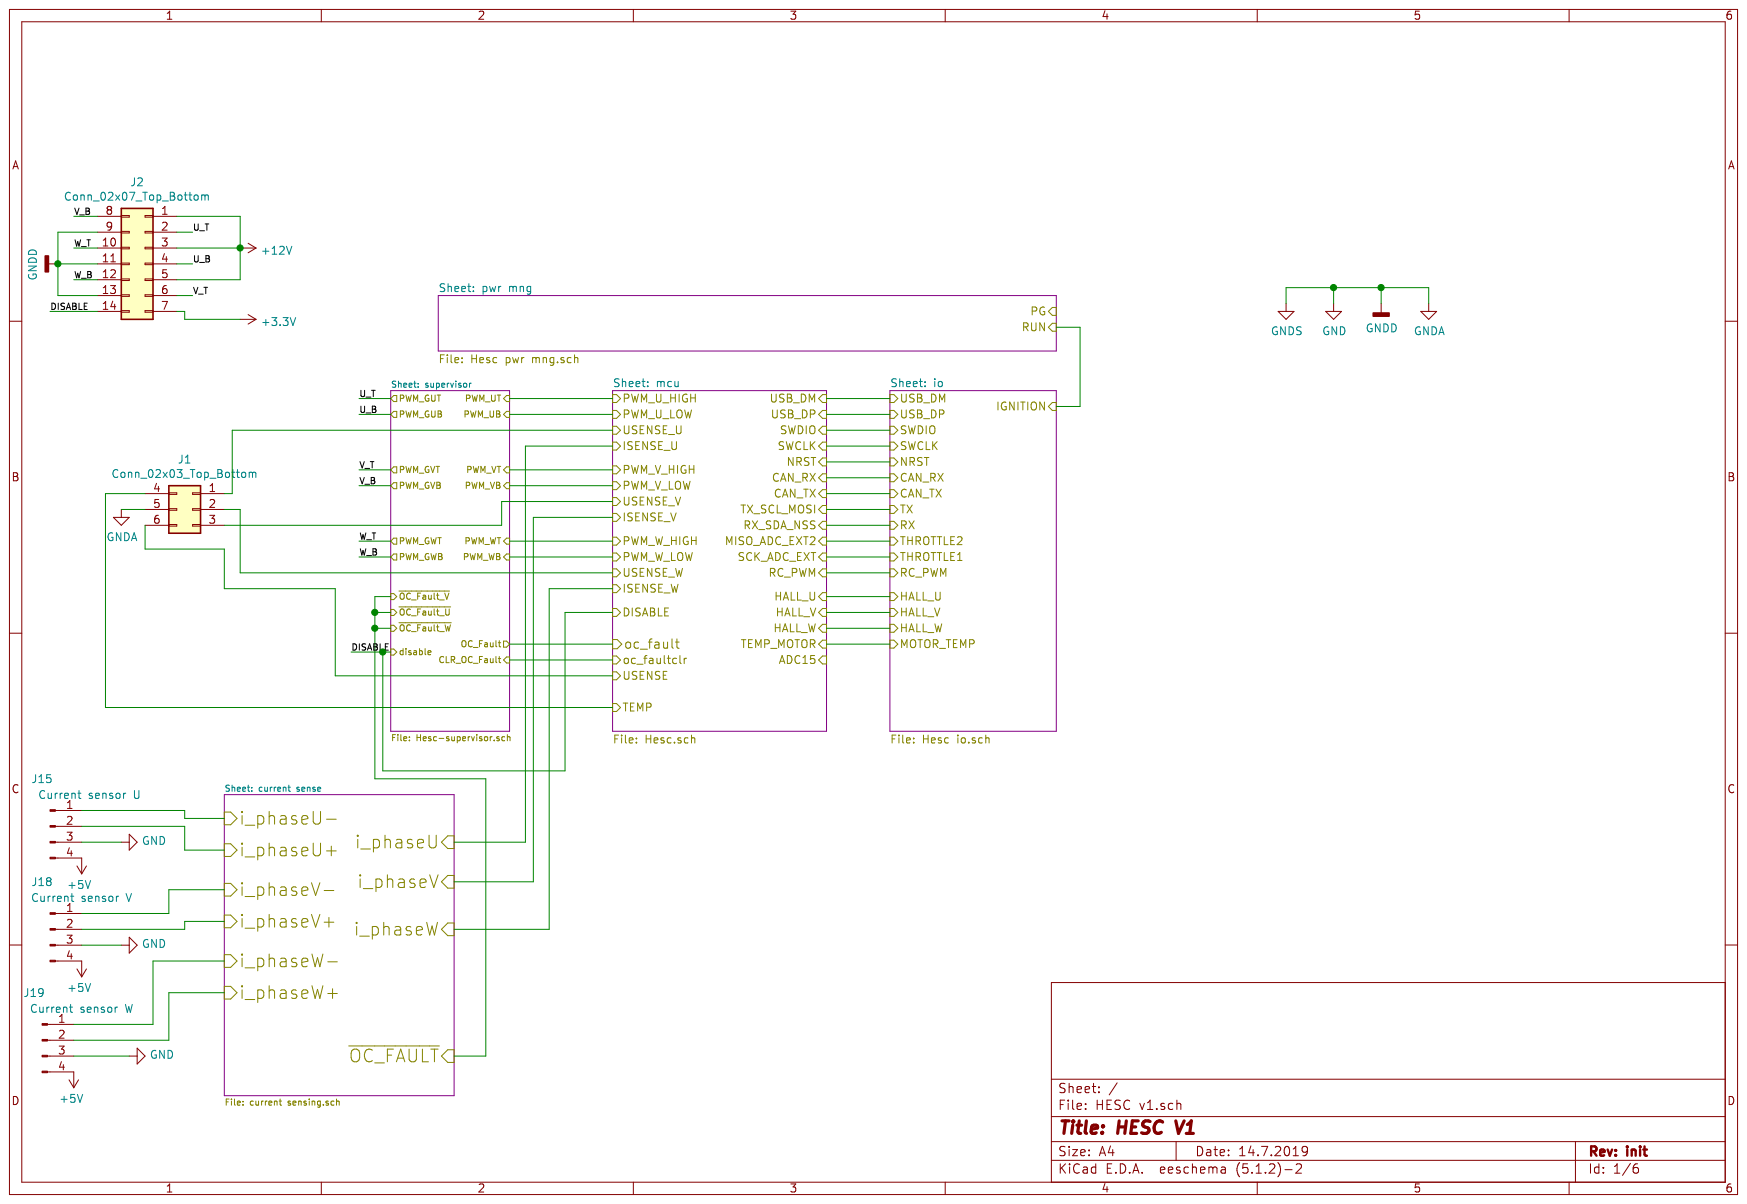
[picture p49: page 1]

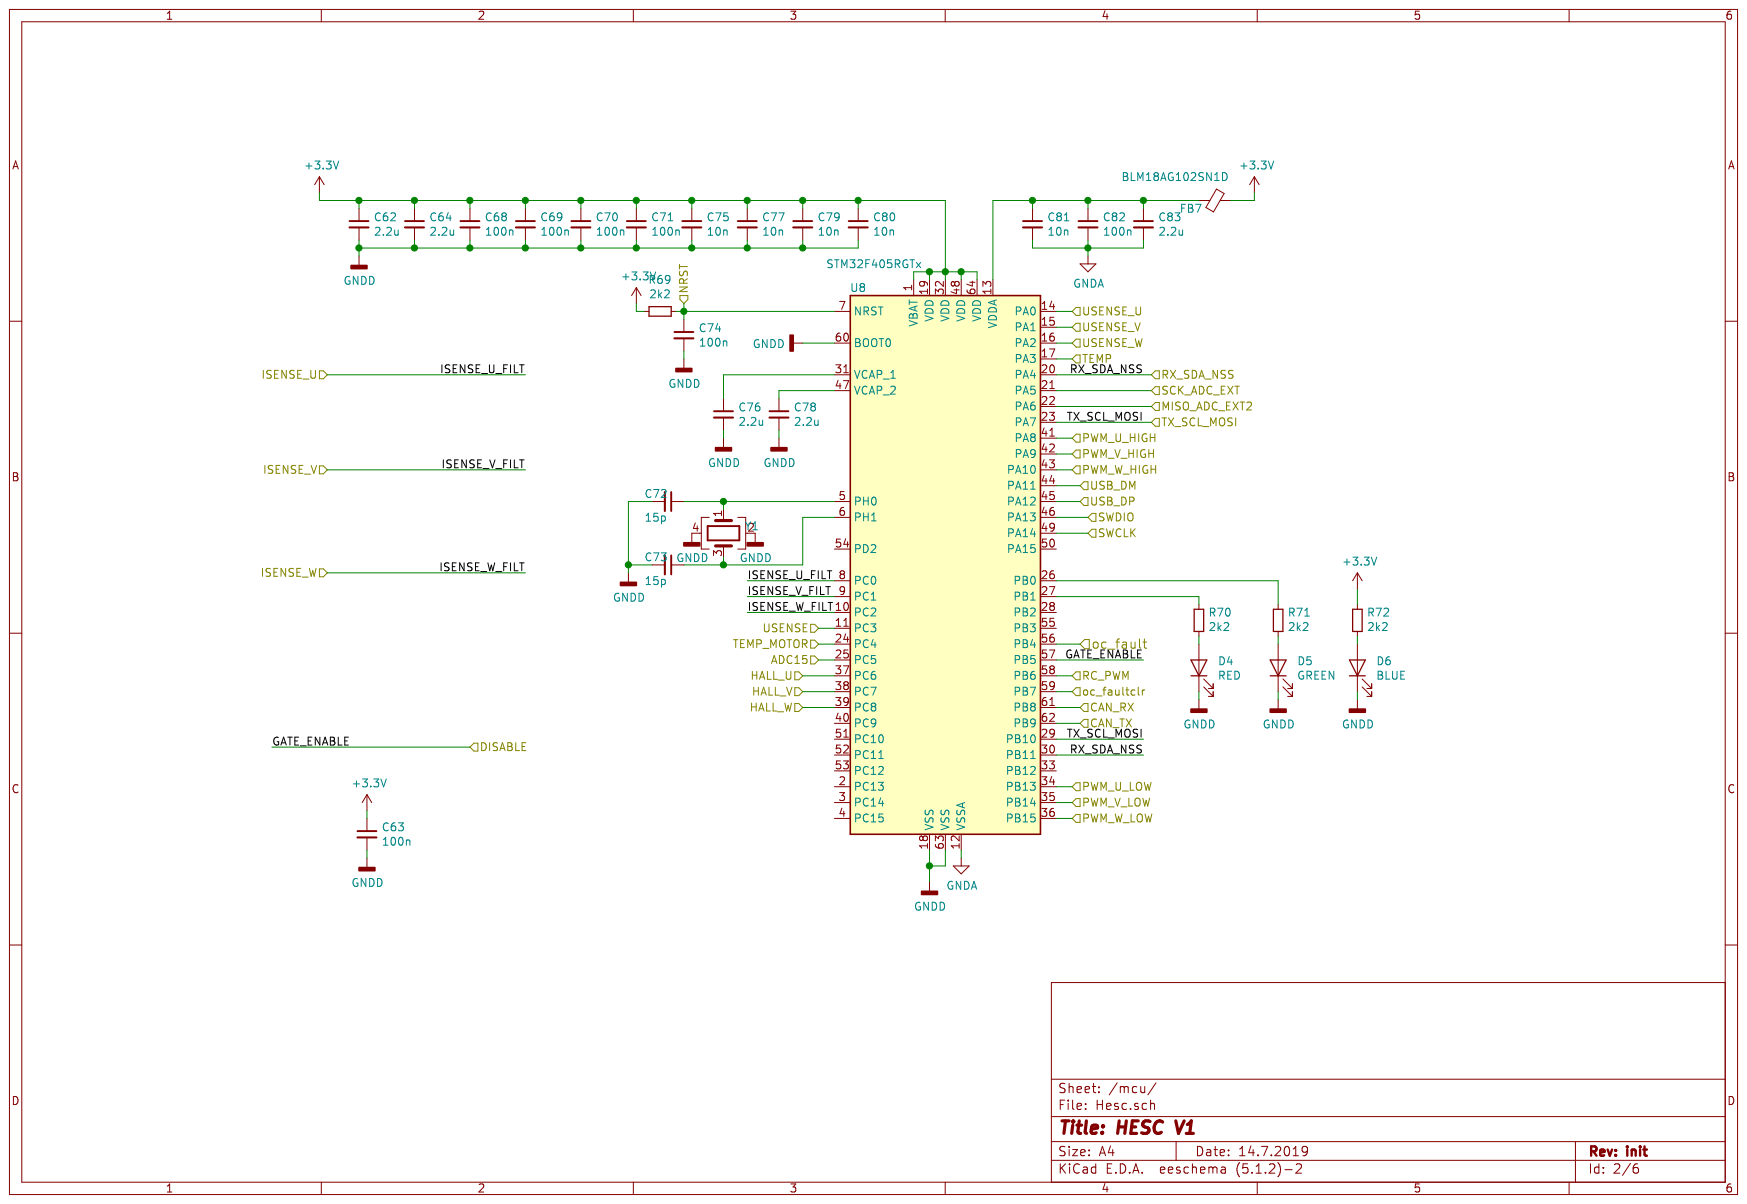
[picture p50: page 2]

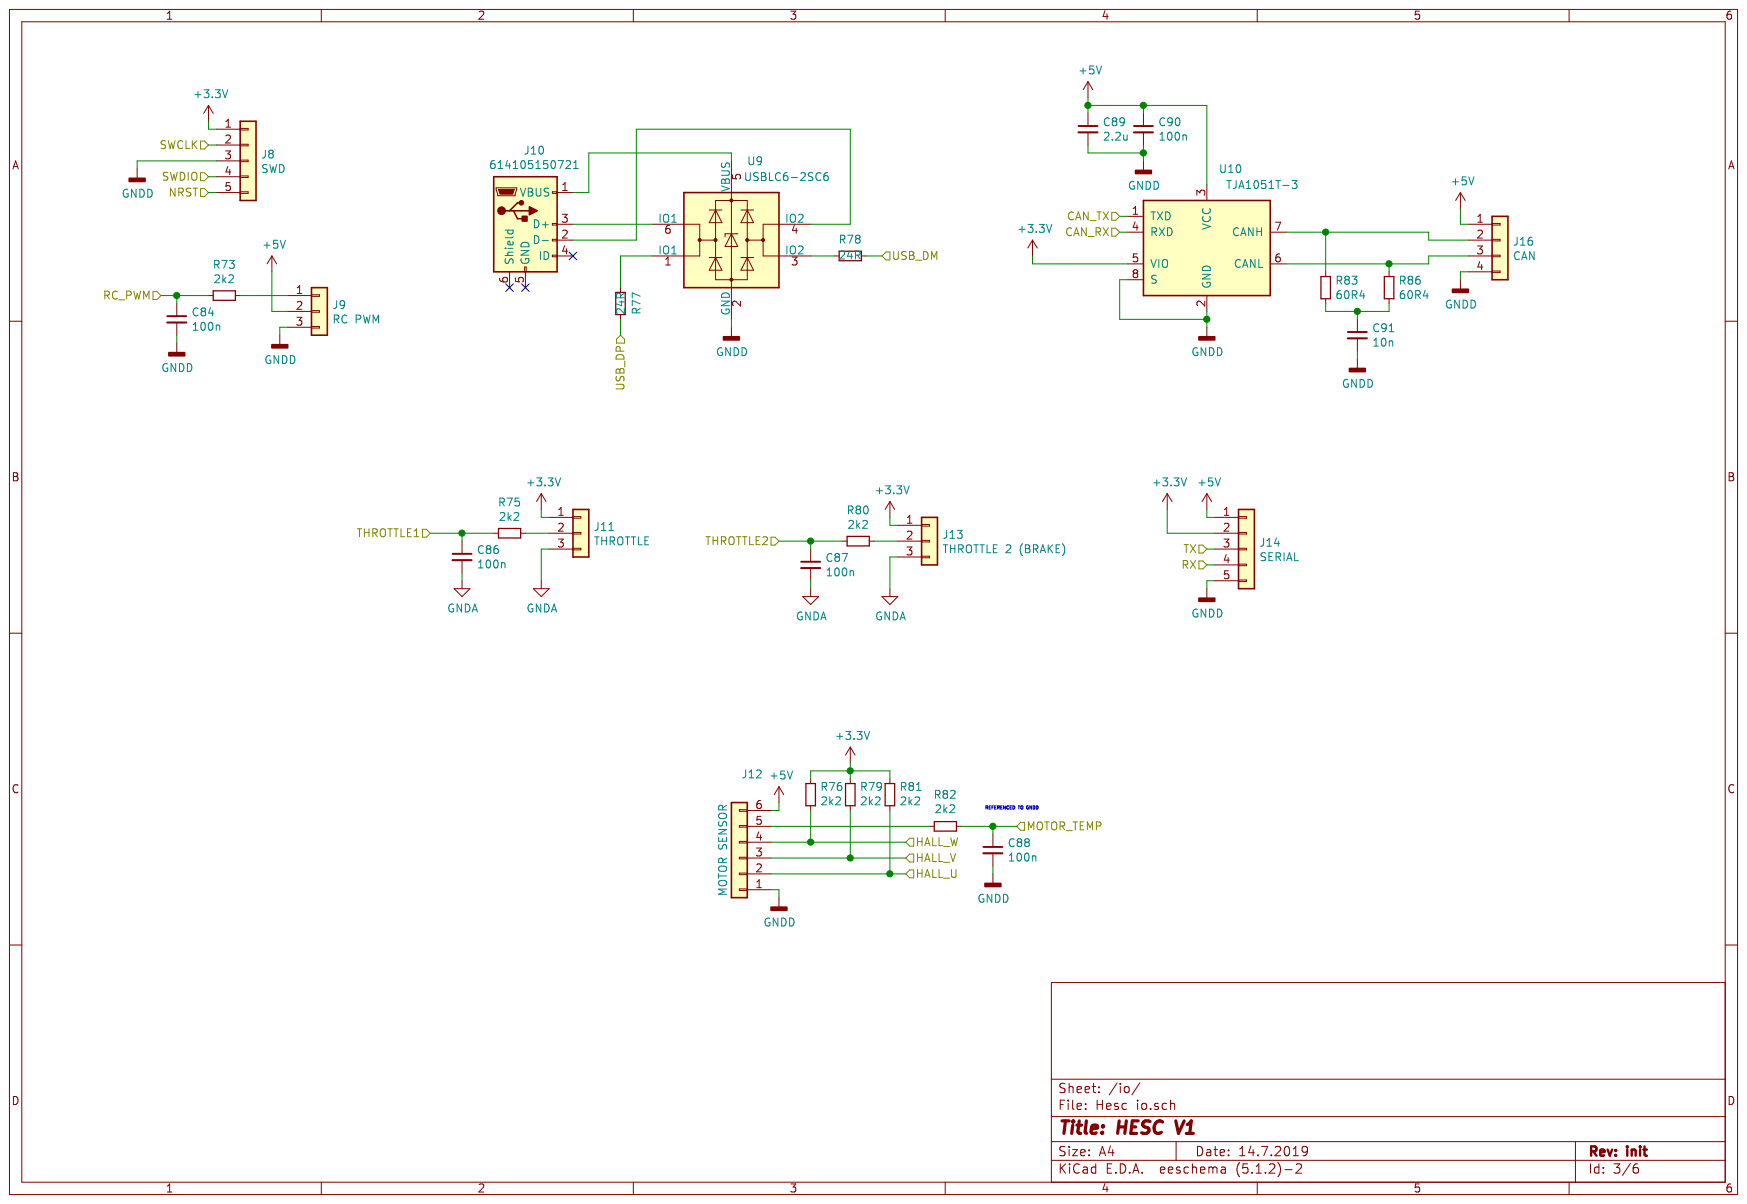
[picture p51: page 3]

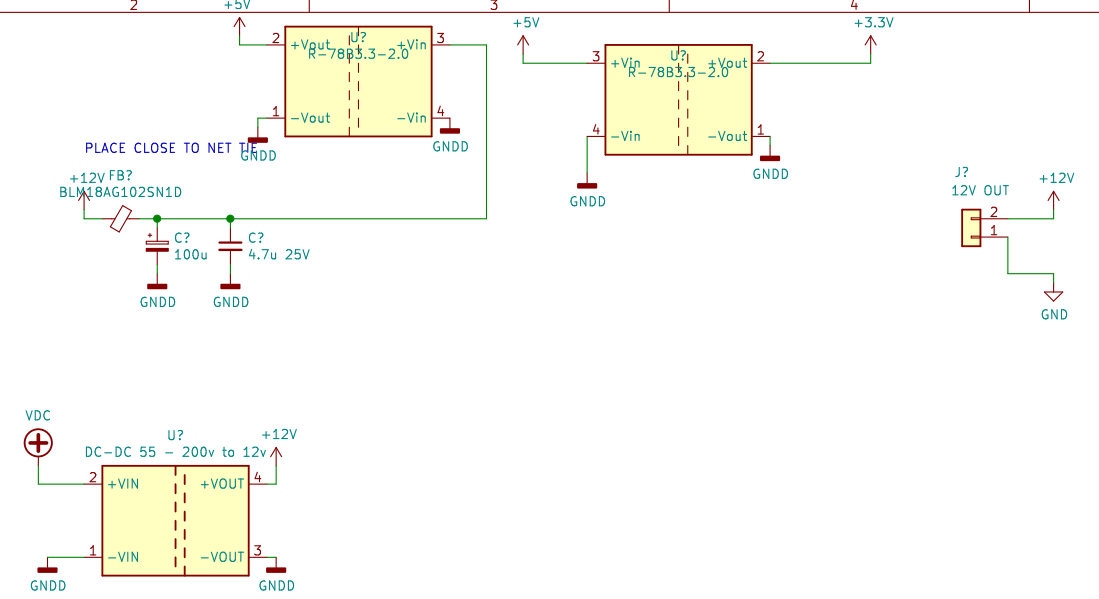
[picture p52: page 4]

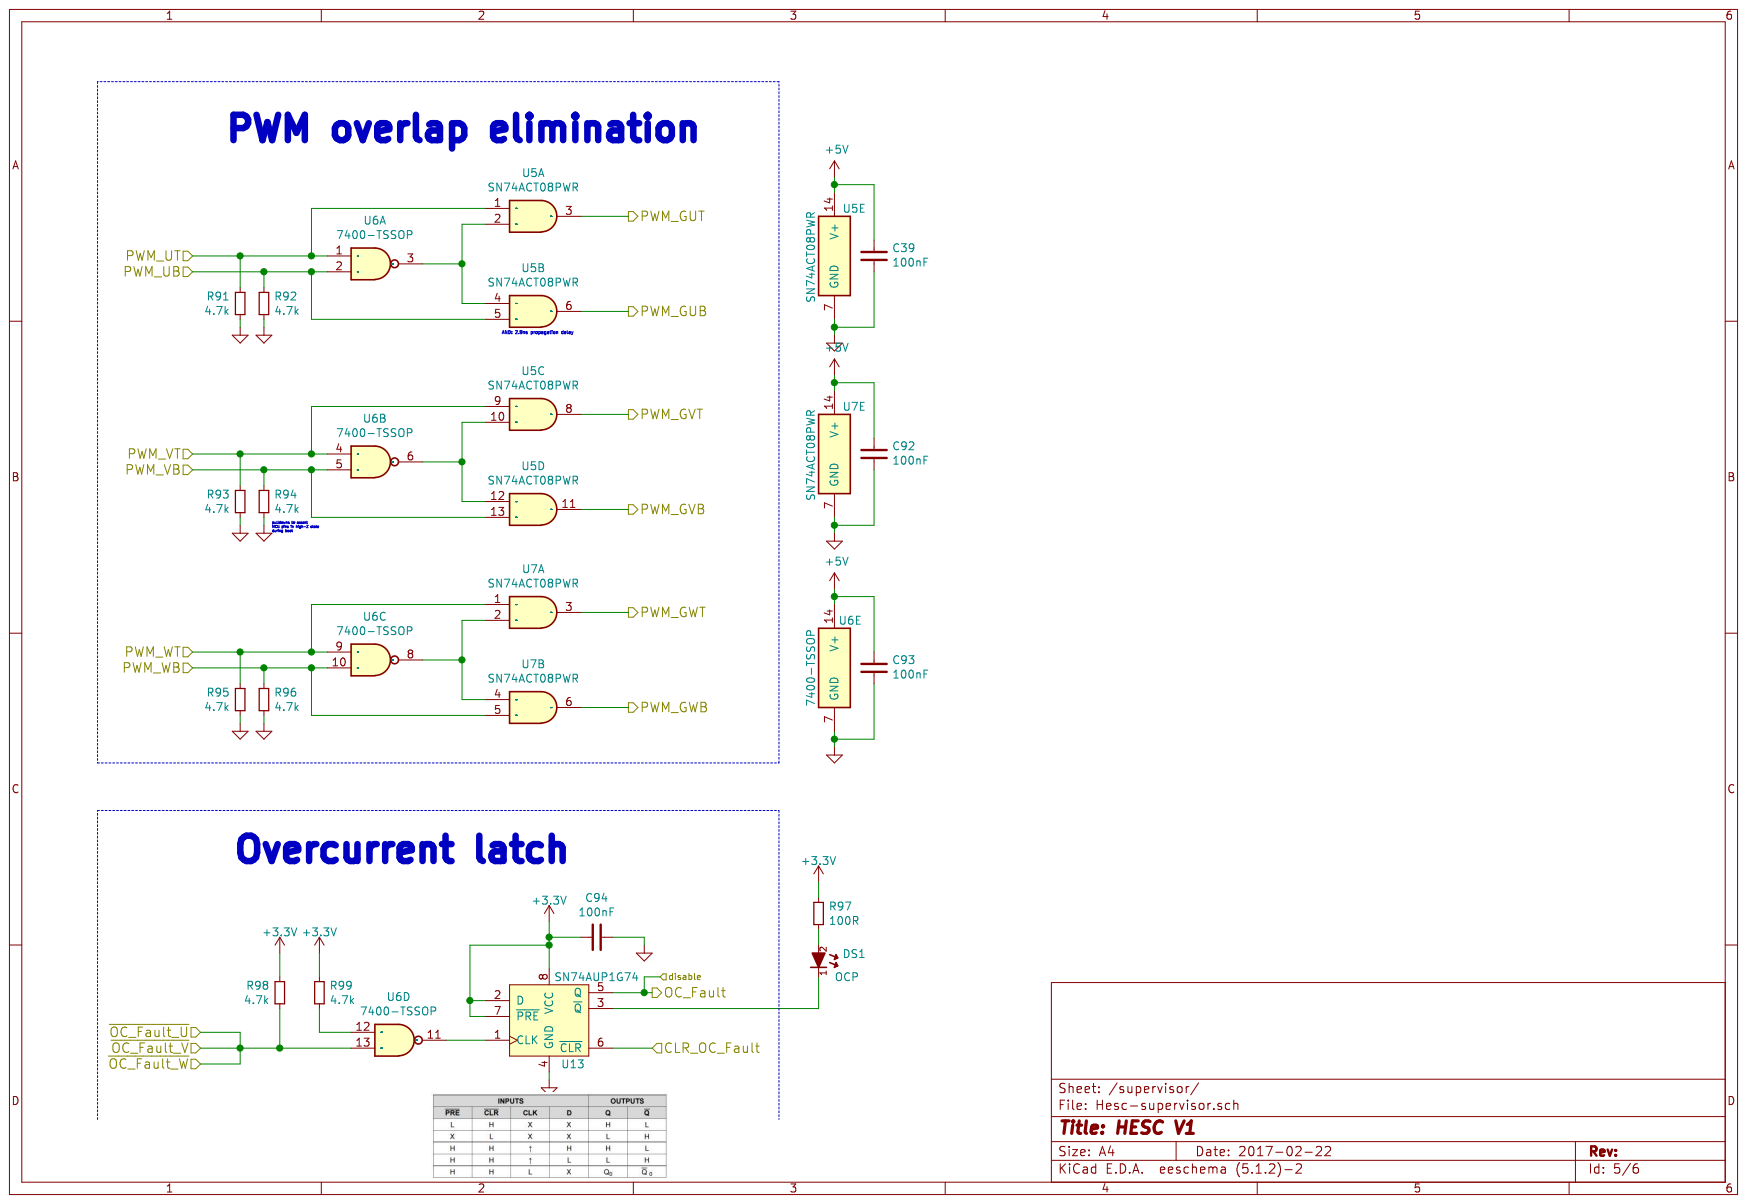
[picture p53: page 5]

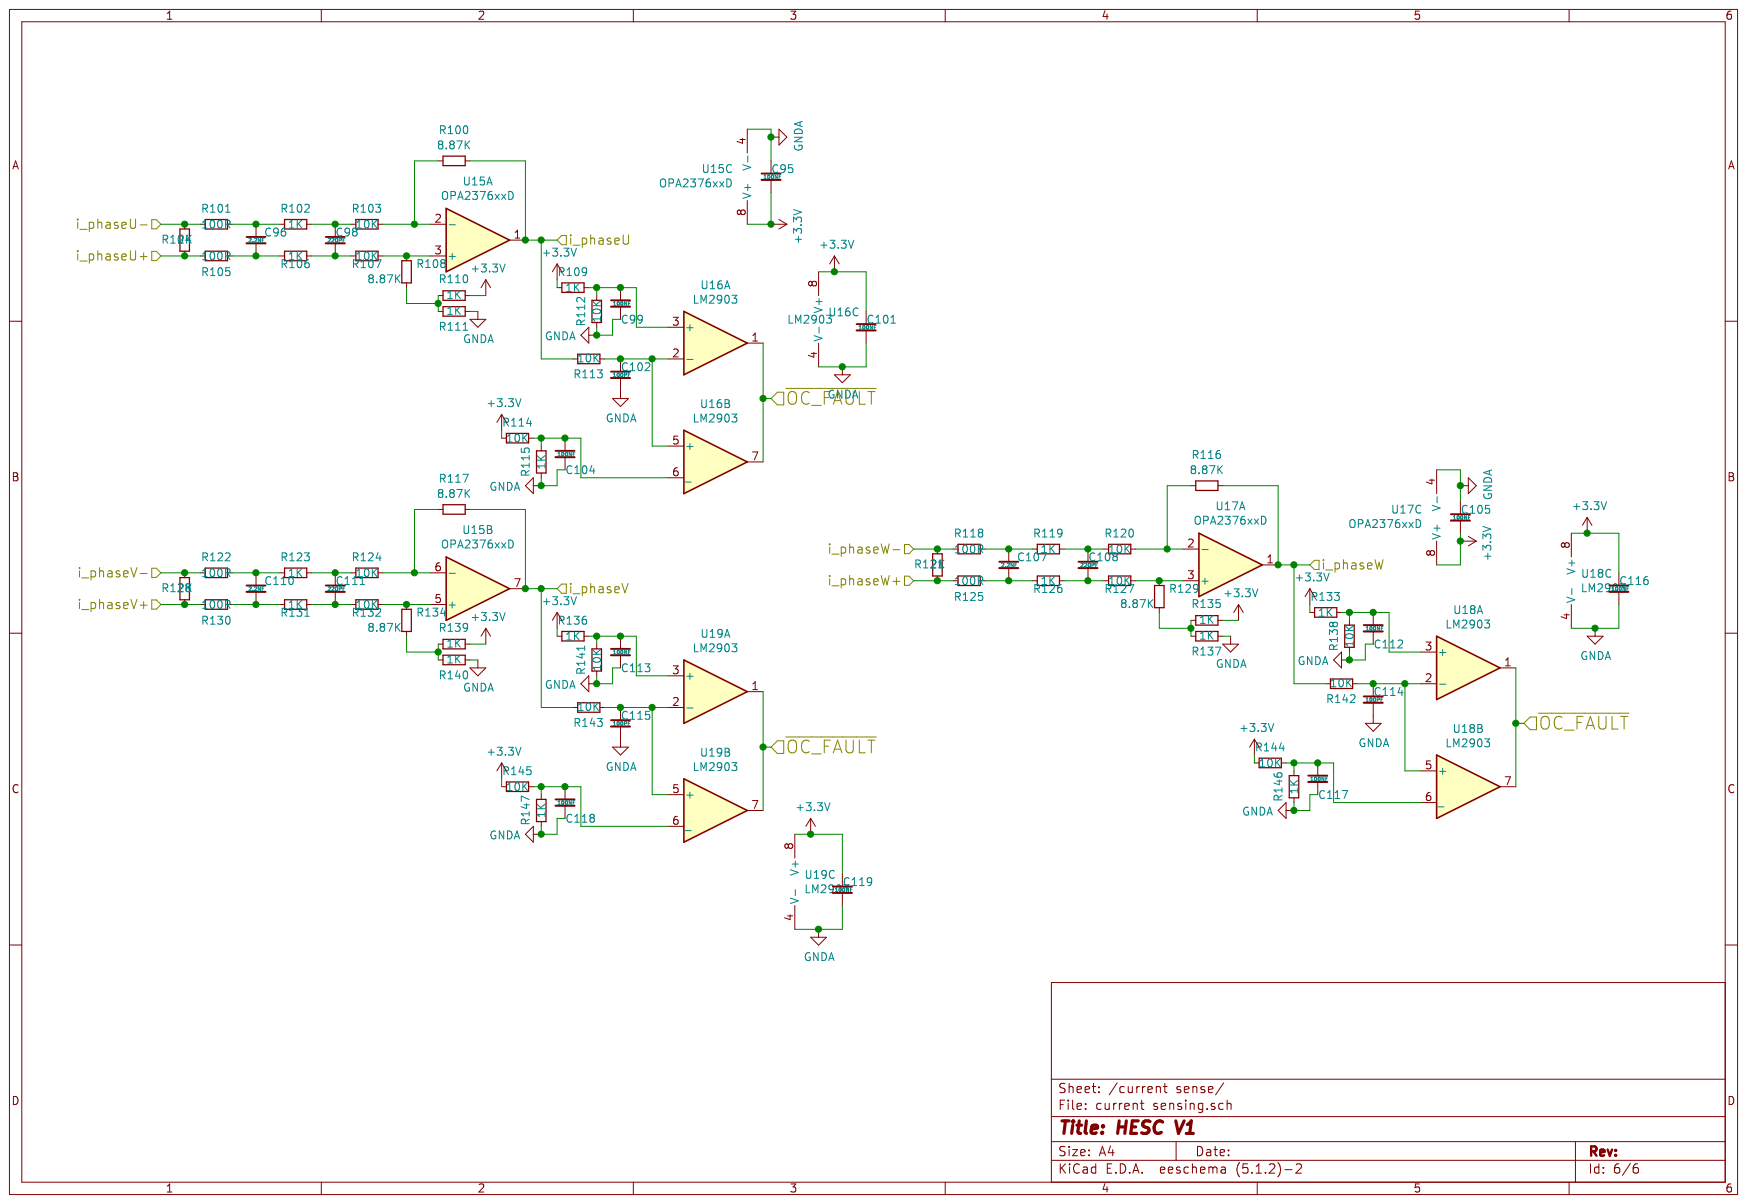
[picture p54: page 6]
