designmaster0928/VESC_MotorController/REFER/Basic/Forum/power stage.pdf

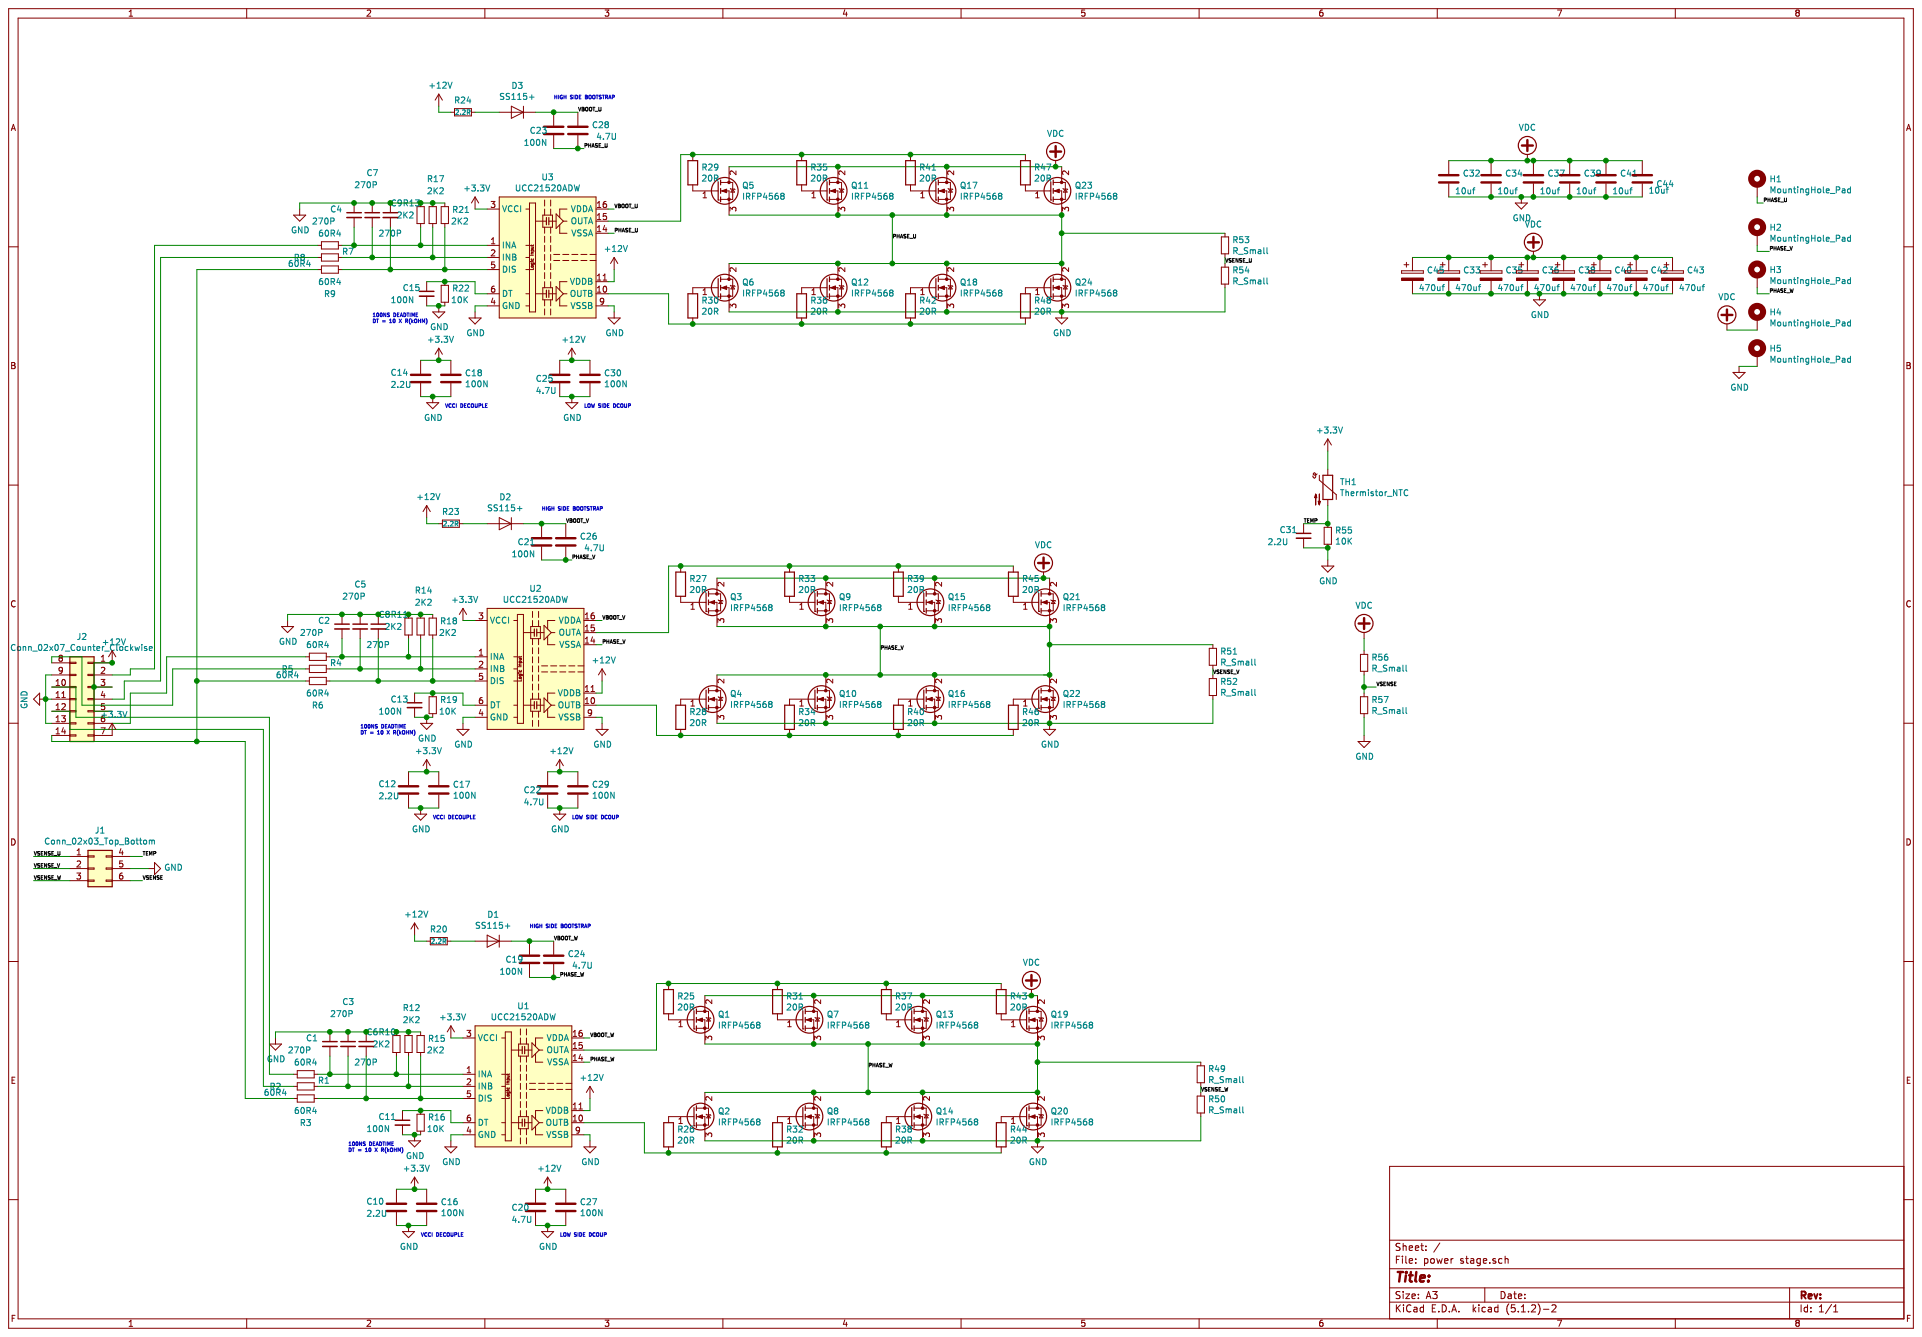
[picture p55: page 1]
