designmaster0928/VESC_MotorController/(list of files, drawings)

Other design files:
REFER/Other/EMDO601_Patch_20230703/DC-DC_Controller.SchDoc
REFER/Other/EMDO601_Patch_20230703/DC-DC_Converter.SchDoc
REFER/Other/EMDO601_Patch_20230703/EMDO601_Patch.PrjPcb
REFER/Other/EMDO601_Patch_20230703/Main.SchDoc
VESC_MotorController/Controller-Old.SchDoc
VESC_MotorController/Controller.SchDoc
VESC_MotorController/PowerBoard.SchDoc
VESC_MotorController/VESC_MotorController.PrjPcb
VESC_MotorController/VESC_MotorController.SCHLIB
