designmaster0928/VESC_MotorController/REFER/Basic/bldc-master/bldc-master/hwconf/board.h

/*
    ChibiOS - Copyright (C) 2006..2015 Giovanni Di Sirio

    Licensed under the Apache License, Version 2.0 (the "License");
    you may not use this file except in compliance with the License.
    You may obtain a copy of the License at

        http://www.apache.org/licenses/LICENSE-2.0

    Unless required by applicable law or agreed to in writing, software
    distributed under the License is distributed on an "AS IS" BASIS,
    WITHOUT WARRANTIES OR CONDITIONS OF ANY KIND, either express or implied.
    See the License for the specific language governing permissions and
    limitations under the License.
*/

#ifndef _BOARD_H_
#define _BOARD_H_

/*
 * Setup for STMicroelectronics STM32F4-Discovery board.
 */

/*
 * Board identifier.
 */
#define BOARD_ST_STM32F4_DISCOVERY
#define BOARD_NAME                  "STMicroelectronics STM32F4-Discovery"


/*
 * Board oscillators-related settings.
 * NOTE: LSE not fitted.
 */
#if !defined(STM32_LSECLK)
#define STM32_LSECLK                0U
#endif

// Definition moved to mcuconf.h with the other clock settings
/* 
#if !defined(STM32_HSECLK)
#define STM32_HSECLK                8000000U
#endif 
*/
 
/*
 * Board voltages.
 * Required for performance limits calculation.
 */
#define STM32_VDD                   300U

/*
 * MCU type as defined in the ST header.
 */
#define STM32F407xx

/*
 * IO pins assignments.
 */
#define GPIOA_PIN0                  0U
#define GPIOA_PIN1                  1U
#define GPIOA_PIN2                  2U
#define GPIOA_PIN3                  3U
#define GPIOA_LRCK                  4U
#define GPIOA_SPC                   5U
#define GPIOA_SDO                   6U
#define GPIOA_SDI                   7U
#define GPIOA_PIN8                  8U
#define GPIOA_VBUS_FS               9U
#define GPIOA_OTG_FS_ID             10U
#define GPIOA_OTG_FS_DM             11U
#define GPIOA_OTG_FS_DP             12U
#define GPIOA_SWDIO                 13U
#define GPIOA_SWCLK                 14U
#define GPIOA_PIN15                 15U

#define GPIOB_PIN0                  0U
#define GPIOB_PIN1                  1U
#define GPIOB_PIN2                  2U
#define GPIOB_SWO                   3U
#define GPIOB_PIN4                  4U
#define GPIOB_PIN5                  5U
#define GPIOB_SCL                   6U
#define GPIOB_PIN7                  7U
#define GPIOB_PIN8                  8U
#define GPIOB_SDA                   9U
#define GPIOB_CLK_IN                10U
#define GPIOB_PIN11                 11U
#define GPIOB_PIN12                 12U
#define GPIOB_PIN13                 13U
#define GPIOB_PIN14                 14U
#define GPIOB_PIN15                 15U

#define GPIOC_OTG_FS_POWER_ON       0U
#define GPIOC_PIN1                  1U
#define GPIOC_PIN2                  2U
#define GPIOC_PDM_OUT               3U
#define GPIOC_PIN4                  4U
#define GPIOC_PIN5                  5U
#define GPIOC_PIN6                  6U
#define GPIOC_MCLK                  7U
#define GPIOC_PIN8                  8U
#define GPIOC_PIN9                  9U
#define GPIOC_SCLK                  10U
#define GPIOC_PIN11                 11U
#define GPIOC_SDIN                  12U
#define GPIOC_PIN13                 13U
#define GPIOC_PIN14                 14U
#define GPIOC_PIN15                 15U

#define GPIOD_PIN0                  0U
#define GPIOD_PIN1                  1U
#define GPIOD_PIN2                  2U
#define GPIOD_PIN3                  3U
#define GPIOD_RESET                 4U
#define GPIOD_OVER_CURRENT          5U
#define GPIOD_PIN6                  6U
#define GPIOD_PIN7                  7U
#define GPIOD_PIN8                  8U
#define GPIOD_PIN9                  9U
#define GPIOD_PIN10                 10U
#define GPIOD_PIN11                 11U
#define GPIOD_PIN12                 12U
#define GPIOD_PIN13                 13U
#define GPIOD_PIN14                 14U
#define GPIOD_PIN15                 15U

#define GPIOE_INT1                  0U
#define GPIOE_INT2                  1U
#define GPIOE_PIN2                  2U
#define GPIOE_CS_SPI                3U
#define GPIOE_PIN4                  4U
#define GPIOE_PIN5                  5U
#define GPIOE_PIN6                  6U
#define GPIOE_PIN7                  7U
#define GPIOE_PIN8                  8U
#define GPIOE_PIN9                  9U
#define GPIOE_PIN10                 10U
#define GPIOE_PIN11                 11U
#define GPIOE_PIN12                 12U
#define GPIOE_PIN13                 13U
#define GPIOE_PIN14                 14U
#define GPIOE_PIN15                 15U

#define GPIOF_PIN0                  0U
#define GPIOF_PIN1                  1U
#define GPIOF_PIN2                  2U
#define GPIOF_PIN3                  3U
#define GPIOF_PIN4                  4U
#define GPIOF_PIN5                  5U
#define GPIOF_PIN6                  6U
#define GPIOF_PIN7                  7U
#define GPIOF_PIN8                  8U
#define GPIOF_PIN9                  9U
#define GPIOF_PIN10                 10U
#define GPIOF_PIN11                 11U
#define GPIOF_PIN12                 12U
#define GPIOF_PIN13                 13U
#define GPIOF_PIN14                 14U
#define GPIOF_PIN15                 15U

#define GPIOG_PIN0                  0U
#define GPIOG_PIN1                  1U
#define GPIOG_PIN2                  2U
#define GPIOG_PIN3                  3U
#define GPIOG_PIN4                  4U
#define GPIOG_PIN5                  5U
#define GPIOG_PIN6                  6U
#define GPIOG_PIN7                  7U
#define GPIOG_PIN8                  8U
#define GPIOG_PIN9                  9U
#define GPIOG_PIN10                 10U
#define GPIOG_PIN11                 11U
#define GPIOG_PIN12                 12U
#define GPIOG_PIN13                 13U
#define GPIOG_PIN14                 14U
#define GPIOG_PIN15                 15U

#define GPIOH_OSC_IN                0U
#define GPIOH_OSC_OUT               1U
#define GPIOH_PIN2                  2U
#define GPIOH_PIN3                  3U
#define GPIOH_PIN4                  4U
#define GPIOH_PIN5                  5U
#define GPIOH_PIN6                  6U
#define GPIOH_PIN7                  7U
#define GPIOH_PIN8                  8U
#define GPIOH_PIN9                  9U
#define GPIOH_PIN10                 10U
#define GPIOH_PIN11                 11U
#define GPIOH_PIN12                 12U
#define GPIOH_PIN13                 13U
#define GPIOH_PIN14                 14U
#define GPIOH_PIN15                 15U

#define GPIOI_PIN0                  0U
#define GPIOI_PIN1                  1U
#define GPIOI_PIN2                  2U
#define GPIOI_PIN3                  3U
#define GPIOI_PIN4                  4U
#define GPIOI_PIN5                  5U
#define GPIOI_PIN6                  6U
#define GPIOI_PIN7                  7U
#define GPIOI_PIN8                  8U
#define GPIOI_PIN9                  9U
#define GPIOI_PIN10                 10U
#define GPIOI_PIN11                 11U
#define GPIOI_PIN12                 12U
#define GPIOI_PIN13                 13U
#define GPIOI_PIN14                 14U
#define GPIOI_PIN15                 15U

/*
 * I/O ports initial setup, this configuration is established soon after reset
 * in the initialization code.
 * Please refer to the STM32 Reference Manual for details.
 */
#define PIN_MODE_INPUT(n)           (0U << ((n) * 2U))
#define PIN_MODE_OUTPUT(n)          (1U << ((n) * 2U))
#define PIN_MODE_ALTERNATE(n)       (2U << ((n) * 2U))
#define PIN_MODE_ANALOG(n)          (3U << ((n) * 2U))
#define PIN_ODR_LOW(n)              (0U << (n))
#define PIN_ODR_HIGH(n)             (1U << (n))
#define PIN_OTYPE_PUSHPULL(n)       (0U << (n))
#define PIN_OTYPE_OPENDRAIN(n)      (1U << (n))
#define PIN_OSPEED_2M(n)            (0U << ((n) * 2U))
#define PIN_OSPEED_25M(n)           (1U << ((n) * 2U))
#define PIN_OSPEED_50M(n)           (2U << ((n) * 2U))
#define PIN_OSPEED_100M(n)          (3U << ((n) * 2U))
#define PIN_PUPDR_FLOATING(n)       (0U << ((n) * 2U))
#define PIN_PUPDR_PULLUP(n)         (1U << ((n) * 2U))
#define PIN_PUPDR_PULLDOWN(n)       (2U << ((n) * 2U))
#define PIN_AFIO_AF(n, v)           ((v) << (((n) % 8U) * 4U))

/*
 * GPIOA setup:
 */
#define VAL_GPIOA_MODER             (PIN_MODE_INPUT(GPIOA_PIN0) |         \
                                     PIN_MODE_INPUT(GPIOA_PIN1) |           \
                                     PIN_MODE_INPUT(GPIOA_PIN2) |           \
                                     PIN_MODE_INPUT(GPIOA_PIN3) |           \
                                     PIN_MODE_INPUT(GPIOA_LRCK) |       \
                                     PIN_MODE_INPUT(GPIOA_SPC) |        \
                                     PIN_MODE_INPUT(GPIOA_SDO) |        \
                                     PIN_MODE_INPUT(GPIOA_SDI) |        \
                                     PIN_MODE_INPUT(GPIOA_PIN8) |           \
                                     PIN_MODE_INPUT(GPIOA_VBUS_FS) |        \
                                     PIN_MODE_INPUT(GPIOA_OTG_FS_ID) |  \
                                     PIN_MODE_INPUT(GPIOA_OTG_FS_DM) |  \
                                     PIN_MODE_INPUT(GPIOA_OTG_FS_DP) |  \
                                     PIN_MODE_ALTERNATE(GPIOA_SWDIO) |      \
                                     PIN_MODE_ALTERNATE(GPIOA_SWCLK) |      \
                                     PIN_MODE_INPUT(GPIOA_PIN15))
#define VAL_GPIOA_OTYPER            (PIN_OTYPE_PUSHPULL(GPIOA_PIN0) |     \
                                     PIN_OTYPE_PUSHPULL(GPIOA_PIN1) |       \
                                     PIN_OTYPE_PUSHPULL(GPIOA_PIN2) |       \
                                     PIN_OTYPE_PUSHPULL(GPIOA_PIN3) |       \
                                     PIN_OTYPE_PUSHPULL(GPIOA_LRCK) |       \
                                     PIN_OTYPE_PUSHPULL(GPIOA_SPC) |        \
                                     PIN_OTYPE_PUSHPULL(GPIOA_SDO) |        \
                                     PIN_OTYPE_PUSHPULL(GPIOA_SDI) |        \
                                     PIN_OTYPE_PUSHPULL(GPIOA_PIN8) |       \
                                     PIN_OTYPE_PUSHPULL(GPIOA_VBUS_FS) |    \
                                     PIN_OTYPE_PUSHPULL(GPIOA_OTG_FS_ID) |  \
                                     PIN_OTYPE_PUSHPULL(GPIOA_OTG_FS_DM) |  \
                                     PIN_OTYPE_PUSHPULL(GPIOA_OTG_FS_DP) |  \
                                     PIN_OTYPE_PUSHPULL(GPIOA_SWDIO) |      \
                                     PIN_OTYPE_PUSHPULL(GPIOA_SWCLK) |      \
                                     PIN_OTYPE_PUSHPULL(GPIOA_PIN15))
#define VAL_GPIOA_OSPEEDR           (PIN_OSPEED_100M(GPIOA_PIN0) |        \
                                     PIN_OSPEED_100M(GPIOA_PIN1) |          \
                                     PIN_OSPEED_100M(GPIOA_PIN2) |          \
                                     PIN_OSPEED_100M(GPIOA_PIN3) |          \
                                     PIN_OSPEED_100M(GPIOA_LRCK) |          \
                                     PIN_OSPEED_100M(GPIOA_SPC) |            \
                                     PIN_OSPEED_100M(GPIOA_SDO) |            \
                                     PIN_OSPEED_100M(GPIOA_SDI) |            \
                                     PIN_OSPEED_100M(GPIOA_PIN8) |          \
                                     PIN_OSPEED_100M(GPIOA_VBUS_FS) |       \
                                     PIN_OSPEED_100M(GPIOA_OTG_FS_ID) |     \
                                     PIN_OSPEED_100M(GPIOA_OTG_FS_DM) |     \
                                     PIN_OSPEED_100M(GPIOA_OTG_FS_DP) |     \
                                     PIN_OSPEED_100M(GPIOA_SWDIO) |         \
                                     PIN_OSPEED_100M(GPIOA_SWCLK) |         \
                                     PIN_OSPEED_100M(GPIOA_PIN15))
#define VAL_GPIOA_PUPDR             (PIN_PUPDR_FLOATING(GPIOA_PIN0) |     \
                                     PIN_PUPDR_FLOATING(GPIOA_PIN1) |         \
                                     PIN_PUPDR_FLOATING(GPIOA_PIN2) |         \
                                     PIN_PUPDR_FLOATING(GPIOA_PIN3) |         \
                                     PIN_PUPDR_FLOATING(GPIOA_LRCK) |       \
                                     PIN_PUPDR_FLOATING(GPIOA_SPC) |        \
                                     PIN_PUPDR_FLOATING(GPIOA_SDO) |        \
                                     PIN_PUPDR_FLOATING(GPIOA_SDI) |        \
                                     PIN_PUPDR_FLOATING(GPIOA_PIN8) |         \
                                     PIN_PUPDR_FLOATING(GPIOA_VBUS_FS) |    \
                                     PIN_PUPDR_FLOATING(GPIOA_OTG_FS_ID) |  \
                                     PIN_PUPDR_FLOATING(GPIOA_OTG_FS_DM) |  \
                                     PIN_PUPDR_FLOATING(GPIOA_OTG_FS_DP) |  \
                                     PIN_PUPDR_FLOATING(GPIOA_SWDIO) |      \
                                     PIN_PUPDR_FLOATING(GPIOA_SWCLK) |      \
                                     PIN_PUPDR_FLOATING(GPIOA_PIN15))
#define VAL_GPIOA_ODR               (PIN_ODR_HIGH(GPIOA_PIN0) |           \
                                     PIN_ODR_HIGH(GPIOA_PIN1) |             \
                                     PIN_ODR_HIGH(GPIOA_PIN2) |             \
                                     PIN_ODR_HIGH(GPIOA_PIN3) |             \
                                     PIN_ODR_HIGH(GPIOA_LRCK) |             \
                                     PIN_ODR_HIGH(GPIOA_SPC) |              \
                                     PIN_ODR_HIGH(GPIOA_SDO) |              \
                                     PIN_ODR_HIGH(GPIOA_SDI) |              \
                                     PIN_ODR_HIGH(GPIOA_PIN8) |             \
                                     PIN_ODR_HIGH(GPIOA_VBUS_FS) |          \
                                     PIN_ODR_HIGH(GPIOA_OTG_FS_ID) |        \
                                     PIN_ODR_HIGH(GPIOA_OTG_FS_DM) |        \
                                     PIN_ODR_HIGH(GPIOA_OTG_FS_DP) |        \
                                     PIN_ODR_HIGH(GPIOA_SWDIO) |            \
                                     PIN_ODR_HIGH(GPIOA_SWCLK) |            \
                                     PIN_ODR_HIGH(GPIOA_PIN15))
#define VAL_GPIOA_AFRL              (PIN_AFIO_AF(GPIOA_PIN0, 0) |         \
                                     PIN_AFIO_AF(GPIOA_PIN1, 0) |           \
                                     PIN_AFIO_AF(GPIOA_PIN2, 0) |           \
                                     PIN_AFIO_AF(GPIOA_PIN3, 0) |           \
                                     PIN_AFIO_AF(GPIOA_LRCK, 6) |           \
                                     PIN_AFIO_AF(GPIOA_SPC, 5) |            \
                                     PIN_AFIO_AF(GPIOA_SDO, 5) |            \
                                     PIN_AFIO_AF(GPIOA_SDI, 5))
#define VAL_GPIOA_AFRH              (PIN_AFIO_AF(GPIOA_PIN8, 0) |           \
                                     PIN_AFIO_AF(GPIOA_VBUS_FS, 0) |        \
                                     PIN_AFIO_AF(GPIOA_OTG_FS_ID, 10) |     \
                                     PIN_AFIO_AF(GPIOA_OTG_FS_DM, 10) |     \
                                     PIN_AFIO_AF(GPIOA_OTG_FS_DP, 10) |     \
                                     PIN_AFIO_AF(GPIOA_SWDIO, 0) |          \
                                     PIN_AFIO_AF(GPIOA_SWCLK, 0) |          \
                                     PIN_AFIO_AF(GPIOA_PIN15, 0))

/*
 * GPIOB setup:
 *
 * PB0  - PIN0                      (input pullup).
 * PB1  - PIN1                      (input pullup).
 * PB2  - PIN2                      (input pullup).
 * PB3  - SWO                       (alternate 0).
 * PB4  - PIN4                      (input pullup).
 * PB5  - PIN5                      (input pullup).
 * PB6  - SCL                       (alternate 4).
 * PB7  - PIN7                      (input pullup).
 * PB8  - PIN8                      (input pullup).
 * PB9  - SDA                       (alternate 4).
 * PB10 - CLK_IN                    (input pullup).
 * PB11 - PIN11                     (input pullup).
 * PB12 - PIN12                     (input pullup).
 * PB13 - PIN13                     (input pullup).
 * PB14 - PIN14                     (input pullup).
 * PB15 - PIN15                     (input pullup).
 */
#define VAL_GPIOB_MODER             (PIN_MODE_INPUT(GPIOB_PIN0) |           \
                                     PIN_MODE_INPUT(GPIOB_PIN1) |           \
                                     PIN_MODE_INPUT(GPIOB_PIN2) |           \
                                     PIN_MODE_INPUT(GPIOB_SWO) |        \
                                     PIN_MODE_INPUT(GPIOB_PIN4) |           \
                                     PIN_MODE_INPUT(GPIOB_PIN5) |           \
                                     PIN_MODE_INPUT(GPIOB_SCL) |        \
                                     PIN_MODE_INPUT(GPIOB_PIN7) |           \
                                     PIN_MODE_INPUT(GPIOB_PIN8) |           \
                                     PIN_MODE_INPUT(GPIOB_SDA) |        \
                                     PIN_MODE_INPUT(GPIOB_CLK_IN) |         \
                                     PIN_MODE_INPUT(GPIOB_PIN11) |          \
                                     PIN_MODE_INPUT(GPIOB_PIN12) |          \
                                     PIN_MODE_INPUT(GPIOB_PIN13) |          \
                                     PIN_MODE_INPUT(GPIOB_PIN14) |          \
                                     PIN_MODE_INPUT(GPIOB_PIN15))
#define VAL_GPIOB_OTYPER            (PIN_OTYPE_PUSHPULL(GPIOB_PIN0) |       \
                                     PIN_OTYPE_PUSHPULL(GPIOB_PIN1) |       \
                                     PIN_OTYPE_PUSHPULL(GPIOB_PIN2) |       \
                                     PIN_OTYPE_PUSHPULL(GPIOB_SWO) |        \
                                     PIN_OTYPE_PUSHPULL(GPIOB_PIN4) |       \
                                     PIN_OTYPE_PUSHPULL(GPIOB_PIN5) |       \
                                     PIN_OTYPE_OPENDRAIN(GPIOB_SCL) |       \
                                     PIN_OTYPE_PUSHPULL(GPIOB_PIN7) |       \
                                     PIN_OTYPE_PUSHPULL(GPIOB_PIN8) |       \
                                     PIN_OTYPE_OPENDRAIN(GPIOB_SDA) |       \
                                     PIN_OTYPE_PUSHPULL(GPIOB_CLK_IN) |     \
                                     PIN_OTYPE_PUSHPULL(GPIOB_PIN11) |      \
                                     PIN_OTYPE_PUSHPULL(GPIOB_PIN12) |      \
                                     PIN_OTYPE_PUSHPULL(GPIOB_PIN13) |      \
                                     PIN_OTYPE_PUSHPULL(GPIOB_PIN14) |      \
                                     PIN_OTYPE_PUSHPULL(GPIOB_PIN15))
#define VAL_GPIOB_OSPEEDR           (PIN_OSPEED_100M(GPIOB_PIN0) |          \
                                     PIN_OSPEED_100M(GPIOB_PIN1) |          \
                                     PIN_OSPEED_100M(GPIOB_PIN2) |          \
                                     PIN_OSPEED_100M(GPIOB_SWO) |           \
                                     PIN_OSPEED_100M(GPIOB_PIN4) |          \
                                     PIN_OSPEED_100M(GPIOB_PIN5) |          \
                                     PIN_OSPEED_100M(GPIOB_SCL) |           \
                                     PIN_OSPEED_100M(GPIOB_PIN7) |          \
                                     PIN_OSPEED_100M(GPIOB_PIN8) |          \
                                     PIN_OSPEED_100M(GPIOB_SDA) |           \
                                     PIN_OSPEED_100M(GPIOB_CLK_IN) |        \
                                     PIN_OSPEED_100M(GPIOB_PIN11) |         \
                                     PIN_OSPEED_100M(GPIOB_PIN12) |         \
                                     PIN_OSPEED_100M(GPIOB_PIN13) |         \
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
                                     PIN_ODR_HIGH(GPIOC_PIN9) |             \
                                     PIN_ODR_HIGH(GPIOC_SCLK) |             \
                                     PIN_ODR_HIGH(GPIOC_PIN11) |            \
                                     PIN_ODR_HIGH(GPIOC_SDIN) |             \
                                     PIN_ODR_HIGH(GPIOC_PIN13) |            \
                                     PIN_ODR_HIGH(GPIOC_PIN14) |            \
                                     PIN_ODR_HIGH(GPIOC_PIN15))
#define VAL_GPIOC_AFRL              (PIN_AFIO_AF(GPIOC_OTG_FS_POWER_ON, 0) |\
                                     PIN_AFIO_AF(GPIOC_PIN1, 0) |           \
                                     PIN_AFIO_AF(GPIOC_PIN2, 0) |           \
                                     PIN_AFIO_AF(GPIOC_PDM_OUT, 0) |        \
                                     PIN_AFIO_AF(GPIOC_PIN4, 0) |           \
                                     PIN_AFIO_AF(GPIOC_PIN5, 0) |           \
                                     PIN_AFIO_AF(GPIOC_PIN6, 0) |           \
                                     PIN_AFIO_AF(GPIOC_MCLK, 6))
#define VAL_GPIOC_AFRH              (PIN_AFIO_AF(GPIOC_PIN8, 0) |           \
                                     PIN_AFIO_AF(GPIOC_PIN9, 0) |           \
                                     PIN_AFIO_AF(GPIOC_SCLK, 6) |           \
                                     PIN_AFIO_AF(GPIOC_PIN11, 0) |          \
                                     PIN_AFIO_AF(GPIOC_SDIN, 6) |           \
                                     PIN_AFIO_AF(GPIOC_PIN13, 0) |          \
                                     PIN_AFIO_AF(GPIOC_PIN14, 0) |          \
                                     PIN_AFIO_AF(GPIOC_PIN15, 0))

/*
 * GPIOD setup:
 */
#define VAL_GPIOD_MODER             (PIN_MODE_INPUT(GPIOD_PIN0) |           \
                                     PIN_MODE_INPUT(GPIOD_PIN1) |           \
                                     PIN_MODE_INPUT(GPIOD_PIN2) |           \
                                     PIN_MODE_INPUT(GPIOD_PIN3) |           \
                                     PIN_MODE_INPUT(GPIOD_RESET) |         \
                                     PIN_MODE_INPUT(GPIOD_OVER_CURRENT) |   \
                                     PIN_MODE_INPUT(GPIOD_PIN6) |           \
                                     PIN_MODE_INPUT(GPIOD_PIN7) |           \
                                     PIN_MODE_INPUT(GPIOD_PIN8) |           \
                                     PIN_MODE_INPUT(GPIOD_PIN9) |           \
                                     PIN_MODE_INPUT(GPIOD_PIN10) |          \
                                     PIN_MODE_INPUT(GPIOD_PIN11) |          \
                                     PIN_MODE_INPUT(GPIOD_PIN12) |          \
                                     PIN_MODE_INPUT(GPIOD_PIN13) |          \
                                     PIN_MODE_INPUT(GPIOD_PIN14) |          \
                                     PIN_MODE_INPUT(GPIOD_PIN15))
#define VAL_GPIOD_OTYPER            (PIN_OTYPE_PUSHPULL(GPIOD_PIN0) |       \
                                     PIN_OTYPE_PUSHPULL(GPIOD_PIN1) |       \
                                     PIN_OTYPE_PUSHPULL(GPIOD_PIN2) |       \
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
                                     PIN_ODR_HIGH(GPIOD_PIN9) |             \
                                     PIN_ODR_HIGH(GPIOD_PIN10) |            \
                                     PIN_ODR_HIGH(GPIOD_PIN11) |            \
                                     PIN_ODR_HIGH(GPIOD_PIN12) |              \
                                     PIN_ODR_HIGH(GPIOD_PIN13) |              \
                                     PIN_ODR_HIGH(GPIOD_PIN14) |              \
                                     PIN_ODR_HIGH(GPIOD_PIN15))
#define VAL_GPIOD_AFRL              (PIN_AFIO_AF(GPIOD_PIN0, 0) |           \
                                     PIN_AFIO_AF(GPIOD_PIN1, 0) |           \
                                     PIN_AFIO_AF(GPIOD_PIN2, 0) |           \
                                     PIN_AFIO_AF(GPIOD_PIN3, 0) |           \
                                     PIN_AFIO_AF(GPIOD_RESET, 0) |          \
                                     PIN_AFIO_AF(GPIOD_OVER_CURRENT, 0) |   \
                                     PIN_AFIO_AF(GPIOD_PIN6, 0) |           \
                                     PIN_AFIO_AF(GPIOD_PIN7, 0))
#define VAL_GPIOD_AFRH              (PIN_AFIO_AF(GPIOD_PIN8, 0) |           \
                                     PIN_AFIO_AF(GPIOD_PIN9, 0) |           \
                                     PIN_AFIO_AF(GPIOD_PIN10, 0) |          \
                                     PIN_AFIO_AF(GPIOD_PIN11, 0) |          \
                                     PIN_AFIO_AF(GPIOD_PIN12, 0) |           \
                                     PIN_AFIO_AF(GPIOD_PIN13, 0) |           \
                                     PIN_AFIO_AF(GPIOD_PIN14, 0) |           \
                                     PIN_AFIO_AF(GPIOD_PIN15, 0))

/*
 * GPIOE setup:
 */
#define VAL_GPIOE_MODER             (PIN_MODE_INPUT(GPIOE_INT1) |           \
                                     PIN_MODE_INPUT(GPIOE_INT2) |           \
                                     PIN_MODE_INPUT(GPIOE_PIN2) |           \
                                     PIN_MODE_INPUT(GPIOE_CS_SPI) |        \
                                     PIN_MODE_INPUT(GPIOE_PIN4) |           \
                                     PIN_MODE_INPUT(GPIOE_PIN5) |           \
                                     PIN_MODE_INPUT(GPIOE_PIN6) |           \
                                     PIN_MODE_INPUT(GPIOE_PIN7) |           \
                                     PIN_MODE_INPUT(GPIOE_PIN8) |           \
                                     PIN_MODE_INPUT(GPIOE_PIN9) |           \
                                     PIN_MODE_INPUT(GPIOE_PIN10) |          \
                                     PIN_MODE_INPUT(GPIOE_PIN11) |          \
                                     PIN_MODE_INPUT(GPIOE_PIN12) |          \
                                     PIN_MODE_INPUT(GPIOE_PIN13) |          \
                                     PIN_MODE_INPUT(GPIOE_PIN14) |          \
                                     PIN_MODE_INPUT(GPIOE_PIN15))
#define VAL_GPIOE_OTYPER            (PIN_OTYPE_PUSHPULL(GPIOE_INT1) |       \
                                     PIN_OTYPE_PUSHPULL(GPIOE_INT2) |       \
                                     PIN_OTYPE_PUSHPULL(GPIOE_PIN2) |       \
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
                                     PIN_ODR_HIGH(GPIOE_PIN9) |             \
                                     PIN_ODR_HIGH(GPIOE_PIN10) |            \
                                     PIN_ODR_HIGH(GPIOE_PIN11) |            \
                                     PIN_ODR_HIGH(GPIOE_PIN12) |            \
                                     PIN_ODR_HIGH(GPIOE_PIN13) |            \
                                     PIN_ODR_HIGH(GPIOE_PIN14) |            \
                                     PIN_ODR_HIGH(GPIOE_PIN15))
#define VAL_GPIOE_AFRL              (PIN_AFIO_AF(GPIOE_INT1, 0) |           \
                                     PIN_AFIO_AF(GPIOE_INT2, 0) |           \
                                     PIN_AFIO_AF(GPIOE_PIN2, 0) |           \
                                     PIN_AFIO_AF(GPIOE_CS_SPI, 0) |         \
                                     PIN_AFIO_AF(GPIOE_PIN4, 0) |           \
                                     PIN_AFIO_AF(GPIOE_PIN5, 0) |           \
                                     PIN_AFIO_AF(GPIOE_PIN6, 0) |           \
                                     PIN_AFIO_AF(GPIOE_PIN7, 0))
#define VAL_GPIOE_AFRH              (PIN_AFIO_AF(GPIOE_PIN8, 0) |           \
                                     PIN_AFIO_AF(GPIOE_PIN9, 0) |           \
                                     PIN_AFIO_AF(GPIOE_PIN10, 0) |          \
                                     PIN_AFIO_AF(GPIOE_PIN11, 0) |          \
                                     PIN_AFIO_AF(GPIOE_PIN12, 0) |          \
                                     PIN_AFIO_AF(GPIOE_PIN13, 0) |          \
                                     PIN_AFIO_AF(GPIOE_PIN14, 0) |          \
                                     PIN_AFIO_AF(GPIOE_PIN15, 0))

/*
 * GPIOF setup:
 */
#define VAL_GPIOF_MODER             (PIN_MODE_INPUT(GPIOF_PIN0) |           \
                                     PIN_MODE_INPUT(GPIOF_PIN1) |           \
                                     PIN_MODE_INPUT(GPIOF_PIN2) |           \
                                     PIN_MODE_INPUT(GPIOF_PIN3) |           \
                                     PIN_MODE_INPUT(GPIOF_PIN4) |           \
                                     PIN_MODE_INPUT(GPIOF_PIN5) |           \
                                     PIN_MODE_INPUT(GPIOF_PIN6) |           \
                                     PIN_MODE_INPUT(GPIOF_PIN7) |           \
                                     PIN_MODE_INPUT(GPIOF_PIN8) |           \
                                     PIN_MODE_INPUT(GPIOF_PIN9) |           \
                                     PIN_MODE_INPUT(GPIOF_PIN10) |          \
                                     PIN_MODE_INPUT(GPIOF_PIN11) |          \
                                     PIN_MODE_INPUT(GPIOF_PIN12) |          \
                                     PIN_MODE_INPUT(GPIOF_PIN13) |          \
                                     PIN_MODE_INPUT(GPIOF_PIN14) |          \
                                     PIN_MODE_INPUT(GPIOF_PIN15))
#define VAL_GPIOF_OTYPER            (PIN_OTYPE_PUSHPULL(GPIOF_PIN0) |       \
                                     PIN_OTYPE_PUSHPULL(GPIOF_PIN1) |       \
                                     PIN_OTYPE_PUSHPULL(GPIOF_PIN2) |       \
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
                                     PIN_ODR_HIGH(GPIOF_PIN9) |             \
                                     PIN_ODR_HIGH(GPIOF_PIN10) |            \
                                     PIN_ODR_HIGH(GPIOF_PIN11) |            \
                                     PIN_ODR_HIGH(GPIOF_PIN12) |            \
                                     PIN_ODR_HIGH(GPIOF_PIN13) |            \
                                     PIN_ODR_HIGH(GPIOF_PIN14) |            \
                                     PIN_ODR_HIGH(GPIOF_PIN15))
#define VAL_GPIOF_AFRL              (PIN_AFIO_AF(GPIOF_PIN0, 0) |           \
                                     PIN_AFIO_AF(GPIOF_PIN1, 0) |           \
                                     PIN_AFIO_AF(GPIOF_PIN2, 0) |           \
                                     PIN_AFIO_AF(GPIOF_PIN3, 0) |           \
                                     PIN_AFIO_AF(GPIOF_PIN4, 0) |           \
                                     PIN_AFIO_AF(GPIOF_PIN5, 0) |           \
                                     PIN_AFIO_AF(GPIOF_PIN6, 0) |           \
                                     PIN_AFIO_AF(GPIOF_PIN7, 0))
#define VAL_GPIOF_AFRH              (PIN_AFIO_AF(GPIOF_PIN8, 0) |           \
                                     PIN_AFIO_AF(GPIOF_PIN9, 0) |           \
                                     PIN_AFIO_AF(GPIOF_PIN10, 0) |          \
                                     PIN_AFIO_AF(GPIOF_PIN11, 0) |          \
                                     PIN_AFIO_AF(GPIOF_PIN12, 0) |          \
                                     PIN_AFIO_AF(GPIOF_PIN13, 0) |          \
                                     PIN_AFIO_AF(GPIOF_PIN14, 0) |          \
                                     PIN_AFIO_AF(GPIOF_PIN15, 0))

/*
 * GPIOG setup:
 */
#define VAL_GPIOG_MODER             (PIN_MODE_INPUT(GPIOG_PIN0) |           \
                                     PIN_MODE_INPUT(GPIOG_PIN1) |           \
                                     PIN_MODE_INPUT(GPIOG_PIN2) |           \
                                     PIN_MODE_INPUT(GPIOG_PIN3) |           \
                                     PIN_MODE_INPUT(GPIOG_PIN4) |           \
                                     PIN_MODE_INPUT(GPIOG_PIN5) |           \
                                     PIN_MODE_INPUT(GPIOG_PIN6) |           \
                                     PIN_MODE_INPUT(GPIOG_PIN7) |           \
                                     PIN_MODE_INPUT(GPIOG_PIN8) |           \
                                     PIN_MODE_INPUT(GPIOG_PIN9) |           \
                                     PIN_MODE_INPUT(GPIOG_PIN10) |          \
                                     PIN_MODE_INPUT(GPIOG_PIN11) |          \
                                     PIN_MODE_INPUT(GPIOG_PIN12) |          \
                                     PIN_MODE_INPUT(GPIOG_PIN13) |          \
                                     PIN_MODE_INPUT(GPIOG_PIN14) |          \
                                     PIN_MODE_INPUT(GPIOG_PIN15))
#define VAL_GPIOG_OTYPER            (PIN_OTYPE_PUSHPULL(GPIOG_PIN0) |       \
                                     PIN_OTYPE_PUSHPULL(GPIOG_PIN1) |       \
                                     PIN_OTYPE_PUSHPULL(GPIOG_PIN2) |       \
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
                                     PIN_ODR_HIGH(GPIOG_PIN9) |             \
                                     PIN_ODR_HIGH(GPIOG_PIN10) |            \
                                     PIN_ODR_HIGH(GPIOG_PIN11) |            \
                                     PIN_ODR_HIGH(GPIOG_PIN12) |            \
                                     PIN_ODR_HIGH(GPIOG_PIN13) |            \
                                     PIN_ODR_HIGH(GPIOG_PIN14) |            \
                                     PIN_ODR_HIGH(GPIOG_PIN15))
#define VAL_GPIOG_AFRL              (PIN_AFIO_AF(GPIOG_PIN0, 0) |           \
                                     PIN_AFIO_AF(GPIOG_PIN1, 0) |           \
                                     PIN_AFIO_AF(GPIOG_PIN2, 0) |           \
                                     PIN_AFIO_AF(GPIOG_PIN3, 0) |           \
                                     PIN_AFIO_AF(GPIOG_PIN4, 0) |           \
                                     PIN_AFIO_AF(GPIOG_PIN5, 0) |           \
                                     PIN_AFIO_AF(GPIOG_PIN6, 0) |           \
                                     PIN_AFIO_AF(GPIOG_PIN7, 0))
#define VAL_GPIOG_AFRH              (PIN_AFIO_AF(GPIOG_PIN8, 0) |           \
                                     PIN_AFIO_AF(GPIOG_PIN9, 0) |           \
                                     PIN_AFIO_AF(GPIOG_PIN10, 0) |          \
                                     PIN_AFIO_AF(GPIOG_PIN11, 0) |          \
                                     PIN_AFIO_AF(GPIOG_PIN12, 0) |          \
                                     PIN_AFIO_AF(GPIOG_PIN13, 0) |          \
                                     PIN_AFIO_AF(GPIOG_PIN14, 0) |          \
                                     PIN_AFIO_AF(GPIOG_PIN15, 0))

/*
 * GPIOH setup:
 */
#define VAL_GPIOH_MODER             (PIN_MODE_INPUT(GPIOH_OSC_IN) |         \
                                     PIN_MODE_INPUT(GPIOH_OSC_OUT) |        \
                                     PIN_MODE_INPUT(GPIOH_PIN2) |           \
                                     PIN_MODE_INPUT(GPIOH_PIN3) |           \
                                     PIN_MODE_INPUT(GPIOH_PIN4) |           \
                                     PIN_MODE_INPUT(GPIOH_PIN5) |           \
                                     PIN_MODE_INPUT(GPIOH_PIN6) |           \
                                     PIN_MODE_INPUT(GPIOH_PIN7) |           \
                                     PIN_MODE_INPUT(GPIOH_PIN8) |           \
                                     PIN_MODE_INPUT(GPIOH_PIN9) |           \
                                     PIN_MODE_INPUT(GPIOH_PIN10) |          \
                                     PIN_MODE_INPUT(GPIOH_PIN11) |          \
                                     PIN_MODE_INPUT(GPIOH_PIN12) |          \
                                     PIN_MODE_INPUT(GPIOH_PIN13) |          \
                                     PIN_MODE_INPUT(GPIOH_PIN14) |          \
                                     PIN_MODE_INPUT(GPIOH_PIN15))
#define VAL_GPIOH_OTYPER            (PIN_OTYPE_PUSHPULL(GPIOH_OSC_IN) |     \
                                     PIN_OTYPE_PUSHPULL(GPIOH_OSC_OUT) |    \
                                     PIN_OTYPE_PUSHPULL(GPIOH_PIN2) |       \
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
                                     PIN_ODR_HIGH(GPIOH_PIN9) |             \
                                     PIN_ODR_HIGH(GPIOH_PIN10) |            \
                                     PIN_ODR_HIGH(GPIOH_PIN11) |            \
                                     PIN_ODR_HIGH(GPIOH_PIN12) |            \
                                     PIN_ODR_HIGH(GPIOH_PIN13) |            \
                                     PIN_ODR_HIGH(GPIOH_PIN14) |            \
                                     PIN_ODR_HIGH(GPIOH_PIN15))
#define VAL_GPIOH_AFRL              (PIN_AFIO_AF(GPIOH_OSC_IN, 0) |         \
                                     PIN_AFIO_AF(GPIOH_OSC_OUT, 0) |        \
                                     PIN_AFIO_AF(GPIOH_PIN2, 0) |           \
                                     PIN_AFIO_AF(GPIOH_PIN3, 0) |           \
                                     PIN_AFIO_AF(GPIOH_PIN4, 0) |           \
                                     PIN_AFIO_AF(GPIOH_PIN5, 0) |           \
                                     PIN_AFIO_AF(GPIOH_PIN6, 0) |           \
                                     PIN_AFIO_AF(GPIOH_PIN7, 0))
#define VAL_GPIOH_AFRH              (PIN_AFIO_AF(GPIOH_PIN8, 0) |           \
                                     PIN_AFIO_AF(GPIOH_PIN9, 0) |           \
                                     PIN_AFIO_AF(GPIOH_PIN10, 0) |          \
                                     PIN_AFIO_AF(GPIOH_PIN11, 0) |          \
                                     PIN_AFIO_AF(GPIOH_PIN12, 0) |          \
                                     PIN_AFIO_AF(GPIOH_PIN13, 0) |          \
                                     PIN_AFIO_AF(GPIOH_PIN14, 0) |          \
                                     PIN_AFIO_AF(GPIOH_PIN15, 0))

/*
 * GPIOI setup:
 */
#define VAL_GPIOI_MODER             (PIN_MODE_INPUT(GPIOI_PIN0) |           \
                                     PIN_MODE_INPUT(GPIOI_PIN1) |           \
                                     PIN_MODE_INPUT(GPIOI_PIN2) |           \
                                     PIN_MODE_INPUT(GPIOI_PIN3) |           \
                                     PIN_MODE_INPUT(GPIOI_PIN4) |           \
                                     PIN_MODE_INPUT(GPIOI_PIN5) |           \
                                     PIN_MODE_INPUT(GPIOI_PIN6) |           \
                                     PIN_MODE_INPUT(GPIOI_PIN7) |           \
                                     PIN_MODE_INPUT(GPIOI_PIN8) |           \
                                     PIN_MODE_INPUT(GPIOI_PIN9) |           \
                                     PIN_MODE_INPUT(GPIOI_PIN10) |          \
                                     PIN_MODE_INPUT(GPIOI_PIN11) |          \
                                     PIN_MODE_INPUT(GPIOI_PIN12) |          \
                                     PIN_MODE_INPUT(GPIOI_PIN13) |          \
                                     PIN_MODE_INPUT(GPIOI_PIN14) |          \
                                     PIN_MODE_INPUT(GPIOI_PIN15))
#define VAL_GPIOI_OTYPER            (PIN_OTYPE_PUSHPULL(GPIOI_PIN0) |       \
                                     PIN_OTYPE_PUSHPULL(GPIOI_PIN1) |       \
                                     PIN_OTYPE_PUSHPULL(GPIOI_PIN2) |       \
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
                                     PIN_ODR_HIGH(GPIOI_PIN9) |             \
                                     PIN_ODR_HIGH(GPIOI_PIN10) |            \
                                     PIN_ODR_HIGH(GPIOI_PIN11) |            \
                                     PIN_ODR_HIGH(GPIOI_PIN12) |            \
                                     PIN_ODR_HIGH(GPIOI_PIN13) |            \
                                     PIN_ODR_HIGH(GPIOI_PIN14) |            \
                                     PIN_ODR_HIGH(GPIOI_PIN15))
#define VAL_GPIOI_AFRL              (PIN_AFIO_AF(GPIOI_PIN0, 0) |           \
                                     PIN_AFIO_AF(GPIOI_PIN1, 0) |           \
                                     PIN_AFIO_AF(GPIOI_PIN2, 0) |           \
                                     PIN_AFIO_AF(GPIOI_PIN3, 0) |           \
                                     PIN_AFIO_AF(GPIOI_PIN4, 0) |           \
                                     PIN_AFIO_AF(GPIOI_PIN5, 0) |           \
                                     PIN_AFIO_AF(GPIOI_PIN6, 0) |           \
                                     PIN_AFIO_AF(GPIOI_PIN7, 0))
#define VAL_GPIOI_AFRH              (PIN_AFIO_AF(GPIOI_PIN8, 0) |           \
                                     PIN_AFIO_AF(GPIOI_PIN9, 0) |           \
                                     PIN_AFIO_AF(GPIOI_PIN10, 0) |          \
                                     PIN_AFIO_AF(GPIOI_PIN11, 0) |          \
                                     PIN_AFIO_AF(GPIOI_PIN12, 0) |          \
                                     PIN_AFIO_AF(GPIOI_PIN13, 0) |          \
                                     PIN_AFIO_AF(GPIOI_PIN14, 0) |          \
                                     PIN_AFIO_AF(GPIOI_PIN15, 0))


#if !defined(_FROM_ASM_)
#ifdef __cplusplus
extern "C" {
#endif
  void boardInit(void);
#ifdef __cplusplus
}
#endif
#endif /* _FROM_ASM_ */

#endif /* _BOARD_H_ */
