designmaster0928/VESC_MotorController/REFER/Basic/bldc-master/bldc-master/ChibiOS_3.0.5/os/common/ports/e200/devices/SPC560BCxx/ppcparams.h

/*
    ChibiOS - Copyright (C) 2006..2015 Giovanni Di Sirio.

    This file is part of ChibiOS.

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
    You should have received a copy of the GNU General Public License
    along with this program.  If not, see <http://www.gnu.org/licenses/>.
*/

/**
 * @file    SPC560BCxx/ppcparams.h
 * @brief   PowerPC parameters for the SPC560BCxx.
 *
 * @defgroup PPC_SPC560BCxx SPC560BCxx Specific Parameters
 * @ingroup PPC_SPECIFIC
 * @details This file contains the PowerPC specific parameters for the
 *          SPC560BCxx platform.
 * @{
 */

#ifndef _PPCPARAMS_H_
#define _PPCPARAMS_H_

/**
 * @brief   Family identification macro.
 */
#define PPC_SPC560BCxx

/**
 * @brief   PPC core model.
 */
#define PPC_VARIANT                 PPC_VARIANT_e200z0

/**
 * @brief   Number of cores.
 */
#define PPC_CORE_NUMBER             1

/**
 * @brief   Number of writable bits in IVPR register.
 */
#define PPC_IVPR_BITS               20

/**
 * @brief   IVORx registers support.
 */
#define PPC_SUPPORTS_IVORS          FALSE

/**
 * @brief   Book E instruction set support.
 */
#define PPC_SUPPORTS_BOOKE          FALSE

/**
 * @brief   VLE instruction set support.
 */
#define PPC_SUPPORTS_VLE            TRUE

/**
 * @brief   Supports VLS Load/Store Multiple Volatile instructions.
 */
#define PPC_SUPPORTS_VLE_MULTI      TRUE

/**
 * @brief   Supports the decrementer timer.
 */
#define PPC_SUPPORTS_DECREMENTER    FALSE

/**
 * @brief   Number of interrupt sources.
 */
#define PPC_NUM_VECTORS             217

#endif /* _PPCPARAMS_H_ */

/** @} */
