designmaster0928/VESC_MotorController/REFER/Basic/bldc-master/bldc-master/hwconf/makerx/hw_go_foc_dv6_pro.c

/*
	Copyright 2012-2020 Benjamin Vedder	benjamin@vedder.se

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
    You should have received a copy of the GNU General Public License
    along with this program.  If not, see <http://www.gnu.org/licenses/>.
    */

#include "hw.h"

#include "ch.h"
#include "hal.h"
#include "stm32f4xx_conf.h"
#include "utils.h"
#include "drv8301.h"
#include "terminal.h"
#include "commands.h"
#include "mc_interface.h"

// Variables
static volatile bool i2c_running = false;
#if defined(HW60_IS_MK3) || defined(HW60_IS_MK4) || defined(HW60_IS_MK5)
static mutex_t shutdown_mutex;
static float bt_diff = 0.0;
#endif

// I2C configuration
static const I2CConfig i2cfg = {
		OPMODE_I2C,
		100000,
		STD_DUTY_CYCLE
};

#if defined(HW60_IS_MK3) || defined(HW60_IS_MK4) || defined(HW60_IS_MK5)
static void terminal_shutdown_now(int argc, const char **argv);
static void terminal_button_test(int argc, const char **argv);
#endif

void hw_init_gpio(void) {
#if defined(HW60_IS_MK3) || defined(HW60_IS_MK4) || defined(HW60_IS_MK5)
	chMtxObjectInit(&shutdown_mutex);
#endif

	// GPIO clock enable
	RCC_AHB1PeriphClockCmd(RCC_AHB1Periph_GPIOA, ENABLE);
	RCC_AHB1PeriphClockCmd(RCC_AHB1Periph_GPIOB, ENABLE);
	RCC_AHB1PeriphClockCmd(RCC_AHB1Periph_GPIOC, ENABLE);
	RCC_AHB1PeriphClockCmd(RCC_AHB1Periph_GPIOD, ENABLE);

	// LEDs
	palSetPadMode(GPIOB, 0,
			PAL_MODE_OUTPUT_PUSHPULL |
			PAL_STM32_OSPEED_HIGHEST);
	palSetPadMode(GPIOB, 1,
			PAL_MODE_OUTPUT_PUSHPULL |
			PAL_STM32_OSPEED_HIGHEST);

	// ENABLE_GATE
#ifdef HW60_VEDDER_FIRST_PCB
	palSetPadMode(GPIOB, 6,
			PAL_MODE_OUTPUT_PUSHPULL |
			PAL_STM32_OSPEED_HIGHEST);
#else
	palSetPadMode(GPIOB, 5,
			PAL_MODE_OUTPUT_PUSHPULL |
			PAL_STM32_OSPEED_HIGHEST);
#endif

	ENABLE_GATE();

	// Current filter
	palSetPadMode(GPIOD, 2,
			PAL_MODE_OUTPUT_PUSHPULL |
			PAL_STM32_OSPEED_HIGHEST);

	CURRENT_FILTER_OFF();

	// GPIOA Configuration: Channel 1 to 3 as alternate function push-pull
	palSetPadMode(GPIOA, 8, PAL_MODE_ALTERNATE(GPIO_AF_TIM1) |
			PAL_STM32_OSPEED_HIGHEST |
			PAL_STM32_PUDR_FLOATING);
	palSetPadMode(GPIOA, 9, PAL_MODE_ALTERNATE(GPIO_AF_TIM1) |
			PAL_STM32_OSPEED_HIGHEST |
			PAL_STM32_PUDR_FLOATING);
	palSetPadMode(GPIOA, 10, PAL_MODE_ALTERNATE(GPIO_AF_TIM1) |
			PAL_STM32_OSPEED_HIGHEST |
			PAL_STM32_PUDR_FLOATING);

	palSetPadMode(GPIOB, 13, PAL_MODE_ALTERNATE(GPIO_AF_TIM1) |
			PAL_STM32_OSPEED_HIGHEST |
			PAL_STM32_PUDR_FLOATING);
	palSetPadMode(GPIOB, 14, PAL_MODE_ALTERNATE(GPIO_AF_TIM1) |
			PAL_STM32_OSPEED_HIGHEST |
			PAL_STM32_PUDR_FLOATING);
	palSetPadMode(GPIOB, 15, PAL_MODE_ALTERNATE(GPIO_AF_TIM1) |
			PAL_STM32_OSPEED_HIGHEST |
			PAL_STM32_PUDR_FLOATING);

	// Hall sensors
	palSetPadMode(HW_HALL_ENC_GPIO1, HW_HALL_ENC_PIN1, PAL_MODE_INPUT_PULLUP);
	palSetPadMode(HW_HALL_ENC_GPIO2, HW_HALL_ENC_PIN2, PAL_MODE_INPUT_PULLUP);
	palSetPadMode(HW_HALL_ENC_GPIO3, HW_HALL_ENC_PIN3, PAL_MODE_INPUT_PULLUP);

	// Phase filters
#ifdef PHASE_FILTER_GPIO
	palSetPadMode(PHASE_FILTER_GPIO, PHASE_FILTER_PIN,
			PAL_MODE_OUTPUT_PUSHPULL |
			PAL_STM32_OSPEED_HIGHEST);
	PHASE_FILTER_OFF();
#endif

	// Fault pin
	palSetPadMode(GPIOB, 7, PAL_MODE_INPUT_PULLUP);

	// ADC Pins
	palSetPadMode(GPIOA, 0, PAL_MODE_INPUT_ANALOG);
	palSetPadMode(GPIOA, 1, PAL_MODE_INPUT_ANALOG);
	palSetPadMode(GPIOA, 2, PAL_MODE_INPUT_ANALOG);
	palSetPadMode(GPIOA, 3, PAL_MODE_INPUT_ANALOG);
	palSetPadMode(GPIOA, 5, PAL_MODE_INPUT_ANALOG);
	palSetPadMode(GPIOA, 6, PAL_MODE_INPUT_ANALOG);

	palSetPadMode(GPIOC, 0, PAL_MODE_INPUT_ANALOG);
	palSetPadMode(GPIOC, 1, PAL_MODE_INPUT_ANALOG);
	palSetPadMode(GPIOC, 2, PAL_MODE_INPUT_ANALOG);
	palSetPadMode(GPIOC, 3, PAL_MODE_INPUT_ANALOG);
	palSetPadMode(GPIOC, 4, PAL_MODE_INPUT_ANALOG);
#if !defined(HW60_IS_MK3) && !defined(HW60_IS_MK4) && !defined(HW60_IS_MK5)
	palSetPadMode(GPIOC, 5, PAL_MODE_INPUT_ANALOG);
#endif

	drv8301_init();

#if defined(HW60_IS_MK3) || defined(HW60_IS_MK4) || defined(HW60_IS_MK5)
	terminal_register_command_callback(
		"shutdown",
		"Shutdown VESC now.",
		0,
		terminal_shutdown_now);

	terminal_register_command_callback(
		"test_button",
		"Try sampling the shutdown button",
		0,
		terminal_button_test);
#endif
}

void hw_setup_adc_channels(void) {
	// ADC1 regular channels
	ADC_RegularChannelConfig(ADC1, ADC_Channel_0, 1, ADC_SampleTime_15Cycles);
	ADC_RegularChannelConfig(ADC1, ADC_Channel_10, 2, ADC_SampleTime_15Cycles);
	ADC_RegularChannelConfig(ADC1, ADC_Channel_5, 3, ADC_SampleTime_15Cycles);
	ADC_RegularChannelConfig(ADC1, ADC_Channel_14, 4, ADC_SampleTime_15Cycles);
	ADC_RegularChannelConfig(ADC1, ADC_Channel_Vrefint, 5, ADC_SampleTime_15Cycles);

	// ADC2 regular channels
	ADC_RegularChannelConfig(ADC2, ADC_Channel_1, 1, ADC_SampleTime_15Cycles);
	ADC_RegularChannelConfig(ADC2, ADC_Channel_11, 2, ADC_SampleTime_15Cycles);
	ADC_RegularChannelConfig(ADC2, ADC_Channel_6, 3, ADC_SampleTime_15Cycles);
	ADC_RegularChannelConfig(ADC2, ADC_Channel_15, 4, ADC_SampleTime_15Cycles);
	ADC_RegularChannelConfig(ADC2, ADC_Channel_0, 5, ADC_SampleTime_15Cycles);

	// ADC3 regular channels
	ADC_RegularChannelConfig(ADC3, ADC_Channel_2, 1, ADC_SampleTime_15Cycles);
	ADC_RegularChannelConfig(ADC3, ADC_Channel_12, 2, ADC_SampleTime_15Cycles);
	ADC_RegularChannelConfig(ADC3, ADC_Channel_3, 3, ADC_SampleTime_15Cycles);
	ADC_RegularChannelConfig(ADC3, ADC_Channel_13, 4, ADC_SampleTime_15Cycles);
	ADC_RegularChannelConfig(ADC3, ADC_Channel_1, 5, ADC_SampleTime_15Cycles);

	// Injected channels
	ADC_InjectedChannelConfig(ADC1, ADC_Channel_10, 1, ADC_SampleTime_15Cycles);
	ADC_InjectedChannelConfig(ADC2, ADC_Channel_11, 1, ADC_SampleTime_15Cycles);
	ADC_InjectedChannelConfig(ADC3, ADC_Channel_12, 1, ADC_SampleTime_15Cycles);
	ADC_InjectedChannelConfig(ADC1, ADC_Channel_10, 2, ADC_SampleTime_15Cycles);
	ADC_InjectedChannelConfig(ADC2, ADC_Channel_11, 2, ADC_SampleTime_15Cycles);
	ADC_InjectedChannelConfig(ADC3, ADC_Channel_12, 2, ADC_SampleTime_15Cycles);
	ADC_InjectedChannelConfig(ADC1, ADC_Channel_10, 3, ADC_SampleTime_15Cycles);
	ADC_InjectedChannelConfig(ADC2, ADC_Channel_11, 3, ADC_SampleTime_15Cycles);
	ADC_InjectedChannelConfig(ADC3, ADC_Channel_12, 3, ADC_SampleTime_15Cycles);
}

void hw_start_i2c(void) {
	i2cAcquireBus(&HW_I2C_DEV);

	if (!i2c_running) {
		palSetPadMode(HW_I2C_SCL_PORT, HW_I2C_SCL_PIN,
				PAL_MODE_ALTERNATE(HW_I2C_GPIO_AF) |
				PAL_STM32_OTYPE_OPENDRAIN |
				PAL_STM32_OSPEED_MID1 |
				PAL_STM32_PUDR_PULLUP);
		palSetPadMode(HW_I2C_SDA_PORT, HW_I2C_SDA_PIN,
				PAL_MODE_ALTERNATE(HW_I2C_GPIO_AF) |
				PAL_STM32_OTYPE_OPENDRAIN |
				PAL_STM32_OSPEED_MID1 |
				PAL_STM32_PUDR_PULLUP);

		i2cStart(&HW_I2C_DEV, &i2cfg);
		i2c_running = true;
	}

	i2cReleaseBus(&HW_I2C_DEV);
}

void hw_stop_i2c(void) {
	i2cAcquireBus(&HW_I2C_DEV);

	if (i2c_running) {
		palSetPadMode(HW_I2C_SCL_PORT, HW_I2C_SCL_PIN, PAL_MODE_INPUT);
		palSetPadMode(HW_I2C_SDA_PORT, HW_I2C_SDA_PIN, PAL_MODE_INPUT);

		i2cStop(&HW_I2C_DEV);
		i2c_running = false;

	}

	i2cReleaseBus(&HW_I2C_DEV);
}

/**
 * Try to restore the i2c bus
 */
void hw_try_restore_i2c(void) {
	if (i2c_running) {
		i2cAcquireBus(&HW_I2C_DEV);

		palSetPadMode(HW_I2C_SCL_PORT, HW_I2C_SCL_PIN,
				PAL_STM32_OTYPE_OPENDRAIN |
				PAL_STM32_OSPEED_MID1 |
				PAL_STM32_PUDR_PULLUP);

		palSetPadMode(HW_I2C_SDA_PORT, HW_I2C_SDA_PIN,
				PAL_STM32_OTYPE_OPENDRAIN |
				PAL_STM32_OSPEED_MID1 |
				PAL_STM32_PUDR_PULLUP);

		palSetPad(HW_I2C_SCL_PORT, HW_I2C_SCL_PIN);
		palSetPad(HW_I2C_SDA_PORT, HW_I2C_SDA_PIN);

		chThdSleep(1);

		for(int i = 0;i < 16;i++) {
			palClearPad(HW_I2C_SCL_PORT, HW_I2C_SCL_PIN);
			chThdSleep(1);
			palSetPad(HW_I2C_SCL_PORT, HW_I2C_SCL_PIN);
			chThdSleep(1);
		}

		// Generate start then stop condition
		palClearPad(HW_I2C_SDA_PORT, HW_I2C_SDA_PIN);
		chThdSleep(1);
		palClearPad(HW_I2C_SCL_PORT, HW_I2C_SCL_PIN);
		chThdSleep(1);
		palSetPad(HW_I2C_SCL_PORT, HW_I2C_SCL_PIN);
		chThdSleep(1);
		palSetPad(HW_I2C_SDA_PORT, HW_I2C_SDA_PIN);

		palSetPadMode(HW_I2C_SCL_PORT, HW_I2C_SCL_PIN,
				PAL_MODE_ALTERNATE(HW_I2C_GPIO_AF) |
				PAL_STM32_OTYPE_OPENDRAIN |
				PAL_STM32_OSPEED_MID1 |
				PAL_STM32_PUDR_PULLUP);

		palSetPadMode(HW_I2C_SDA_PORT, HW_I2C_SDA_PIN,
				PAL_MODE_ALTERNATE(HW_I2C_GPIO_AF) |
				PAL_STM32_OTYPE_OPENDRAIN |
				PAL_STM32_OSPEED_MID1 |
				PAL_STM32_PUDR_PULLUP);

		HW_I2C_DEV.state = I2C_STOP;
		i2cStart(&HW_I2C_DEV, &i2cfg);

		i2cReleaseBus(&HW_I2C_DEV);
	}
}

#if defined(HW60_IS_MK3) || defined(HW60_IS_MK4) || defined(HW60_IS_MK5)
bool hw_sample_shutdown_button(void) {
	chMtxLock(&shutdown_mutex);

	bt_diff = 0.0;

	for (int i = 0;i < 3;i++) {
		palSetPadMode(HW_SHUTDOWN_GPIO, HW_SHUTDOWN_PIN, PAL_MODE_INPUT_ANALOG);
		chThdSleep(5);
		float val1 = ADC_VOLTS(ADC_IND_SHUTDOWN);
		chThdSleepMilliseconds(1);
		float val2 = ADC_VOLTS(ADC_IND_SHUTDOWN);
		palSetPadMode(HW_SHUTDOWN_GPIO, HW_SHUTDOWN_PIN, PAL_MODE_OUTPUT_PUSHPULL);
		chThdSleepMilliseconds(1);

		bt_diff += (val1 - val2);
	}

	chMtxUnlock(&shutdown_mutex);

	return (bt_diff > 0.12);
}

static void terminal_shutdown_now(int argc, const char **argv) {
	(void)argc;
	(void)argv;
	DISABLE_GATE();
	HW_SHUTDOWN_HOLD_OFF();
}

static void terminal_button_test(int argc, const char **argv) {
	(void)argc;
	(void)argv;

	for (int i = 0;i < 40;i++) {
		commands_printf("BT: %d %.2f", HW_SAMPLE_SHUTDOWN(), (double)bt_diff);
		chThdSleepMilliseconds(100);
	}
}
#endif
