designmaster0928/VESC_MotorController/(commit log)

2023-08-03 first step
    [BLDC4.12_BOM.ods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]
2023-08-04 third step
    [Controler.SchDoc, PowerBoard.SchDoc]
2023-08-04 fourth step
    [Controller.PcbDoc, Controller.SchDoc, Humidity Regulator.SchDoc, MainBoard.SchDoc, PowerBoard.PcbDoc, PowerBoard.SchDoc, VESC_MotorController.PrjPcb, VESC_MotorController.SCHLIB]
