designmaster0928/VESC_MotorController/(notices)

Notices in the files:
REFER/Basic/bldc-master/bldc-master/hwconf/makerx/hw_go_foc_dv6_pro.c:
This program is free software: you can redistribute it and/or modify
it under the terms of the GNU General Public License as published by
the Free Software Foundation, either version 3 of the License, or
(at your option) any later version.
